sequoia-hope/studio-amp/design/decisions.md

# Decisions

Every non-obvious decision, logged as it is made. Newest at the bottom.

| Date | Decision | Why | Alternatives considered |
|---|---|---|---|
| 2026-11-07 | Variant A = integrated PoE PD chip + isolated active-clamp forward + 48 V amp rail + GW1N-9 + all GaN | User's choice; the variant to focus on. ACF is the spec's preferred topology for ~70 W efficiency; 48 V gives ≈144 W peak BTL into 8 Ω, over the >100 W target | Flyback; 36/42 V rails; iCE40 HX8K; discrete PD (later variant) |
| 2026-11-07 | One board, full satellite spec (not core-only, not split) | User: "one board for now, studio monitor version, not sub" | Core-first subset; separate power and compute boards |
| 2026-11-07 | Headphone/line DAC = FPGA 1-bit stream, reclocked on a quiet rail, discrete filter | User chose; matches the discrete-first rule and the UcD-variant signal chain | I2S DAC chip; both as variants |
| 2026-11-07 | Open source, public repo sequoia-hope/studio-amp, MIT | User chose "public repo now" | Local only |
| 2026-11-07 | JLCPCB, 5 prototypes, 2-sided assembly, ≥4 layers, cost secondary | User chose | 1-sided cost-aware build |
| 2026-11-07 | Project converted in place to a Boardroom board repo (template, vendored skill, pcbview 26ba32b and ultraroute b38a039 pinned as in boardroom 66be834) | new-board.sh refuses a non-empty dir, and the folder already held the proj registration (serve.sh, launch.sh, git history); did the same steps by hand. launch.sh stays tracked | Make a fresh repo and copy the spec over |
| 2026-11-07 | Gate driver LMG1210RVRR (C2677136) instead of uP1966 | uP1966E has 0 stock on every LCSC listing; LMG1210 is an in-stock half-bridge GaN driver; user chose it | LMG1205 (BGA, 485 stock); sourcing uP1966 elsewhere |
| 2026-11-07 | Variant A audio targets relaxed for open-loop PWM + feedforward (R-51), with an optional post-filter sense path | Phase 0 review M3: studio-monitor THD/noise not reachable open-loop; user accepted | Closed-loop feedback in variant A |
| 2026-11-07 | Full performance specified at Class 6; Class 8 used as headroom; LEDs 5 W, firmware-limited per class | Phase 0 review B1/M6: budget didn't close; Type 4 PSEs are rare | Class 8 baseline with 10 W LEDs |
| 2026-11-07 | Display header: 8-pin (ST7735S 0.96 in 80×160 IPS TFT), not the spec's 7-pin OLED | User named the module; these carry a BLK backlight pin. All signal pins on FPGA I/O and GND/VCC on solder jumpers, so a module with a different pin order still works | 7-pin SSD1331/SSD1351 OLED header |
| 2026-11-07 | Architecture: RP2350B; FPGA bitstreams held in the RP2350 flash and loaded over SSPI; PHY RMII to the FPGA MAC; one digital isolator for PD status; silicon MOSFETs in the converter, GaN only in the audio stage | See design/architecture.md, 'Architecture decisions' | RP2350A; separate FPGA config flash; RMII to the RP2350 |
| 2026-11-07 | FPGA: Lattice ECP5 LFE5U-25F-7BG256I (C1550762, 1125 stock) replaces GW1NR-LV9QN88 | Block E found the QN88P package doesn't bond out the SSPI/CPU config pins, so the Gowin could only be loaded over JTAG with a golden image in its internal flash and an extra 1V8 rail. User: wants everything flashed from the RP2350, FPGA choice otherwise open. ECP5 loads by slave SPI from the RP2350 (A/B bitstreams in its QSPI flash), has the most mature open toolchain (Trellis/nextpnr), 24k LUTs, and 9× the stock. Cost: CABGA-256 | GW1NR-9 loaded over JTAG by the RP2350 (also debugger-free); iCE40UP5K (too slow/small for fine PWM edges); GW5A (immature open support) |
| 2026-11-07 | 6.35 mm headphone jack rated only to +70 °C accepted (waiver of R-40's 85 °C) | No stocked 6.35 mm jack is rated higher; worst-case cabinet air is 55 °C. User accepted | 3.5 mm jack; out-of-LCSC part |
| 2026-11-07 | Headphone and line out share the two DAC streams (mono sum and volume apply to both) | User accepted for variant A | 2 more DAC channels |
| 2026-11-07 | Defaults taken where the user deferred ("I forget the rest"): magjack's internal Bob Smith cap accepted across the uncertified hipot; LPJK6078AHNL kept at 4 % current margin at the Class 8 corner (full performance is specified at Class 6); 4-tap FIR 1-bit DAC | Each was the auditing agent's recommendation; all are reversible before phase 2 | LP6090ANL discrete magnetics; single-flip-flop DAC |
| 2026-11-07 | Transformer: Würth 750343576 rewired 1:2 (N1‖N2 : N3+N4), 400 kHz, bought outside LCSC and hand-soldered; a custom Würth Midcom 8T:16T part on the same core to be quoted in parallel | Nothing on LCSC fits a ~70 W 48 V forward; this part is proven in TI PMP20878 with the same TPS2373-4 + UCC2897A pair. User chose option A + B (B-transformer.md) | Two transformers in parallel; hand-wound on an LCSC core; active-clamp flyback with 750321159 |
| 2026-11-07 | R-33's 92 % efficiency becomes "verify at bring-up"; 91 % accepted if measured | Würth publishes no core-loss data; the estimate is 90.5–93.3 %. User accepted | Treat 92 % as hard and go custom now |
| 2026-11-07 | GaN: Infineon IGC033S10S1 (985 stock), not Innoscience INN100 nor IGB070S10S1 | Block D: several Innoscience listings have no lifecycle or datasheet on LCSC; IGB070S10S1 has the lowest idle loss (~2 W) but only 80 in stock against 44 needed. User chose stock depth over ~3 W extra idle loss | IGB070S10S1 bought early; Innoscience |
| 2026-11-07 | 6-layer board | ECP5 CABGA-256 0.8 mm escapes without via-in-pad (no recurring via charge); solid planes by the GaN stage and the Ethernet/clocks. User approved | 4 layers + via-in-pad |
| 2026-11-07 | PWM edge grid 1.453 ns (ECP5 -7, ODDRX2) accepted; R-53 amended | The -8 grade (1.25 ns) has 5 in stock. The noise shaper makes up the difference, to be shown in the phase 8 simulation at 448 kHz (fall back to 512 kHz). User approved | LFE5U-25F-8 |
| 2026-11-07 | Tweeter protective HPF: polypropylene 2 × 22 µF (TDK B32774) | Low distortion in series with the tweeter; ~450 Hz corner into 8 Ω. User chose | Polyester 33 µF |
| 2026-11-07 | Defaults: post-filter sense populated on all 5 prototypes; output inductor (SER2915H vs XAL1510) decided at the phase 4 floorplan; audio clock = VCXO fitted, with a shared land for the 0.7 ps fixed XO (C5203547) as the fallback, chosen by measurement at bring-up | Agents' recommendations, agreed between blocks E and F | — |
| 2026-11-07 | Type 1 PSEs (down to 37 V at the PD) may not keep the converter running (UVLO off at 38.4 V) | R-30 requires Type 2 and up only | Lower LINEUV, at the cost of higher input current |
| 2026-11-07 | VBUS overvoltage: bulk absorbs regen, gateware stop at 55 V, converter OVP ≈ 53 V via aux winding into LINEOV, SMx51A TVS for spikes | Keeps every VBUS part in rating; agreed between blocks B and D. Residual double-fault risk (feedback failure at 38.4–41.9 V input, light load) accepted | 80/100 V bulk caps; SMBJ54A/58A clamps |
| 2026-11-07 | Gateware auto-idle of the bridges with no signal | IGC033S10S1 idles at ≈ 5.2 W of VBUS power at 448 kHz, heat in a sealed box and ~15 % of the Class 6 budget | Always switching |
| 2026-11-08 | Shield bleed: ≈ 10 MΩ string (built as 5 × 2.0 MΩ 1206, C2907380, after derating; the review proposed 4 × 2.49 MΩ) instead of 1 MΩ, so the magjack's internal 1000 pF / 2 kV Bob Smith cap shares the 1500 Vrms hipot with C_SH | Phase 1 review A-M3 found the earlier default put the full 2121 Vpk across the internal cap; this closes it at the cost of four resistors. Replaces the 2026-11-07 default of accepting the risk | Discrete LP6090ANL magnetics; accept the risk |
| 2026-11-08 | Amp fsw 576 kHz (12 × 48 kHz) on the ECP5 ×12 grid (1.695 ns) | Phase 1 review E MAJOR-1: ×14 ran at 98 % of a commercial-grade limit on an industrial part. 448 kHz doesn't fit the ×12 grid; 384/512 kHz beat with the 400 kHz converter at or near audio (block D comparison, D-interfaces.md) | ×14 grid at 448 kHz; 384, 512, 768 kHz |
| 2026-11-08 | GaN back to Infineon IGB070S10S1 (C44179579), with the IGC033S10S1 kept as a fallback footprint | At 576 kHz the IGC033 idles at ≈ 8.3 W from VBUS; the IGB070's lower Qoss roughly halves the FET loss. LCSC stock is thin (80 for 44), so buy or pre-order now. User chose (reverses the 2026-11-07 choice) | IGC033 + 6.8 µH XAL1510; IGC033 as is |
| 2026-11-08 | Qwiic power capped at 100 mA in firmware | Saves ≈ 0.9 W of worst-case budget; LED power comes from the separate LED output. User chose | 300 mA |
| 2026-11-08 | Converter crystal-locked at 737.28 kHz (7.3728 MHz ÷ 10 into UCC2897A SYNC); amp at 576 kHz; amp mutes on a converter clock fault (ACF_PULSE outside ±0.5 %) | UCC2897A's own oscillator drifts −10/+8 %, so no amp frequency cleared the beats; locking keeps every low-order product ≥ 161 kHz and lifts the transformer volt-second margin to ~60 % hot | Amp at 768 kHz (+1.7 W idle); ×14 grid; free-running converter |
| 2026-11-08 | Beat rule for the 5 V buck relaxed to ≥ 40 kHz for a, b ≤ 2 against 576 / 737.28 kHz only; no synchronised buck | Only products that reach the amp output through VBUS ripple matter; the fallback band is excluded because the amp is muted then, and the buck's ripple through 6 mF is tiny | Sync-capable LM5146 controller with external FETs |
| 2026-11-08 | R-54 reworded into two overcurrent cases (hard short ≤ 100 ns; gradual 15 A ± 1 A, ≤ 250 ns; ≤ 17 A peak) | Phase 1 review D-M2: the INA241 blanks for ~1 µs on fast common-mode steps, so a single 200 ns figure didn't hold; a differentiator short detector now covers hard shorts | One 200 ns figure |
| 2026-11-08 | PCM1808 input: ≤ 70 mV over abs max accepted when a line source is plugged into the mic jack (pin current ≪ 1 mA) | Block F disputed review F-m3: no Schottky clamp holds the pin within 0.3 V at mA currents; only a misuse case | Larger series R (worse noise), an active clamp |
| 2026-11-08 | LED output connector order 1 = +5V, 2 = GND, 3 = Data, 4 = Clock (JST PH 4-pin), as proposed | User: "I will just accept whatever you have"; no existing panel convention to match (dancing_forest used a 3-pin KK with no clock) | Match a specific LED panel; JST SM order of common APA102 pigtails |
| 2026-11-08 | PoE-loss detection: VBUS-droop comparator (VBUS < 40 V → POE_LOSS_N) plus a gateware rule on the VBUS ADC, ORed with PD_PG_N; the primary-pulse-height detector is retired | It failed review twice (DCM false trips, then a leading-edge race). Droop is enough for R-34: 6 mF at 60 W falls 48 → 40 V in ≈ 38 ms and the logic rails hold to ≈ 33 V; 40 V clears the ≤ 10 % burst sag (43.2 V) | Pulse-height detector gated on SR drive |
| 2026-11-08 | Schematic: 13 hierarchical sheets generated by per-block scripts (hw/satellite/a/gen/, on kicad_write via gen/hier.py); inter-sheet signals as global labels; per-block symbol/footprint libraries; require LCSC and MPN fields | kicad_write writes flat sheets only; hier.py adds instance paths and per-sheet PWR ranges (tested: ERC clean, cross-sheet nets join). Global labels avoid a root sheet wired with ~150 hierarchical pins; the root shows the blocks in block-diagram order | Hierarchical pins wired on the root; one flat sheet |
| 2026-11-08 | Gate-drive turn-off diode (D_off) dropped from the LMG1210 outputs | It adds area to the ≤ 1 nH gate loop; turn-off is tuned by changing R_G on the bench (block D, phase 2) | Unfitted D_off footprint across each R_G |
| 2026-11-08 | Gate 1 re-recorded after phase 2 audit corrections instead of a fresh phase 1 review | The corrections were made while drawing and were judged by the independent phase 2 parts cross-checks, which read the audits and the netlist together | Re-run the phase 1 datasheet review |
