sequoia-hope/studio-amp/design/pcbview-requests.md

# pcbview change requests

Things the viewer can't do yet. Fixes land in https://github.com/sequoia-hope/pcbview,
not in `vendor/pcbview`.

<!-- ## <short title>
What's needed, why, proposed interface. -->
