sequoia-hope/studio-amp/design/gates/phase2.md

# Gate 2 — schematic

Board: satellite, variant A (`hw/satellite/a/`). Status: **PASSED 2026-11-08** (independent reviews;
no user sign-off required for this gate).

The schematic is 13 hierarchical sheets plus a root page, generated by per-block scripts in
`hw/satellite/a/gen/` (on the skill's `kicad_write`, with `gen/hier.py` adding the hierarchy). The
conventions are in `design/schematic-conventions.md`. 1261 symbols (1181 parts to build), 857 nets.
PDF: `design/renders/schematic.pdf`; the viewer's SCH tab is rebuilt (`viewer/satellite-a/`).

| Sheet | Parts | Owner |
|---|---|---|
| poe_in | 44 | A |
| iso_dcdc / iso_aux | 120 / 52 | B |
| rails | 161 | C |
| amp_woofer / amp_tweeter / amp_sense | 148 / 150 / 58 | D |
| mcu / fpga / ethernet | 38 / 70 / 43 | E |
| audio_out / audio_in | 181 / 42 | F |
| io | 154 | G |

## Checklist

| Item | Evidence | Result |
|---|---|---|
| ERC: 0 errors, every warning explained | `kicad-cli sch erc --severity-all`: `** ERC messages: 0  Errors 0  Warnings 0` | ✓ |
| Style check passes (output pasted) | below | ✓ |
| Every part cross-checked against its audit | `review-phase2-parts-AD.md`, `review-phase2-parts-EFG.md` (netlist traced pin by pin), with "Fix verification": A–G PASS | ✓ |
| Every symbol has value, footprint, MPN, supplier PN | `sync_check.py`: 1181 parts to build, required fields LCSC and MPN, PASS; solder jumpers and test pads excluded from the BOM | ✓ |
| Visual review passed | `review-phase2-visual.md`: first pass 7/10 with 6 MAJOR; re-check 8.5/10, PASS | ✓ |
| PCB view regenerated with the schematic render | `scripts/view.sh build pcbview.toml --only sch`: 14 sheets and the PDF, embedded in `index.html` | ✓ |

```
$ python3 .claude/skills/pcb-design/scripts/schematic_style_check.py hw/satellite/a
  WARNINGS (1)
    [decoupler] C331 is drawn 41 mm from U307.1, a stacked pin: the drawing can't put it beside that pin, so placement relies on the Decouples field
  PASS: 0 errors, 1 warnings

$ python3 .claude/skills/pcb-design/scripts/sync_check.py hw/satellite/a
  schematic satellite.kicad_sch: 1261 symbols (0 excluded from board)
  board satellite.kicad_pcb: 1261 footprints (0 board-only)
  1181 parts to build; required fields: LCSC, MPN
  PASS: 0 errors, 0 warnings
```

Explained warning: C331 decouples a stacked power pin, so the schematic can't draw it beside one pin; its
`Decouples` field carries the intent to placement (phase 6 `placement_check.py`).

The board file `satellite.kicad_pcb` was created by `update_pcb` (all 1261 footprints resolve; they sit
stacked at the origin, unplaced, until phase 6).

## Reviews

Fresh-context reviewers on the stronger model:

| Review | First pass | Resolution |
|---|---|---|
| Visual (`review-phase2-visual.md`) | 0 BLOCKER, 6 MAJOR: root page was a table of contents; text collisions on rails, iso_dcdc and audio_out; DNP crosses hiding values; unnamed connector pins | all fixed by the owners and the lead (root redrawn as a block diagram with flow lines); re-check 8.5/10 PASS; 3 MINORs accepted (CC1/CC2 labels where a wire would cross D±; A2 head-room on mcu/fpga; rotated passive values) |
| Parts A–D (`review-phase2-parts-AD.md`) | 0 BLOCKER, 2 MAJOR: **T201 footprint mirrored** (would have bridged the isolation barrier in one orientation; the row spacing was also wrong); short-detector ladder gave ±0.81 V, not ±1.0 V | footprint rebuilt from the top view, checked pad by pad, pin-1 mark added, 18.1 mm barrier gap; ladder 4.99k/15k/4.99k (trip 14.8 A); minors fixed; verified CLOSED |
| Parts E–G (`review-phase2-parts-EFG.md`) | **1 BLOCKER: two BAV99s shorted −15 V to GND** (pin 3 tied to GND); 1 MAJOR: jack ferrites bypassed | BAV99 pin 3 no-connect, every dual diode's centre pin checked; beads in series; minors fixed; verified CLOSED |

Integration findings fixed before review: 28 decoupler style errors (amp sheets), 181 off-grid points
(FPGA sheet unit origin), a dangling label, the missing GND PWR_FLAG, two audited parts not drawn
(Fly-Buck snubber DNP, USB shell RC), and stale board-only fields (sync check).

**Lesson from this phase:** both the BAV99 short and the mirrored footprint passed ERC and the style
check. The BAV99 short came from a wire end landing on a pin by coordinate coincidence, which a
generated schematic is prone to. Netlist tracing against the datasheets is what caught both; keep it
as a standing part of every schematic review here.

## Decisions logged in this phase

`decisions.md`: hierarchical sheets with global labels and per-block generators; gate-drive turn-off
diode dropped (block D). Audit corrections made while drawing are recorded in each block's
`*-interfaces.md` "Phase 2" section.

## Carried forward

- Confirm against the physical samples before layout: the T201 footprint (pads 11/7 offset measured
  from the drawing, 6.36 mm) and the SM5845 inductor footprint; the magjack body outline.
- Display module pin order (user, when the module arrives): sets which solder jumpers are bridged.
- Phase 4/6 layout obligations (from gate 1) stand; add the IGC033 courtyard at each GaN site.
