sequoia-hope/studio-amp/design/gates/rereview-phase1-AB.md

# Phase 1 second-pass review — blocks A (PoE input) and B (isolated ACF converter)

Date: 2026-11-08. Reviewer: independent second pass (artifacts only; authors' conversation not seen).
Inputs: `review-phase1-A.md`, `review-phase1-B.md`, the "Review response" sections of `A-interfaces.md`
and `B-interfaces.md`, every `A-*.md` / `B-*.md`, `intent.md`, `architecture.md`, `decisions.md`,
`E-interfaces.md` / `E-pinmap.md` / `C-interfaces.md` / `F-interfaces.md` for the interface check.
Datasheets re-read (pdftotext, rendered where scanned): UCC2897A SLUS829E, TPS2373 SLUSCD1C, LT4321,
BSS123 (Nexperia), BZT52 (MDD), 74HC4017 (Nexperia rev 8), SN74LVC1GU04, YXC HC-49SMD, HT7550 (UMW),
NCP4306 rev 6, LM5019 SNVS788G, TLV3202, SN74LVC1G123, Würth 750343576, SMBJ130A (Vishay), US1G,
FOJAN FRC, FH 1206B102K202. Every number below was recomputed from the datasheet, not from the audit.

## 1. First-pass BLOCKER / MAJOR items

| Item | Status | Reason (re-derived) |
|---|---|---|
| A-M1 `PD_PG_N` polarity | **CLOSED** | `A-interfaces.md`, `E-pinmap.md` A2, `E-interfaces.md` (rule "PD_PG_N rising or POE_LOSS_N falling"), `C-interfaces.md:157/275`, `F-interfaces.md:245–250` all agree: active low, low = good, high when primary unpowered (ISO7740 default high). Residual: block B's own files still say `PD_PG`, `PD_TPL/TPH/BT` (m-AB1 below). |
| A-M2 LT4321 enabled without the 10 µF | **CLOSED** | BSS123 gate from RTN through 2.2 MΩ, BZT52C10 + 1 nF clamp, drain on EN. Hot-swap closed: RTN–VSS ≤ 1.9 A × 0.2 Ω (TPS2373-4 rDS(on) max, p.7) = 0.38 V, + IGSS 100 nA × 2.2 MΩ = 0.60 V < VGS(TO) min 1.0 V (BSS123 p.1, 25 °C) ⇒ off; open (RTN ≈ VDD): on, EN ≈ 0.31 mA × 6 Ω ≪ VIL 0.5 V (LT4321 p.3) ⇒ shutdown, body-diode bridges carry inrush as in ADI Figs 3–4. Detection: 24.9 kΩ ∥ 2.2 MΩ = 24.38–24.87 kΩ, inside 23.75–26.25 kΩ. Zener-network turn-on ≤ 32.8 V < hot-swap close 36.3 V. Enabled only with CBULK across OUTP–OUTN ✓ (p.7). Margin note n-AB2. |
| A-M3 hipot through the internal 1000 pF | **CLOSED** | Recomputed at 60 Hz, 1500 Vrms: Z_i = −j2.65 MΩ, Z_SH (10 MΩ ∥ 1 nF) = 0.66 − j2.48 MΩ ⇒ 1088 Vpk across the internal cap, 1051 Vpk across C_SH, 149 Vrms per 2.0 MΩ resistor; at C_SH −30 %: 923 / 1233 Vpk, 174 Vrms per resistor (< 200 V working, FRC table). ESD 8 kV/150 pF: 1.33 kV at 0.75 nF, 267 V per resistor (< 400 V overload). τ = 10 ms. Correct and complete. `decisions.md` 2026-11-08 still says "4 × 2.49 MΩ" — update to 5 × 2.0 MΩ (m-AB5). |
| B-M1 VB_PRI vs UVLO-on | **CLOSED** | 1.225 × (1 + 107/10) = 14.33 V; worst 1.200 × (1 + 107·0.995/10.05) = 13.91 V … 1.250 × (1 + 107·1.005/9.95) = 14.76 V. > UCC2897A UVLO-on max 13.2 V by 0.71 V; < TPS2373 VC_IN 15 V recommended max (p.6); < VDD 16 V. 78L05 at 14.8 V redone. `B-controller.md` still quotes "13.8–14.9 V (1 % resistors)" — stale text only. |
| B-M2 plant gain | **CLOSED** | 0.2/(0.068 × 2) = 1.47 A/V; Zout(1 kHz) 26.8 mΩ; loop 1.47 × 0.0268 × (1 × 4.99/0.499) × (115/47.5) × 1.04 = 0.99 ⇒ fc 1.0 kHz; phase −90 + 8.6 − 16.4 − 12 − 3.8 = −113.6° ⇒ PM 66°. Agrees. Note: UCC2897A FB range 2.5–4.5 V maps to 0–0.5 V on CS (p.7 VLVL 0.5 V, VCS 0.48 V), i.e. the divider is ≈ 0.25, not 0.2; fc then ≈ 1.25 kHz, PM ≈ 64°. Phase 8 confirms. |
| B-M3 volt-seconds hot | **CLOSED (conditional, as stated)** | Synced: 57 V × 0.696/737.28 kHz = 53.8 Vµs = 45 % of 120 Vµs (4 T, 20 °C). Clock-failed: 57 × 0.75/590 kHz = 72.5 Vµs = 60 %. Hot rating still an assumption (≈ 90 Vµs) until Würth answers; the audit says so plainly and lists the questions. With DMAX in sync = RON/ROFF ratio (datasheet §8.3.6, see n-AB1) the synced figure is 55 Vµs — immaterial. |
| B-M4 SR / CS-pin stress | **CLOSED** | Forward SR plateau 2 × 38.4 × 0.640/0.360 = 136.5 V; 2 × 37.6 × 0.655/0.345 = 142.8 V. RCD-Z clamp on both SRs: SMBJ130A VBR 144–159 V at 1 mA (Vishay p.1), dynamic ≈ 17 Ω, average clamp current ≤ 0.6 W/150 V = 4 mA ⇒ node K ≤ ≈ 160 V + US1G forward recovery ⇒ ≤ 165 V, 83 % of the NCP4306 CS 200 V abs max (p.5) and BSC500N20NS3 200 V, from first power-up. RC 22 pF × 143² × 737 kHz = 0.33 W, 0.17 W per 2010. Correct. |
| B-M5 start-up current | **CLOSED** | VSR LM5019 UVLO 1.225 × 61.1/10 = 7.48 V (LM5019 operating min 7.5 V, VCC UVLO 4.15–4.9 V p.6 ⇒ runs); TL431 + LED + 499 Ω fit in 7 V; INA281 swing ≥ 6.85 V > 2.64 V set-point. Below 7.5 V: ISS = 0.43 × 2.5/31.6 k = 34 µA, 1 µF, 2 V ⇒ 59 ms; Q to 7.5 V on 6 mF = 45 mC ⇒ t = 47 ms, Iout 1.9 A, 14 W, ≈ 0.45 A in at 42 V. Converter starts ≥ 81.5 ms after power-up, outside the 80 ms / 400 mA PD start-up window (TPS2373 §7.4.6) and the PSE 75 ms inrush window; a 10–15 ms excursion is shorter than any TCUT. Stacked corner not done by the author: ISS +28 % (tSS 46 ms) and CS max (3.0 A) together give 0.57 A at 42 V — still under 0.6 A, record it (m-AB6). |
| B-M6 B↔E nets | **CLOSED** | `ILIM_SEL0/1` GPIO34/35, `IBUS_SENSE` ADC4/GPIO44, `POE_LOSS_N` A6 (4.7 kΩ pull-up), `ACF_PULSE` B6 mapped in `E-pinmap.md`; encodings 00/01/10/11 = 0.44/0.94/0.80/1.30 A agree in B and E; set-points recomputed (2.638 / 5.648 / 4.791 / 7.80 V at the INA281 for 88.7 k ∥ {—, 4.22 k, 5.90 k, both}) ✓. Residual inconsistencies in m-AB2/m-AB3. |

## 2. New findings (parts and circuits added or changed since the first pass)

### BLOCKER

**AB-B1. `POE_LOSS_N` detector asserts continuously in DCM and in pulse-skip mode — i.e. at the amplifier's normal idle.**
- File: `B-poe-loss-detect.md` (circuit items 3–5, "Behaviour by case" rows 2 and 4). Datasheet: NCP4306 p.7–8 (turn-off at zero current; DRV low with no conduction), SN74LVC1G123 p.1/4 (B rising-edge trigger).
- Problem: "pulse present" P is defined as SW_SEC > 16 V. SW_SEC is the inductor input. Whenever both SRs are off and the inductor current is zero — every DCM dead time (Io < ΔIL/2 = 0.17–0.28 A, i.e. below 8–13 W, which is the amp-idle load with the gateware auto-idle of `decisions.md`), and the whole of every pulse-skip interval (ms after regen or a load dump, §8.3.5) — the node sits at VBUS ≈ 48 V through the inductor. SWDIV = 48/32.15 = 1.49 V: P = 1 (> 0.497 V) and L = 1 (< 2.495 V), so LA = 1 for hundreds of ns to milliseconds, far longer than the 165–307 ns qualifier. The monostable fires every cycle and `POE_LOSS_N` stays low; the FPGA latches it and mutes (R-34). The "no pulses ⇒ nothing to qualify" argument is wrong because P is a level, not a pulse. Same mechanism gives a false `ACF_PULSE` (AB-M3).
- Fix: gate "pulse present" on actual transformer conduction, not on SW_SEC level: P′ = forward-SR NCP4306 DRV high (10 V gate through 10 k/4.99 k into the AND, or a third comparator on the forward-SR drain < 5 V; TLV3204 instead of TLV3202). DRV_fwd is low in every dead time and in skip mode, so LA = P′·L is zero there and the plateau test is only made while the secondary is being driven. Redo the qualifier timing (DRV rises 30–60 ns after the pulse starts, so L is already settled) and the behaviour table; add "light-load DCM, 57 V in" and "skip after a regen step" to the bench cases. Also consider centring the threshold at 40.0 V (Rbot 6.49 k; band 39.4–40.6 V): the present worst unit trips at 41.0 V while a compliant Class 8 PI minimum of 41.1 V less bridge and jack drops is ≈ 41.0 V at VPRI (m-AB7).

### MAJOR

**AB-M1. SYNC pin driven above its absolute maximum, and driven while VREF is off.**
- File: `B-sync-clock.md` (chain item 1, 4), `B-controller.md` SYNC row. Datasheet: UCC2897A p.5 abs max "FB, CS, SYNC, LINEOV, LINEUV: −0.3 V to VREF + 0.3 V"; p.6 VREF 4.75–5.25 V over temperature; §8.3.1.4 "The 5-V bias is available only when the UVLO circuit enables the operation" and §8.3.1.16 "When VDD reaches 12.7 V … 5 V appears on the VREF terminal". HT7550-1 output 4.85–5.15 V (UMW table, ±3 %); 74HC4017 VOH ≈ VCC at light load.
- Problem: (a) steady state: a 5.15 V clock into a part whose VREF may be 4.75 V exceeds VREF + 0.3 V = 5.05 V. (b) start-up and every UVLO event: the clock chain runs from VB_PRI ≈ 2–3 V upward, but VREF is 0 V until VDD passes 12.2–13.2 V (and after it falls below 7.6–8.4 V). During the VB_PRI ramp (and the LINEUV/UVLO soft-stop cases) Q0 drives up to 5 V into a pin whose abs max is then 0.3 V, through only 100 Ω: ≈ 40 mA pulses into the input clamp on every power-up.
- Fix (preferred): power the LVC1GU04, crystal and 74HC4017 from the UCC2897A **VREF** (5 V, "approximately 5 mA", p.4/§8.3.1.4) and delete the HT7550. The logic high can then never exceed VREF, and the clock exists only when the controller is alive. Budget: 74HC4017 ≈ CPD·V·f ≈ 1.1 mA, LVC1GU04 Pierce at 5 V ≈ 1–2 mA, FB pull-up 0.5 mA ⇒ ≈ 3–3.5 mA of 5 mA; measure at bring-up (a 3.3 V-rail option does not exist on the primary). Fallback: keep the LDO, add a 1 kΩ series resistor and a BAT54 from SYNC to VREF, and accept the clamp at the abs-max line. Either way CVREF should move to 0.22 µF (recommended, §8.3.1.4) with the extra load.

**AB-M2. The "clock-failure fallback" is not guaranteed: a stopped clock can hold SYNC high and switch the converter off.**
- File: `B-sync-clock.md` ("Clock-failure fallback"), `B-interfaces.md` ("If the clock fails the controller free-runs"), `B-converter-design.md` item 1. Datasheet: UCC2897A §8.3.6 "both outputs of the UCC2897A controller are off if the synchronization signal stays continuously high"; 74HC4017 Table 3 (MR high ⇒ Q0 = HIGH; counter freezes with no clock).
- Problem: if the crystal or inverter stops, the 74HC4017 freezes in its last state. In one state of ten Q0 is HIGH, SYNC stays high, and the converter is dead (no free-running fallback); the unbuffered inverter's mid-rail output with a dead crystal can also leave CP0 at an undefined level. The audit's 72 Vµs fallback analysis is right for the other nine states; the claim "the converter keeps working" is not. Also: MR (pin 15) and CP1 (pin 13) are not assigned anywhere in the audit; both must be tied (CP1 low; MR low or as below).
- Fix: take the SYNC pulse from **Q1** (same 136 ns width, one count later) and drive **MR** from a clock-loss detector on the 7.3728 MHz node (BAT54S charge pump, 1 nF, 100 kΩ to GND: MR held low while the clock runs, rises within ≈ 0.1 ms when it stops). Reset forces Q1–Q9 LOW (Table 3), SYNC low, and the controller free-runs at 590–708 kHz as intended. Alternatively, state honestly that a stopped clock may stop the converter and drop the fallback claim from the three files.

**AB-M3. `ACF_PULSE` does not mean "one pulse per converter cycle", so block E's clock-fault rule (±0.5 % over a 10 ms count) mutes the amplifier in normal operation.**
- Files: `B-poe-loss-detect.md` item 3 (`ACF_PULSE` = P), `B-interfaces.md` (`ACF_PULSE` row and addendum), `E-interfaces.md:138`, `D-interfaces.md:171`.
- Problem: with P = SW_SEC > 16 V, DCM gives two rising edges per cycle (the forward pulse, and the node springing to VBUS after the freewheel SR opens) and skip mode gives none for milliseconds. A 10 ms count therefore reads up to 2× or several % low at idle or after a loud passage — outside ±0.5 % — and E's hard rule declares a converter clock fault and mutes.
- Fix: derive `ACF_PULSE` from the gated P′ of AB-B1 (exactly one edge per real pulse), and change the gateware test from a count to a **period test**: in synchronised operation every pulse-to-pulse interval is an integer multiple of 1.3563 µs (±0.5 %), including skipped cycles; a free-running controller (656 kHz ± 10 %) fails that test within a few pulses. Record the new rule in `B-interfaces.md`, `E-interfaces.md` and `D-interfaces.md`.

### MINOR

- **m-AB1.** Block B's files still use the pre-A-M1 names: `B-interfaces.md` rows "Type/class signals `PD_TPL`, `PD_TPH`, `PD_BT`", "OR it with `PD_PG`", proposed change 5 "ORs `POE_LOSS_N` with `PD_PG`"; `B-poe-loss-detect.md` lines 74, 102, 131 "`PD_PG`". Rename to `PD_PG_N` etc. and state the sense (rising = loss).
- **m-AB2.** `IBUS_SENSE` pin capacitor: B says 10 nF (`B-interfaces.md`, `B-feedback.md`), E says 100 nF (`E-pinmap.md:246`, `E-interfaces.md:44`). Either works (τ 0.67 / 6.7 ms with 67 kΩ); pick one.
- **m-AB3.** `ACF_PULSE` series resistor: B and `E-interfaces.md:189` say 1 kΩ; `E-interfaces.md:45` and `E-pinmap.md:29/309` say 4.7 kΩ and still label it "620 kHz ± 10 %". `E-pinmap.md:312` still says 10 kΩ pull-up on `POE_LOSS_N` against 4.7 kΩ at line 25. Update E's tables.
- **m-AB4.** `architecture.md` reconciliation (the section that "wins") still says block B is 400 kHz, `VB_PRI` 13.5 V and ILIM 0.47/0.94/1.34 A; the Mermaid block also says 400 kHz. Update to 737.28 kHz crystal-synced, 14.3 V, 0.44/0.94/1.30 A (and `POE_LOSS_N`, `ACF_PULSE`, `VSR` in the rails table).
- **m-AB5.** `decisions.md` 2026-11-08 shield entry says 4 × 2.49 MΩ; the audit built 5 × 2.0 MΩ (so each resistor stays ≤ 174 Vrms with C_SH derated). Correct the log.
- **m-AB6.** `B-converter-design.md` start-up item 6: add the stacked corner ISS +28 % with CS max ⇒ 0.57 A at 42 V (23 W in), and note that the PSE criterion is "above ICUT for TCUT (50–75 ms)", which a 10–15 ms excursion cannot meet — the bring-up pass line "≤ 0.6 A at every point" is stricter than the standard.
- **m-AB7.** `POE_LOSS_N` threshold band 39.7–41.0 V has ≈ 0 V margin to a compliant Type 4 PSE at the 41.1 V PI minimum once the bridge (25–57 mV per FET × 2) and CT drops are taken off. Intent R-30/B table says 42 V operating, so acceptable; recommend 40.0 V centre (see AB-B1) and quote the real VPRI, not the PI figure.
- **m-AB8.** `B-sync-clock.md`: confirm the crystal's CL code (the LCSC MPN `X49SM73728MSD2SC` was not decoded; YXC sheet offers 12 or 20 pF — the 2 × 33 pF + 5 pF stray = 21.5 pF design needs the 20 pF part) together with the already-open temperature suffix. Drive level at 5 V with Rs 1 kΩ ≈ 70–140 µW against 500 µW max (YXC p.1) ✓.
- **m-AB9.** CC-loop RC quoted two ways: `B-feedback.md` 100 Ω + 470 nF, `B-converter-design.md:206` 1 k / 47 nF (same 3.4 kHz). Make them agree (the 100 Ω version is the one in the set-point arithmetic).
- **m-AB10.** `B-interfaces.md` and `B-controller.md` still cite "block A margin 30 mA" for the idle draw during inrush; block A withdrew that figure (A-n2). Quote only the datasheet bound (< 0.65 × 275 mA).
- **m-AB11.** MLCC DC-bias figures (clamp 70 %, input 45 %, output 50 %, COUT 50 %) remain assumptions (first-pass n14); the gate checklist line "MLCC derating checked" is still open for block B.

### NOTE

- **n-AB1.** DMAX in sync: the datasheet (§8.3.1.5, §8.3.6) says the sync edge ends the charge and the discharge follows at the same slope to the same valley, so "DMAX is the same in free-running and synchronized modes" (the RON/ROFF ratio, 0.715 nominal), not 1 − tOFF/TSYNC = 0.68. The fixed 50 ns / 170 ns terms of eq. 11–12 do not scale, so the truth is between 0.68 and 0.715. Consequences are small (54 → 55 Vµs; SR off-time 0.387 µs vs MIN_TOFF 256 ns still fine; sync pulse 136 ns < 0.387 µs); keep the bench check and quote both figures.
- **n-AB2.** A-M2 margin: BSS123 gate 0.60 V (0.38 V + 0.22 V IGSS worst) against VGS(TO) ≈ 0.7–0.8 V at 65–85 °C junction (−3…−5 mV/K from 1.0 V min). The 100 nA IGSS is a 20 V spec; at 0.6 V it is far lower, so the real margin is ≈ 0.4 V. Fine; record the temperature dependence, since a partially-on BSS123 would drop the bridge to body diodes (+2 W) at full load.
- **n-AB3.** Free-running margin to the sync frequency is 4 % (708 kHz worst vs 737 kHz) using the ±10/+8 % spread specified at RON = ROFF = 75 kΩ; at 31.6 k / 14.3 k the fixed delay terms change the proportions. Bench-verify the free-running frequency on the first board before relying on sync.
- **n-AB4.** 74HC4017 at VCC 4.5–5.25 V: fmax ≥ 24 MHz at 85 °C (p.9) ✓ for 7.3728 MHz; Q0/Q1 decode is glitch-free (Johnson counter). Nexperia gives no HC4017 figure at 3.3 V, which is why AB-M1 recommends VREF rather than a 3.3 V LDO.
- **n-AB5.** TLV3202 inputs are diode-clamped to the rails; "signals that can swing more than 0.5 V beyond the rails must be current-limited to 10 mA" (p.4 note 2). SWDIV at the 190 V ring peak through 10 kΩ: ≤ 0.3 mA ✓; before +3V3 is up it injects ≤ 0.4 mA into the unpowered rail — harmless, but say so.
- **n-AB6.** LM5019 VSR in dropout between 7.5 and 10.6 V: TON = 1e-10 × 280 k/7.5 = 3.7 µs against the 144 ns minimum off-time ⇒ VSR ≈ 0.96 × VBUS; the BST cap is refreshed only in those 144 ns (gate-drive UVLO 2.4–3.6 V, p.6). Expected to work; add "VSR tracks VBUS from 7.5 V" to the bring-up scope list.
- **n-AB7.** Recomputed and agreed, no change: LINEUV VON 1.268 × 75.57/2.37 = 40.4 V, IHYST 0.125/4.53 k = 27.6 µA, VOFF 38.4 V (37.6–39.2 V); NCP4306 MIN_TON 55 + 0.75 × 94.5 = 126 ns, MIN_TOFF 70 + 2.0 × 93 = 256 ns, both inside the 0.387–0.41 µs windows; CC set-points; INA281 swing 7.8 V ≤ 9.55 V; divider 47.5 k / 2.61 k ⇒ 47.90 V; 78L05 / isolator budget; TVS SMCJ58A-13-F 93.6 V at 16 A, ≈ 80 V at 6.5 A; C_PD window; efficiency 92–93 % from the restated model (core loss still assumed); all MINOR items of both first-pass reviews (A-m1…m5, B-m1…m8) are fixed as described.

## 3. Verdicts

- **Block A: PASS.** All three MAJORs closed and re-derived; only text/log fixes remain (m-AB1 is block B's, m-AB5 is `decisions.md`).
- **Block B: NOT PASSED.** The six first-pass MAJORs are closed (M3 conditional on Würth, as recorded), but the two circuits added since — the sync clock and the PoE-loss detector — carry one BLOCKER (AB-B1) and three MAJORs (AB-M1, AB-M2, AB-M3) that must be fixed and re-reviewed before phase 2; the interface rule for `ACF_PULSE` has to be re-agreed with blocks D and E.
