sequoia-hope/studio-amp/design/gates/rereview3-phase1.md

# Phase 1 fourth-pass review — close-out of the third-pass items

Date: 2026-11-08. Independent fourth-pass reviewer (artifacts only; no author conversation seen).
Scope: `rereview2-phase1.md` BLOCKER-1 / MAJOR-1 (now `B-vbus-droop.md` and the shared B/D/E PoE-loss
rule), MAJOR-2 / m-4 / m-7 (`B-sync-clock.md`), AB-M3 + item 9 (clock-fault rule), and block C's 68 µH /
UVLO changes. Every number was recomputed from `design/datasheets/` (pdftotext): LM393 (onsemi), TL431
SLVS543N, AO3400A, LM5019, LM5013 SNVSCB3, LM5017 SNVS783H, HT7550 (UMW), SN74LVC1G08, SN74LVC1G123
SCES586D, 74HC4017 (Nexperia), 74LVC2G08 (Nexperia), UCC2897A, PSSCAQ7048M. The three interface files
were diffed mechanically.

## 1. Item status

| Item | Status | Reason |
|---|---|---|
| **1. `B-vbus-droop.md`** thresholds, hysteresis, filter, supply, start-up, burst sag | **CLOSED as a design**, with **MAJOR-1** on the output stage | Thresholds re-derive: Thevenin 9.38 kΩ, ratio 16.00; + input 2.470 V (output low) / 2.568 V (output high ≈ 9.9 V) → assert 39.5 V, release 41.1 V ✓. Tolerance is wider than the stated ±1.5 %: TL431**BI** in SOT-23-3 has VI(dev) **34 mV max** over −40…85 °C (SLVS543N, TL431BI EC table), i.e. up to 1.4 %, plus 0.5 % initial, 0.2 % divider, LM393 VIO 9 mV (0.36 %) and IIB 400 nA × 9.38 k = 4 mV (0.15 %) → **≈ ±2.6 %: assert 38.5–40.5 V, release 40.0–42.2 V**. Still ≥ 2.7 V under the 43.2 V sag and ≤ 44.0 V `VBUS_VALID` ✓; a Type 2 burst from 4.8 mF at the 0.44 A limit bottoms at ≈ 42.3 V ✓. Filter τ 0.31 ms ✓, LM393 1.3 µs ✓. VSR tracks VBUS below 10.6 V and the LM393 runs to VCC = 2 V (VICR 0…VCC − 2 V over temperature), so the output stays asserted all the way down ✓. Start-up: `POE_LOSS_N` is *high* until VSR exists (VBUS ≈ 7.5 V), then low until 41.1 V; harmless because the FPGA ignores it until `VBUS_VALID`, but the text "keeps the relays off until 41.1 V" holds only above ≈ 7.5 V. Hold-up from assertion at 38.5 V, 4.8 mF, to 29.6 V: 1.45 J → ≈ 160 ms at 8 W ✓. **But** the AO3400A gate-low level is not guaranteed below its threshold (MAJOR-1 below). |
| **2. PoE-loss coverage (R-32a, R-34)**, identical B/D/E rule, hold-up | **CLOSED** (MINORs on stale text) | Items 1–6 of the rule are **byte-identical** in `B-`, `D-` and `E-interfaces.md` (diff of the numbered items is empty). Cable pull / PSE off: PD bulk gone in ≈ 0.5 ms at 60 W, VBUS falls from 48 V to the ADC's 40.5 V in 4.8 mF × (48² − 40.5²)/120 W = 26 ms (−20 % C) or to the comparator's 38.5 V in 33 ms; mute ramp ≤ 5 ms at ≤ 60 W costs ≤ 0.15 J; then ½·4.8 mF·(38.5² − 29.6²) − 0.15 J = 1.3 J ≥ 8 W × 20 ms ✓ (≈ 160 ms). Loss during a 144 W burst at 43.2 V: 5.9 ms to 38.9 V, ramp 0.36 J, 20 ms at 8 W → VBUS ≈ 36 V ≫ 29.6 V ✓. Slow brown-out: at any VPRI above LINEUV-off the converter regulates 48 V (D = 48/(2 × 40.5) = 0.59 < 0.655), so either VBUS stays up or it falls through 40.5/39.5 V and is caught; the third-pass hole (soft-stop with the amp unmuted) is closed because the detector no longer depends on pulses ✓. Loss in skip/DCM: VBUS-only, covered ✓. Idle: ≈ 240 ms to assertion with the output already near zero, rails intact ✓. Rails: LM5013 off ≤ 1.47 × 20.12 = 29.6 V (SNVSCB3 VEN-FALLING 1.35–1.47 V, eq. 6), LM5017 Fly-Buck off ≤ 1.26 × 24.32 − 10 µA × 125 k = 29.4 V (SNVS783H UV 1.19–1.26 V, IHYS −10…−29 µA) — both before 1 % resistor tolerance (≈ +0.6 V, m-3 below), still ≪ 34.6 V ✓. VDRV runs to 7.5 V ✓. `PD_PG_N` 45–140 ms stated in B, D, E ✓ and ISO7740 default-high gives "loss" when the primary dies (A-interfaces) ✓. |
| **3. `B-sync-clock.md`** (MAJOR-2, m-4, m-7) | **CLOSED** (m-1 margin note) | Only the SN74LVC1G08 is on VREF ✓: ICC 10 µA + CPD ≈ 0.1 mA + 10 kΩ at 10 % duty 0.05 mA + FB ≤ 0.5 mA ≤ 0.7 mA of the 5 mA (UCC2897A p.6, 4.75–5.25 V at 0–5 mA) ✓. SYNC ≤ VREF + 0.3 V (abs max p.5) in every state: VREF on → VOH ≤ VCC ✓; VREF off with `V5_CLK` up → LVC1G08 Ioff ≤ ±10 µA (p.5) × 10 kΩ = 0.1 V ✓; VREF ramping → VOH tracks VCC ✓; `V5_CLK` absent → inputs low → SYNC low → free-run ✓. The LVC1G08 inputs at up to 5.15 V with VCC = 4.75 V are inside the 5.5 V ROC ✓. HT7550 (UMW): VIN max 30 V, IOUT ≥ 60 mA, dropout 0.1 V, load regulation ≤ 150 mV → `V5_CLK` ≈ 4.8–5.15 V; the 74HC4017 and LVC1GU04 share that rail so VIH = 0.7·VCC is met by construction ✓; 0.1 W in SOT-89 ✓. One-shot: B is a Schmitt input, A = L / CLR = H triggers on B↑ (SCES586D function table), retriggerable (trr 75 ns), Rext 10 kΩ ≥ 1 kΩ min at VCC ≥ 3 V (p.4) ✓; CO (Q5-9, low in states 5–9, Nexperia p.2) gives a 737 kHz edge every 1.356 µs. Fallback: CO freezes → `CLK_OK` falls after tw → SYNC low → free-run 590–708 kHz; the UCC's ±600 µA SYNC driver (p.7) is overridden by 60 mV ✓. Start-up: `V5_CLK` is up at VB_PRI ≈ 5.1 V, VREF at VDD ≥ 12.x V, so the clock is always running first; no state needs the converter to run before the clock, no deadlock ✓. m-7 (irregular counting during crystal start-up inside the 60 ms soft-start) recorded ✓. |
| **4. Clock-fault rule (AB-M3 + item 9)** | **CLOSED** | Items 1–9 are **identical** in `B-` and `E-interfaces.md`; E appends one consistent bullet (hard rule: no start / mute on fault). `E-pinmap.md` B6 says run-average ✓. Dead crystal: free-run 590–708 kHz → intervals 1.04–1.25 T, runs qualify, average off by ≥ 4.1 % → FAULT; a free-run outside 0.8–1.3 T is caught by item 9 (off-band, < 1.9 T) ✓. Normal operation: locked edges move tens of ns (≈ 2–3 %), run-average error ≤ 0.07 % ≪ 0.5 %; skips give intervals ≥ 1.9 T which end runs and never count; the NCP4306 LLD 1–2 missed edges give 2T/3T ✓. No false mute. |
| **5. Fly-Buck 68 µH, lowered UVLOs** | **CLOSED** (m-3, n-2) | PSSCAQ7048M-680M: 68 µH ±20 %, DCR 0.7 Ω, Irms 0.7 A, Isat 1.8 A, 600 V (table line) ✓. At −20 %, 347 kHz (TON max: 18.4/(1.61e-10 × 330 k)), 56 V: ΔIL = 37.6 × 18.4/(54.4 µ × 347 k × 56) = 0.65 A → isw(pk) 0.56 A at the design load, 0.72 A in the 200/190 mA fault (foldback, previously accepted) ✓. Winding loss 0.06 W ✓. UVLOs: LM5013 on 30.2 V (28.8–32.2), off 28.2 V (≤ 29.6 V); tON at 27.2 V = 64.9/(2.5 × 27.2) + 0.03 = 0.984 µs ≤ 1000 ns ROC ✓ (1.6 % margin, n-2). LM5017 on 29.8 V (28.9–30.6), off 27.3 V (≤ 29.4 V), D = 0.68 at 27 V with toff ≈ 0.7 µs ≥ 144 ns ✓. |

## 2. New findings

### MAJOR
- **MAJOR-1. `B-vbus-droop.md` Circuit 3–4 (output stage).** LM393 onsemi EC table: **VOL ≤ 400 mV at 25 °C, ≤ 700 mV over temperature** (ISink ≤ 4 mA; here 1 mA). AO3400A p.2: **VGS(th) 0.65–1.45 V at 250 µA, 25 °C**, falling ≈ 2–3 mV/°C, i.e. ≈ 0.45 V min near 100 °C junction. In the *released* state the gate sits at the LM393's VOL; at the datasheet corners (0.7 V gate, 0.45 V threshold) the FET conducts tens of mA and pulls `POE_LOSS_N` (4.7 kΩ to +3V3, 0.7 mA) low: a **false PoE-loss mute and relay drop in normal hot operation**, the failure class this redesign exists to remove. At 25 °C limits (0.4 V vs 0.65 V) the leakage is ≈ 1 µA, so it will not show on a bench at room temperature. **Fix:** replace the AO3400A by a **2N7002** (VGS(th) 1.0–2.5 V; RDS(on) ≤ 7.5 Ω at 4.5 V → 10 mV at 1.37 mA, inside block F's ≤ 0.1 V) **and** change the 1 MΩ gate pull-down to **10 kΩ**, so the gate sees ≤ VOL/2 ≤ 0.35 V low and ≈ 4.9 V high. The output-high level then becomes ≈ 5 V, which moves the release point: with the 1.00 MΩ feedback it is 2.495 + 2.5 × 10 k/1.01 M = 2.520 V → **40.3 V, hysteresis 0.8 V**; either accept that (still > assert, > ripple) or lower the feedback resistor to ≈ 499 kΩ to restore ≈ 1.6 V, and update rows 2 of the shared rule in B/D/E and the E-pinmap A6 row.

### MINOR
- **m-1. `B-sync-clock.md` item 3.** tw of the LVC1G123 with Rext 10 kΩ / Cext 220 pF is ≈ 2.0–2.5 µs from the SCES586D graphs (K ≈ 1 only above ≈ 1 nF), against the 1.356 µs CO period: ≈ 50 % margin before C0G ±5 %, Rext 1 % and the K spread. The "2–4 µs" claim is optimistic; use **470 pF** (tw ≈ 4.5 µs; fallback still ≤ 5 µs) or keep 220 pF with the bench item made mandatory.
- **m-2. `B-vbus-droop.md` Circuit 1.** TL431 cathode current (VSR − 2.495)/6.8 kΩ = 1.10 mA nominal, **1.05 mA** at VSR −3 % and 6.8 kΩ +1 %, less the 2.4 µA hysteresis path, against **Imin max 1.0 mA** (SLVS543N). 5 % margin. Fit **3.3–4.7 kΩ** (1.6–2.3 mA, ≤ 23 mW).
- **m-3. `C-5v-buck.md` Rev. 3, `C-pm15-flybuck.md` Rev. 4, `C-sequencing.md` table.** The "≤ 29.6 V / ≤ 29.4 V" UVLO-off figures use the IC limits only; 1 % dividers add ≈ 2 % → **≈ 30.2 V / 30.0 V**. Harmless (≪ 34.6 V, hold-up ≥ 150 ms) but quote it, and fix `C-sequencing.md`, which still carries **36.2 V / 35.9 V** in the start-up chain and **33.8 V / 33.4 V** in "Shutdown / hold-up", contradicting its own last section.
- **m-4. Tolerance text.** `B-vbus-droop.md` "±1.5 %" → ≈ ±2.6 % with the TL431BI SOT-23-3 34 mV deviation (SLVS543N) and LM393 IIB over temperature: assert 38.5–40.5 V, release 40.0–42.2 V. Propagate to the shared rule row 2 (B/D/E), `E-pinmap.md` A6 and the hold-up paragraph (1.45 J, ≈ 160 ms). All conclusions survive.
- **m-5. Stale wording.** `C-sequencing.md` step 2 and `F-mute-relay.md` R-34 bullet still say "pulse-loss comparator"; `D-interfaces.md` hardware paragraph says the rails "hold ≥ 46 ms" beside B's ≈ 170 ms (both > 20 ms, but one number); `intent.md` R-32a calls it a "fast comparator" — it is 18–41 ms at 60 W, ≈ 240 ms at idle, set by the 6 mF bulk, which R-34 tolerates. Lead to align the intent wording.
- **m-6. `B-vbus-droop.md` Circuit 2.** The 150 kΩ 0.1 % top resistor sees 57 V continuously and the 82.4 V TVS clamp: use an **0805** (150 V working), as block C does for its UVLO dividers, not a 0603.

### NOTE
- n-1. Do not add a capacitor on the TL431 reference/cathode node (the 10 kΩ → + input and 1 MΩ are its only loads): 1 nF–1 µF is the TL431's unstable region; it is stable bare.
- n-2. LM5013 tON 984 ns at the 27.2 V UVLO-off corner is 1.6 % under the 1000 ns ROC with an unspecified tON tolerance; it only occurs during the last ms of a shutdown ramp. Record it.
- n-3. `B-vbus-droop.md` "Block F's relay OR keeps its relays off until 41.1 V" is true for VBUS ≳ 7.5 V (VSR present); below that, and on USB-only power, `POE_LOSS_N` reads high and the relays rely on the HP_EN/LO_EN gateware default, which is already the design.
- n-4. The ADC detector (40.5 V calibrated) trips before the comparator (≤ 40.5 V) in the calibrated case; the comparator is the FPGA-independent hardware path for block F's D_PL and the ADC-failure case. Both intended; say so.

## 3. Verdict

**Phase 1 can pass once MAJOR-1 is applied** (a two-part change in `B-vbus-droop.md`, no architecture
impact; re-derive the release threshold and mirror it in the B/D/E rule and E-pinmap A6). Items 2–5
are closed: the PoE-loss rule is identical in the three files and covers cable pull, PSE power-off,
slow brown-out and loss in skip/DCM with ≥ 150 ms of rail hold-up after a ≤ 5 ms ramp; the sync chain
keeps SYNC ≤ VREF + 0.3 V in every state, falls back cleanly and cannot deadlock; the clock-fault rule
catches a dead crystal and never mutes in normal operation; block C's 68 µH and UVLO figures re-derive.
m-1…m-6 are text or value trims to make in the same edit.

## 4. Fix verification (same reviewer, 2026-11-08, after block B's MAJOR-1 edit)

Re-read `B-vbus-droop.md`, `B-/D-/E-interfaces.md`, `E-pinmap.md`, `B-sync-clock.md`, `C-sequencing.md`,
`C-5v-buck.md`, `C-pm15-flybuck.md`, `F-mute-relay.md`, `intent.md`; 2N7002 from
`datasheets/2n7002-jscj.pdf` (CJ sheet: VGS(th) 1.0/1.6/2.5 V at 250 µA, RDS(on) ≤ 7 Ω at VGS 5 V /
50 mA, VGS ±20 V).

| Check | Status | Reason |
|---|---|---|
| (1) Output stage | **CLOSED** | Pull-up 3.3 kΩ to VSR, 10 kΩ series, 15 kΩ gate–source. Released: LM393 sinks (VSR − VOL)/3.3 k ≈ 3.0 mA ≤ the 4 mA VOL test condition, gate = VOL × 15/25 ≤ 0.7 × 0.6 = **0.42 V** against VGS(th) ≥ 1.0 V (≈ 0.75 V at a hot junction): ≥ 0.33 V off-margin at the datasheet corners ✓. Asserted: node = VSR × 25/28.3 = 8.57–9.10 V (VSR 9.7–10.3 V), gate **5.14–5.46 V ≥ 5 V**, the VGS at which RDS(on) ≤ 7 Ω is specified → 1.37 mA × 7 Ω = **9.6 mV** ≤ block F's 0.1 V for D_PL ✓; VGS ≪ 20 V ✓. |
| (2) Bands | **CLOSED** | Re-derived with the 866 kΩ feedback: + input 2.4665–2.4745 V (VOL 0–0.7 V) → assert 39.46–39.59 V; node 8.57–9.10 V → 2.5644–2.5704 V → release 41.03–41.13 V; hysteresis ≈ 1.6 V ✓. With the ±2.6 % budget: **assert 38.5–40.5 V, release 40.0–42.2 V**; 2.7 V under the 43.2 V sag, 1.8 V under the Type 2 burst floor (42.3 V), 1.8 V under the 44.0 V `VBUS_VALID` (2.7 V under 44.9 V uncalibrated) ✓. Hold-up from 38.5 V to 30.2 V on 4.8 mF: 1.37 J − 0.15 J → ≈ 150 ms ✓. |
| (3) Minors | **CLOSED** (two residual words) | m-1 Cext 470 pF (tw ≈ 4.5 µs) ✓; m-2 TL431 3.9 kΩ, 1.85 mA ≥ 1.8× Imin ✓; m-3 `C-sequencing.md` chain now 30.2 V / 28.8–32.2 V, hold-up table ≈ 30.2 / 30.0 V incl. 1 % resistors, 34 ms ✓ (`C-pm15-flybuck.md` Rev. 4 itself still quotes only ≤ 29.4 V; `C-sequencing.md` carries the corrected figure, acceptable); m-4 ±2.6 % table in B ✓; m-5 `F-mute-relay.md` "VBUS-droop comparator" ✓, `D-interfaces.md` ≈ 150 ms ✓, `intent.md` R-32a "hardware VBUS-droop comparator" ✓; m-6 150 kΩ 0805 ✓; n-1, n-3, n-4 recorded ✓. **Residual stale text in `B-vbus-droop.md`:** "comparator's 41.7 V maximum release" (line ≈ 76) should read 42.2 V, and the behaviour table's "3.1 V margin" should read 2.7 V. Text only. |
| (4) Mirroring | **CLOSED** | Rule items 1–6 are byte-identical in B, D and E (re-diffed). Row 2 reads "39.5 V (38.5–40.5 V), releasing above 41.1 V (40.0–42.2 V)" in all three; `E-pinmap.md` A6 carries the same bands and "2N7002 open drain (VOL ≤ 10 mV at 1.37 mA)"; B's signal table and D's hardware paragraph name the 2N7002 and 150 ms; E's signal table and its MINOR-2 row name the 2N7002. D and E have mirrored. |

**Final verdict: phase 1 PASSES** on the items in this review's scope. MAJOR-1 is fixed and verified
against the 2N7002 sheet; the two stale numbers in `B-vbus-droop.md` (41.7 V → 42.2 V, 3.1 V → 2.7 V)
and the `C-pm15-flybuck.md` tolerance note are text edits that do not need another review pass.
