sequoia-hope/studio-amp/design/parts/D-lmg1210.md

# U (×4) — LMG1210 half-bridge GaN driver (one per half-bridge), driving IGC033S10S1

> **UPDATE 2026-11-08 — GaN back to IGB070S10S1 (user), fsw 576 kHz. This block supersedes the IGC033 figures below where they differ; part values are unchanged and remain valid for the IGC033 fallback.**
> - Effective dead time with IGB070 edges (turn-off ≈ 4.5 ns, turn-on to Vth ≈ 2.4 ns): ≈ td − 2 ns → **≈ 18 ns nominal, 14–24 ns** at the 20 ns setting (20.0 kΩ, unchanged). No shoot-through (≥ 14 ns).
> - Driver current at 576 kHz: 2 × 7.9 nC × 0.576 MHz + 1.95 mA/MHz × 0.576 + 1.4 + 0.08 + 0.3 = **12.0 mA per driver, 48 mA for four** (0.34 W at 7 V; ≈ 0.40 W from VBUS). 448 kHz: 39 mA; 768 kHz: 57 mA; 1 MHz: 78 mA. **VDRV spec ≤ 150 mA kept** (covers the IGC033 fallback: 76 mA at 576 kHz).
> - Dissipation ≤ 7.35 V × 12.0 mA = 88 mW → ΔTj ≤ 3.6 °C.
> - Uncompensated dead-time error per leg 48 V × 18 ns × 576 kHz = 0.50 V (≈ 1.5 % H3 at 50 W/8 Ω) → gateware compensation with per-board calibration (unchanged requirement).
> - Duty clamp 8–92 %: PWM low ≥ 139 ns, LO ≥ 113 ns (D-bootstrap.md).
> - HB−HS worst-case maximum 5.32 V exceeds the 5.25 V ROC by 0.07 V (D-bootstrap.md).

> **fsw update (block E review, ECP5 −7I grid now 1.695 ns, PLL ×12): baseline fsw = 576 kHz (12 × 48 kHz, 1024 steps); 768 kHz option; 448/512/672 kHz only with E's ×14 bring-up option.** Driver current at 576 kHz: 2 × 14 nC × 0.576 + 1.95 × 0.576 + 1.4 + 0.08 + 0.3 = **19.0 mA per driver, 76 mA for four** (0.53 W at 7 V); ≤ 150 mA spec unchanged. Duty clamp 8–92 % → PWM low ≥ 139 ns → LO ≥ 113 ns. Dead-time error per leg 48 × 15 ns × 576 kHz = 0.41 V (≈ 1.25 % H3 at 50 W/8 Ω uncompensated).

Datasheet: datasheets/lmg1210.pdf (TI SNOSD12D, rev D, Jan 2019, English; LCSC's copy was the Chinese translation ZHCSHO1D, so TI's was used). Read: all sections incl. Do's and Don'ts (§8.3), layout (§10), package addendum.
MPN: LMG1210RVRR (user's choice). Supplier: `C2677136 LMG1210RVRR (TI, WQFN-19-EP(3x4)): extended, JLC stock 2841, lifecycle normal, checked 2026-11-07`. TI orderable addendum: "Active". Build need 4 × 5 + 2 = 22 ✓.
Footprint: WQFN-19 RVR 3 × 4 mm with **two thermal pads**: pad 20 = VSS, pad 21 = HS (p.3). Keep them as separate nets; check the RVR drawing in phase 2.
Operating point (D-interfaces.md): GaN **IGC033S10S1** (Qg 11 typ / 14 nC max, Ciss 1.4 nF max, Qgd 2.6 nC, Vplateau 2.6 V), fsw **448 kHz** (512 / 672 kHz options), BD, **dead-time setting 20 ns**, **duty clamp 8–92 %**.
Revision note (phase 1 review, design/gates/review-phase1-D.md): this file was rewritten for IGC033; the IGB070S10S1 figures it used to carry are gone (that part is the rejected alternative in D-gan-fet.md).

## Mode decision: PWM mode (single input with programmable dead time)
- **Pins:** 1 PWM per half-bridge (4 in all) instead of HI + LI (8). EN is driven by the per-channel fault latch (D-ocp-logic.md).
- **Shoot-through is impossible by construction:** HO/LO are generated inside the chip with resistor-set dead times. In IIM "the controller is responsible for assuring that the LI and HI on-times do not overlap" (§8.2.2.4).
- **Edge fidelity:** HS/LS matching is internal; the FPGA's edge placement reaches the switch node with only the fixed propagation delay (11 typ / 21 ns max, p.7). IIM would add the 3.4 ns mismatch to every edge.
- **Cost:** the dead time is fixed per build (resistor). Gateware dead-time *compensation* is still possible and required (below).
- The mode is "sampled at power up and cannot be changed during operation" (§7.4). DLH must never be tied to VDD.

## Absolute max vs our worst case
| Parameter | Abs max (p.4) / ROC | Our worst case | Margin |
|---|---|---|---|
| VIN | 20 V; ROC 6–18 V | VDRV 7.0 V ± 5 % (block C, LM5017) | ✓ |
| VDD | 5.5 V | LDO 4.75–5.25 V | ✓ |
| VHS | ±300 V abs, ±200 V ROC | −3.3 V (dead-time VSD at 16 A) … 48 V + ring (≤ 21 V, D-gan-fet.md m3) ; TVS event 82.4 V + ring | ✓ |
| VHB−VHS | 5.5 V abs; ROC 3.80–5.25 V | 4.07 V min (sustained max duty) … 5.24 V max (D-bootstrap.md) | inside ROC; 0.01 V below the 5.25 V ROC max at the worst-case maximum (stated in D-bootstrap.md) |
| PWM/EN inputs | −0.5…10 V; VIR 1.70–2.45 V, VIF 0.70–1.30 V | 0–3.3 V LVCMOS | ✓ |
| CMTI | 300 V/ns | 48 V/6.4 ns = 7.5 V/ns | ✓ |
| Tj | 150 °C (ROC 125 °C) | ≈ 85–110 °C (board + 5 °C; dissipation below) | ✓ |
| Negative HS with the bootstrap diode (§7.3.6) | conduction at VHS = −(VF_bst + V_ESD + VHB−VHS) ≈ −(0.2 + 0.7 + 4.1) = −5.0 V worst | −VSD(16 A) = −(2.2 + 0.045 × 16) = −2.9 V typ; Table 8: 3.1 V max at 20 A → ≈ −3.3 V | 1.7 V ✓ |

## Required external parts
Values and calculations: D-driver-passives.md and D-bootstrap.md.
- VDD–VSS: ≥ 0.3 µF effective, ESR < 0.5 Ω (§7.3.2); TI recommends 100 nF + 220 nF…10 µF (§9); ≥ 5 × CBST (§8.2.2.1) → **100 nF + 2 × 2.2 µF**.
- VIN–VSS local bypass (§9) → 1 µF 25 V.
- HB–HS bootstrap cap (Eq. 7) → **470 nF**.
- Bootstrap diode BST→HB, rated ≥ the GaN VDS max, Schottky, low C (§8.2.2.2) → BAT46WJ (100 V).
- DHL and DLH to VSS, 20 kΩ–1.8 MΩ (p.4) → **20.0 kΩ each**.
- NC1 (pin 14): "For proper operation, this pin should be either unconnected or tied to HS" (SNOSD12D p.3, Pin Functions) → tied to HS on the schematic, which the datasheet permits. Pins 1, 11, 15 are true NC ("not internally connected") and are left open.
- 100 Ω series on the PWM and EN inputs (§8.2.2.3), optional 10 pF DNP.

## Calculations

### Dead time (Eq. 4, 5; p.7, p.13)
Setting **td = 20 ns → Rext = 900/20 − 25 = 20.0 kΩ** (the datasheet's characterised point: tDEAD_MAX 16 / 20 / 26 ns min/typ/max at Rext = 20 kΩ, p.7). Eq. 5: VDT = 1.8 × 20/45 = 0.80 V → td = (1.8 − 0.80) × 20 = 20 ns ✓. DT pin current 1.8 V/45 kΩ = 40 µA each.
**Effective dead time at the FETs** (review m1): tDEAD is specified with *unloaded* outputs. With IGC033 the outgoing FET turns off in ≈ 8 ns: VGS 5 V → 2.6 V plateau at ≈ 1.2 A through 1.6 Ω sink + 2.2 Ω Rg + 0.5 Ω Rg,int ≈ 3 ns, then Qgd 2.6 nC at 2.6 V/4.3 Ω = 0.6 A ≈ 4.3 ns. The incoming FET reaches Vth ≈ 3 ns after its edge. The window in which neither channel conducts is therefore ≈ td − 8 + 3 = **≈ 15 ns nominal, ≈ 11–21 ns over the 16–26 ns spread**. That is the window the loss model credits (D-gan-fet.md uses 15 ns). It is ≥ 11 ns > 0 at the fast extreme, so there is **no shoot-through**.
Why 20 ns rather than 16 ns: with the 16 ns setting the effective window would be ≈ 11 ns and idle loss +0.8 W (D-gan-fet.md). The larger dead-time error is compensated in gateware and calibrated per board with the post-filter sense, which is fitted on all prototypes (user decision E).
Uncompensated dead-time error per leg at the effective 15 ns: 48 V × 15 ns × 448 kHz = 0.32 V (0.65 V differential, ≈ 0.97 % H3 at 50 W into 8 Ω). Required: gateware compensation (gateware item 4).

### Driver supply current and VDRV load (Eq. 8–10; p.5–6)
Per driver: 2 × Qg(max) 14 nC × fsw + ILSDyn 1.25 mA/MHz × fsw + IHSDyn 0.7 mA/MHz × fsw + IDD 0.55 mA + IHB 0.85 mA + DT 2 × 0.04 mA + gate pull-downs (LS 10 kΩ: 0.5 mA × (1 − D); HS 100 kΩ: 0.05 mA × D) ≈ 0.3 mA:
| fsw | per driver | **4 drivers = VDRV load** | power at 7 V |
|---|---|---|---|
| **448 kHz** | 12.5 + 0.87 + 1.4 + 0.08 + 0.3 = **15.2 mA** | **61 mA** | 0.43 W |
| 512 kHz | 17.0 mA | 68 mA | 0.48 W |
| 672 kHz | 21.9 mA | 88 mA | 0.61 W |
| 1 MHz | 31.7 mA | **127 mA** | 0.89 W |
**VDRV spec: 7.0 V ± 5 %, ≤ 150 mA** (block C's LM5017 is designed for 200 mA). LDO headroom: VIN(min) 6.65 − 5.25 = 1.4 V ≥ 0.75 V max dropout at 100 mA ✓.

### Driver dissipation and Tj
Upper bound 7.35 V × 15.2 mA = 112 mW at 448 kHz (233 mW at 1 MHz), less the gate energy dissipated in Rg. RθJA 40.5 °C/W → ΔTj ≤ 4.5 °C (9.4 °C at 1 MHz). Low-side OTP 150 °C min (§7.3.4) is far away.

### Start-up timing (gateware, block E)
tSTLS 150 µs max after VDD UVLO (PWM mode); tSTHS 28 µs max after HB−HS UVLO (p.7). Bootstrap pre-charges through the internal 1 kΩ (§7.3.1). Sequence: VDRV good → wait ≥ 200 µs → AMP_ARM, latch EN = 1 → PWM low ≥ 50 µs (all LS on: BTL output 0 V, pop-free) → modulation at 50 % (BD idle).

### Minimum pulse and duty clamp (review M1)
In PWM mode the HO and LO pulses are the input pulses "decreased … by the chosen dead-times" (§7.3.3). The LS conducts, and the bootstrap switch is closed, only during LO. **Duty clamp 8–92 % at 448 kHz** → PWM low time ≥ 0.08/448 kHz = 179 ns → LO ≥ 179 − 26 (td max) = **153 ns**. That is the recharge window used in D-bootstrap.md (HB−HS ≥ 4.07 V). The previous 3 % clamp gave a 47 ns LO and HB−HS ≈ 3.6–4.0 V (review M1).
R-50 effect: BD modulation index M_max = 0.92 − 0.08 = **0.84** → 0.84 × 48 V = 40.3 V peak differential → **101 W into 8 Ω** (R-50 "≥ 100 W peak into 8 Ω" ✓), 203 W into 4 Ω (above the 144 W firmware limit, so that limit still binds), 12 A into 3.36 Ω. R-50/R-11's "12 A pk into 4 Ω" means 48 V pk, i.e. M = 1, which was never reachable. Into 4 Ω the current limit at M_max is 40.3/4 = 10.1 A peak at the terminals; the 12 A figure applies to lower impedances (impedance dips below about 3.4 Ω).
Minimum pulse: tPW ≤ 4 ns, pulse extender ≤ 10 ns (p.7) ≪ 153 ns ✓.

## Fine print / gotchas
- "No actual clamp on the high-side bootstrap supply" (§7.3.1): VBST = VDD − VF + IL·Rds(on). Worst case 5.24 V (D-bootstrap.md, review m7).
- DHL/DLH pass an internal 10 kHz RC (§7.3.3): no external capacitance, no switching noise on these pins.
- Two thermal pads on different dies with "very limited thermal coupling" (§8.2.2.5). VSS pad to the GND plane with vias; HS pad to switch-node copper only. "Make the low-side die hotter" (§7.3.4).
- §8.3 Don't: "drive the IC from a controller with a separate ground connection than the VSS pin … unless … CMC". VSS is the GND plane at the LS source (no LS shunt; sensing is in the output path), and the FPGA is on the same plane → 100 Ω series inputs suffice.
- The LMG1210 has no OCP/desat of its own: external (D-current-sense.md, D-short-detect.md, D-ocp-logic.md).
- Rev D raised IHSDyn to 0.7 mA/MHz; used above. MSL2 per the addendum.

## Layout guidance (§10)
Driver as close to the GaN as possible; bootstrap diode as close as possible (small BST–HB loop); VDD–VSS bypass at the pins first, then VIN–VSS and HB–HS; separate power and signal traces; minimise high-side-to-input capacitance; copy Fig. 21.

## Open questions
1. Gateware dead-time compensation with per-board calibration (post-filter sense) — block E.
2. Bench: measure the effective dead time (switch-node edges) and idle loss at the 20 ns setting; 16 ns (31.6 kΩ) remains a resistor-swap option.
