sequoia-hope/studio-amp/design/renders/schematic.pdf

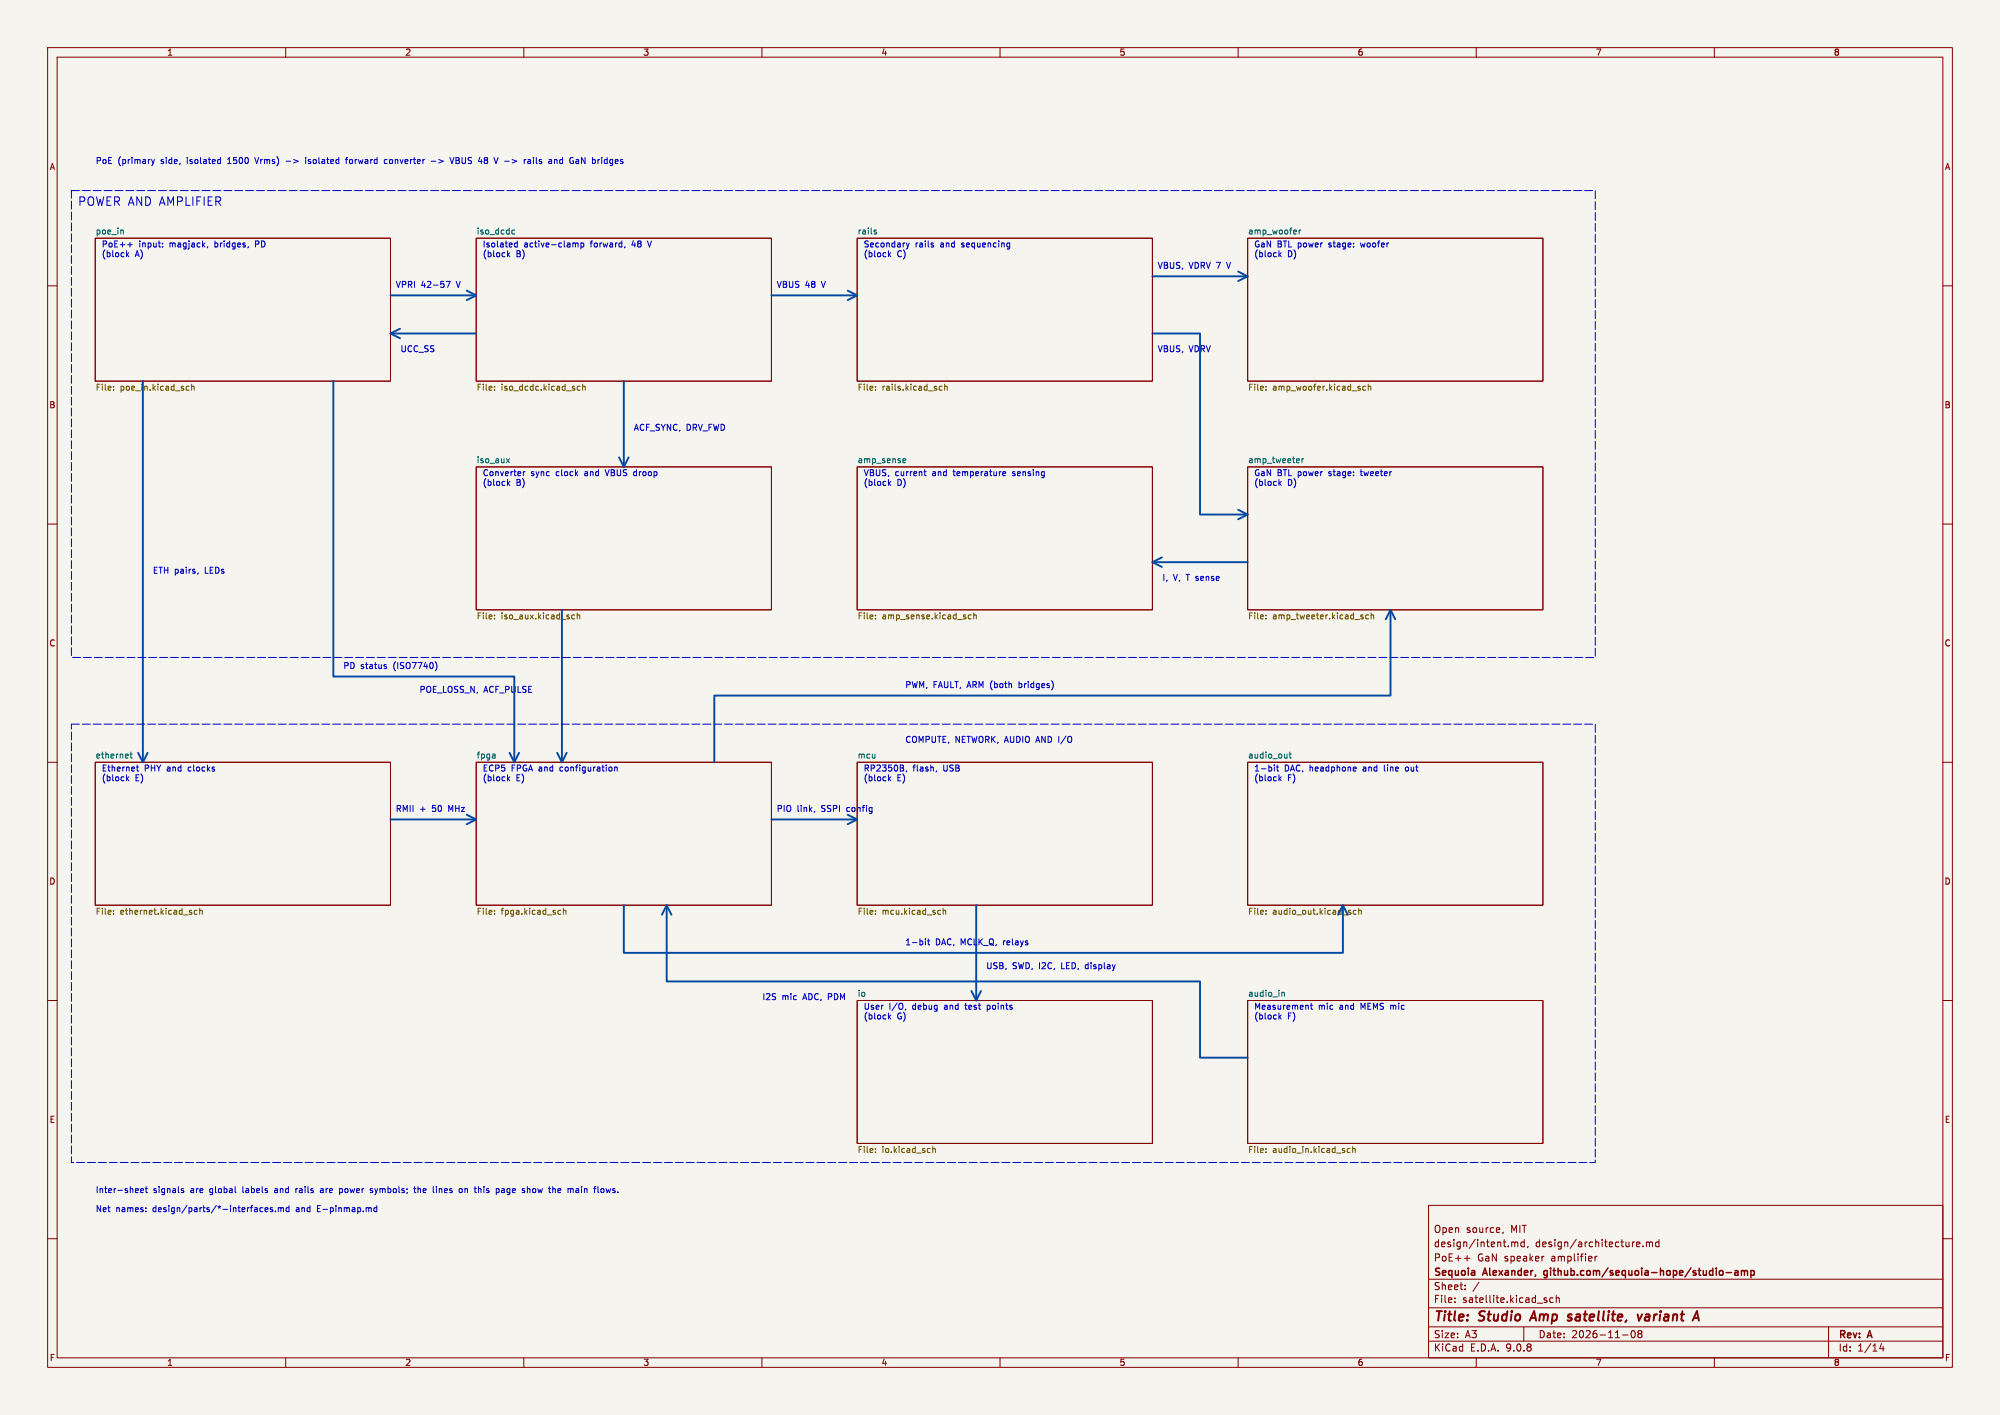
[picture p1: page 1]

rails File: rails.kicad_sch
Secondary rails and sequencing
(block C) RP2350B, flash, USB

amp_woofer File: amp_woofer.kicad_sch
(block D) GaN BTL power stage: woofer

amp_tweeter File: amp_tweeter.kicad_sch
GaN BTL power stage: tweeter

I, V, T sense PWM, FAULT, ARM (both bridges) USB, SWD, I2C, LED, display COMPUTE, NETWORK, AUDIO AND I/O

Ethernet PHY and clocks

ioFile: io.kicad_sch
User I/O, debug and test points
(block G)

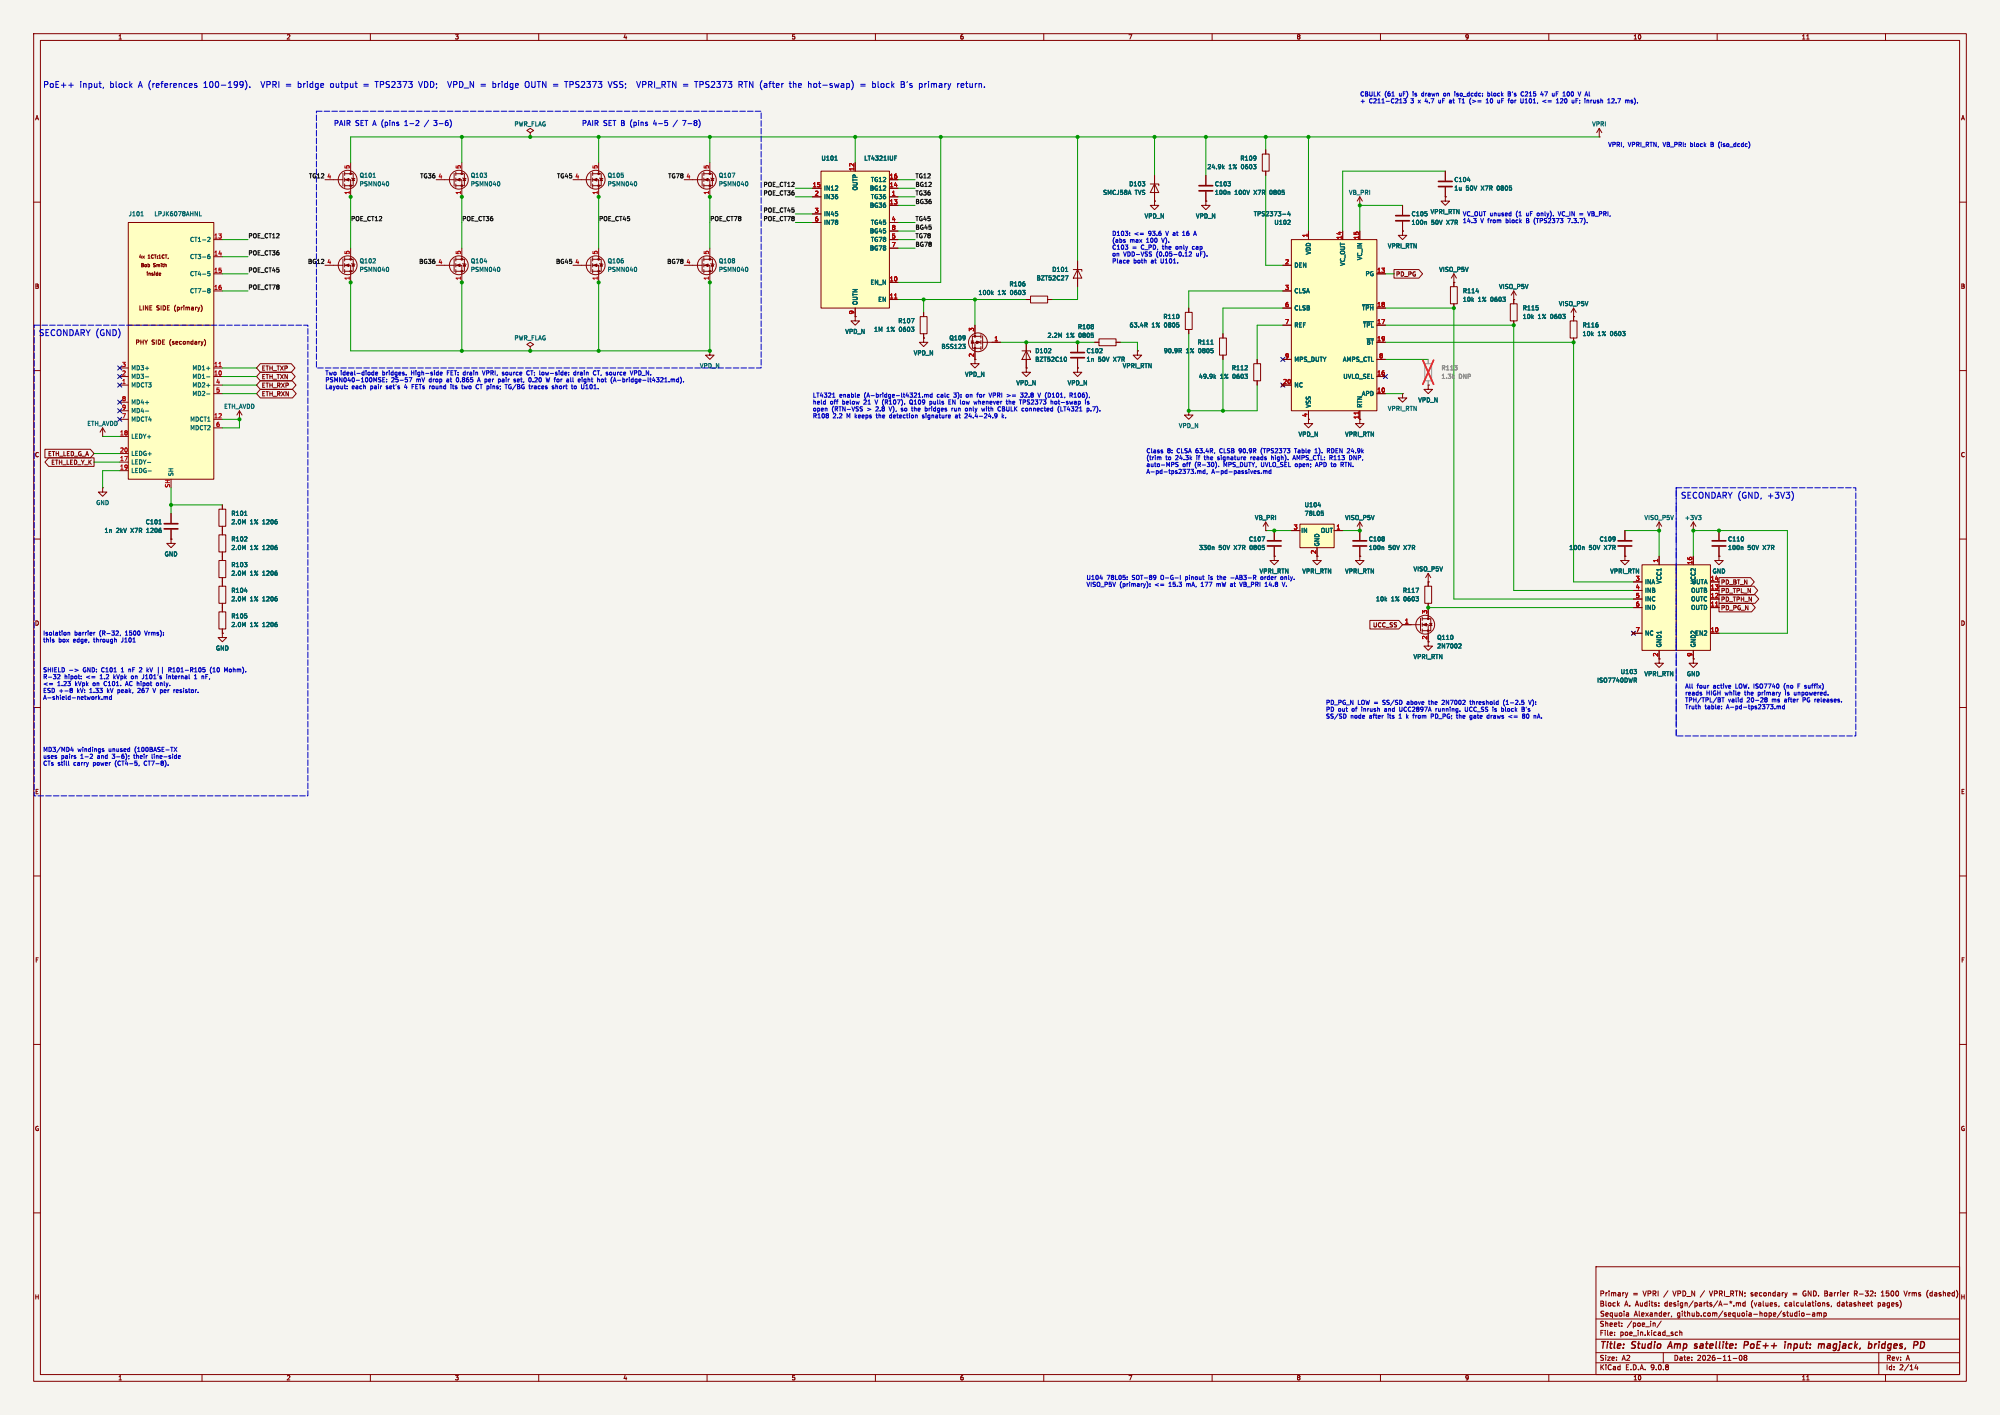
[picture p2: page 2]

VPRI, VPRI_RTN, VB_PRI: block B (iso_dcdc) VC_OUT unused (1 uF only). VC_IN = VB_PRI, 14.3 V from block B (TPS2373 7.3.7).

SECONDARY (GND, +3V3) D103: <= 93.6 V at 16 A
(abs max 100 V). C103 = C_PD, the only cap

inside LINE SIDE (primary) PHY SIDE (secondary) MD3+ 3 MD3- 2 MDCT3 1 MD4+ 8 MD4- 9 MDCT4 7

this box edge, through J101

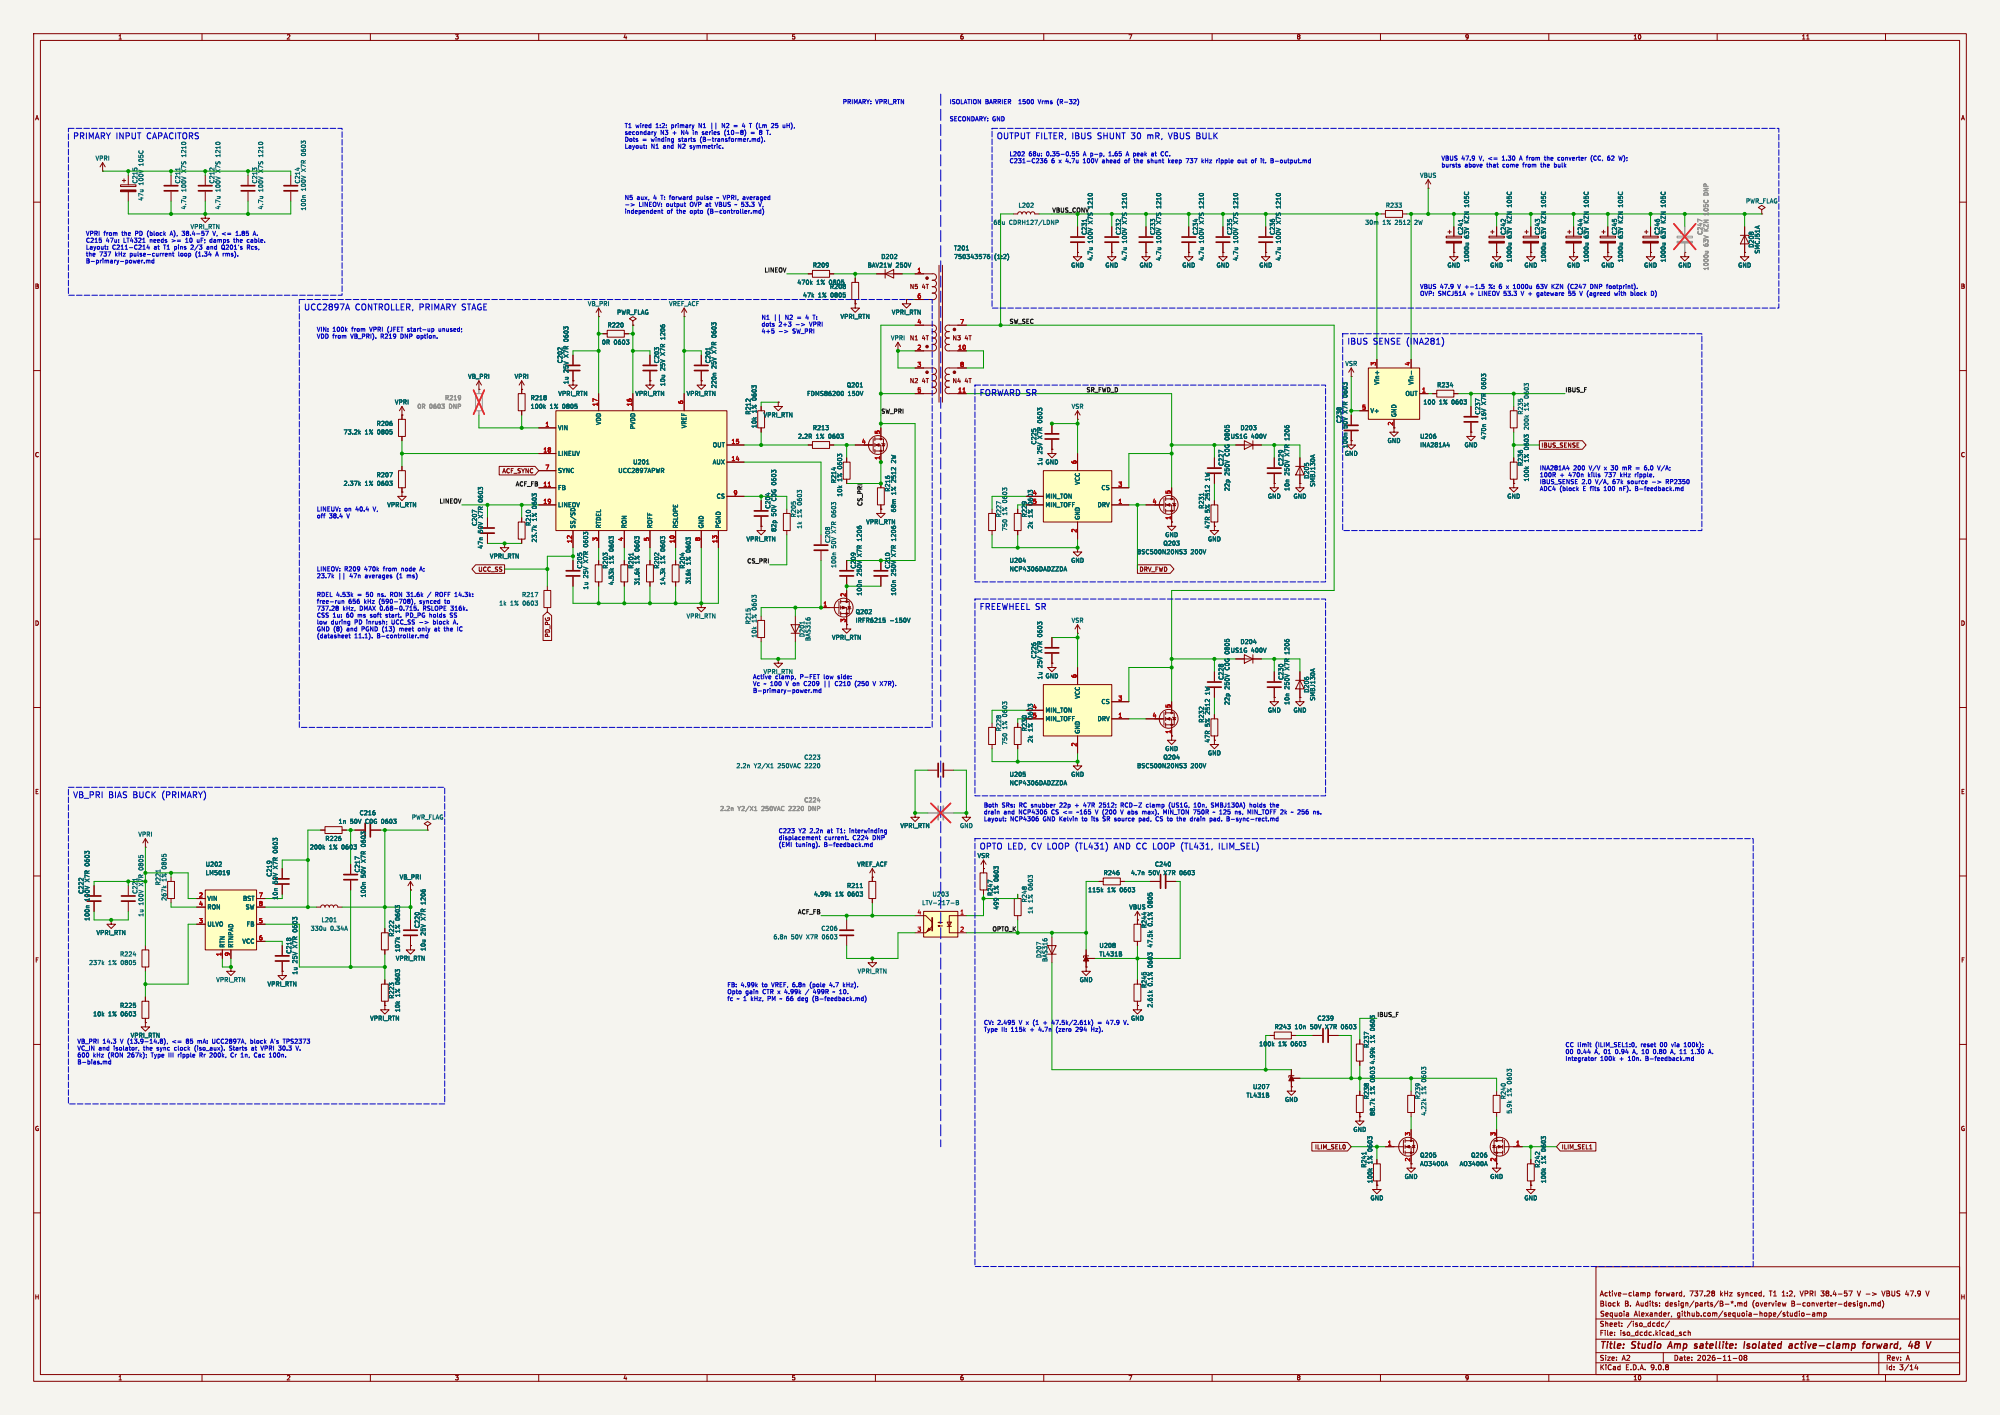
[picture p3: page 3]

OUTPUT FILTER, IBUS SHUNT 30 mR, VBUS BULK
47k 1% 0805 VPRI_RTN

N5 aux, 4 T: forward pulse ~ VPRI, averaged

8 PGND 13 OUT 15 AUX 14 CS 9 C205 1u 25V X7R 0603 R203 4.53k 1% 0603 R201 31.6k 1% 0603 R202 14.3k 1% 0603 R204 316k 1% 0603 C222 100n 100V X7R 0603 VPRI_RTN

8 PGND 13 OUT 15 AUX 14 CS 9 U201 UCC2897APWR

INA281A4 200 V/V x 30 mR = 6.0 V/A; 100R + 470n kills 737 kHz ripple.

5 1 GND GND R230 2k 1% 0603 GND C228 22p 250V C0G 0805D204 US1G 400V C230 10n 250V X7R 1206 D206 SMBJ130A GND GND

2 CS 3 DRV 1 U205 NCP4306DADZZDA GND GND

Both SRs: RC snubber 22p + 47R 2512; RCD-Z clamp (US1G, 10n, SMBJ130A) holds the

9 BST 7 SW 8 FB 5 VCC 6 C219 10n 50V X7R 0603 VPRI_RTN R223 10k 1% 0603 VPRI_RTN
10k 1% 0603 VPRI_RTN

OPTO LED, CV LOOP (TL431) AND CC LOOP (TL431, ILIM_SEL)

9 BST 7 SW 8 FB 5 VCC 6 U202

Opto gain CTR x 4.99k / 499R ~ 10.
fc ~ 1 kHz, PM ~ 66 deg (B-feedback.md)

CC limit (ILIM_SEL1:0, reset 00 via 100k): 00 0.44 A, 01 0.94 A, 10 0.80 A, 11 1.30 A.

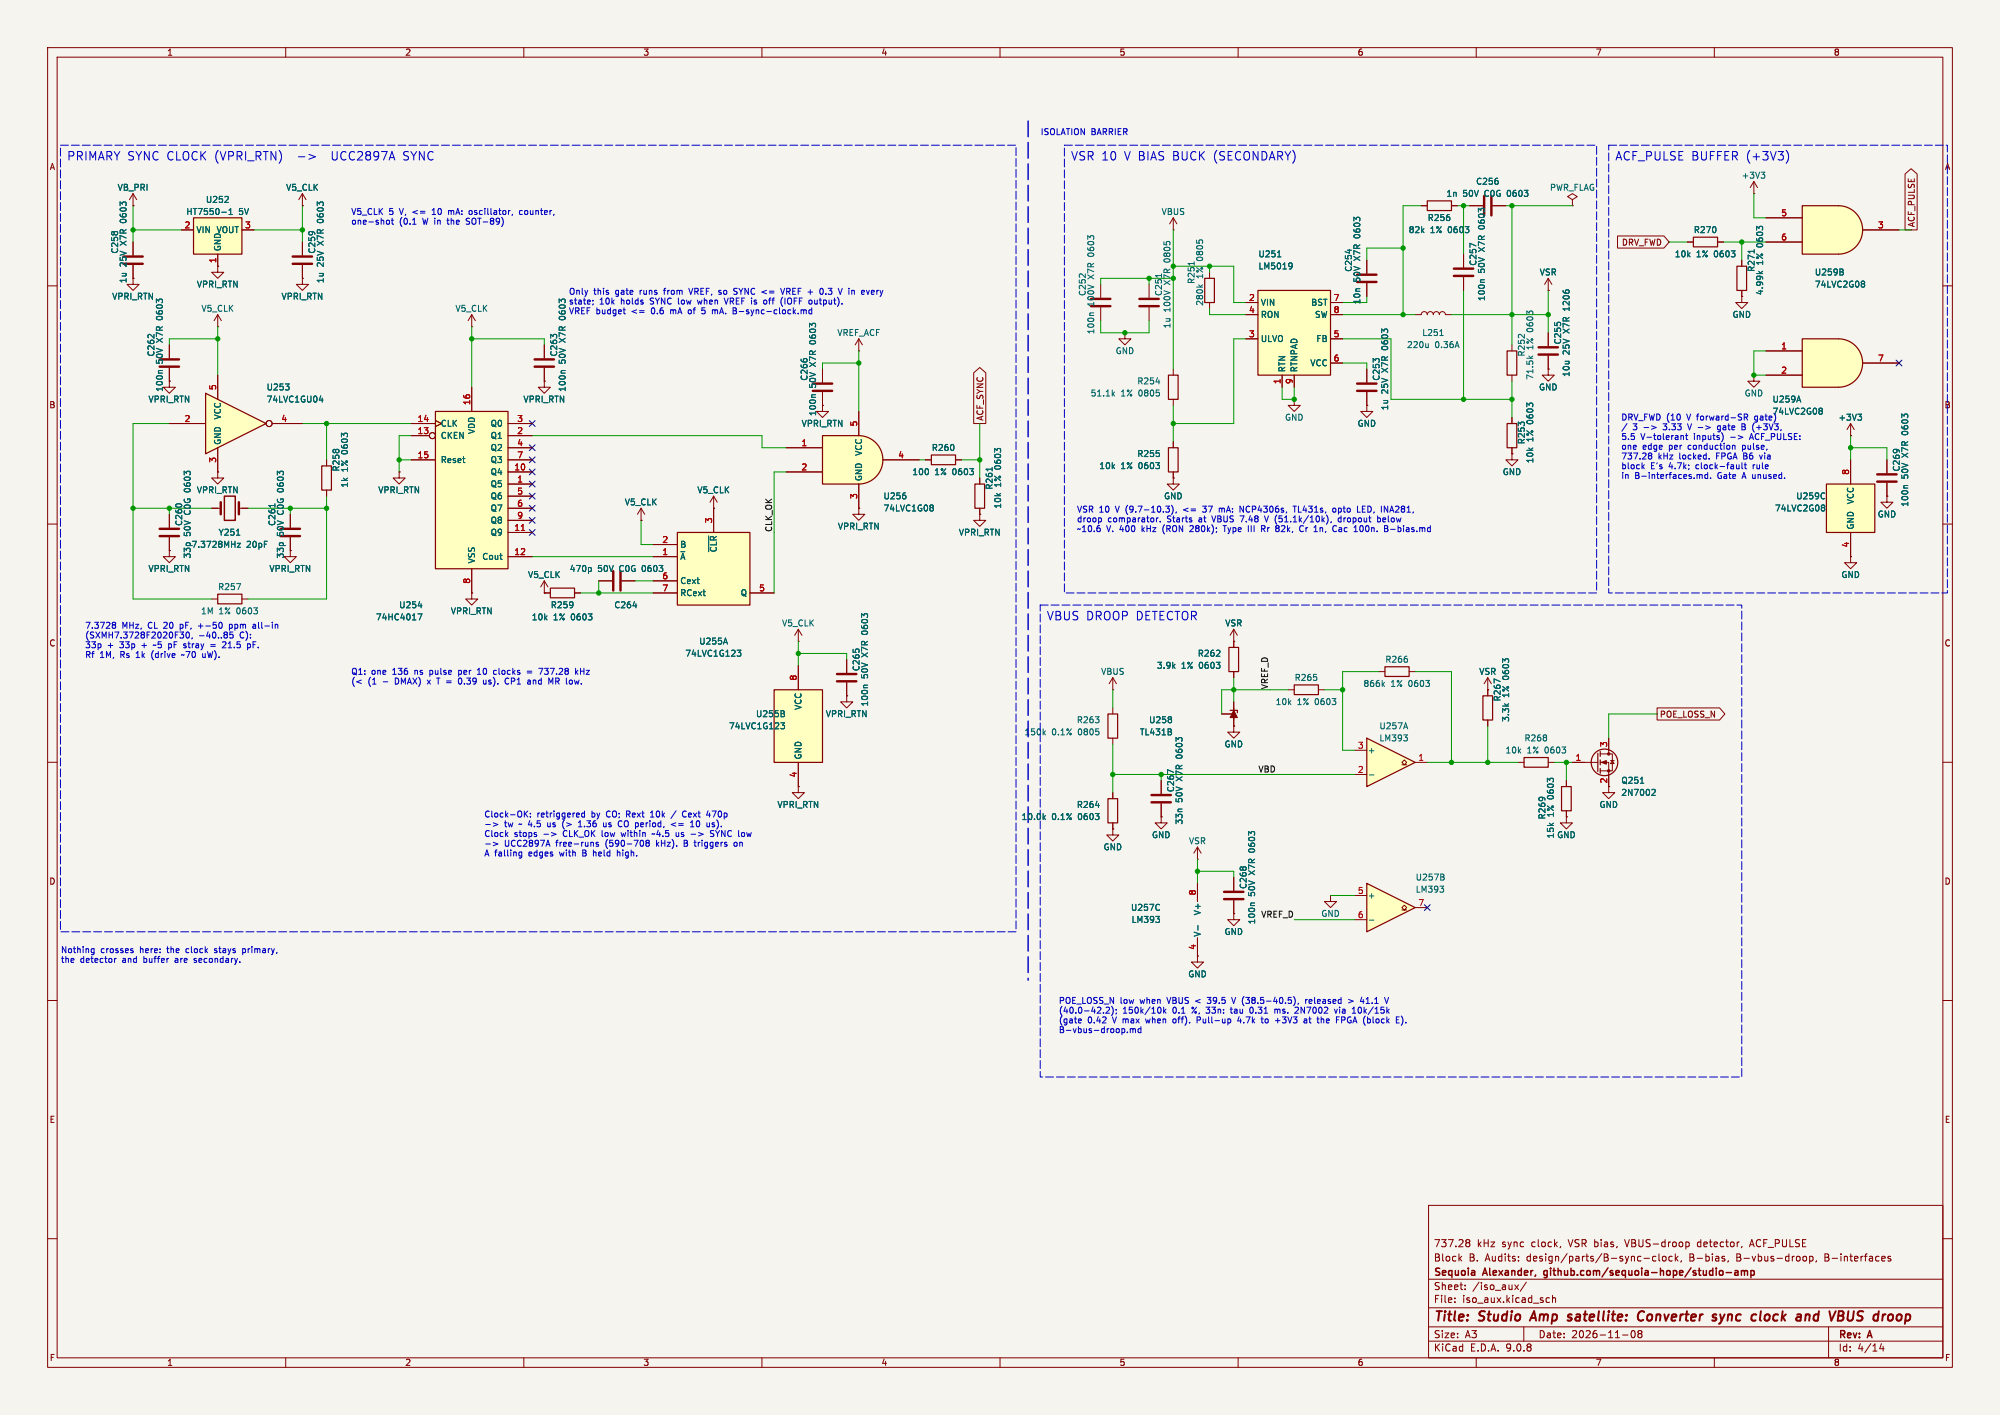
[picture p4: page 4]

9 BST 7 SW 8 FB 5 VCC 6 U251

3 2 GND GND R269 15k 1% 0603 VSR R267 3.3k 1% 0603 VSR GND

Only this gate runs from VREF, so SYNC <= VREF + 0.3 V in every

9 BST 7 SW 8 FB 5 VCC 6 GND

~10.6 V. 400 kHz (RON 280k); Type III Rr 82k, Cr 1n, Cac 100n. B-bias.md

33p + 33p + ~5 pF stray = 21.5 pF. Rf 1M, Rs 1k (drive ~70 uW).

B-vbus-droop.md Q1: one 136 ns pulse per 10 clocks = 737.28 kHz

8 V- 4 GND GND GND GND C267 33n 50V X7R 0603 C268 100n 50V X7R 0603 U258 TL431B GND

Nothing crosses here: the clock stays primary,

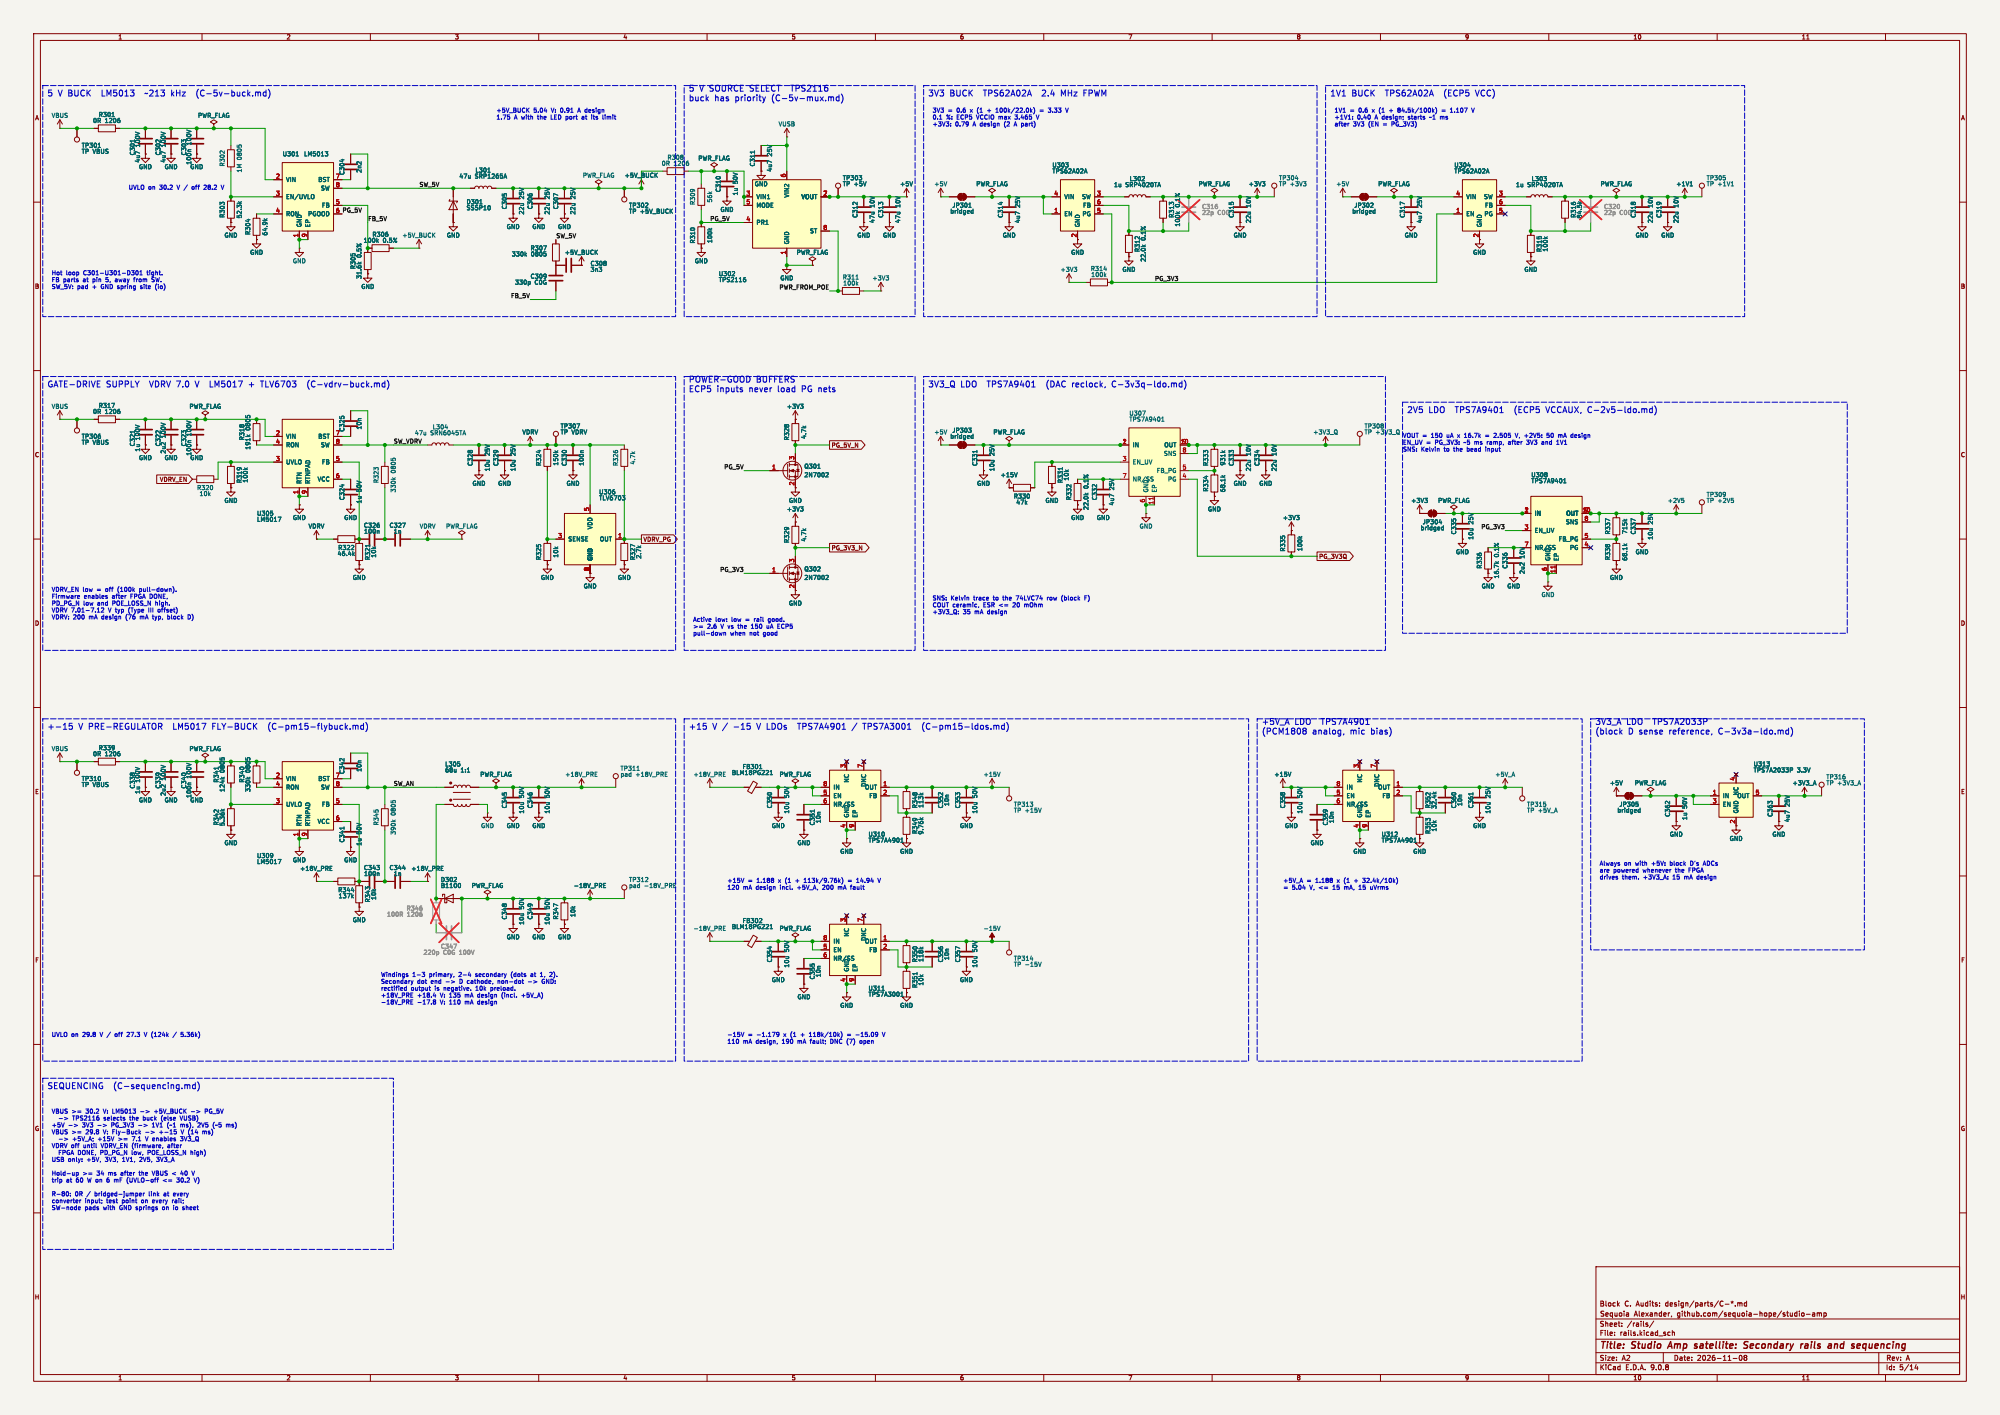
[picture p5: page 5]

2 SW 3 FB 6 PG 5 U303 TPS62A02A C301 4u7 100V C302 4u7 100V R303 52.3k GND

9 BST 7 SW 8 FB 5 PGOOD 6 U301 LM5013 R304 64.9k GND R309 56k

9 BST 7 SW 8 FB 5 PGOOD 6 C304 2n2

2 SW 3 FB 6 PG 5 C314 4u7 25V GND R312 22.0k 0.1%

POWER-GOOD BUFFERS
ECP5 inputs never load PG nets

6 EP 11 OUT 109 SNS 8 FB_PG 5 PG 4 U307 TPS7A9401 C362 1u 50V C359 10n +15VC358 10u 50V GND

9 BST 7 SW 8 FB 5 VCC 6 U305

9 BST 7 SW 8 FB 5 VCC 6 C327

VOUT = 150 uA x 16.7k = 2.505 V, +2V5: 50 mA design EN_UV = PG_3V3: ~5 ms ramp, after 3V3 and 1V1 SNS: Kelvin to the bead input

246 OUT 1 GND GND GND

+3V3_Q: 35 mA design UVLO on 29.8 V / off 27.3 V (124k / 5.36k)

Active low: low = rail good. >= 2.6 V vs the 150 uA ECP5

9 BST 7 SW 8 FB 5 VCC 6 U309

9 BST 7 SW 8 FB 5 VCC 6 C347

Always on with +5V: block D's ADCs are powered whenever the FPGA

drives them. +3V3_A: 15 mA design

7 OUT 1 FB 2 GND GND
PWR_FLAG

110 mA design, 190 mA fault; DNC (7) open

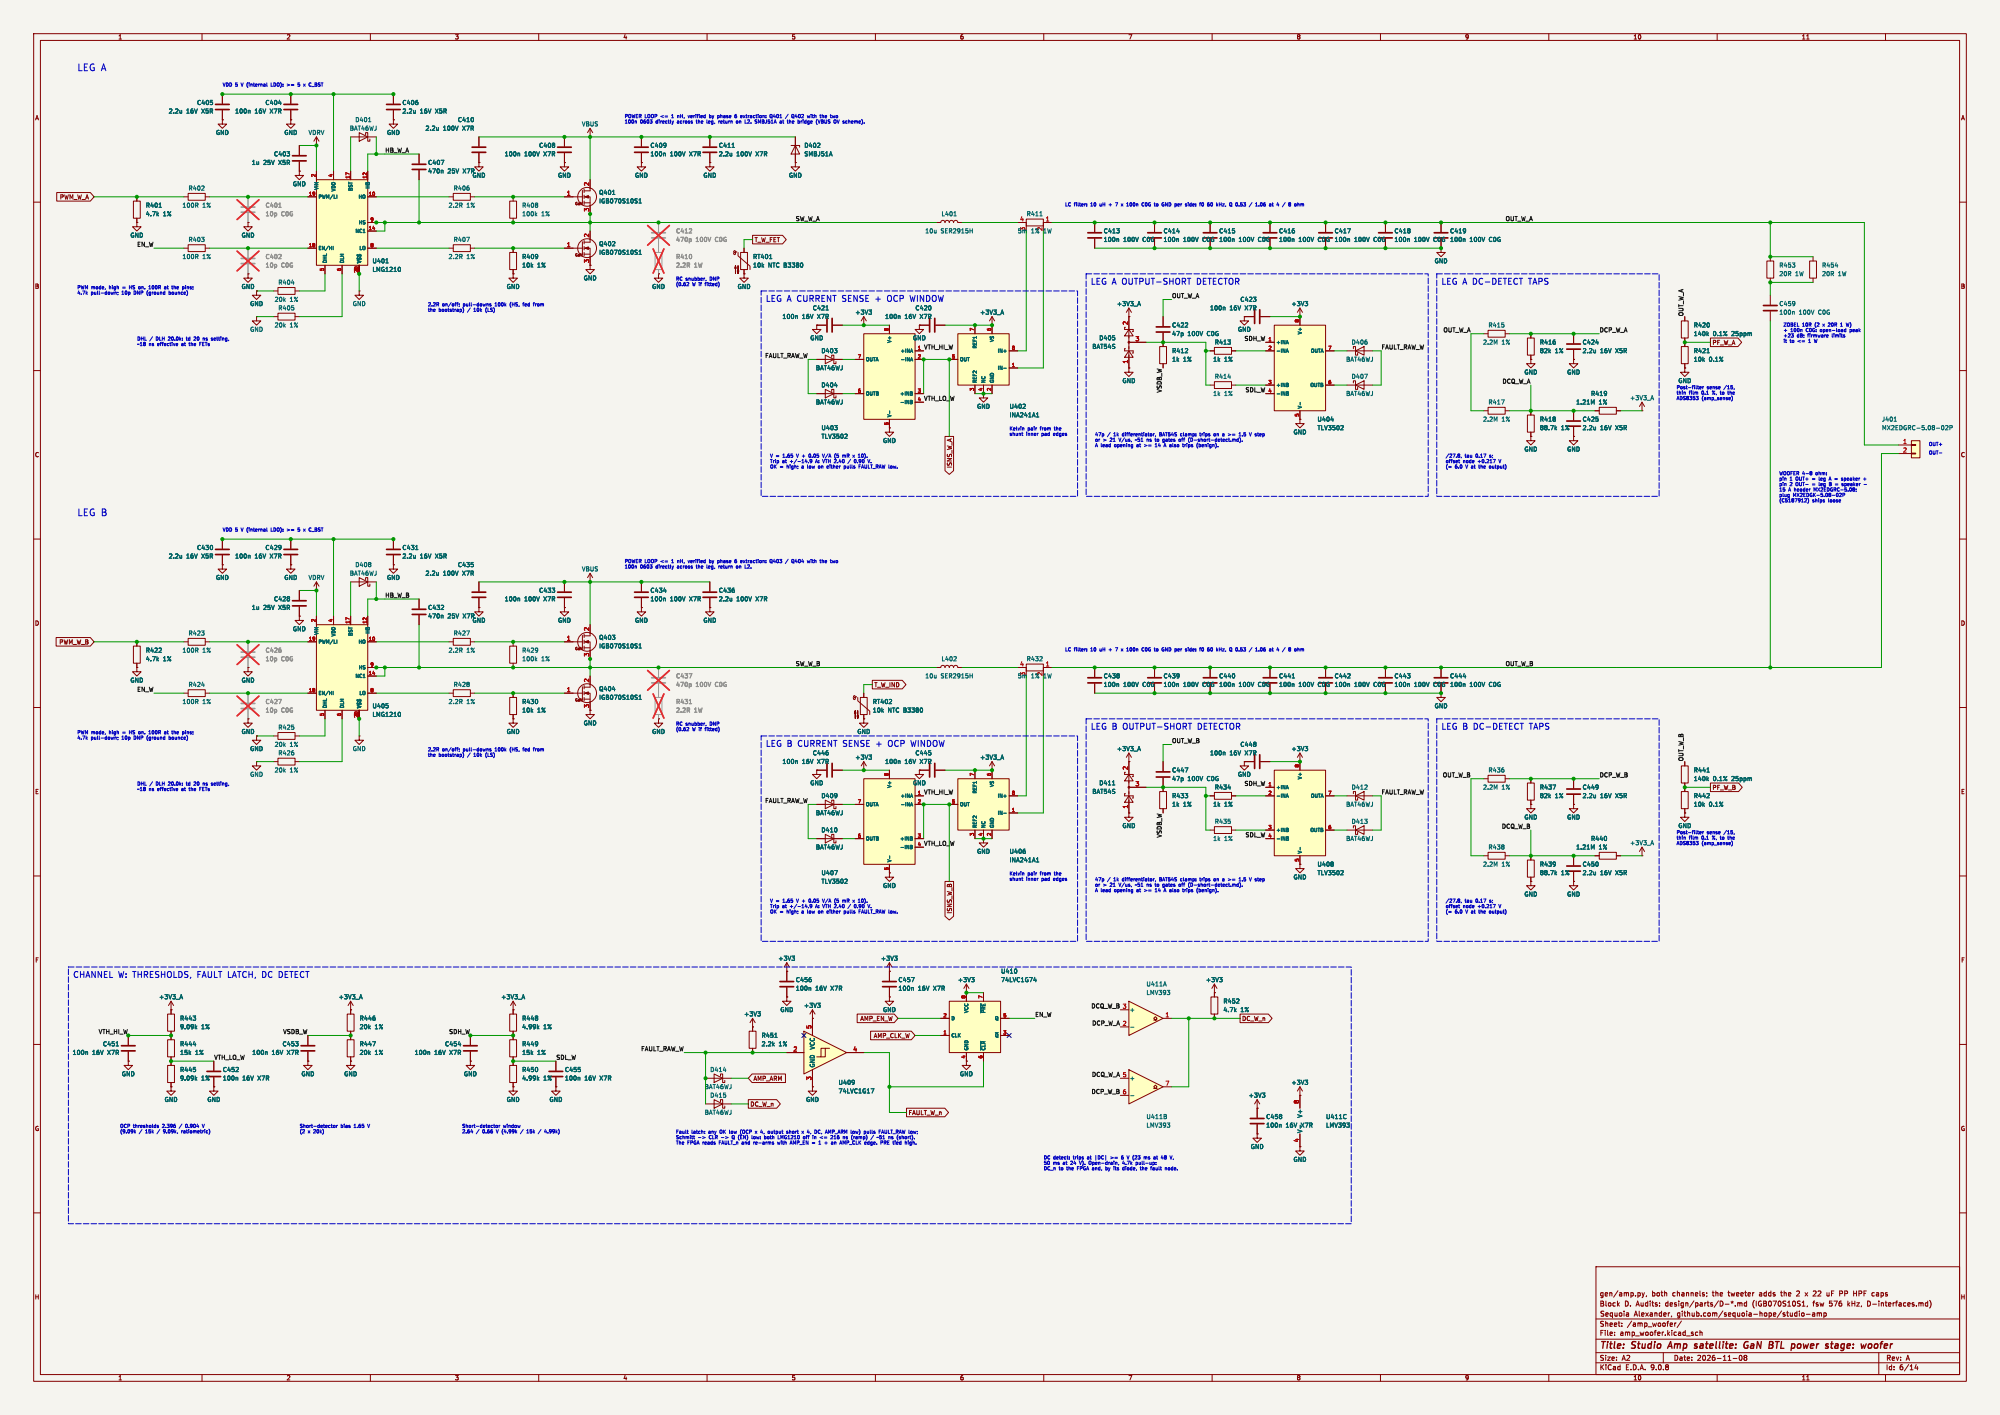
[picture p6: page 6]

OUT_W_A HB_W_A
PWM/LI 19 EN/HI 18 VIN

6 BST 17 VSS 2037 HB 12 HO 10 HS 9 NC1 14

LEG A OUTPUT-SHORT DETECTOR

LEG A DC-DETECT TAPS

LEG A CURRENT SENSE + OCP WINDOW

GND
thin film 0.1 %, to the ADS8353 (amp_sense)

Kelvin pair from the
shunt inner pad edges

or > 21 V/us, ~51 ns to gates off (D-short-detect.md). A lead opening at >= 14 A also trips (benign).

(= 6.0 V at the output) LEG B OUTPUT-SHORT DETECTOR

pin 2 OUT- = leg B = speaker - 15 A header MX2EDGRC-5.08; plug MX2EDGK-5.08-02P

LEG B DC-DETECT TAPS

LEG B CURRENT SENSE + OCP WINDOW

8 V- 5 OUTA 7 OUTB 6 U407 TLV3502 +3V3 D409 BAT46WJ GND GND
D409 BAT46WJ D410 BAT46WJ U407 TLV3502

CHANNEL W: THRESHOLDS, FAULT LATCH, DC DETECT

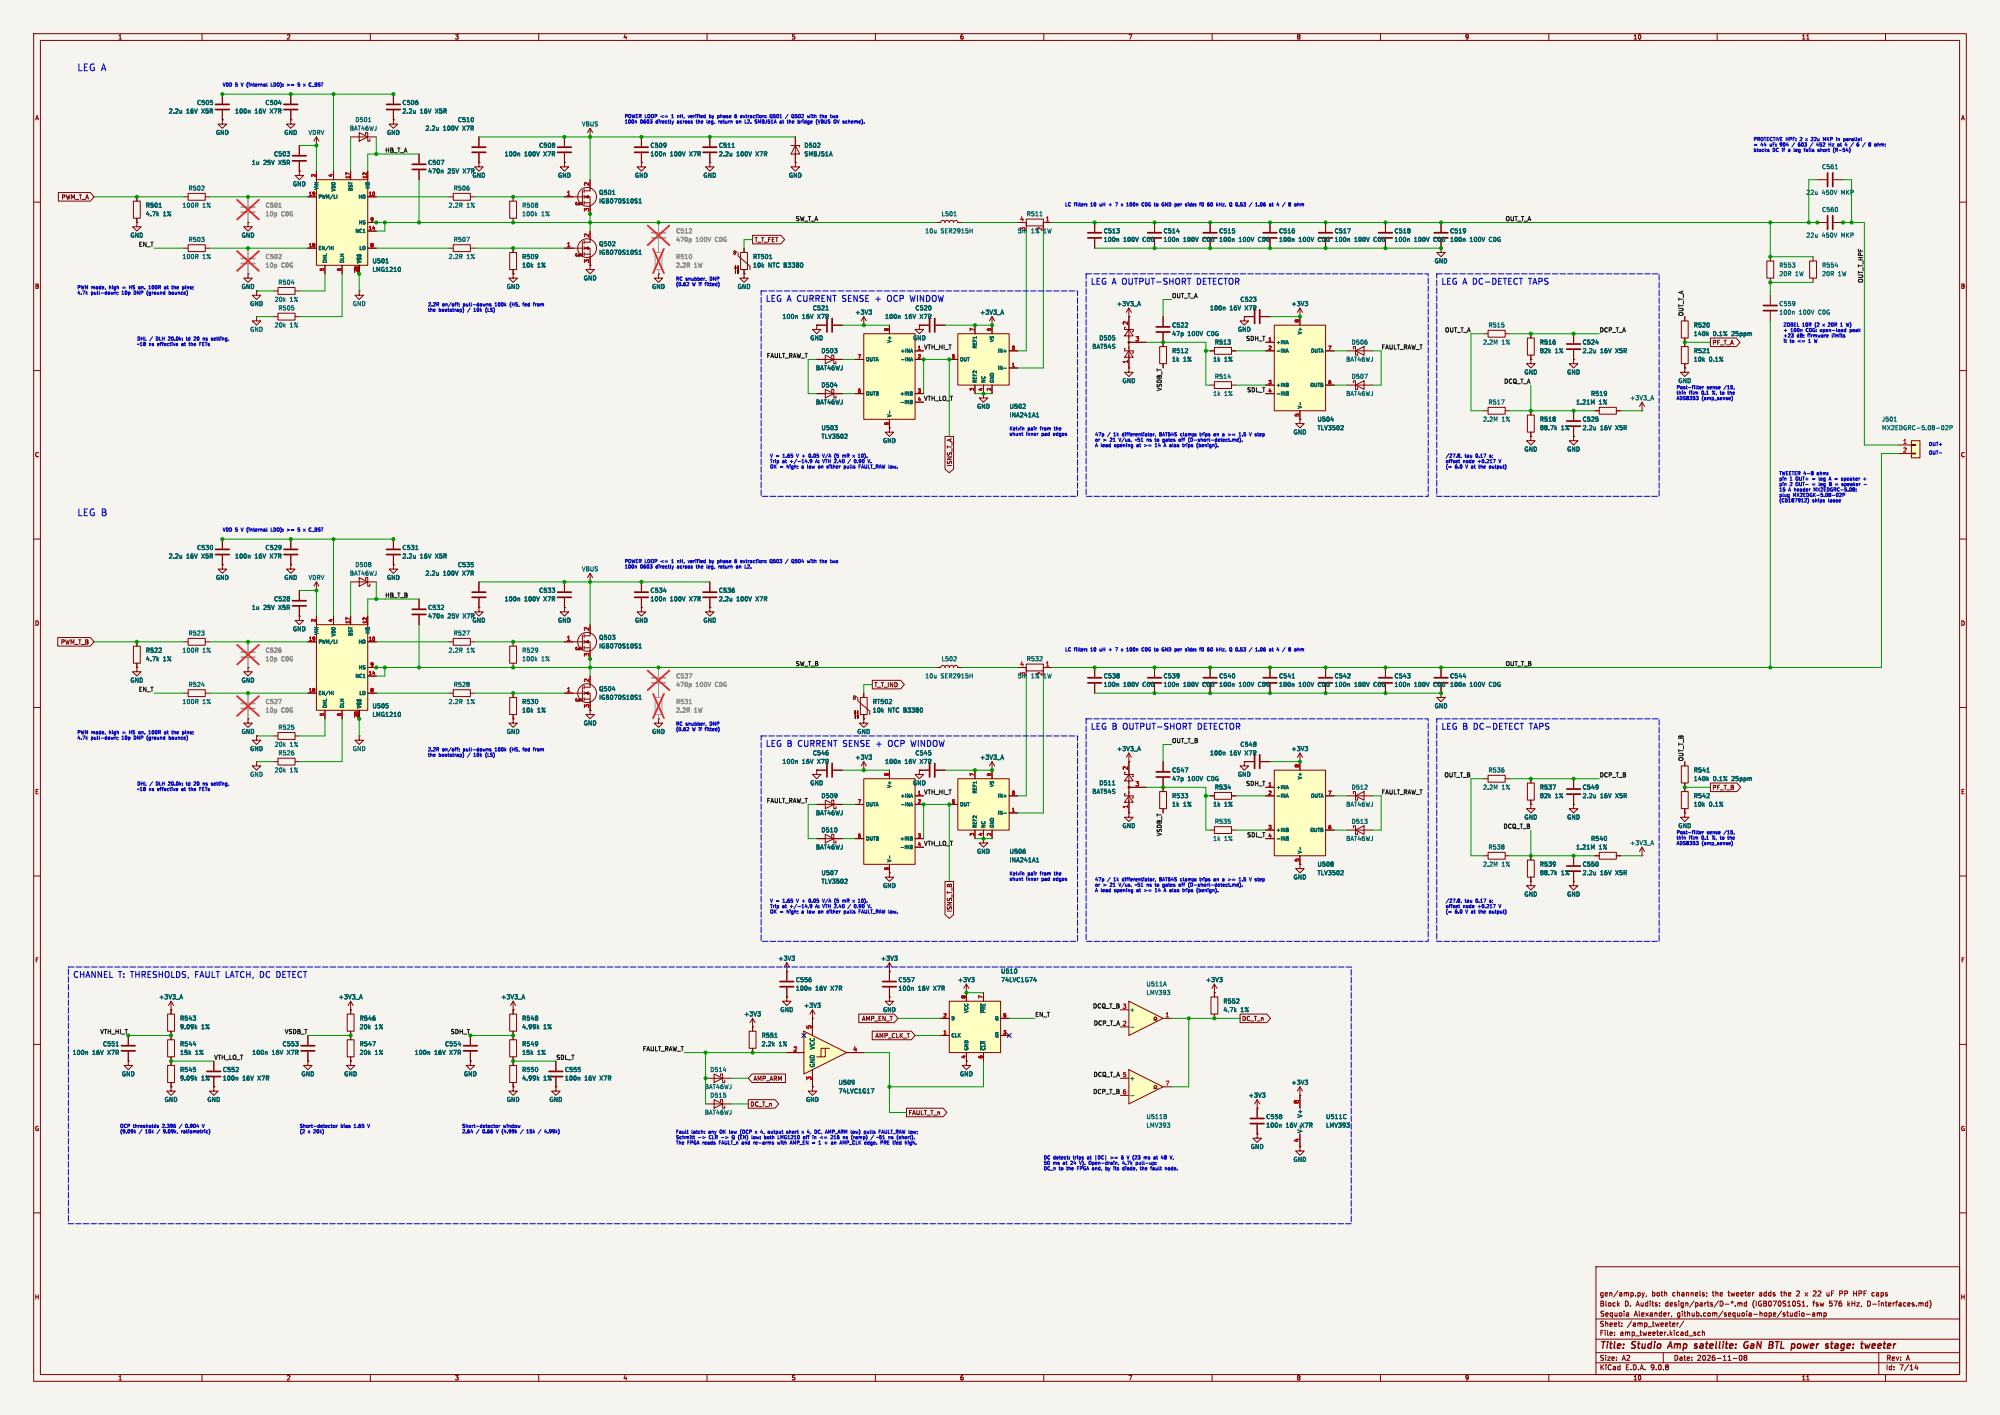
[picture p7: page 7]

PROTECTIVE HPF: 2 x 22u MKP in parallel = 44 uF: 904 / 603 / 452 Hz at 4 / 6 / 8 ohm; blocks DC if a leg fails short (R-54)

PWM/LI 19 EN/HI 18 VIN

6 BST 17 VSS 2037 HB 12 HO 10 HS 9 NC1 14

LEG A DC-DETECT TAPS

LEG A CURRENT SENSE + OCP WINDOW

thin film 0.1 %, to the ADS8353 (amp_sense) LEG B CURRENT SENSE + OCP WINDOW

Kelvin pair from the

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

LEG B DC-DETECT TAPS

thin film 0.1 %, to the ADS8353 (amp_sense)

shunt inner pad edges

CHANNEL T: THRESHOLDS, FAULT LATCH, DC DETECT

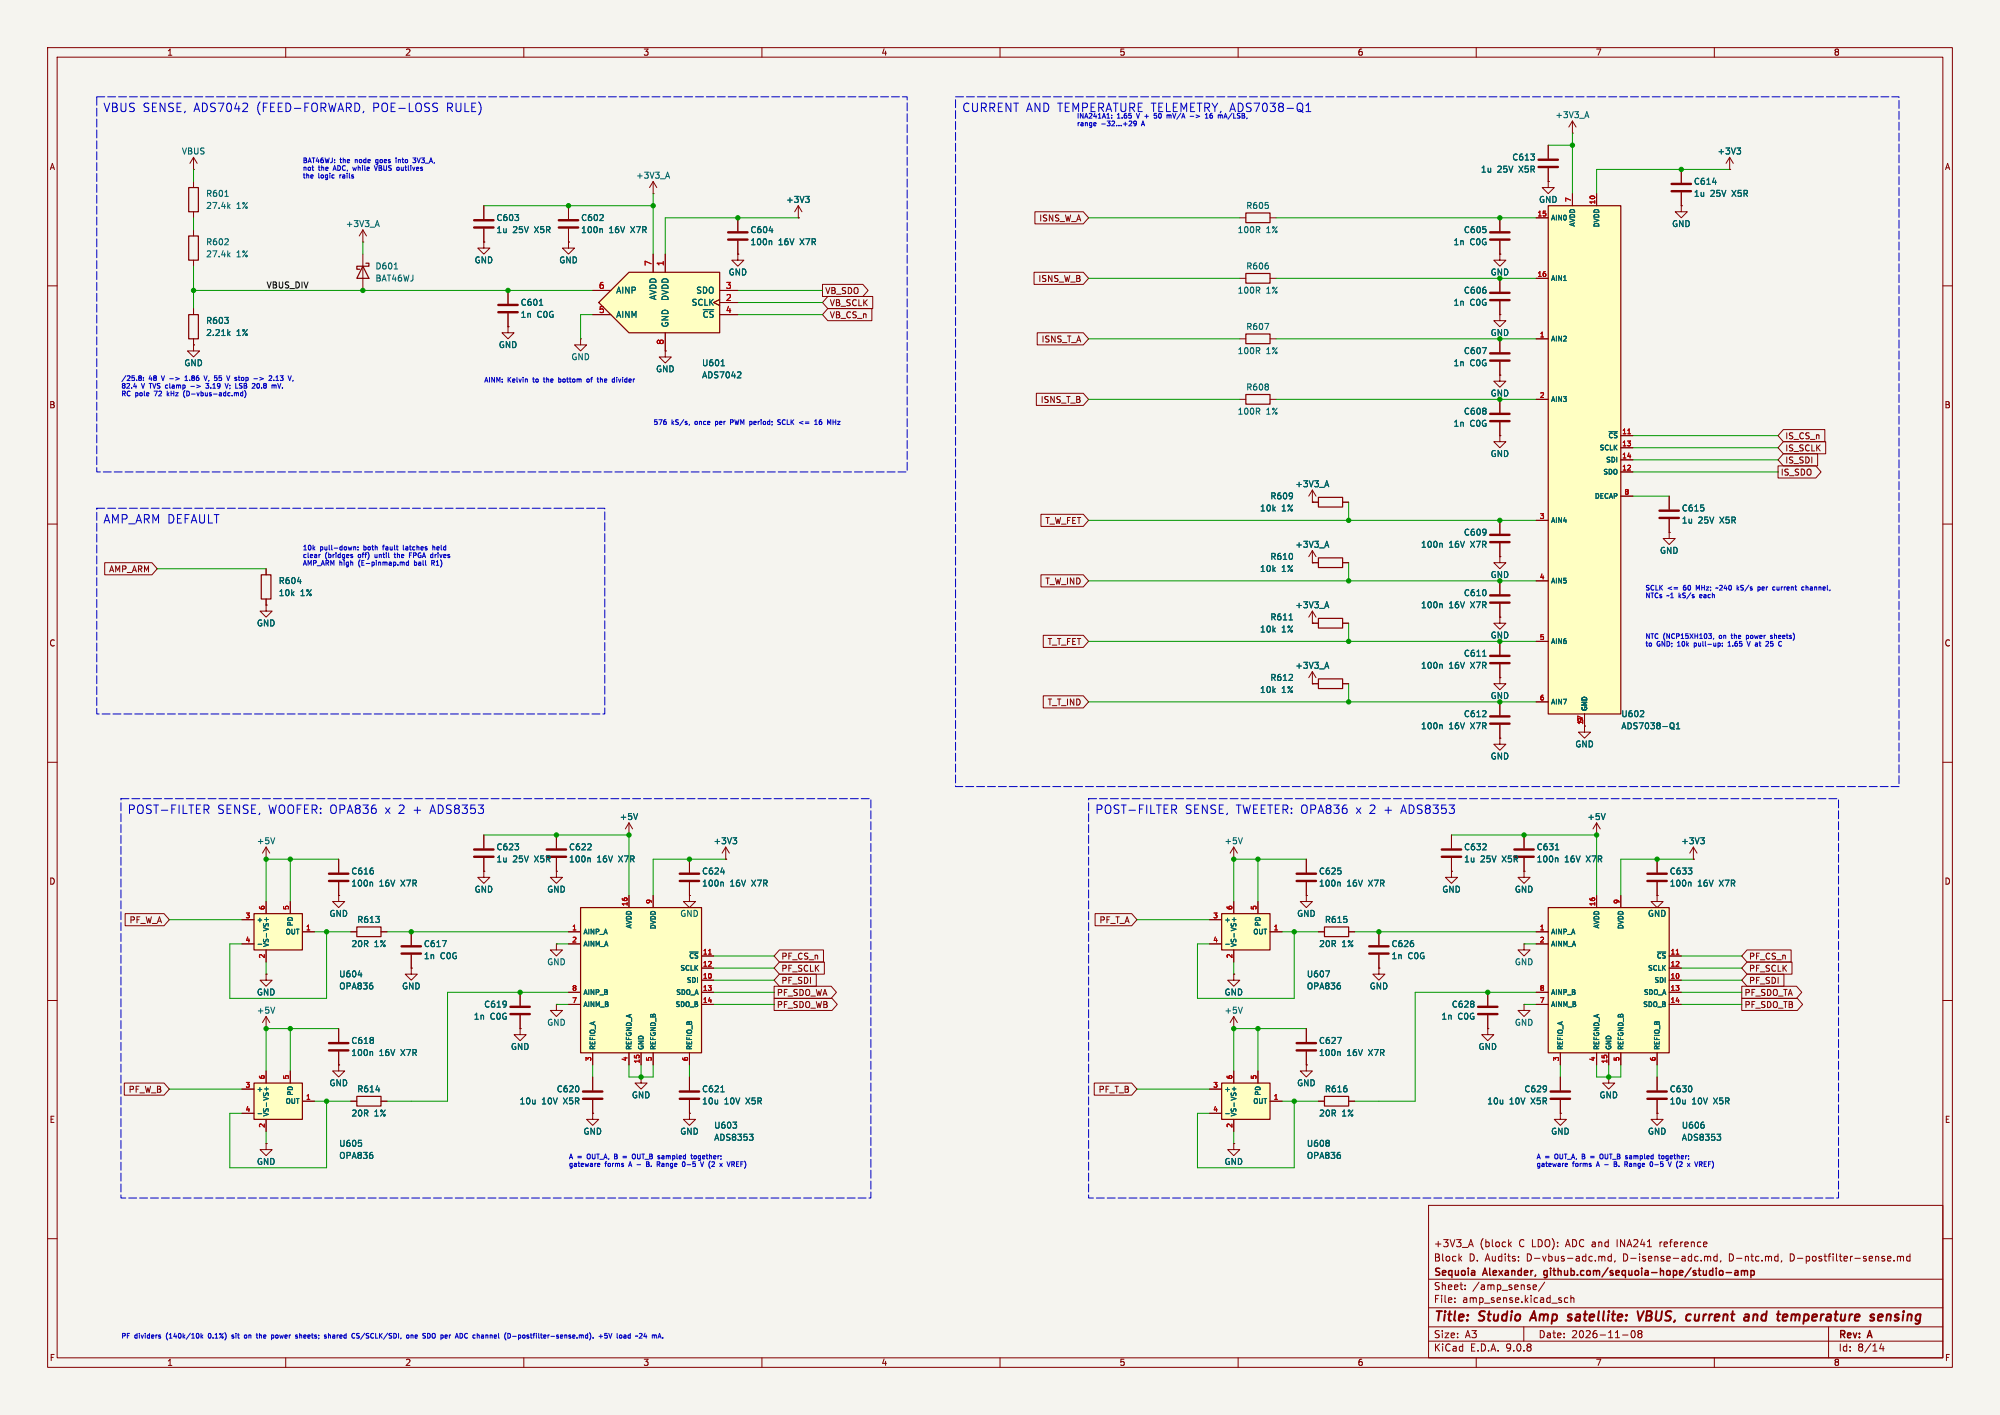
[picture p8: page 8]

7 GND 179 DVDD 10 ~{CS}11 SCLK 13 SDI 14 SDO 12 DECAP 8 C613

BAT46WJ: the node goes into 3V3_A, not the ADC, while VBUS outlives

7 GND 179 DVDD 10 ~{CS}11 SCLK 13 SDI 14 SDO 12 DECAP 8U602 ADS7038-Q1 GND

8 SDO 3 SCLK 2 ~{CS}4 U601 ADS7042 GND

8 SDO 3 SCLK 2 ~{CS}4 GND

AINM: Kelvin to the bottom of the divider

POST-FILTER SENSE, WOOFER: OPA836 x 2 + ADS8353

6 ~{CS}11 SCLK 12 SDI 10 SDO_A 13 SDO_B 14 U606 ADS8353 GND

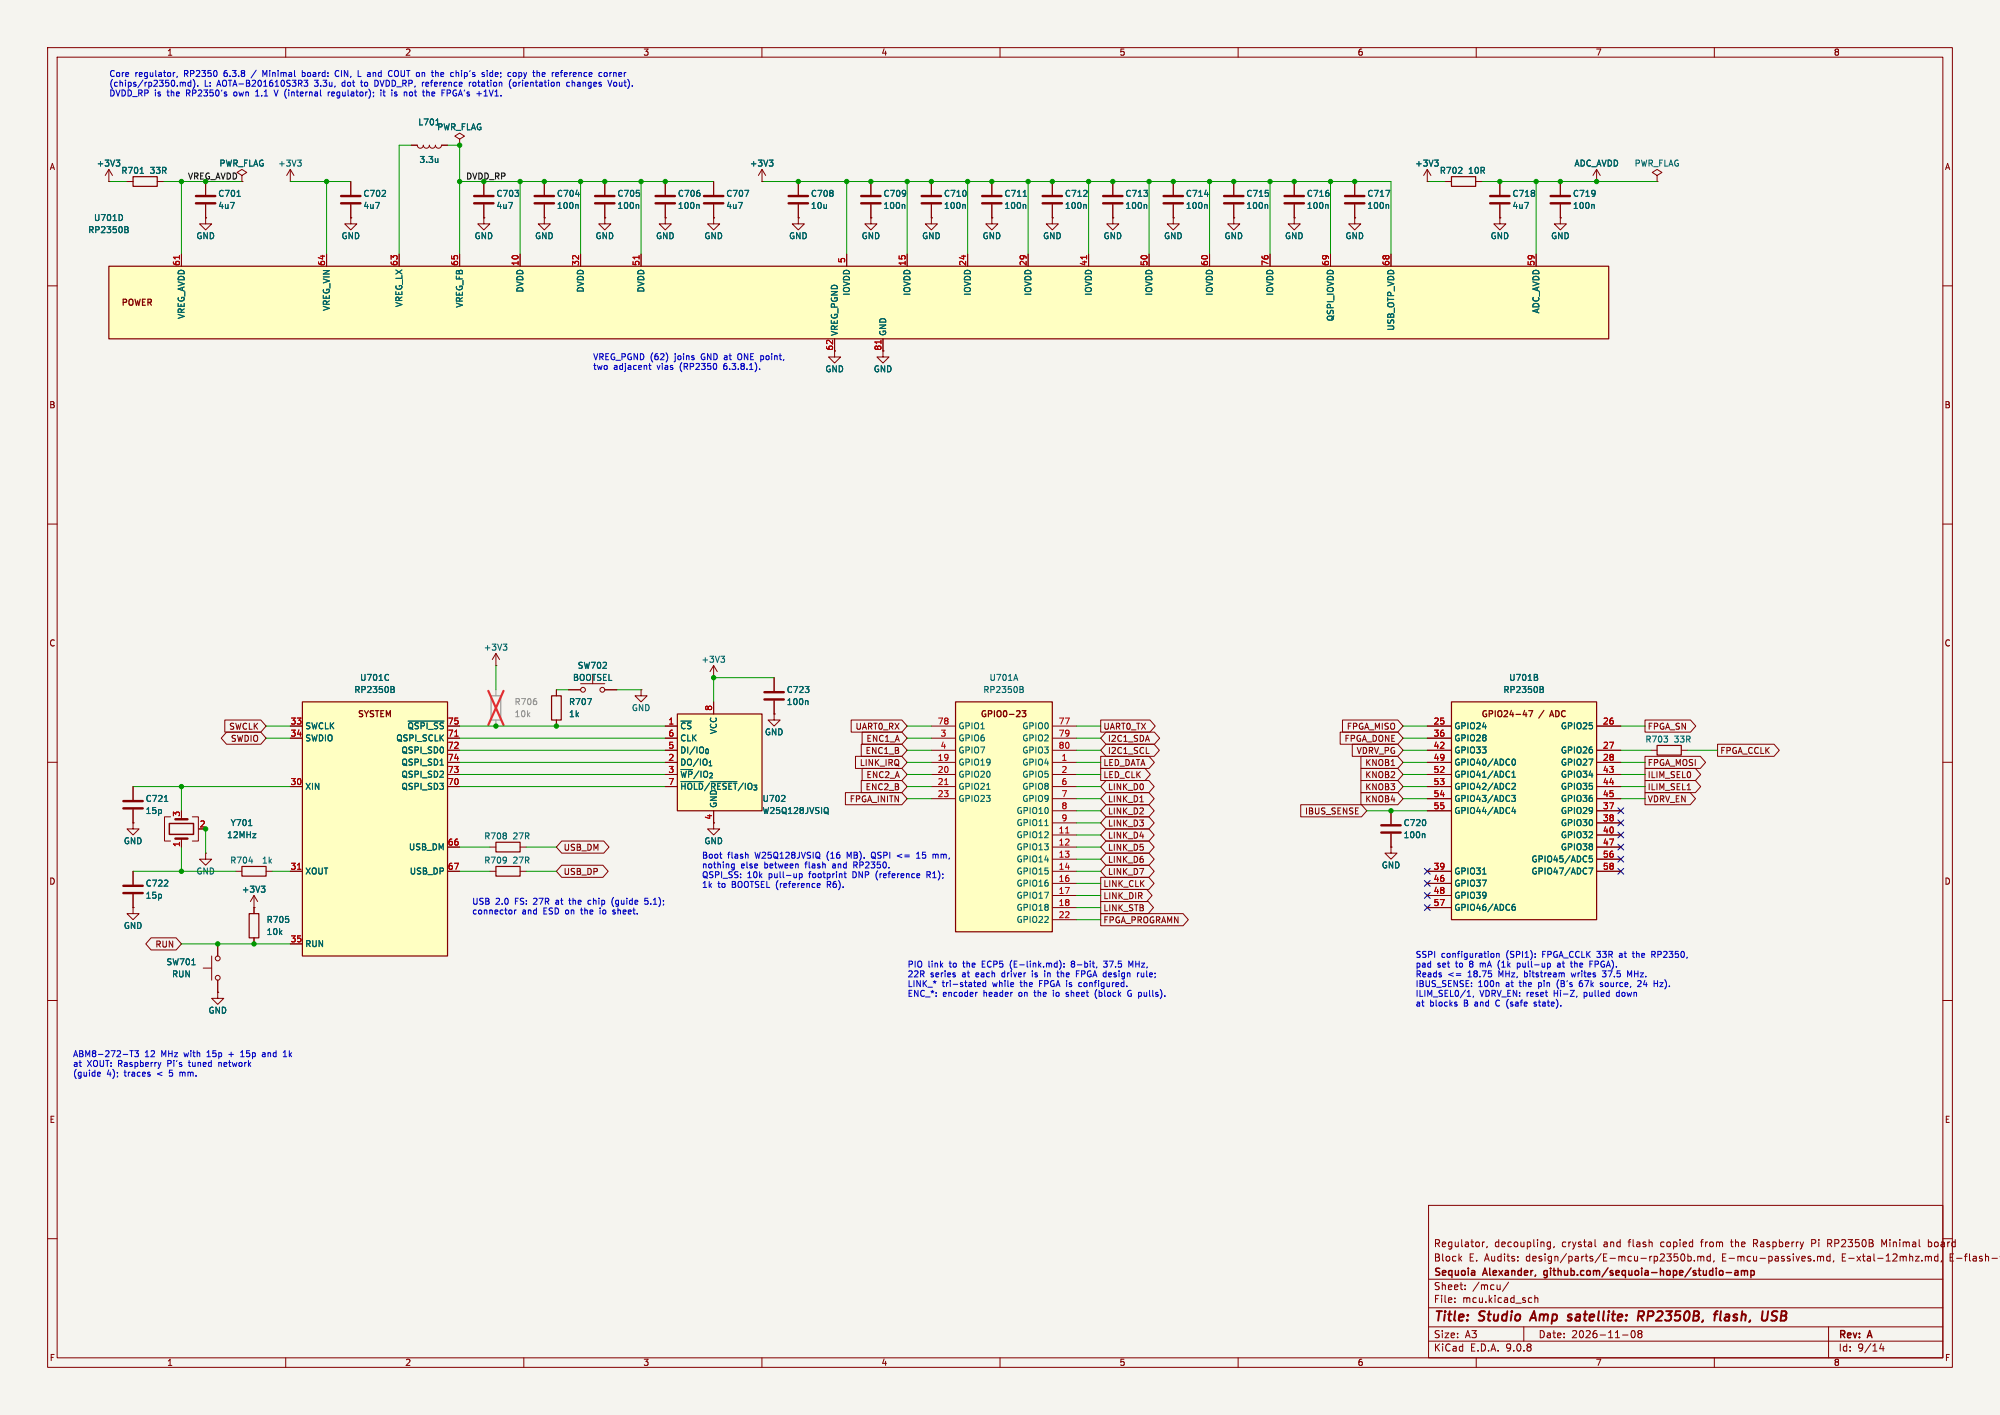
[picture p9: page 9]

5 GND 81 IOVDD 15 IOVDD 24 IOVDD 29 IOVDD 41 IOVDD 50 IOVDD 60 IOVDD 76 QSPI_IOVDD 69 USB_OTP_VDD 68 ADC_AVDD 59

IBUS_SENSE: 100n at the pin (B's 67k source, 24 Hz).

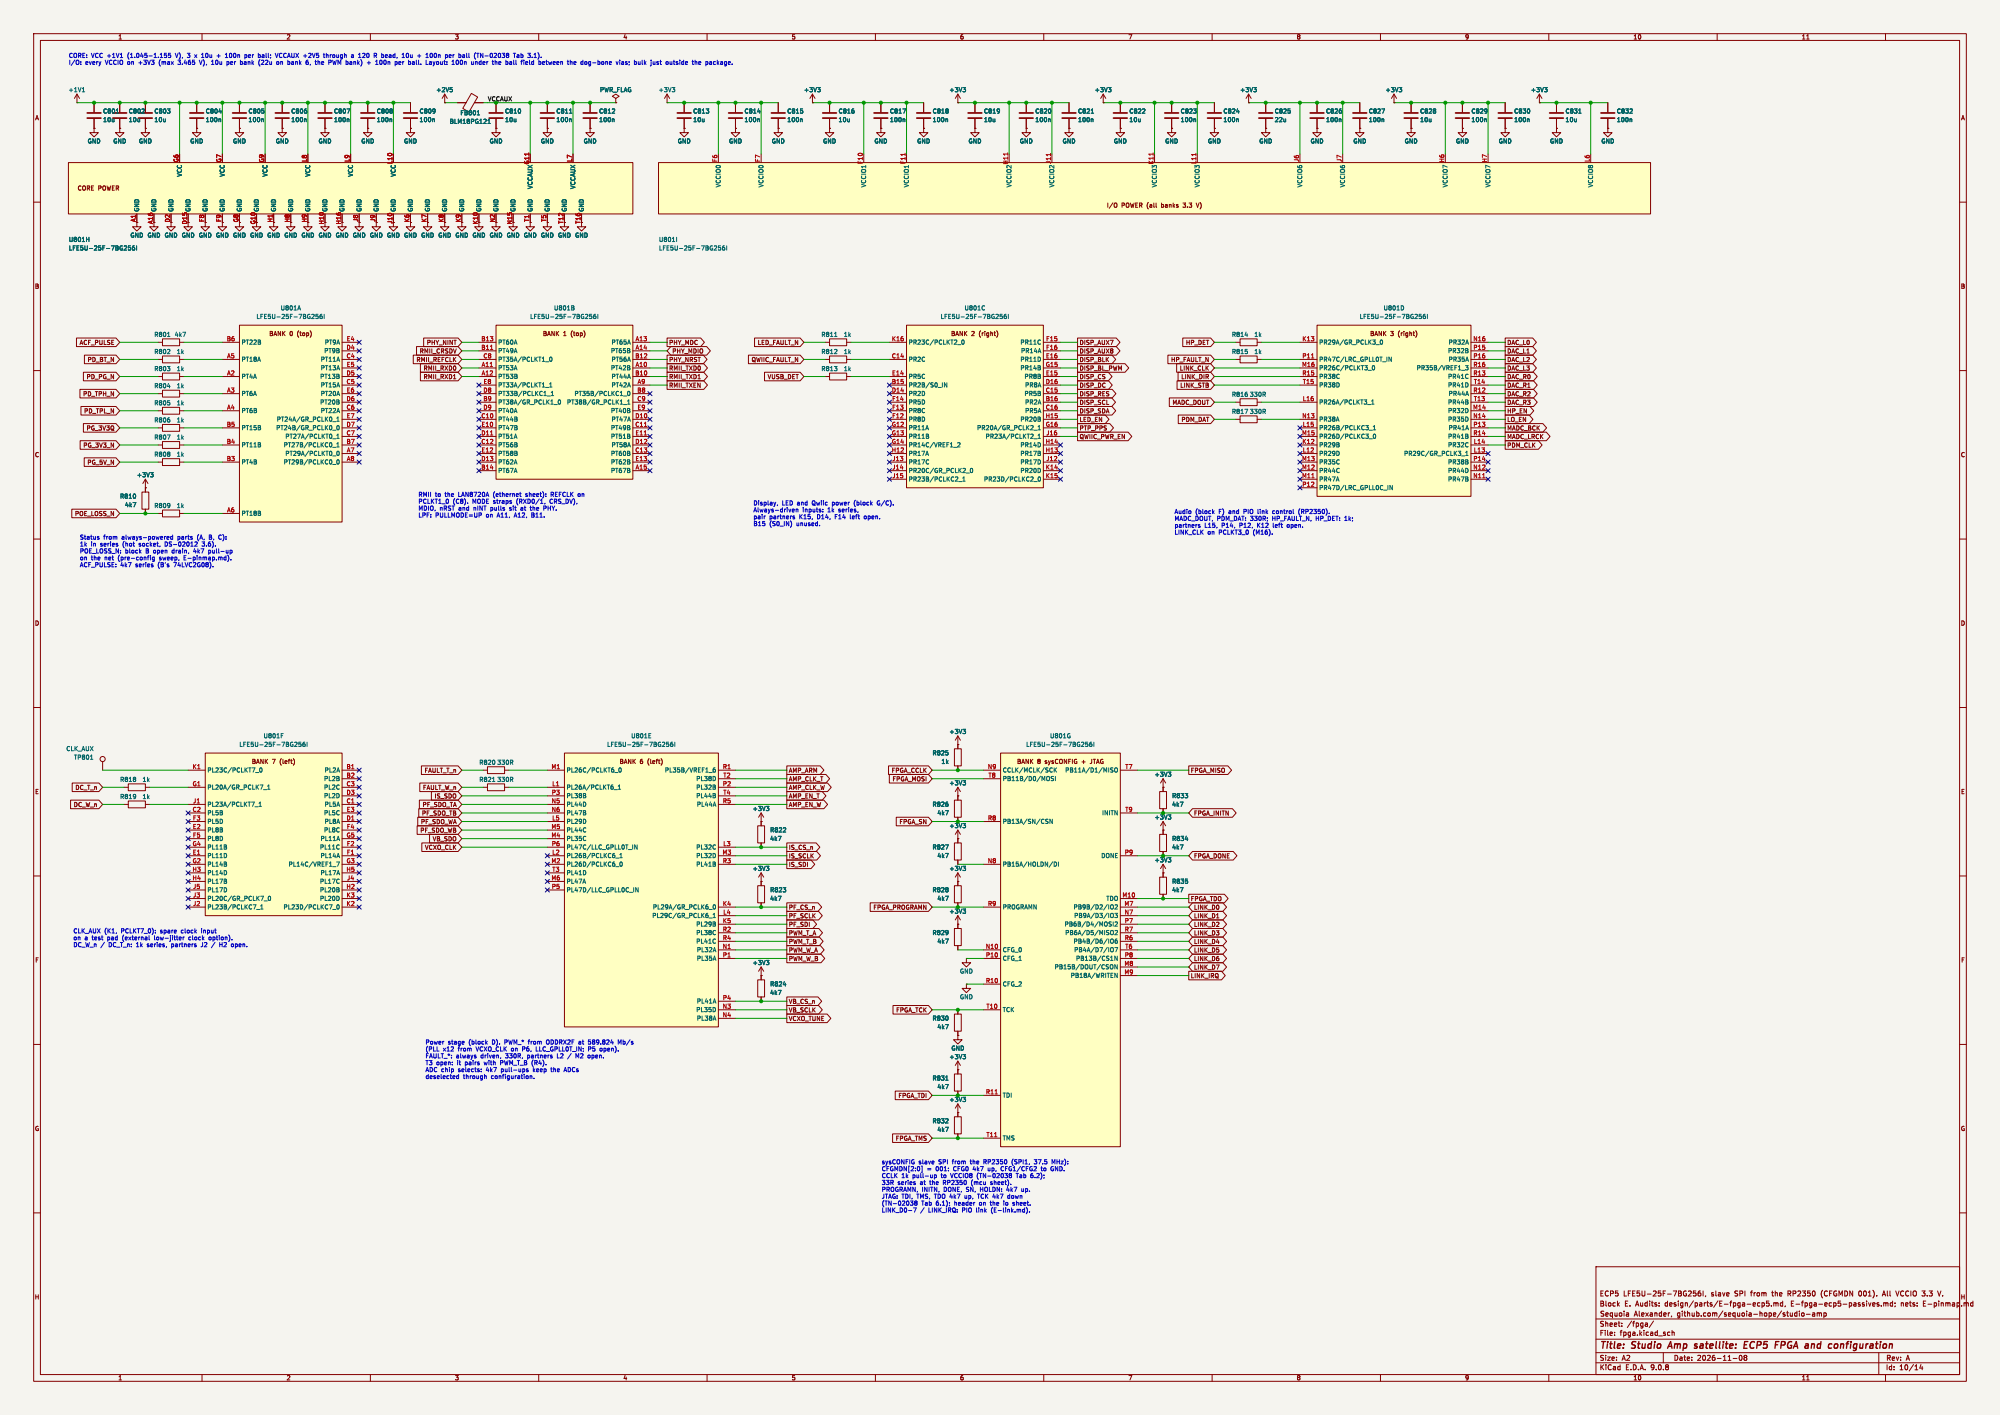
[picture p10: page 10]

100n GND GND GND GND GND GND GND

10u GND GND GND GND GND GND

4k7 +3V3 +3V3GND
CCLK/MCLK/SCK N9 PB11B/D0/MOSI T8 PB13A/SN/CSN R8 PB15A/HOLDN/DI N8 PROGRAMN R9 CFG_0 N10 CFG_1 P10 CFG_2 R10 TCK T10 TDI R11 TMS T11

File: fpga.kicad_sch Sheet: /fpga/

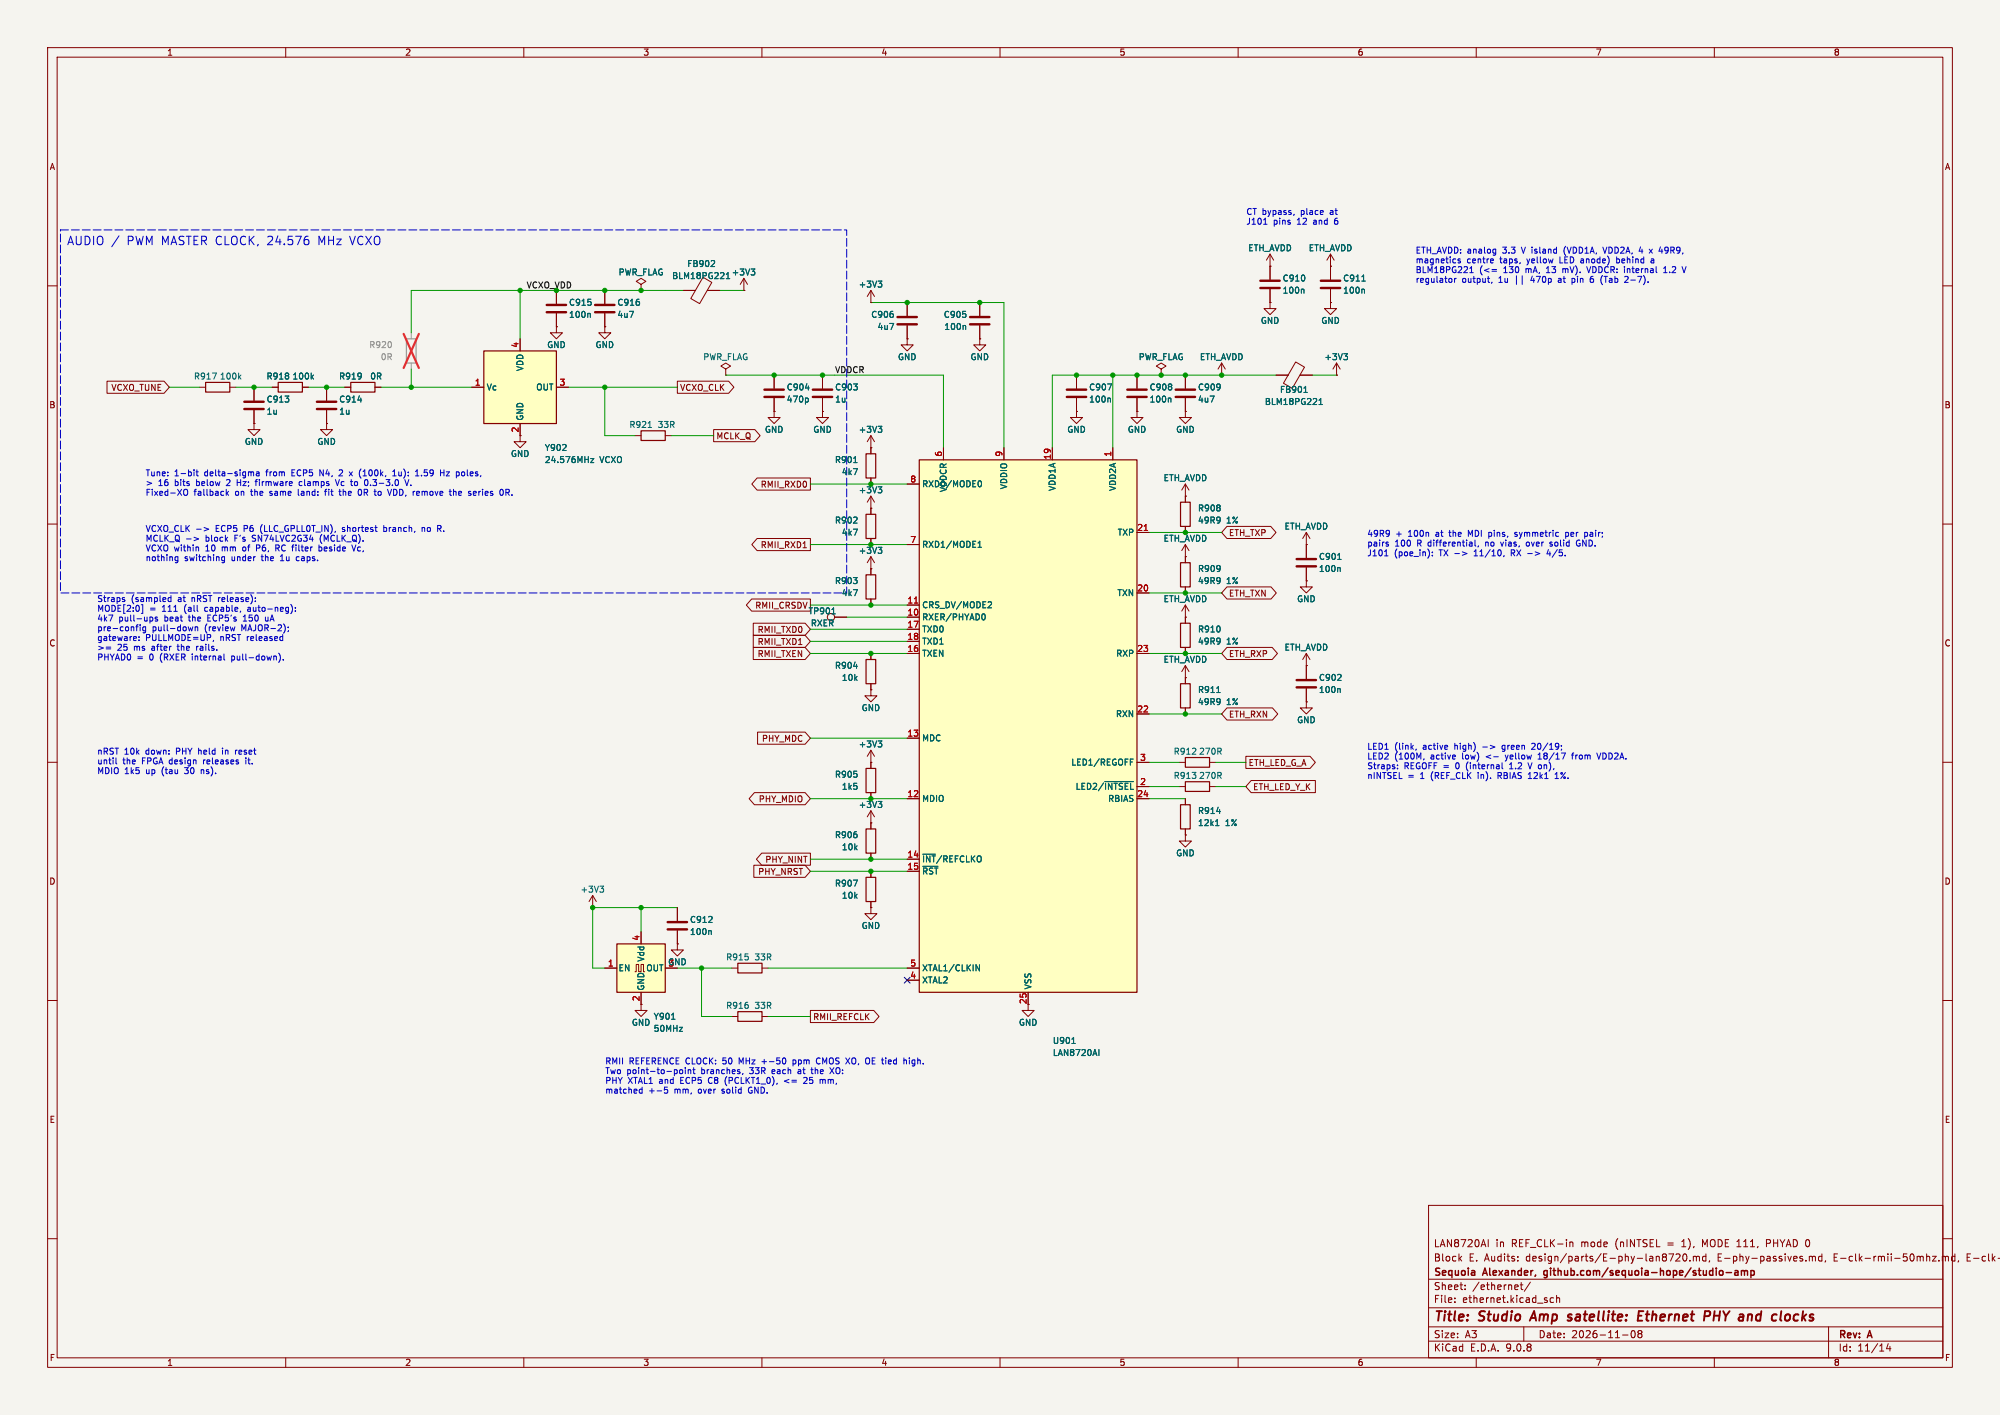
[picture p11: page 11]

1 TXP 21 TXN 20 RXP 23 RXN 22

nRST 10k down: PHY held in reset until the FPGA design releases it. MDIO 1k5 up (tau 30 ns).

2 OUT GND 3 GND GND

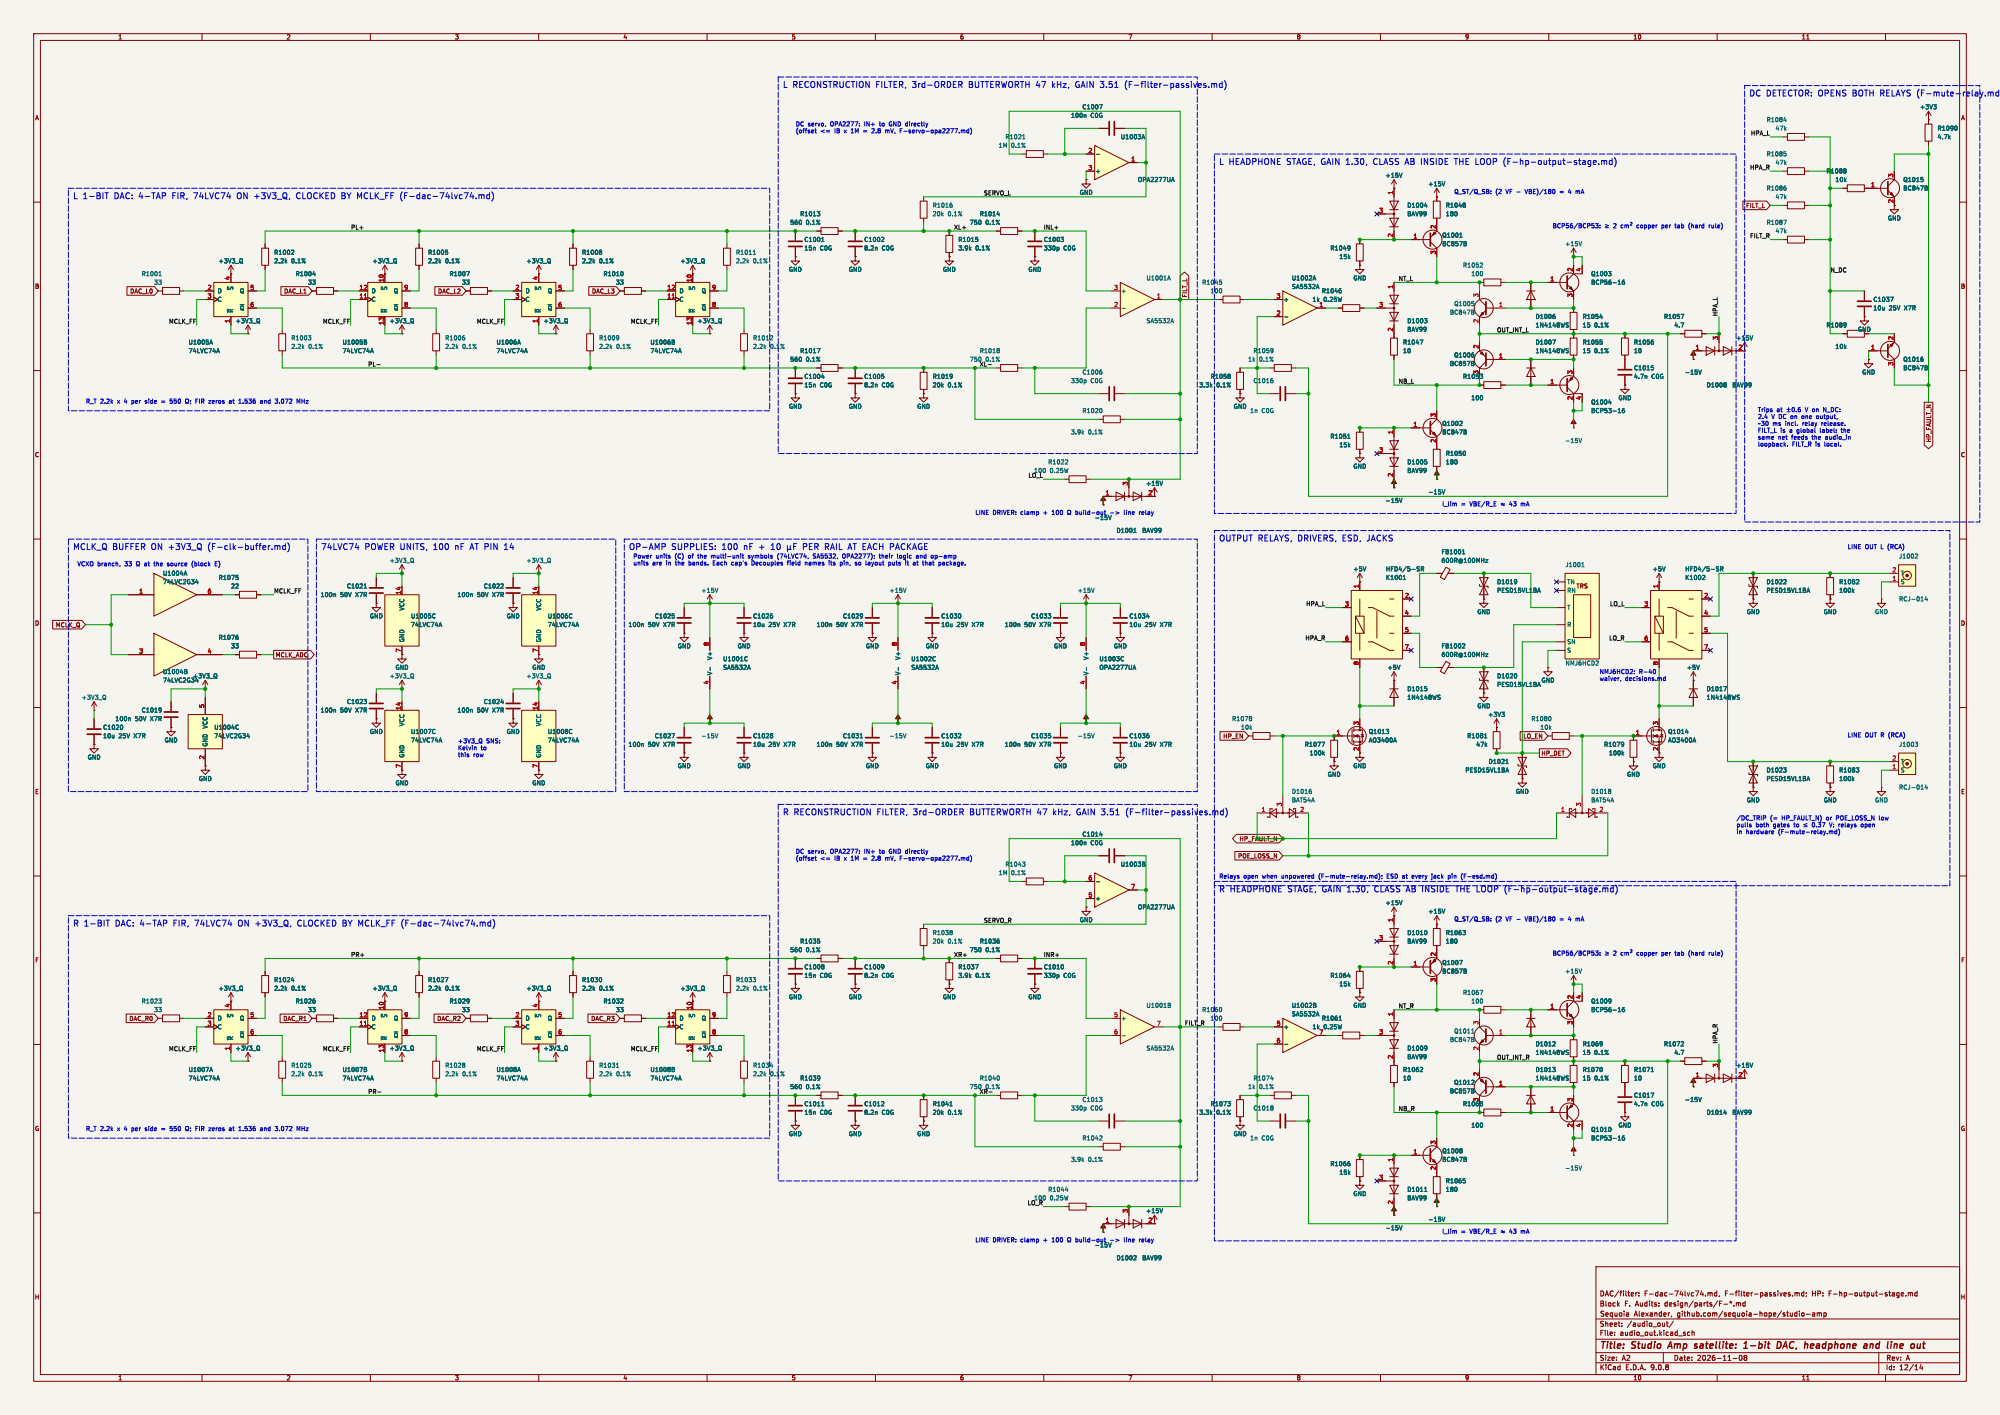
[picture p12: page 12]

DC servo, OPA2277: IN+ to GND directly

L 1-BIT DAC: 4-TAP FIR, 74LVC74 ON +3V3_Q, CLOCKED BY MCLK_FF (F-dac-74lvc74.md)

Trips at þÿ±0.6V on N_DC: 2.4 V DC on one output, ~30 ms incl. relay release. FILT_L is a global label: the

same net feeds the audio_in

OUTPUT RELAYS, DRIVERS, ESD, JACKS

MCLK_Q BUFFER ON +3V3_Q (F-clk-buffer.md)

74LVC74 POWER UNITS, 100 nF AT PIN 14

LINE OUT L (RCA) DC servo, OPA2277: IN+ to GND directly

8 V- 4 GND GND GND GND

/DC_TRIP (= HP_FAULT_N) or POE_LOSS_N low
pulls both gates to þÿ"d0.37 V: relays open
in hardware (F-mute-relay.md)

R HEADPHONE STAGE, GAIN 1.30, CLASS AB INSIDE THE LOOP (F-hp-output-stage.md)

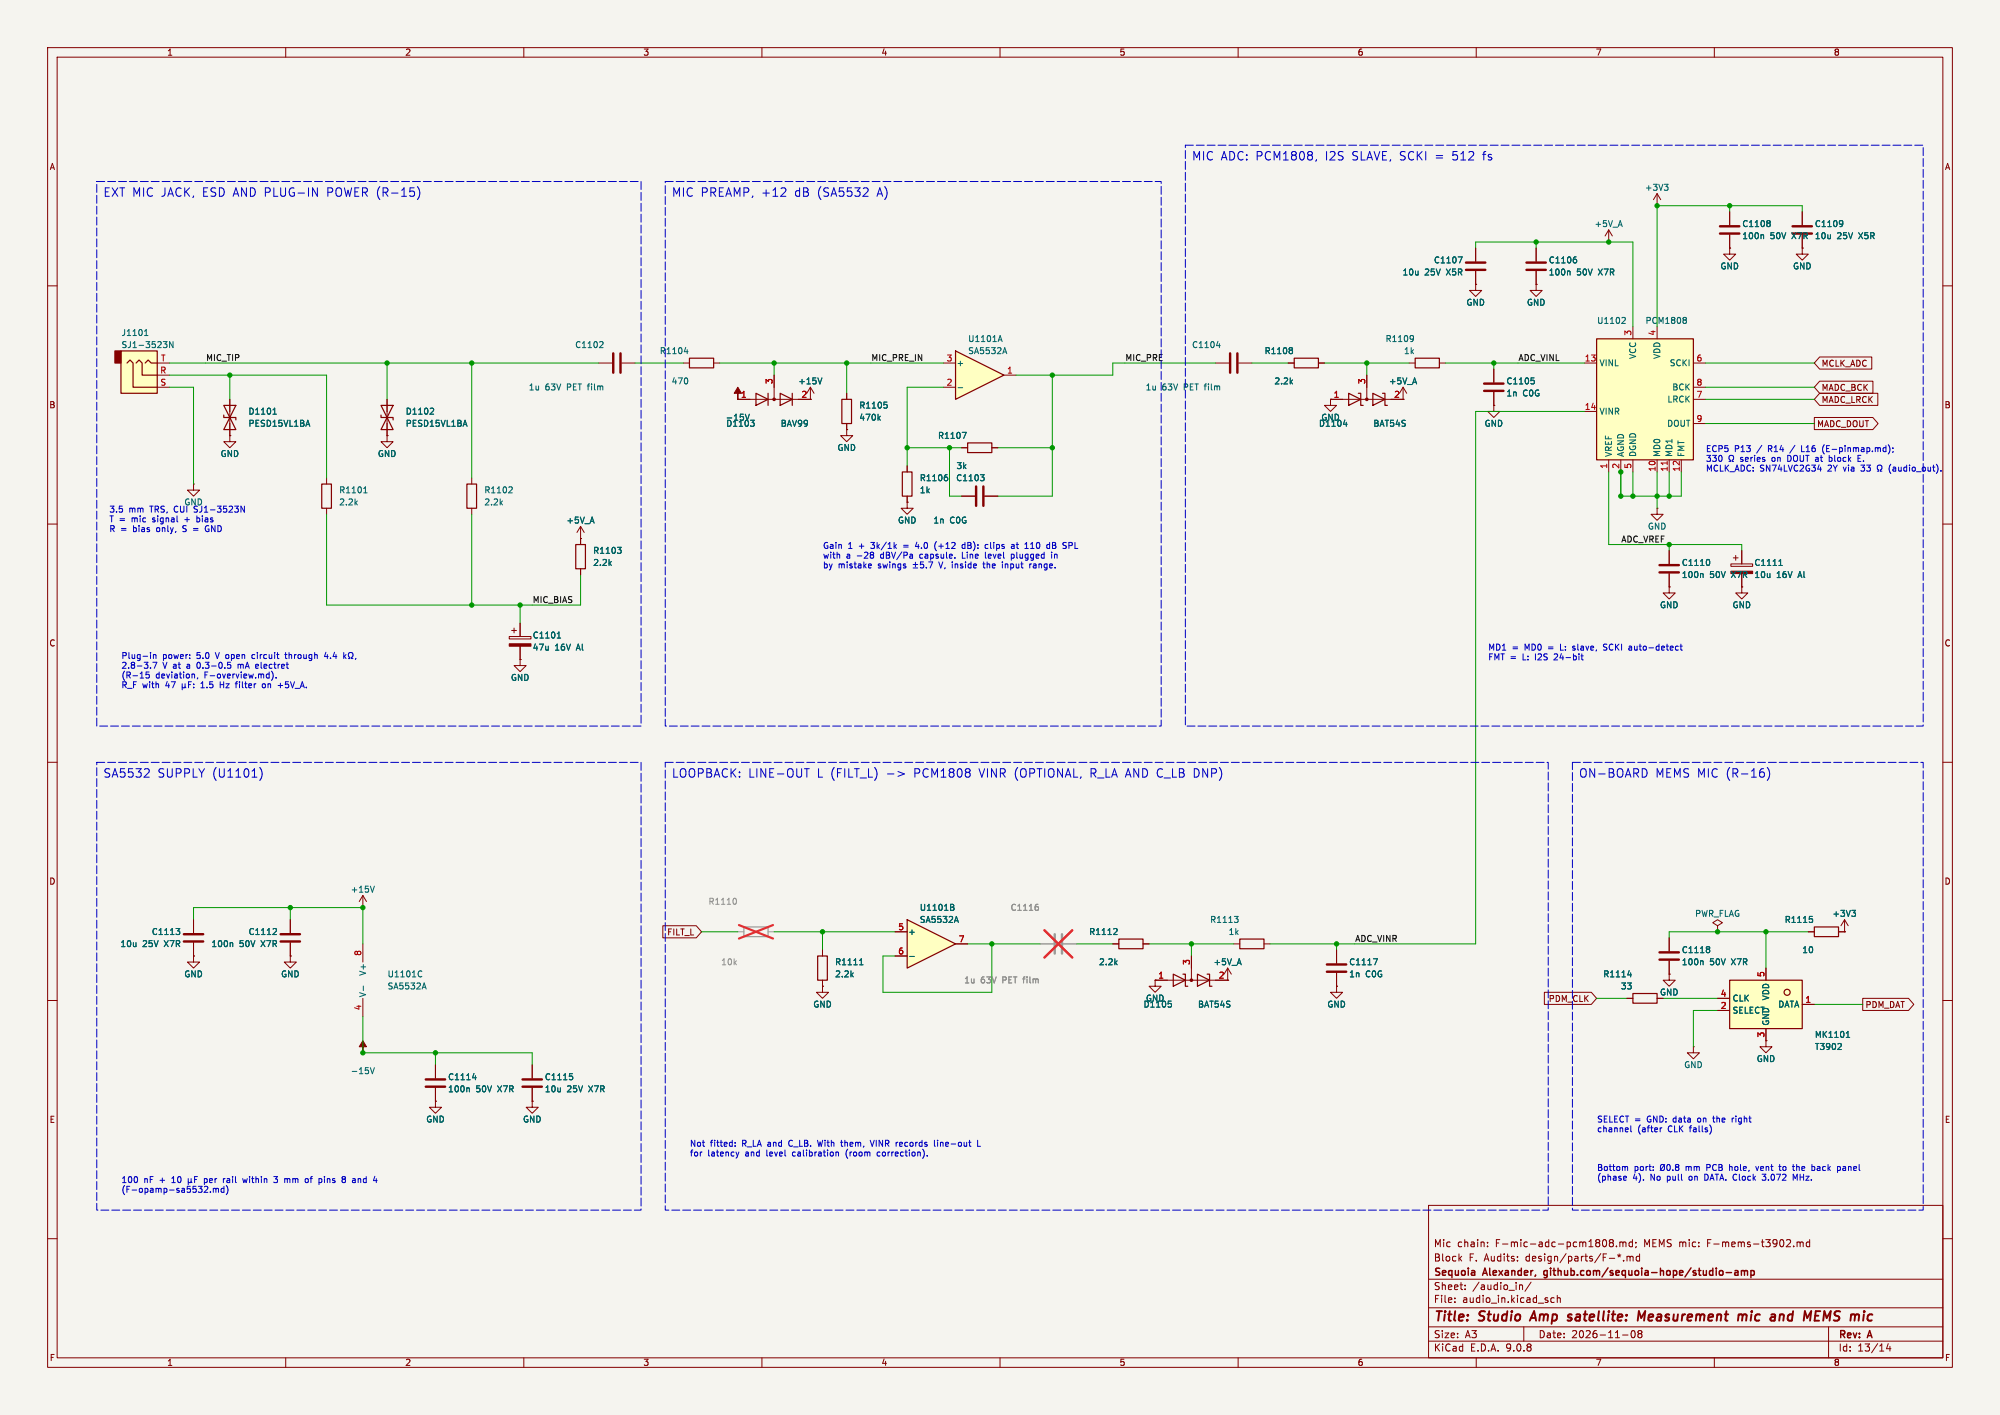
[picture p13: page 13]

MIC ADC: PCM1808, I2S SLAVE, SCKI = 512 fs
+3V3GND GND

ECP5 P13 / R14 / L16 (E-pinmap.md); 330 þÿ©series on DOUT at block E. MCLK_ADC: SN74LVC2G34 2Y via 33 þÿ©(audio_out).

SA5532 SUPPLY (U1101) 3.5 mm TRS, CUI SJ1-3523N

100 nF + 10 þÿµFper rail within 3 mm of pins 8 and 4
(F-opamp-sa5532.md)

Bottom port: þÿØ0.8mm PCB hole, vent to the back panel
(phase 4). No pull on DATA. Clock 3.072 MHz.

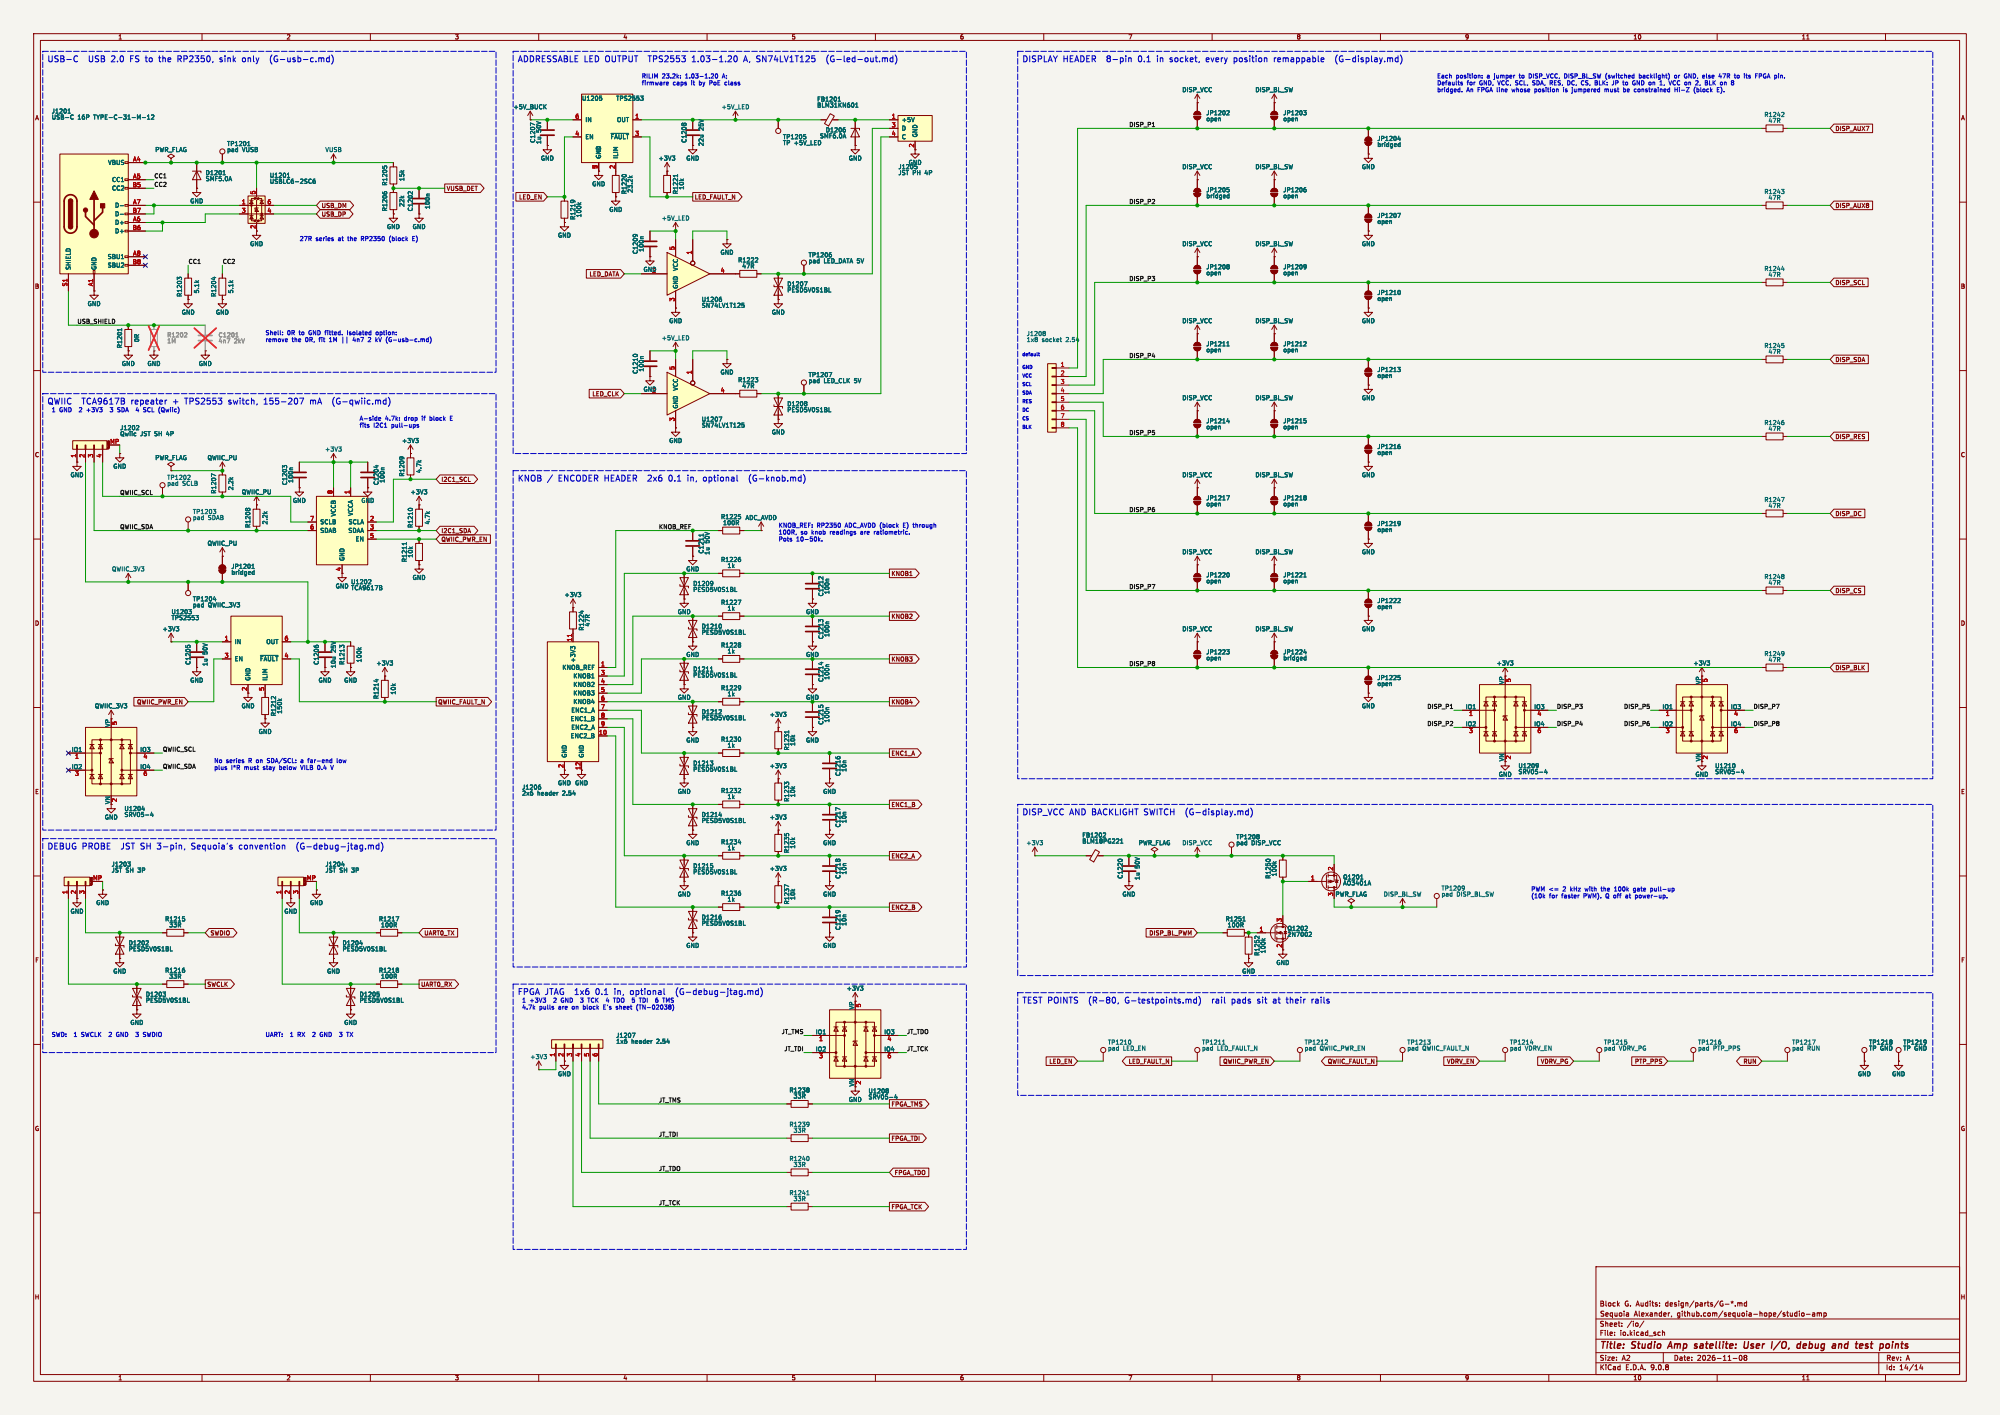
[picture p14: page 14]

2 OUT 1 ~{FAULT}3 U1205 TPS2553 C1219 10n GND C1216 10n GND

2 OUT 1 ~{FAULT}3 TP1205 TP +5V_LED C1211 1u 50V GND R1224 47R

27R series at the RP2350 (block E)

J1202 Qwiic JST SH 4P GND

SCLA 2 SDAA 3 EN 5 VCCA

8 SCLB 7 SDAB 6 GND R1214 10k R1213 100k GND

1 GND

DISP_VCC AND BACKLIGHT SWITCH (G-display.md)

PWM <= 2 kHz with the 100k gate pull-up
(10k for faster PWM). Q off at power-up.

4.7k pulls are on block E's sheet (TN-02038)
