sequoia-hope/studio-amp/hw/satellite/a/satellite.kicad_pcb

## KiCad design hw/satellite/a/satellite.kicad_pcb (2026-11-08)

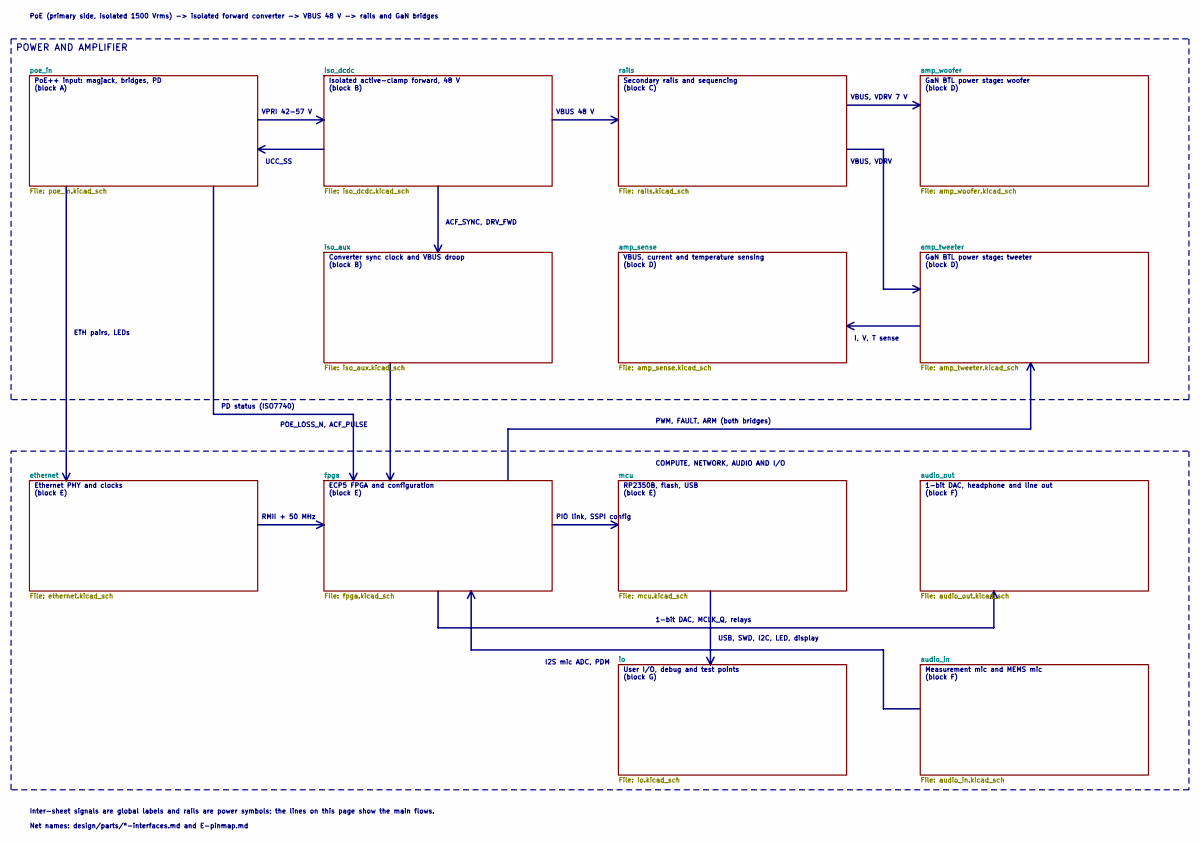
[picture p15: schematic satellite.kicad_sch, Studio Amp satellite, variant A]

Notes on the sheet:
PoE++ input: magjack, bridges, PD (block A)
Isolated active-clamp forward, 48 V (block B)
Converter sync clock and VBUS droop (block B)
Secondary rails and sequencing (block C)
GaN BTL power stage: woofer (block D)
GaN BTL power stage: tweeter (block D)
VBUS, current and temperature sensing (block D)
RP2350B, flash, USB (block E)
ECP5 FPGA and configuration (block E)
Ethernet PHY and clocks (block E)
1-bit DAC, headphone and line out (block F)
Measurement mic and MEMS mic (block F)
User I/O, debug and test points (block G)
VPRI 42-57 V
UCC_SS
VBUS 48 V
VBUS, VDRV 7 V
VBUS, VDRV
ACF_SYNC, DRV_FWD
I, V, T sense
ETH pairs, LEDs
RMII + 50 MHz
PIO link, SSPI config
PWM, FAULT, ARM (both bridges)
POE_LOSS_N, ACF_PULSE
1-bit DAC, MCLK_Q, relays
I2S mic ADC, PDM
USB, SWD, I2C, LED, display
PD status (ISO7740)
POWER AND AMPLIFIER
PoE (primary side, isolated 1500 Vrms) -> isolated forward converter -> VBUS 48 V -> rails and GaN bridges
Inter-sheet signals are global labels and rails are power symbols; the lines on this page show the main flows.
Net names: design/parts/*-interfaces.md and E-pinmap.md
COMPUTE, NETWORK, AUDIO AND I/O

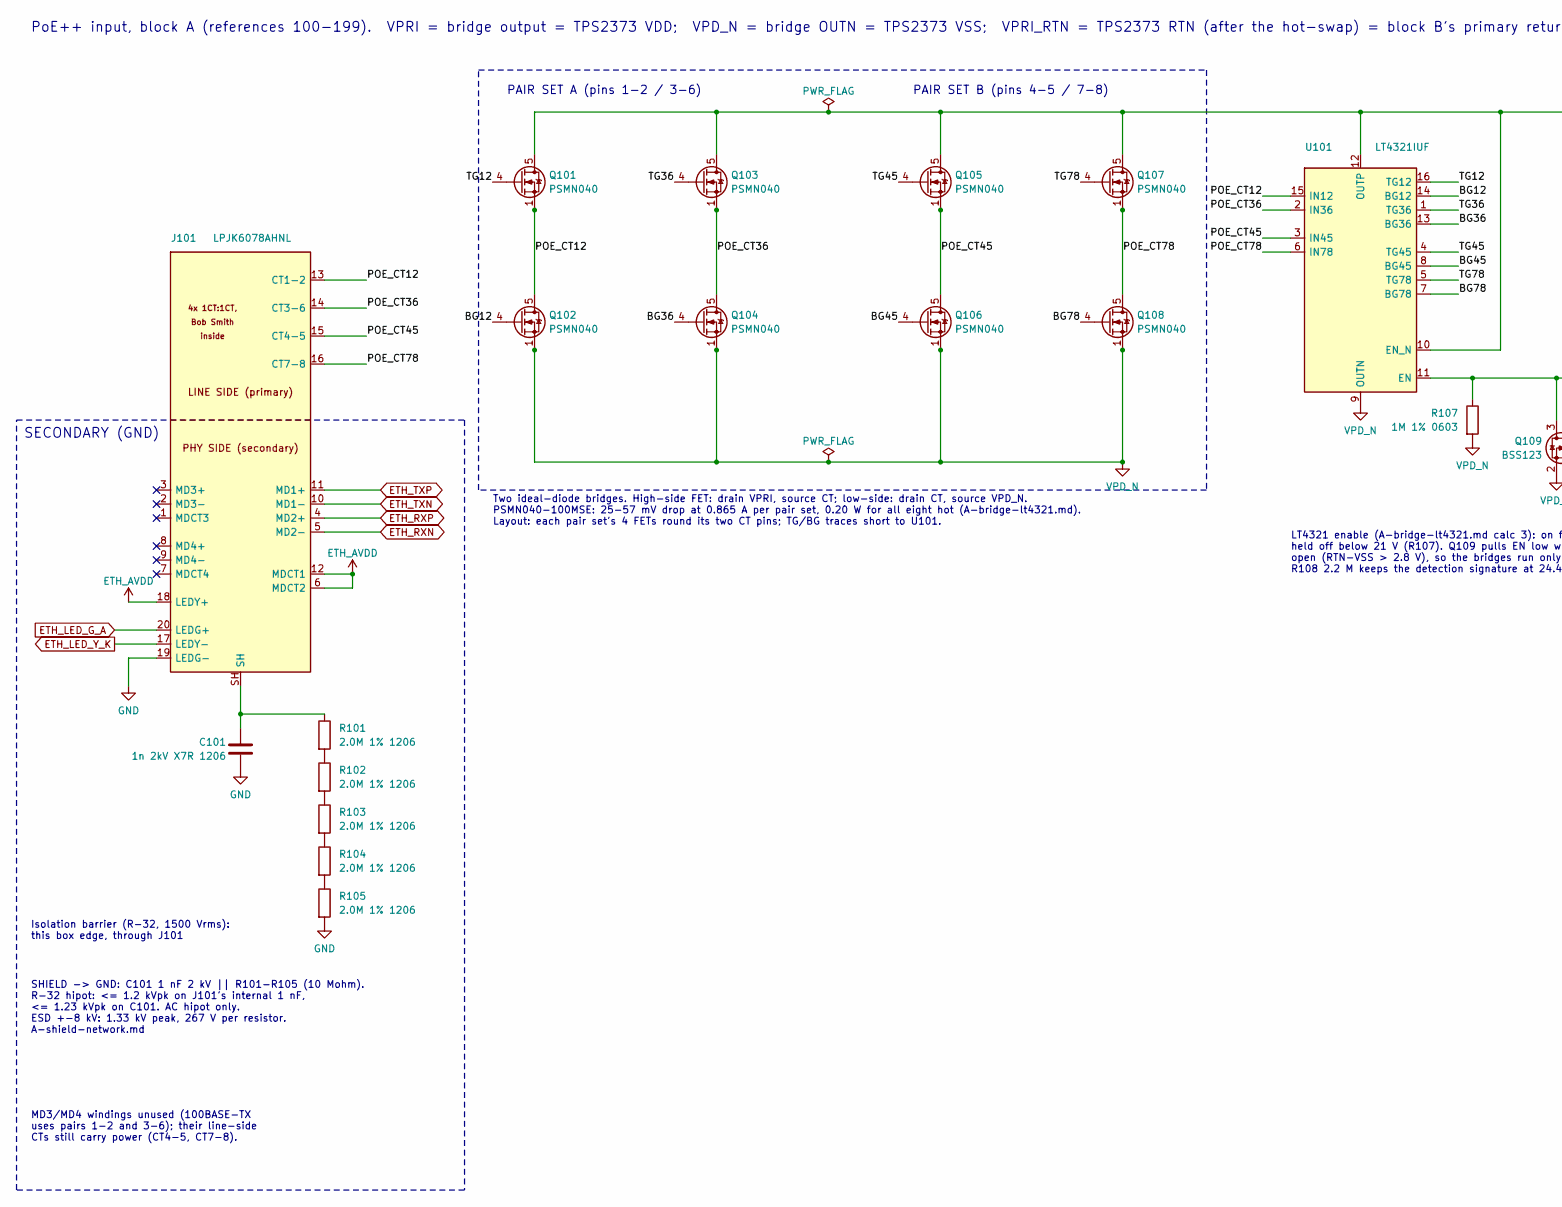
[picture p16: schematic poe_in.kicad_sch, Studio Amp satellite: PoE++ input: magjack, bridges, PD, part in row 1, column 1]

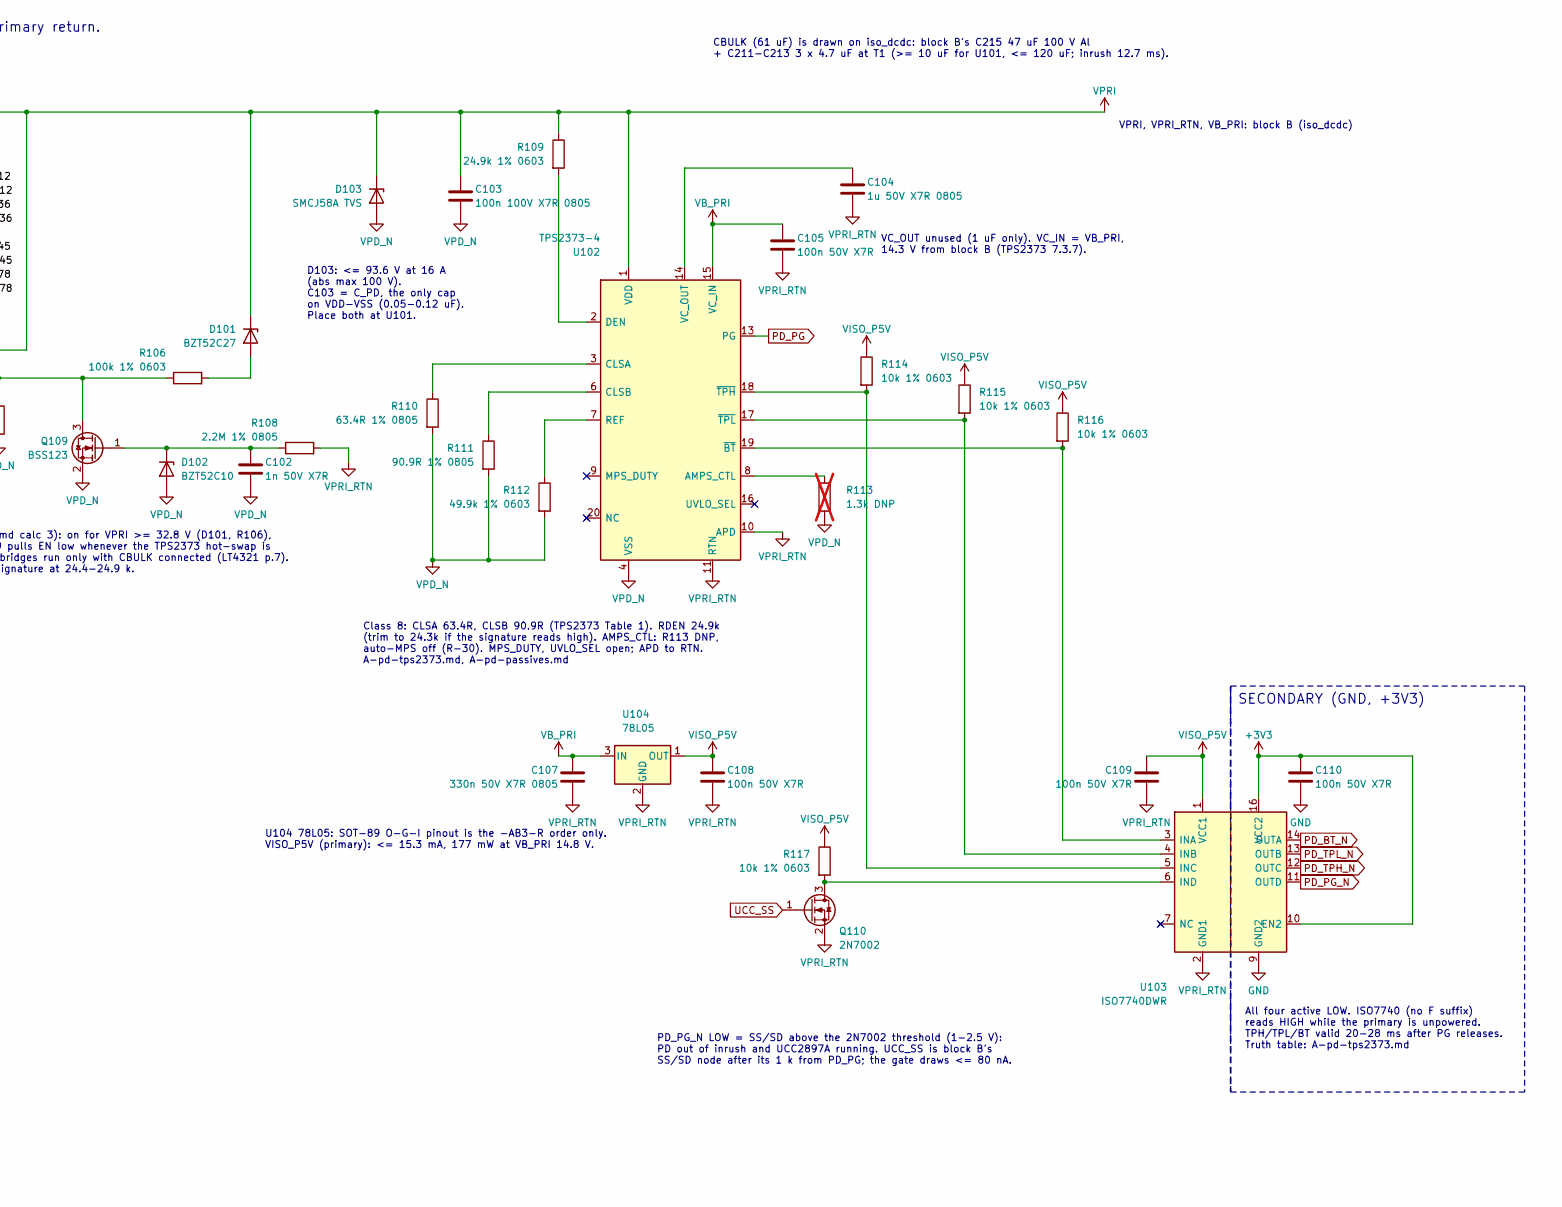
[picture p17: schematic poe_in.kicad_sch, Studio Amp satellite: PoE++ input: magjack, bridges, PD, part in row 1, column 2]

Parts:
C101: 1n 2kV X7R 1206; C_1206_3216Metric; MPN 1206B102K202NT; LCSC C9196
C102: 1n 50V X7R; C_0603_1608Metric; MPN CL10B102KB8NNNC; LCSC C1588
C103: 100n 100V X7R 0805; C_0805_2012Metric; MPN CL21B104KCFNNNE; LCSC C28233
C104: 1u 50V X7R 0805; C_0805_2012Metric; MPN CL21B105KBFNNNE; LCSC C28323
C105, C108, C109, C110: 100n 50V X7R; C_0603_1608Metric; MPN CC0603KRX7R9BB104; LCSC C14663
C107: 330n 50V X7R 0805; C_0805_2012Metric; MPN 0805B334K500NT; LCSC C1740
D101: BZT52C27; D_SOD-123; MPN BZT52C27; LCSC C173421
D102: BZT52C10; D_SOD-123; MPN BZT52C10; LCSC C173431
D103: SMCJ58A TVS; D_SMC; MPN SMCJ58A-13-F; LCSC C135180
J101: LPJK6078AHNL; LINKPP_LPJK6078AHNL_RJ45_PoE; MPN LPJK6078AHNL; LCSC C49274795
Q101, Q102, Q103, Q104, Q105, Q106, Q107, Q108: PSMN040; LFPAK33; MPN PSMN040-100MSEX; LCSC C458214
Q109: BSS123; SOT-23; MPN BSS123,215; LCSC C78962
Q110: 2N7002; SOT-23; MPN 2N7002; LCSC C8545
R101, R102, R103, R104, R105: 2.0M 1% 1206; R_1206_3216Metric; MPN FRC1206F2004TS; LCSC C2907380
R106: 100k 1% 0603; R_0603_1608Metric; MPN 0603WAF1003T5E; LCSC C25803
R107: 1M 1% 0603; R_0603_1608Metric; MPN 0603WAF1004T5E; LCSC C22935
R108: 2.2M 1% 0805; R_0805_2012Metric; MPN 0805W8F2204T5E; LCSC C26113
R109: 24.9k 1% 0603; R_0603_1608Metric; MPN 0603WAF2492T5E; LCSC C25962
R110: 63.4R 1% 0805; R_0805_2012Metric; MPN FRC0805F63R4TS; LCSC C5159721
R111: 90.9R 1% 0805; R_0805_2012Metric; MPN FRC0805F90R9TS; LCSC C3000584
R112: 49.9k 1% 0603; R_0603_1608Metric; MPN 0603WAF4992T5E; LCSC C23184
R113: 1.3k DNP; R_1206_3216Metric; MPN FRC1206F1301TS; LCSC C2933592; not fitted
R114, R115, R116, R117: 10k 1% 0603; R_0603_1608Metric; MPN 0603WAF1002T5E; LCSC C25804
U101: LT4321IUF; QFN-16-1EP_4x4mm_P0.65mm_EP2.15x2.15mm; MPN LT4321IUF#TRPBF; LCSC C580183
U102: TPS2373-4; TI_RGW0020B_VQFN-20-1EP_5x5mm_P0.65mm_EP2.2x2.2mm; MPN TPS2373-4RGWR; LCSC C470963
U103: ISO7740DWR; SOIC-16W_7.5x10.3mm_P1.27mm; MPN ISO7740DWR; LCSC C529547
U104: 78L05; SOT-89-3; MPN 78L05G-AB3-R; LCSC C71136

Connections:
/poe_in/BG12: Q102.4 (G), U101.14 (BG12)
/poe_in/BG36: Q104.4 (G), U101.13 (BG36)
/poe_in/BG45: Q106.4 (G), U101.8 (BG45)
/poe_in/BG78: Q108.4 (G), U101.7 (BG78)
/poe_in/POE_CT12: J101.13 (CT1-2), Q101.1 (S), Q101.2 (S), Q101.3 (S), Q102.5 (D), U101.15 (IN12)
/poe_in/POE_CT36: J101.14 (CT3-6), Q103.1 (S), Q103.2 (S), Q103.3 (S), Q104.5 (D), U101.2 (IN36)
/poe_in/POE_CT45: J101.15 (CT4-5), Q105.1 (S), Q105.2 (S), Q105.3 (S), Q106.5 (D), U101.3 (IN45)
/poe_in/POE_CT78: J101.16 (CT7-8), Q107.1 (S), Q107.2 (S), Q107.3 (S), Q108.5 (D), U101.6 (IN78)
/poe_in/TG12: Q101.4 (G), U101.16 (TG12)
/poe_in/TG36: Q103.4 (G), U101.1 (TG36)
/poe_in/TG45: Q105.4 (G), U101.4 (TG45)
/poe_in/TG78: Q107.4 (G), U101.5 (TG78)
ETH_LED_G_A: J101.20 (LEDG+); also elsewhere on the board
ETH_LED_Y_K: J101.17 (LEDY-); also elsewhere on the board
ETH_RXN: J101.5 (MD2-); also elsewhere on the board
ETH_RXP: J101.4 (MD2+); also elsewhere on the board
ETH_TXN: J101.10 (MD1-); also elsewhere on the board
ETH_TXP: J101.11 (MD1+); also elsewhere on the board
unnamed: C101.1, J101.SH, R101.1
unnamed: D101.2 (A), R106.2
unnamed: C102.1, D102.1 (K), Q109.1 (G), R108.1
unnamed: Q109.3 (D), R106.1, R107.1, U101.11 (EN)
unnamed: Q110.3 (D), R117.2, U103.6 (IND)
unnamed: R101.2, R102.1
unnamed: R102.2, R103.1
unnamed: R103.2, R104.1
unnamed: R104.2, R105.1
unnamed: R113.1, U102.8 (AMPS_CTL)
unnamed: R110.1, U102.3 (CLSA)
unnamed: R111.1, U102.6 (CLSB)
unnamed: R109.2, U102.2 (DEN)
unnamed: R112.1, U102.7 (REF)
unnamed: C104.1, U102.14 (VC_OUT)
unnamed: R116.2, U102.19 (~BT), U103.3 (INA)
unnamed: R114.2, U102.18 (~TPH), U103.5 (INC)
unnamed: R115.2, U102.17 (~TPL), U103.4 (INB)
PD_BT_N: U103.14 (OUTA); also elsewhere on the board
PD_PG: U102.13 (PG); also elsewhere on the board
PD_PG_N: U103.11 (OUTD); also elsewhere on the board
PD_TPH_N: U103.12 (OUTC); also elsewhere on the board
PD_TPL_N: U103.13 (OUTB); also elsewhere on the board
UCC_SS: Q110.1 (G); also elsewhere on the board
VISO_P5V: C108.1, C109.1, R114.1, R115.1, R116.1, R117.1, U103.1 (VCC1), U104.1 (OUT)
VPD_N: C102.2, C103.2, D102.2 (A), D103.2 (A), Q102.1 (S), Q102.2 (S), Q102.3 (S), Q104.1 (S), Q104.2 (S), Q104.3 (S), Q106.1 (S), Q106.2 (S), Q106.3 (S), Q108.1 (S), Q108.2 (S), Q108.3 (S), Q109.2 (S), R107.2, R110.2, R111.2, R112.2, R113.2, U101.9 (OUTN), U101.17 (OUTN), U102.4 (VSS), U102.5 (VSS), U102.21 (VSS)
VPRI: C103.1, D101.1 (K), D103.1 (K), Q101.5 (D), Q103.5 (D), Q105.5 (D), Q107.5 (D), R109.1, U101.10 (EN_N), U101.12 (OUTP), U102.1 (VDD); also elsewhere on the board
VPRI_RTN: C104.2, C105.2, C107.2, C108.2, C109.2, Q110.2 (S), R108.2, U102.10 (APD), U102.11 (RTN), U102.12 (RTN), U103.2 (GND1), U103.8 (GND1), U104.2 (GND); also elsewhere on the board

Notes on the sheet:
PoE++ input, block A (references 100-199). VPRI = bridge output = TPS2373 VDD; VPD_N = bridge OUTN = TPS2373 VSS; VPRI_RTN = TPS2373 RTN (after the hot-swap) = block B's primary return.
SHIELD -> GND: C101 1 nF 2 kV || R101-R105 (10 Mohm). R-32 hipot: <= 1.2 kVpk on J101's internal 1 nF, <= 1.23 kVpk on C101. AC hipot only. ESD +-8 kV: 1.33 kV peak, 267 V per resistor. A-shield-network.md
MD3/MD4 windings unused (100BASE-TX uses pairs 1-2 and 3-6); their line-side CTs still carry power (CT4-5, CT7-8).
SECONDARY (GND)
Isolation barrier (R-32, 1500 Vrms): this box edge, through J101
PAIR SET A (pins 1-2 / 3-6)
PAIR SET B (pins 4-5 / 7-8)
Two ideal-diode bridges. High-side FET: drain VPRI, source CT; low-side: drain CT, source VPD_N. PSMN040-100MSE: 25-57 mV drop at 0.865 A per pair set, 0.20 W for all eight hot (A-bridge-lt4321.md). Layout: each pair set's 4 FETs round its two CT pins; TG/BG traces short to U101.
LT4321 enable (A-bridge-lt4321.md calc 3): on for VPRI >= 32.8 V (D101, R106), held off below 21 V (R107). Q109 pulls EN low whenever the TPS2373 hot-swap is open (RTN-VSS > 2.8 V), so the bridges run only with CBULK connected (LT4321 p.7). R108 2.2 M keeps the detection signature at 24.4-24.9 k.
D103: <= 93.6 V at 16 A (abs max 100 V). C103 = C_PD, the only cap on VDD-VSS (0.05-0.12 uF). Place both at U101.
Class 8: CLSA 63.4R, CLSB 90.9R (TPS2373 Table 1). RDEN 24.9k (trim to 24.3k if the signature reads high). AMPS_CTL: R113 DNP, auto-MPS off (R-30). MPS_DUTY, UVLO_SEL open; APD to RTN. A-pd-tps2373.md, A-pd-passives.md
VC_OUT unused (1 uF only). VC_IN = VB_PRI, 14.3 V from block B (TPS2373 7.3.7).
CBULK (61 uF) is drawn on iso_dcdc: block B's C215 47 uF 100 V Al + C211-C213 3 x 4.7 uF at T1 (>= 10 uF for U101, <= 120 uF; inrush 12.7 ms).
VPRI, VPRI_RTN, VB_PRI: block B (iso_dcdc)
PD_PG_N LOW = SS/SD above the 2N7002 threshold (1-2.5 V): PD out of inrush and UCC2897A running. UCC_SS is block B's SS/SD node after its 1 k from PD_PG; the gate draws <= 80 nA.
U104 78L05: SOT-89 O-G-I pinout is the -AB3-R order only. VISO_P5V (primary): <= 15.3 mA, 177 mW at VB_PRI 14.8 V.
SECONDARY (GND, +3V3)
All four active LOW. ISO7740 (no F suffix) reads HIGH while the primary is unpowered. TPH/TPL/BT valid 20-28 ms after PG releases. Truth table: A-pd-tps2373.md

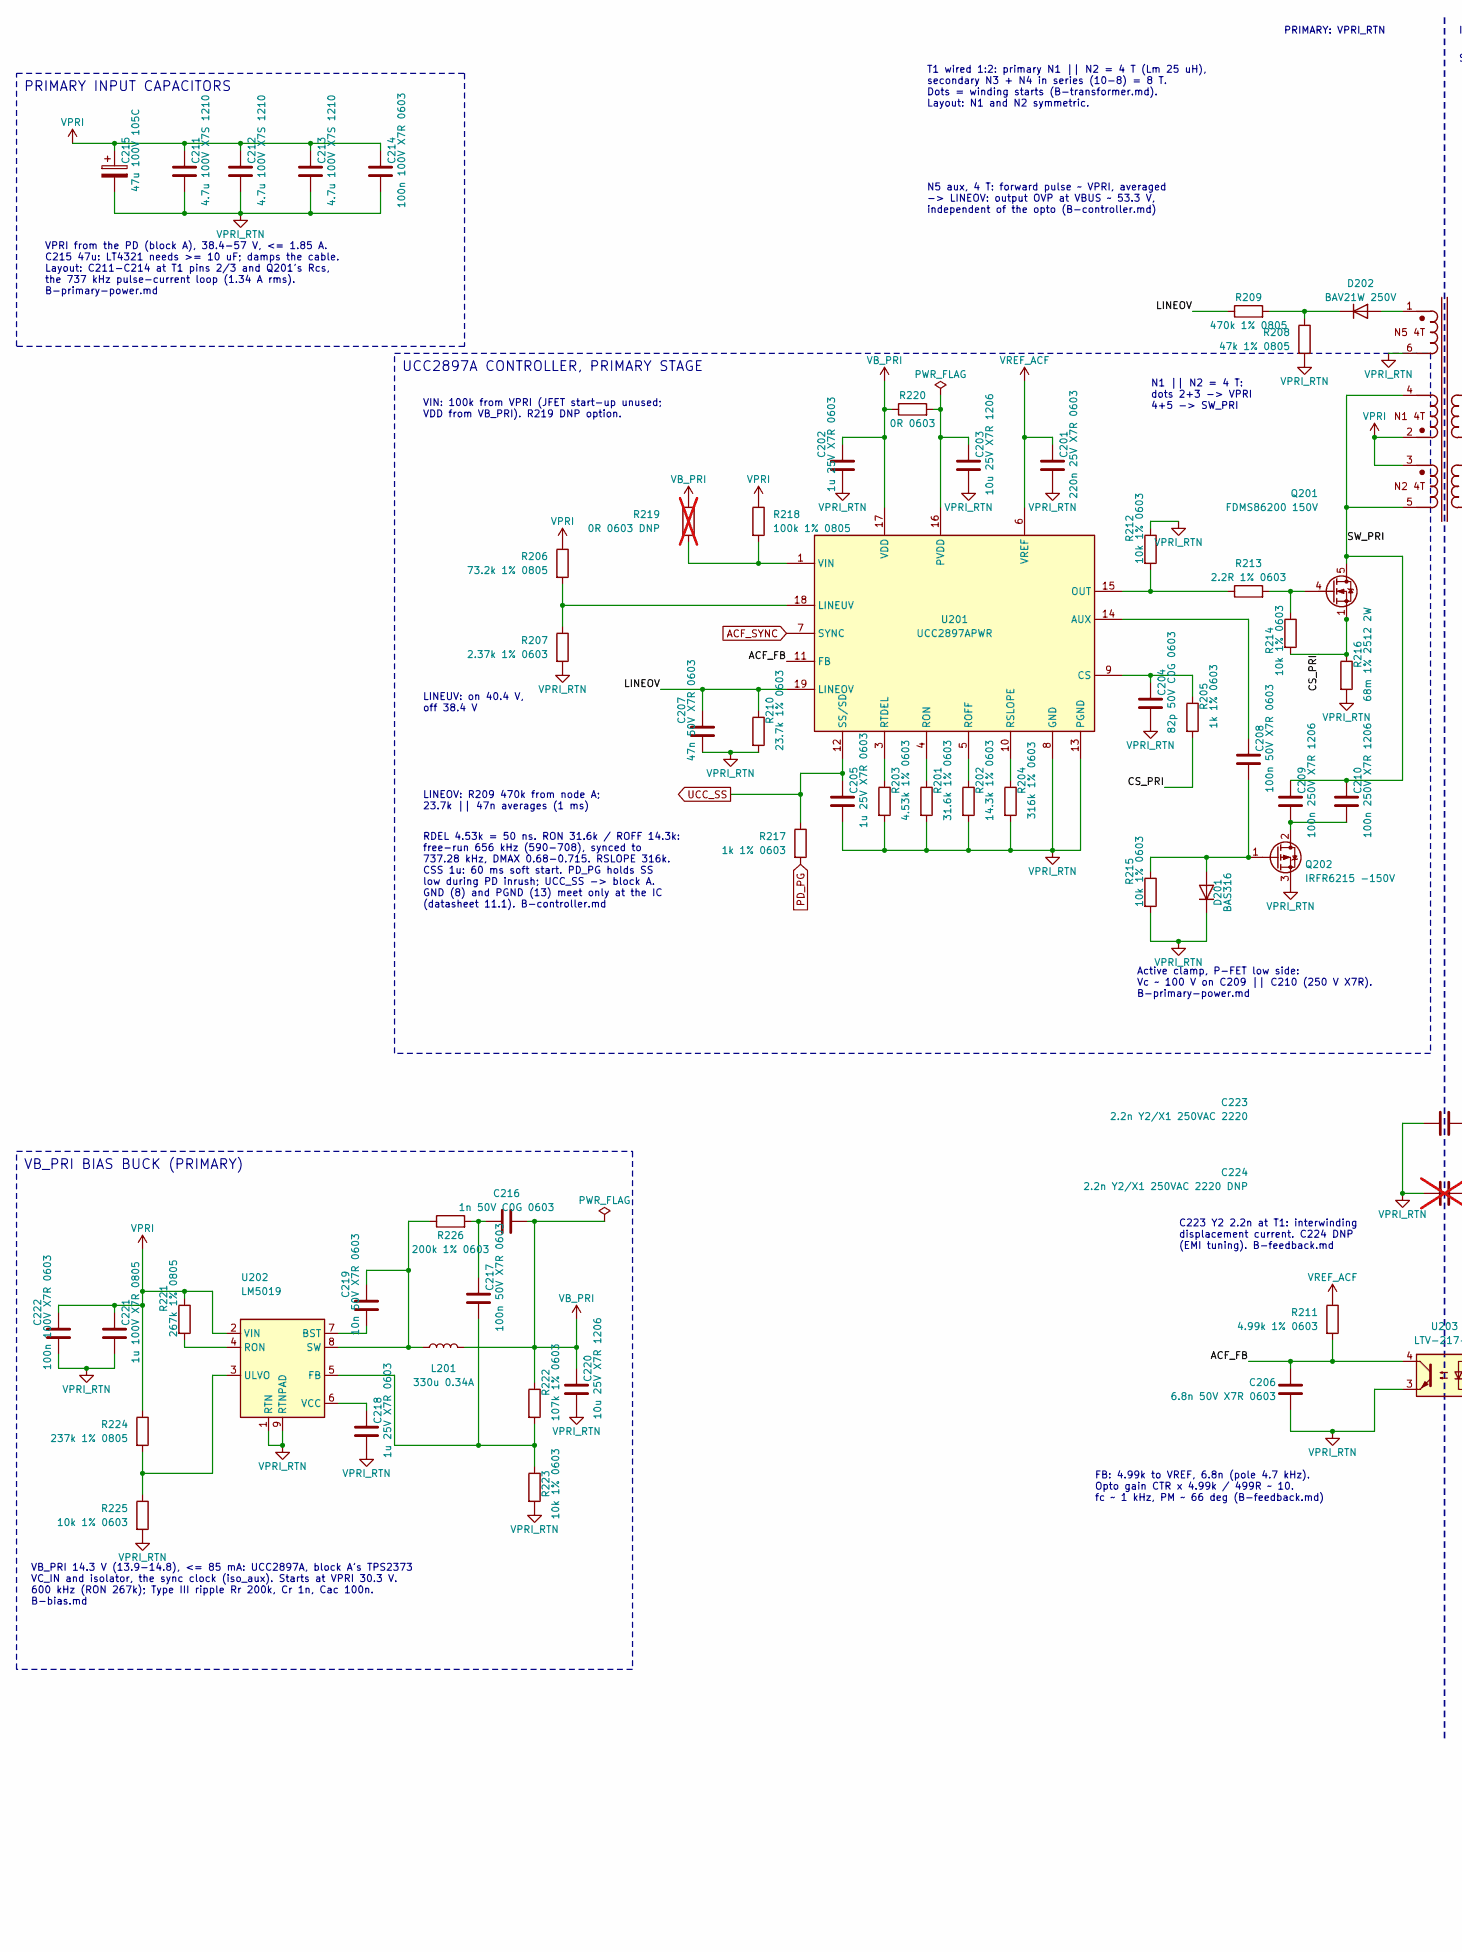
[picture p18: schematic iso_dcdc.kicad_sch, Studio Amp satellite: Isolated active-clamp forward, 48 V, part in row 1, column 1]

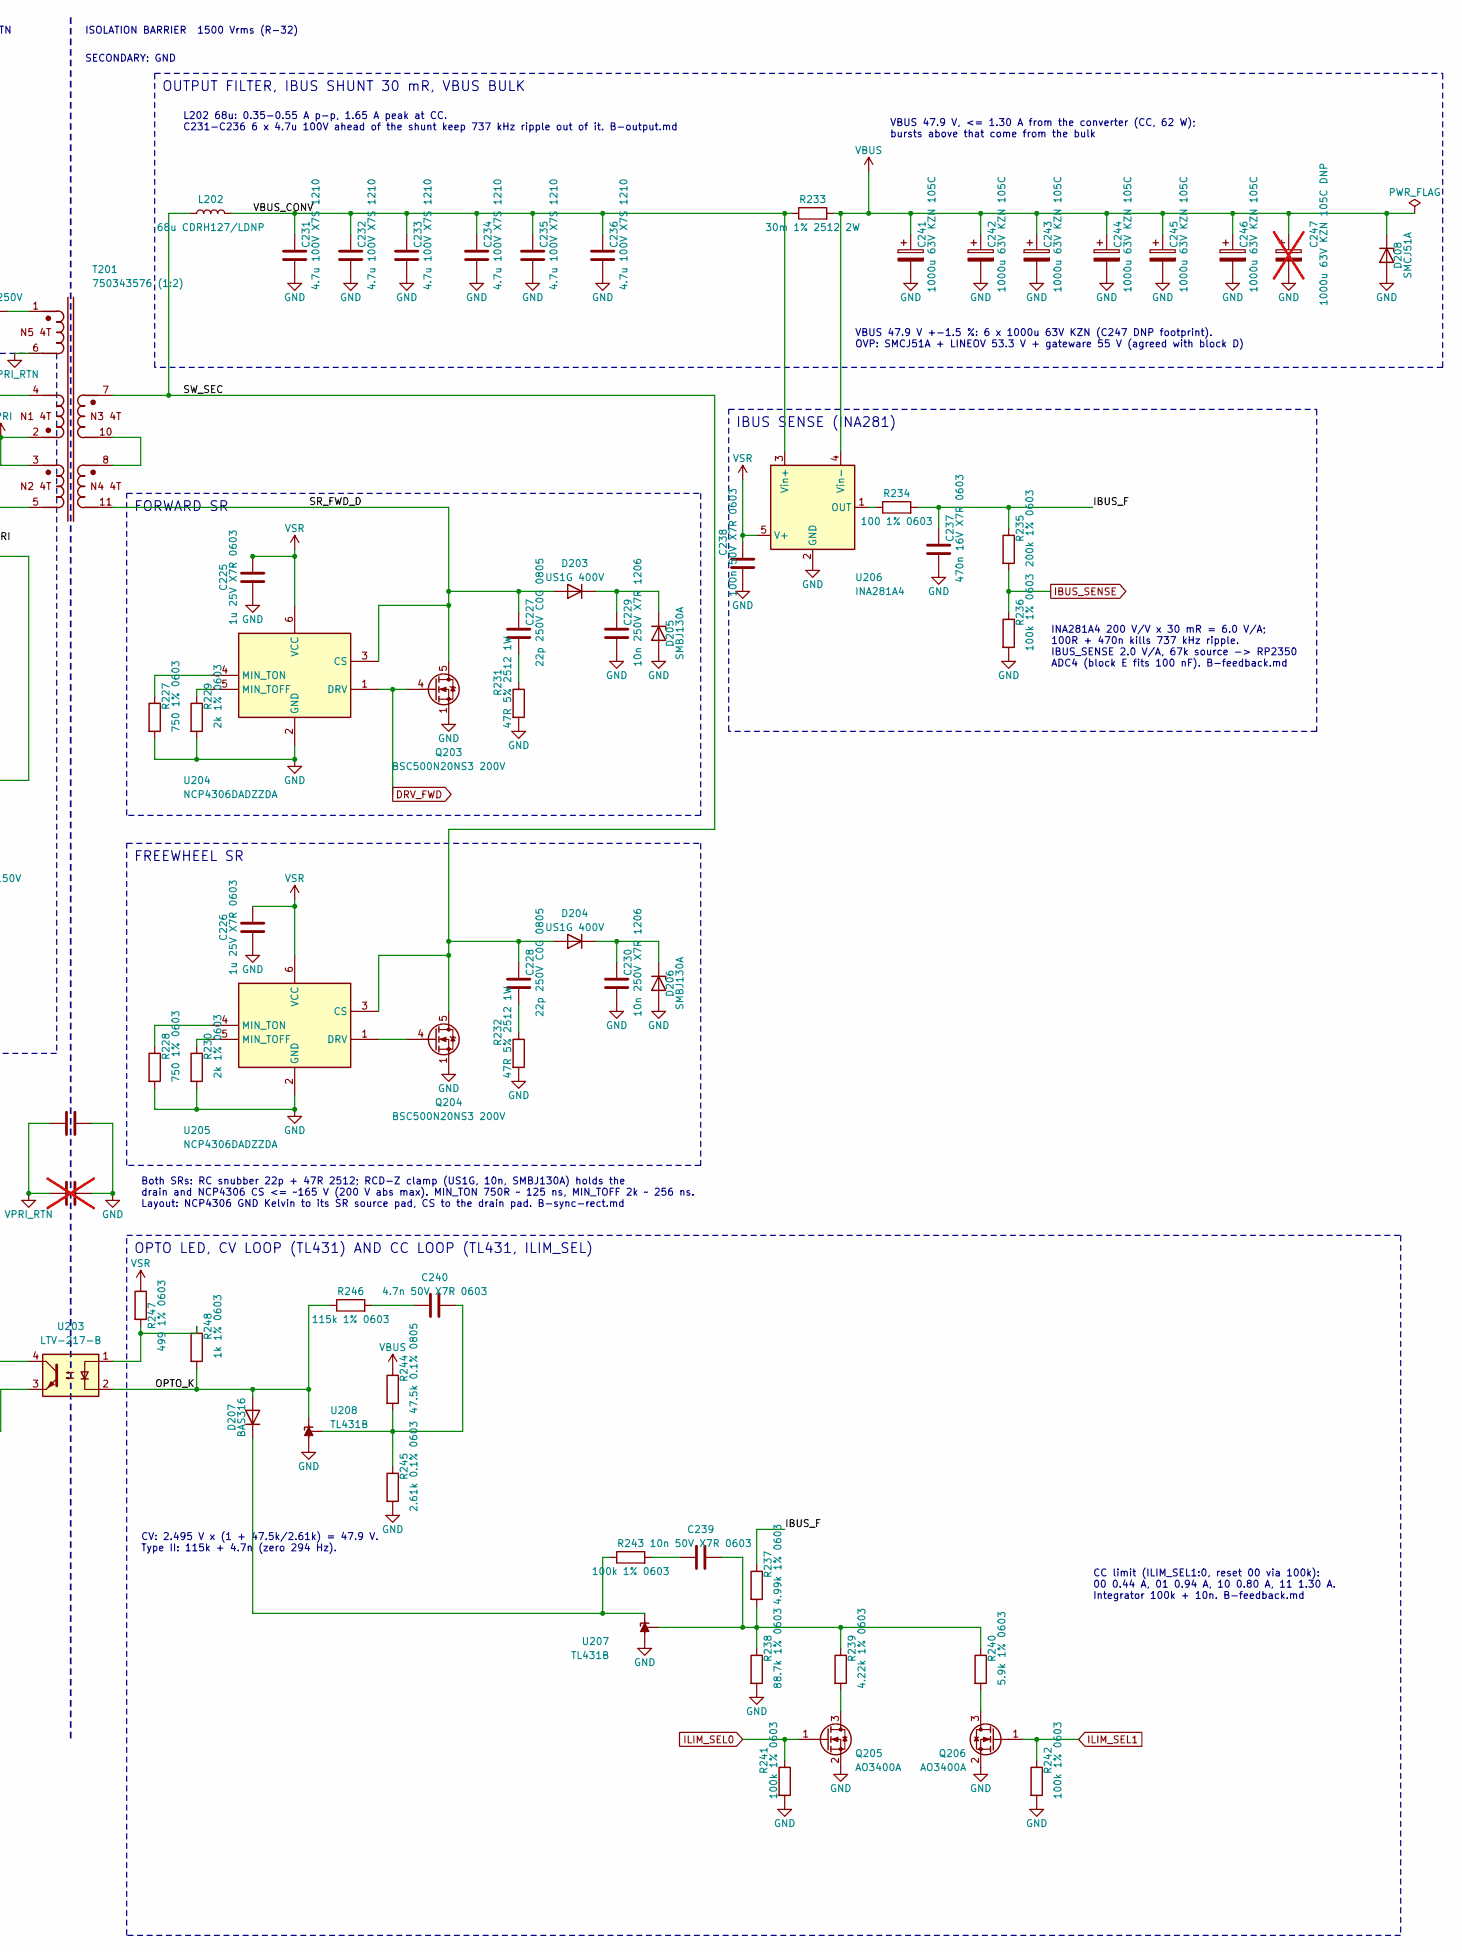
[picture p19: schematic iso_dcdc.kicad_sch, Studio Amp satellite: Isolated active-clamp forward, 48 V, part in row 1, column 2]

Parts:
C201: 220n 25V X7R 0603; C_0603_1608Metric; MPN CL10B224KA8NNNC; LCSC C21120
C202, C205, C218, C225, C226: 1u 25V X7R 0603; C_0603_1608Metric; MPN CL10B105KA8NNNC; LCSC C29936
C203, C220: 10u 25V X7R 1206; C_1206_3216Metric; MPN CL31B106KAHNNNE; LCSC C14860
C204: 82p 50V C0G 0603; C_0603_1608Metric; MPN 0603CG820J500NT; LCSC C1683
C206: 6.8n 50V X7R 0603; C_0603_1608Metric; MPN 0603B682K500NT; LCSC C1631
C207: 47n 50V X7R 0603; C_0603_1608Metric; MPN CL10B473KB8NNNC; LCSC C1622
C208, C217, C238: 100n 50V X7R 0603; C_0603_1608Metric; MPN CL10B104KB8NNNC; LCSC C1591
C209, C210: 100n 250V X7R 1206; C_1206_3216Metric; MPN GRM31CR72E104KW03L; LCSC C97956
C211, C212, C213, C231, C232, C233, C234, C235, C236: 4.7u 100V X7S 1210; C_1210_3225Metric; MPN GCM32DC72A475KE02L; LCSC C913445
C214, C222: 100n 100V X7R 0603; C_0603_1608Metric; MPN CL10B104KC8NNNC; LCSC C15725
C215: 47u 100V 105C; CP_Elec_10x10.5; MPN RVT2A470M1010; LCSC C87862
C216: 1n 50V C0G 0603; C_0603_1608Metric; MPN CL10C102JB8NNNC; LCSC C163508
C219, C239: 10n 50V X7R 0603; C_0603_1608Metric; MPN CL10B103KB8NNNC; LCSC C1589
C221: 1u 100V X7R 0805; C_0805_2012Metric; MPN HMK212BC7105KGHTE; LCSC C385977
C223: 2.2n Y2/X1 250VAC 2220; C_2220_5750Metric; MPN GA355QR7GF222KW01L; LCSC C91600
C224: 2.2n Y2/X1 250VAC 2220 DNP; C_2220_5750Metric; MPN GA355QR7GF222KW01L; LCSC C91600; not fitted
C227, C228: 22p 250V C0G 0805; C_0805_2012Metric; MPN CC0805JRNPOYBN220; LCSC C90626
C229, C230: 10n 250V X7R 1206; C_1206_3216Metric; MPN 1206B103K251NT; LCSC C913956
C237: 470n 16V X7R 0603; C_0603_1608Metric; MPN CL10B474KO8NNNC; LCSC C105526
C240: 4.7n 50V X7R 0603; C_0603_1608Metric; MPN CL10B472KB8NNNC; LCSC C1621
C241, C242, C243, C244, C245, C246: 1000u 63V KZN 105C; CP_Radial_D16.0mm_P7.50mm; MPN EKZN630ELL102ML25S; LCSC C337254
C247: 1000u 63V KZN 105C DNP; CP_Radial_D16.0mm_P7.50mm; MPN EKZN630ELL102ML25S; LCSC C337254; not fitted
D201, D207: BAS316; D_SOD-323; MPN BAS316,115; LCSC C109218
D202: BAV21W 250V; D_SOD-123; MPN BAV21W; LCSC C113947
D203, D204: US1G 400V; D_SMA; MPN US1G; LCSC C383015
D205, D206: SMBJ130A; D_SMB; MPN SMBJ130A-E3/52; LCSC C553984
D208: SMCJ51A; D_SMC; MPN SMCJ51A; LCSC C408371
L201: 330u 0.34A; L_SXN_SM5845; MPN SM5845-331MT; LCSC C10124
L202: 68u CDRH127/LDNP; L_Sumida_CDRH127; MPN CDRH127/LDNP-680MC; LCSC C2452974
Q201: FDMS86200 150V; Infineon_PG-TDSON-8_6.15x5.15mm; MPN FDMS86200; LCSC C128799
Q202: IRFR6215 -150V; TO-252-2; MPN IRFR6215TRLPBF; LCSC C537989
Q203, Q204: BSC500N20NS3 200V; Infineon_PG-TDSON-8_6.15x5.15mm; MPN BSC500N20NS3GATMA1; LCSC C5381902
Q205, Q206: AO3400A; SOT-23; MPN AO3400A; LCSC C20917
R201: 31.6k 1% 0603; R_0603_1608Metric; MPN 0603WAF3162T5E; LCSC C25967
R202: 14.3k 1% 0603; R_0603_1608Metric; MPN 0603WAF1432T5E; LCSC C22799
R203: 4.53k 1% 0603; R_0603_1608Metric; MPN 0603WAF4531T5E; LCSC C25971
R204: 316k 1% 0603; R_0603_1608Metric; MPN 0603WAF3163T5E; LCSC C25814
R205, R217, R248: 1k 1% 0603; R_0603_1608Metric; MPN 0603WAF1001T5E; LCSC C21190
R206: 73.2k 1% 0805; R_0805_2012Metric; MPN 0805W8F7322T5E; LCSC C17814
R207: 2.37k 1% 0603; R_0603_1608Metric; MPN 0603WAF2371T5E; LCSC C25964
R208: 47k 1% 0805; R_0805_2012Metric; MPN 0805W8F4702T5E; LCSC C17713
R209: 470k 1% 0805; R_0805_2012Metric; MPN 0805W8F4703T5E; LCSC C17709
R210: 23.7k 1% 0603; R_0603_1608Metric; MPN 0603WAF2372T5E; LCSC C22912
R211, R237: 4.99k 1% 0603; R_0603_1608Metric; MPN 0603WAF4991T5E; LCSC C23046
R212, R214, R215, R223, R225: 10k 1% 0603; R_0603_1608Metric; MPN 0603WAF1002T5E; LCSC C25804
R213: 2.2R 1% 0603; R_0603_1608Metric; MPN RC0603FR-072R2L; LCSC C112307
R216: 68m 1% 2512 2W; R_2512_6332Metric; MPN RLP25FEER068; LCSC C2683389
R218: 100k 1% 0805; R_0805_2012Metric; MPN 0805W8F1003T5E; LCSC C149504
R219: 0R 0603 DNP; R_0603_1608Metric; MPN 0603WAF0000T5E; LCSC C21189; not fitted
R220: 0R 0603; R_0603_1608Metric; MPN 0603WAF0000T5E; LCSC C21189
R221: 267k 1% 0805; R_0805_2012Metric; MPN 0805W8F2673T5E; LCSC C17585
R222: 107k 1% 0603; R_0603_1608Metric; MPN 0603WAF1073T5E; LCSC C14889
R224: 237k 1% 0805; R_0805_2012Metric; MPN 0805W8F2373T5E; LCSC C17568
R226, R235: 200k 1% 0603; R_0603_1608Metric; MPN 0603WAF2003T5E; LCSC C25811
R227, R228: 750 1% 0603; R_0603_1608Metric; MPN 0603WAF7500T5E; LCSC C23241
R229, R230: 2k 1% 0603; R_0603_1608Metric; MPN 0603WAF2001T5E; LCSC C22975
R231, R232: 47R 5% 2512 1W; R_2512_6332Metric; MPN 25121WJ0470T4E; LCSC C15261
R233: 30m 1% 2512 2W; R_2512_6332Metric; MPN LR122WF300MT4E; LCSC C2941066
R234: 100 1% 0603; R_0603_1608Metric; MPN 0603WAF1000T5E; LCSC C22775
R236, R241, R242, R243: 100k 1% 0603; R_0603_1608Metric; MPN 0603WAF1003T5E; LCSC C25803
R238: 88.7k 1% 0603; R_0603_1608Metric; MPN 0603WAF8872T5E; LCSC C23258
R239: 4.22k 1% 0603; R_0603_1608Metric; MPN 0603WAF4221T5E; LCSC C23042
R240: 5.9k 1% 0603; R_0603_1608Metric; MPN 0603WAF5901T5E; LCSC C23071
R244: 47.5k 0.1% 0805; R_0805_2012Metric; MPN RT0805BRD0747K5L; LCSC C865514
R245: 2.61k 0.1% 0603; R_0603_1608Metric; MPN RT0603BRD072K61L; LCSC C861301
R246: 115k 1% 0603; R_0603_1608Metric; MPN 0603WAF1153T5E; LCSC C22783
R247: 499 1% 0603; R_0603_1608Metric; MPN 0603WAF4990T5E; LCSC C23065
T201: 750343576 (1:2); Wurth_750343576_ER19; MPN 750343576; LCSC HAND
U201: UCC2897APWR; TSSOP-20_4.4x6.5mm_P0.65mm; MPN UCC2897APWR; LCSC C54444
U202: LM5019; SOIC-8-1EP_3.9x4.9mm_P1.27mm_EP2.95x4.9mm_Mask2.71x3.4mm; MPN LM5019MRX/NOPB; LCSC C471034
U203: LTV-217-B; SOP-4_4.4x2.6mm_P1.27mm; MPN LTV-217-B-G; LCSC C115450
U204, U205: NCP4306DADZZDA; SOT-23-6; MPN NCP4306DADZZDASNT1G; LCSC C504885
U206: INA281A4; SOT-23-5; MPN INA281A4IDBVR; LCSC C2864421
U207, U208: TL431B; SOT-23; MPN TL431BIDBZR; LCSC C41283

Connections:
/iso_dcdc/ACF_FB: C206.1, R211.2, U201.11 (FB), U203.4
/iso_dcdc/CS_PRI: Q201.1 (S), Q201.2 (S), Q201.3 (S), R205.2, R214.2, R216.1
/iso_dcdc/IBUS_F: C237.1, R234.2, R235.1, R237.1
/iso_dcdc/LINEOV: C207.1, R209.1, R210.1, U201.19 (LINEOV)
/iso_dcdc/OPTO_K: D207.2 (A), R246.1, R248.2, U203.2, U208.1 (K)
/iso_dcdc/SR_FWD_D: C227.1, D203.2 (A), Q203.5 (D), T201.11 (N4_F), U204.3 (CS)
/iso_dcdc/SW_PRI: C209.1, C210.1, Q201.5 (D), T201.4 (N1_F), T201.5 (N2_F)
/iso_dcdc/SW_SEC: C228.1, D204.2 (A), L202.1, Q204.5 (D), T201.7 (N3_S), U205.3 (CS)
/iso_dcdc/VBUS_CONV: C231.1, C232.1, C233.1, C234.1, C235.1, C236.1, L202.2, R233.1, U206.3 (Vin+)
ACF_SYNC: U201.7 (SYNC); also elsewhere on the board
DRV_FWD: Q203.4 (G), U204.1 (DRV); also elsewhere on the board
IBUS_SENSE: R235.2, R236.1; also elsewhere on the board
ILIM_SEL0: Q205.1 (G), R241.1; also elsewhere on the board
ILIM_SEL1: Q206.1 (G), R242.1; also elsewhere on the board
unnamed: C216.1, C217.1, R226.2
unnamed: C227.2, R231.1
unnamed: C228.2, R232.1
unnamed: C239.1, R243.2
unnamed: C240.1, R246.2
unnamed: C208.2, D201.2 (A), Q202.1 (G), R215.1
unnamed: D202.2 (A), T201.1 (N5_S)
unnamed: D202.1 (K), R208.1, R209.2
unnamed: C229.1, D203.1 (K), D205.1 (K)
unnamed: C230.1, D204.1 (K), D206.1 (K)
unnamed: D207.1 (K), R243.1, U207.1 (K)
unnamed: Q201.4 (G), R213.2, R214.1
unnamed: C209.2, C210.2, Q202.2 (D)
unnamed: Q204.4 (G), U205.1 (DRV)
unnamed: Q205.3 (D), R239.2
unnamed: Q206.3 (D), R240.2
unnamed: R247.2, R248.1, U203.1
unnamed: T201.8 (N4_S), T201.10 (N3_F)
unnamed: C208.1, U201.14 (AUX)
unnamed: C204.1, R205.1, U201.9 (CS)
unnamed: R206.2, R207.1, U201.18 (LINEUV)
unnamed: R212.2, R213.1, U201.15 (OUT)
unnamed: R202.1, U201.5 (ROFF)
unnamed: R201.1, U201.4 (RON)
unnamed: R204.1, U201.10 (RSLOPE)
unnamed: R203.1, U201.3 (RTDEL)
unnamed: R218.2, R219.2, U201.1 (VIN)
unnamed: C219.2, U202.7 (BST)
unnamed: C217.2, R222.2, R223.1, U202.5 (FB)
unnamed: R221.2, U202.4 (RON)
unnamed: C219.1, L201.1, R226.1, U202.8 (SW)
unnamed: R224.2, R225.1, U202.3 (ULVO)
unnamed: C218.1, U202.6 (VCC)
unnamed: R229.1, U204.5 (MIN_TOFF)
unnamed: R227.1, U204.4 (MIN_TON)
unnamed: R230.1, U205.5 (MIN_TOFF)
unnamed: R228.1, U205.4 (MIN_TON)
unnamed: R234.1, U206.1 (OUT)
unnamed: C239.2, R237.2, R238.1, R239.1, R240.1, U207.2 (REF)
unnamed: C240.2, R244.2, R245.1, U208.2 (REF)
PD_PG: R217.2; also elsewhere on the board
UCC_SS: C205.1, R217.1, U201.12 (SS/SD); also elsewhere on the board
VPRI: C211.1, C212.1, C213.1, C214.1, C215.1, C221.1, C222.1, R206.1, R218.1, R221.1, R224.1, T201.2 (N1_S), T201.3 (N2_S), U202.2 (VIN); also elsewhere on the board
VPRI_RTN: C201.2, C202.2, C203.2, C204.2, C205.2, C206.2, C207.2, C211.2, C212.2, C213.2, C214.2, C215.2, C218.2, C220.2, C221.2, C222.2, C223.1, C224.1, D201.1 (K), Q202.3 (S), R201.2, R202.2, R203.2, R204.2, R207.2, R208.2, R210.2, R212.1, R215.2, R216.2, R223.2, R225.2, T201.6 (N5_F), U201.8 (GND), U201.13 (PGND), U202.1 (RTN), U202.9 (RTNPAD), U203.3; also elsewhere on the board
VREF_ACF: C201.1, R211.1, U201.6 (VREF); also elsewhere on the board
VSR: C225.1, C226.1, C238.1, R247.1, U204.6 (VCC), U205.6 (VCC), U206.5 (V+); also elsewhere on the board

Notes on the sheet:
VPRI from the PD (block A), 38.4-57 V, <= 1.85 A. C215 47u: LT4321 needs >= 10 uF; damps the cable. Layout: C211-C214 at T1 pins 2/3 and Q201's Rcs, the 737 kHz pulse-current loop (1.34 A rms). B-primary-power.md
PRIMARY INPUT CAPACITORS
N1 || N2 = 4 T: dots 2+3 -> VPRI 4+5 -> SW_PRI
T1 wired 1:2: primary N1 || N2 = 4 T (Lm 25 uH), secondary N3 + N4 in series (10-8) = 8 T. Dots = winding starts (B-transformer.md). Layout: N1 and N2 symmetric.
N5 aux, 4 T: forward pulse ~ VPRI, averaged -> LINEOV: output OVP at VBUS ~ 53.3 V, independent of the opto (B-controller.md)
Active clamp, P-FET low side: Vc ~ 100 V on C209 || C210 (250 V X7R). B-primary-power.md
VIN: 100k from VPRI (JFET start-up unused; VDD from VB_PRI). R219 DNP option.
LINEUV: on 40.4 V, off 38.4 V
LINEOV: R209 470k from node A; 23.7k || 47n averages (1 ms)
RDEL 4.53k = 50 ns. RON 31.6k / ROFF 14.3k: free-run 656 kHz (590-708), synced to 737.28 kHz, DMAX 0.68-0.715. RSLOPE 316k. CSS 1u: 60 ms soft start. PD_PG holds SS low during PD inrush; UCC_SS -> block A. GND (8) and PGND (13) meet only at the IC (datasheet 11.1). B-controller.md
UCC2897A CONTROLLER, PRIMARY STAGE
VB_PRI 14.3 V (13.9-14.8), <= 85 mA: UCC2897A, block A's TPS2373 VC_IN and isolator, the sync clock (iso_aux). Starts at VPRI 30.3 V. 600 kHz (RON 267k); Type III ripple Rr 200k, Cr 1n, Cac 100n. B-bias.md
VB_PRI BIAS BUCK (PRIMARY)
ISOLATION BARRIER 1500 Vrms (R-32)
PRIMARY: VPRI_RTN
SECONDARY: GND
C223 Y2 2.2n at T1: interwinding displacement current. C224 DNP (EMI tuning). B-feedback.md
FB: 4.99k to VREF, 6.8n (pole 4.7 kHz). Opto gain CTR x 4.99k / 499R ~ 10. fc ~ 1 kHz, PM ~ 66 deg (B-feedback.md)
FORWARD SR
FREEWHEEL SR
Both SRs: RC snubber 22p + 47R 2512; RCD-Z clamp (US1G, 10n, SMBJ130A) holds the drain and NCP4306 CS <= ~165 V (200 V abs max). MIN_TON 750R ~ 125 ns, MIN_TOFF 2k ~ 256 ns. Layout: NCP4306 GND Kelvin to its SR source pad, CS to the drain pad. B-sync-rect.md
VBUS 47.9 V, <= 1.30 A from the converter (CC, 62 W); bursts above that come from the bulk
L202 68u: 0.35-0.55 A p-p, 1.65 A peak at CC. C231-C236 6 x 4.7u 100V ahead of the shunt keep 737 kHz ripple out of it. B-output.md
VBUS 47.9 V +-1.5 %: 6 x 1000u 63V KZN (C247 DNP footprint). OVP: SMCJ51A + LINEOV 53.3 V + gateware 55 V (agreed with block D)
OUTPUT FILTER, IBUS SHUNT 30 mR, VBUS BULK
INA281A4 200 V/V x 30 mR = 6.0 V/A; 100R + 470n kills 737 kHz ripple. IBUS_SENSE 2.0 V/A, 67k source -> RP2350 ADC4 (block E fits 100 nF). B-feedback.md
IBUS SENSE (INA281)
CV: 2.495 V x (1 + 47.5k/2.61k) = 47.9 V. Type II: 115k + 4.7n (zero 294 Hz).
CC limit (ILIM_SEL1:0, reset 00 via 100k): 00 0.44 A, 01 0.94 A, 10 0.80 A, 11 1.30 A. Integrator 100k + 10n. B-feedback.md
OPTO LED, CV LOOP (TL431) AND CC LOOP (TL431, ILIM_SEL)
