sequoia-hope/studio-amp/hw/satellite/a/satellite.kicad_pcb

## KiCad design hw/satellite/a/satellite.kicad_pcb (continued)

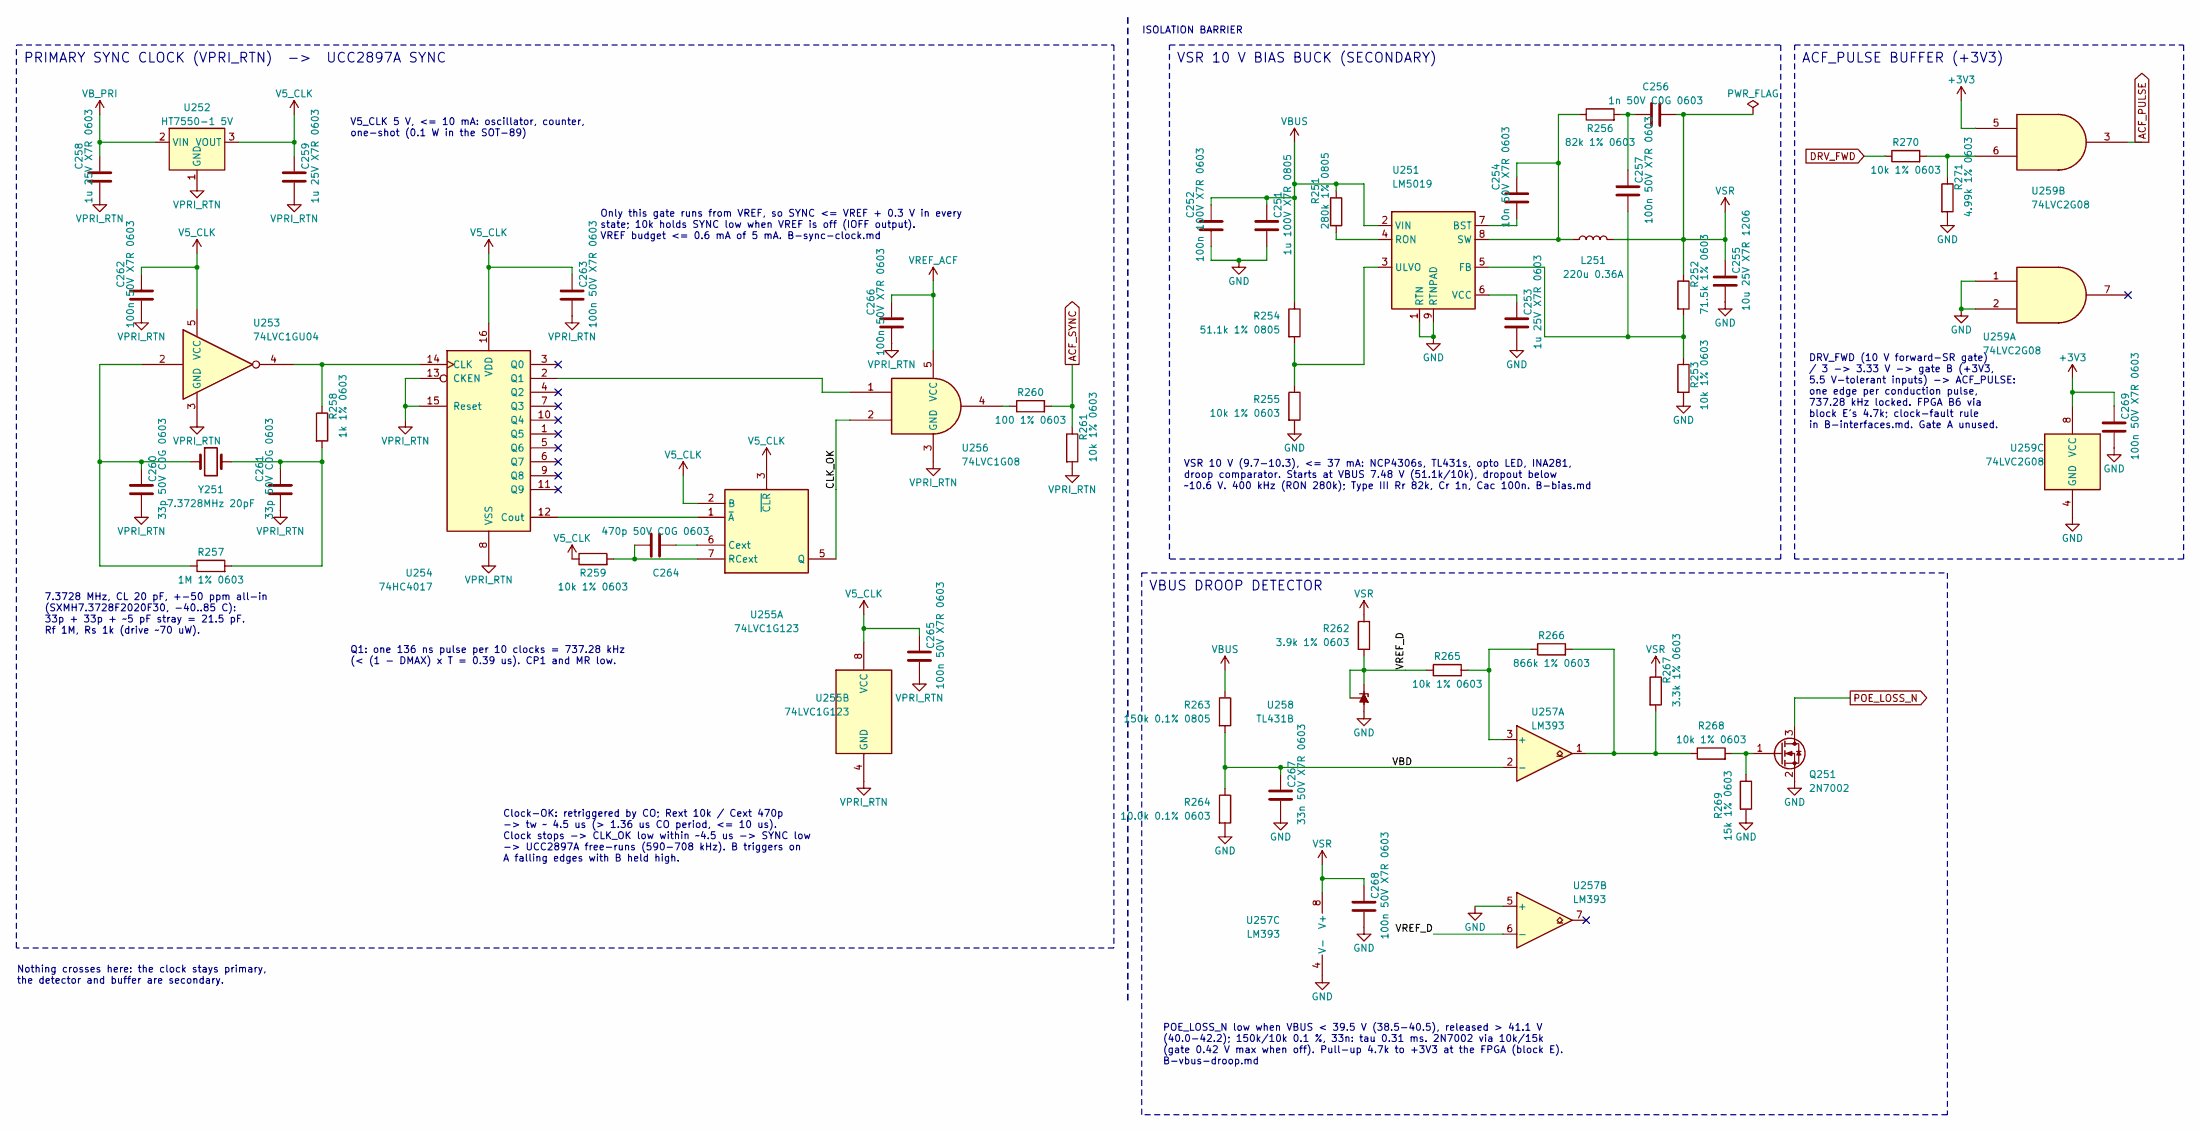
[picture p20: schematic iso_aux.kicad_sch, Studio Amp satellite: Converter sync clock and VBUS droop]

Parts:
C251: 1u 100V X7R 0805; C_0805_2012Metric; MPN HMK212BC7105KGHTE; LCSC C385977
C252: 100n 100V X7R 0603; C_0603_1608Metric; MPN CL10B104KC8NNNC; LCSC C15725
C253, C258, C259: 1u 25V X7R 0603; C_0603_1608Metric; MPN CL10B105KA8NNNC; LCSC C29936
C254: 10n 50V X7R 0603; C_0603_1608Metric; MPN CL10B103KB8NNNC; LCSC C1589
C255: 10u 25V X7R 1206; C_1206_3216Metric; MPN CL31B106KAHNNNE; LCSC C14860
C256: 1n 50V C0G 0603; C_0603_1608Metric; MPN CL10C102JB8NNNC; LCSC C163508
C257, C262, C263, C265, C266, C268, C269: 100n 50V X7R 0603; C_0603_1608Metric; MPN CL10B104KB8NNNC; LCSC C1591
C260, C261: 33p 50V C0G 0603; C_0603_1608Metric; MPN CL10C330JB8NNNC; LCSC C1663
C264: 470p 50V C0G 0603; C_0603_1608Metric; MPN CL10C471JB8NNNC; LCSC C27694
C267: 33n 50V X7R 0603; C_0603_1608Metric; MPN CL10B333KB8NNNC; LCSC C21117
L251: 220u 0.36A; L_SXN_SM5845; MPN SM5845-221MT; LCSC C10123
Q251: 2N7002; SOT-23; MPN 2N7002; LCSC C8545
R251: 280k 1% 0805; R_0805_2012Metric; MPN 0805W8F2803T5E; LCSC C17597
R252: 71.5k 1% 0603; R_0603_1608Metric; MPN 0603WAF7152T5E; LCSC C23103
R253, R255, R259, R261, R265, R268, R270: 10k 1% 0603; R_0603_1608Metric; MPN 0603WAF1002T5E; LCSC C25804
R254: 51.1k 1% 0805; R_0805_2012Metric; MPN 0805W8F5112T5E; LCSC C17731
R256: 82k 1% 0603; R_0603_1608Metric; MPN 0603WAF8202T5E; LCSC C23254
R257: 1M 1% 0603; R_0603_1608Metric; MPN 0603WAF1004T5E; LCSC C22935
R258: 1k 1% 0603; R_0603_1608Metric; MPN 0603WAF1001T5E; LCSC C21190
R260: 100 1% 0603; R_0603_1608Metric; MPN 0603WAF1000T5E; LCSC C22775
R262: 3.9k 1% 0603; R_0603_1608Metric; MPN 0603WAF3901T5E; LCSC C23018
R263: 150k 0.1% 0805; R_0805_2012Metric; MPN RT0805BRD07150KL; LCSC C136927
R264: 10.0k 0.1% 0603; R_0603_1608Metric; MPN RT0603BRD0710KL; LCSC C95204
R266: 866k 1% 0603; R_0603_1608Metric; MPN 0603WAF8663T5E; LCSC C23257
R267: 3.3k 1% 0603; R_0603_1608Metric; MPN 0603WAF3301T5E; LCSC C22978
R269: 15k 1% 0603; R_0603_1608Metric; MPN 0603WAF1502T5E; LCSC C22809
R271: 4.99k 1% 0603; R_0603_1608Metric; MPN 0603WAF4991T5E; LCSC C23046
U251: LM5019; SOIC-8-1EP_3.9x4.9mm_P1.27mm_EP2.95x4.9mm_Mask2.71x3.4mm; MPN LM5019MRX/NOPB; LCSC C471034
U252: HT7550-1 5V; SOT-89-3; MPN HT7550-1; LCSC C16106
U253: 74LVC1GU04; SOT-23-5; MPN SN74LVC1GU04DBVR; LCSC C81934
U254: 74HC4017; SOIC-16_3.9x9.9mm_P1.27mm; MPN 74HC4017D,653; LCSC C148206
U255: 74LVC1G123; SSOP-8_2.95x2.8mm_P0.65mm; MPN SN74LVC1G123DCTR; LCSC C123302
U256: 74LVC1G08; SOT-23-5; MPN SN74LVC1G08DBVR; LCSC C7666
U257: LM393; SOIC-8_3.9x4.9mm_P1.27mm; MPN LM393DR2G; LCSC C7955
U258: TL431B; SOT-23; MPN TL431BIDBZR; LCSC C41283
U259: 74LVC2G08; TSSOP-8_3x3mm_P0.65mm; MPN 74LVC2G08DP,125; LCSC C406037
Y251: 7.3728MHz 20pF; Crystal_SMD_HC49-SD; MPN SXMH7.3728F2020F30; LCSC C2901749

Connections:
/iso_aux/CLK_OK: U255.5 (Q), U256.2
/iso_aux/VBD: C267.1, R263.2, R264.1, U257.2 (-)
/iso_aux/VREF_D: R262.2, R265.1, U257.6 (-), U258.1 (K), U258.2 (REF)
ACF_PULSE: U259.3; also elsewhere on the board
ACF_SYNC: R260.2, R261.1; also elsewhere on the board
DRV_FWD: R270.1; also elsewhere on the board
unnamed: C256.1, C257.1, R256.2
unnamed: C260.1, R257.1, U253.2, Y251.1
unnamed: C261.1, R257.2, R258.2, Y251.2
unnamed: Q251.1 (G), R268.2, R269.1
unnamed: R260.1, U256.4
unnamed: R266.2, R267.2, R268.1, U257.1
unnamed: R270.2, R271.1, U259.6
unnamed: C254.2, U251.7 (BST)
unnamed: C257.2, R252.2, R253.1, U251.5 (FB)
unnamed: R251.2, U251.4 (RON)
unnamed: C254.1, L251.1, R256.1, U251.8 (SW)
unnamed: R254.2, R255.1, U251.3 (ULVO)
unnamed: C253.1, U251.6 (VCC)
unnamed: R258.1, U253.4, U254.14 (CLK)
unnamed: U254.12 (Cout), U255.1 (~A)
unnamed: U254.2 (Q1), U256.1
unnamed: C264.2, U255.6 (Cext)
unnamed: C264.1, R259.2, U255.7 (RCext)
unnamed: R265.2, R266.1, U257.3 (+)
POE_LOSS_N: Q251.3 (D); also elsewhere on the board
V5_CLK: C259.1, C262.1, C263.1, C265.1, R259.1, U252.3 (VOUT), U253.5 (VCC), U254.16 (VDD), U255.2 (B), U255.3 (~CLR), U255.8 (VCC)
VPRI_RTN: C258.2, C259.2, C260.2, C261.2, C262.2, C263.2, C265.2, C266.2, R261.2, U252.1 (GND), U253.3 (GND), U254.8 (VSS), U254.13 (CKEN), U254.15 (Reset), U255.4 (GND), U256.3 (GND); also elsewhere on the board
VREF_ACF: C266.1, U256.5 (VCC); also elsewhere on the board
VSR: C255.1, C256.2, C268.1, L251.2, R252.1, R262.1, R267.1, U257.8 (V+); also elsewhere on the board

Notes on the sheet:
V5_CLK 5 V, <= 10 mA: oscillator, counter, one-shot (0.1 W in the SOT-89)
7.3728 MHz, CL 20 pF, +-50 ppm all-in (SXMH7.3728F2020F30, -40..85 C): 33p + 33p + ~5 pF stray = 21.5 pF. Rf 1M, Rs 1k (drive ~70 uW).
Q1: one 136 ns pulse per 10 clocks = 737.28 kHz (< (1 - DMAX) x T = 0.39 us). CP1 and MR low.
Clock-OK: retriggered by CO; Rext 10k / Cext 470p -> tw ~ 4.5 us (> 1.36 us CO period, <= 10 us). Clock stops -> CLK_OK low within ~4.5 us -> SYNC low -> UCC2897A free-runs (590-708 kHz). B triggers on A falling edges with B held high.
Only this gate runs from VREF, so SYNC <= VREF + 0.3 V in every state; 10k holds SYNC low when VREF is off (IOFF output). VREF budget <= 0.6 mA of 5 mA. B-sync-clock.md
PRIMARY SYNC CLOCK (VPRI_RTN) -> UCC2897A SYNC
ISOLATION BARRIER
Nothing crosses here: the clock stays primary, the detector and buffer are secondary.
VSR 10 V (9.7-10.3), <= 37 mA: NCP4306s, TL431s, opto LED, INA281, droop comparator. Starts at VBUS 7.48 V (51.1k/10k), dropout below ~10.6 V. 400 kHz (RON 280k); Type III Rr 82k, Cr 1n, Cac 100n. B-bias.md
VSR 10 V BIAS BUCK (SECONDARY)
POE_LOSS_N low when VBUS < 39.5 V (38.5-40.5), released > 41.1 V (40.0-42.2); 150k/10k 0.1 %, 33n: tau 0.31 ms. 2N7002 via 10k/15k (gate 0.42 V max when off). Pull-up 4.7k to +3V3 at the FPGA (block E). B-vbus-droop.md
VBUS DROOP DETECTOR
DRV_FWD (10 V forward-SR gate) / 3 -> 3.33 V -> gate B (+3V3, 5.5 V-tolerant inputs) -> ACF_PULSE: one edge per conduction pulse, 737.28 kHz locked. FPGA B6 via block E's 4.7k; clock-fault rule in B-interfaces.md. Gate A unused.
ACF_PULSE BUFFER (+3V3)

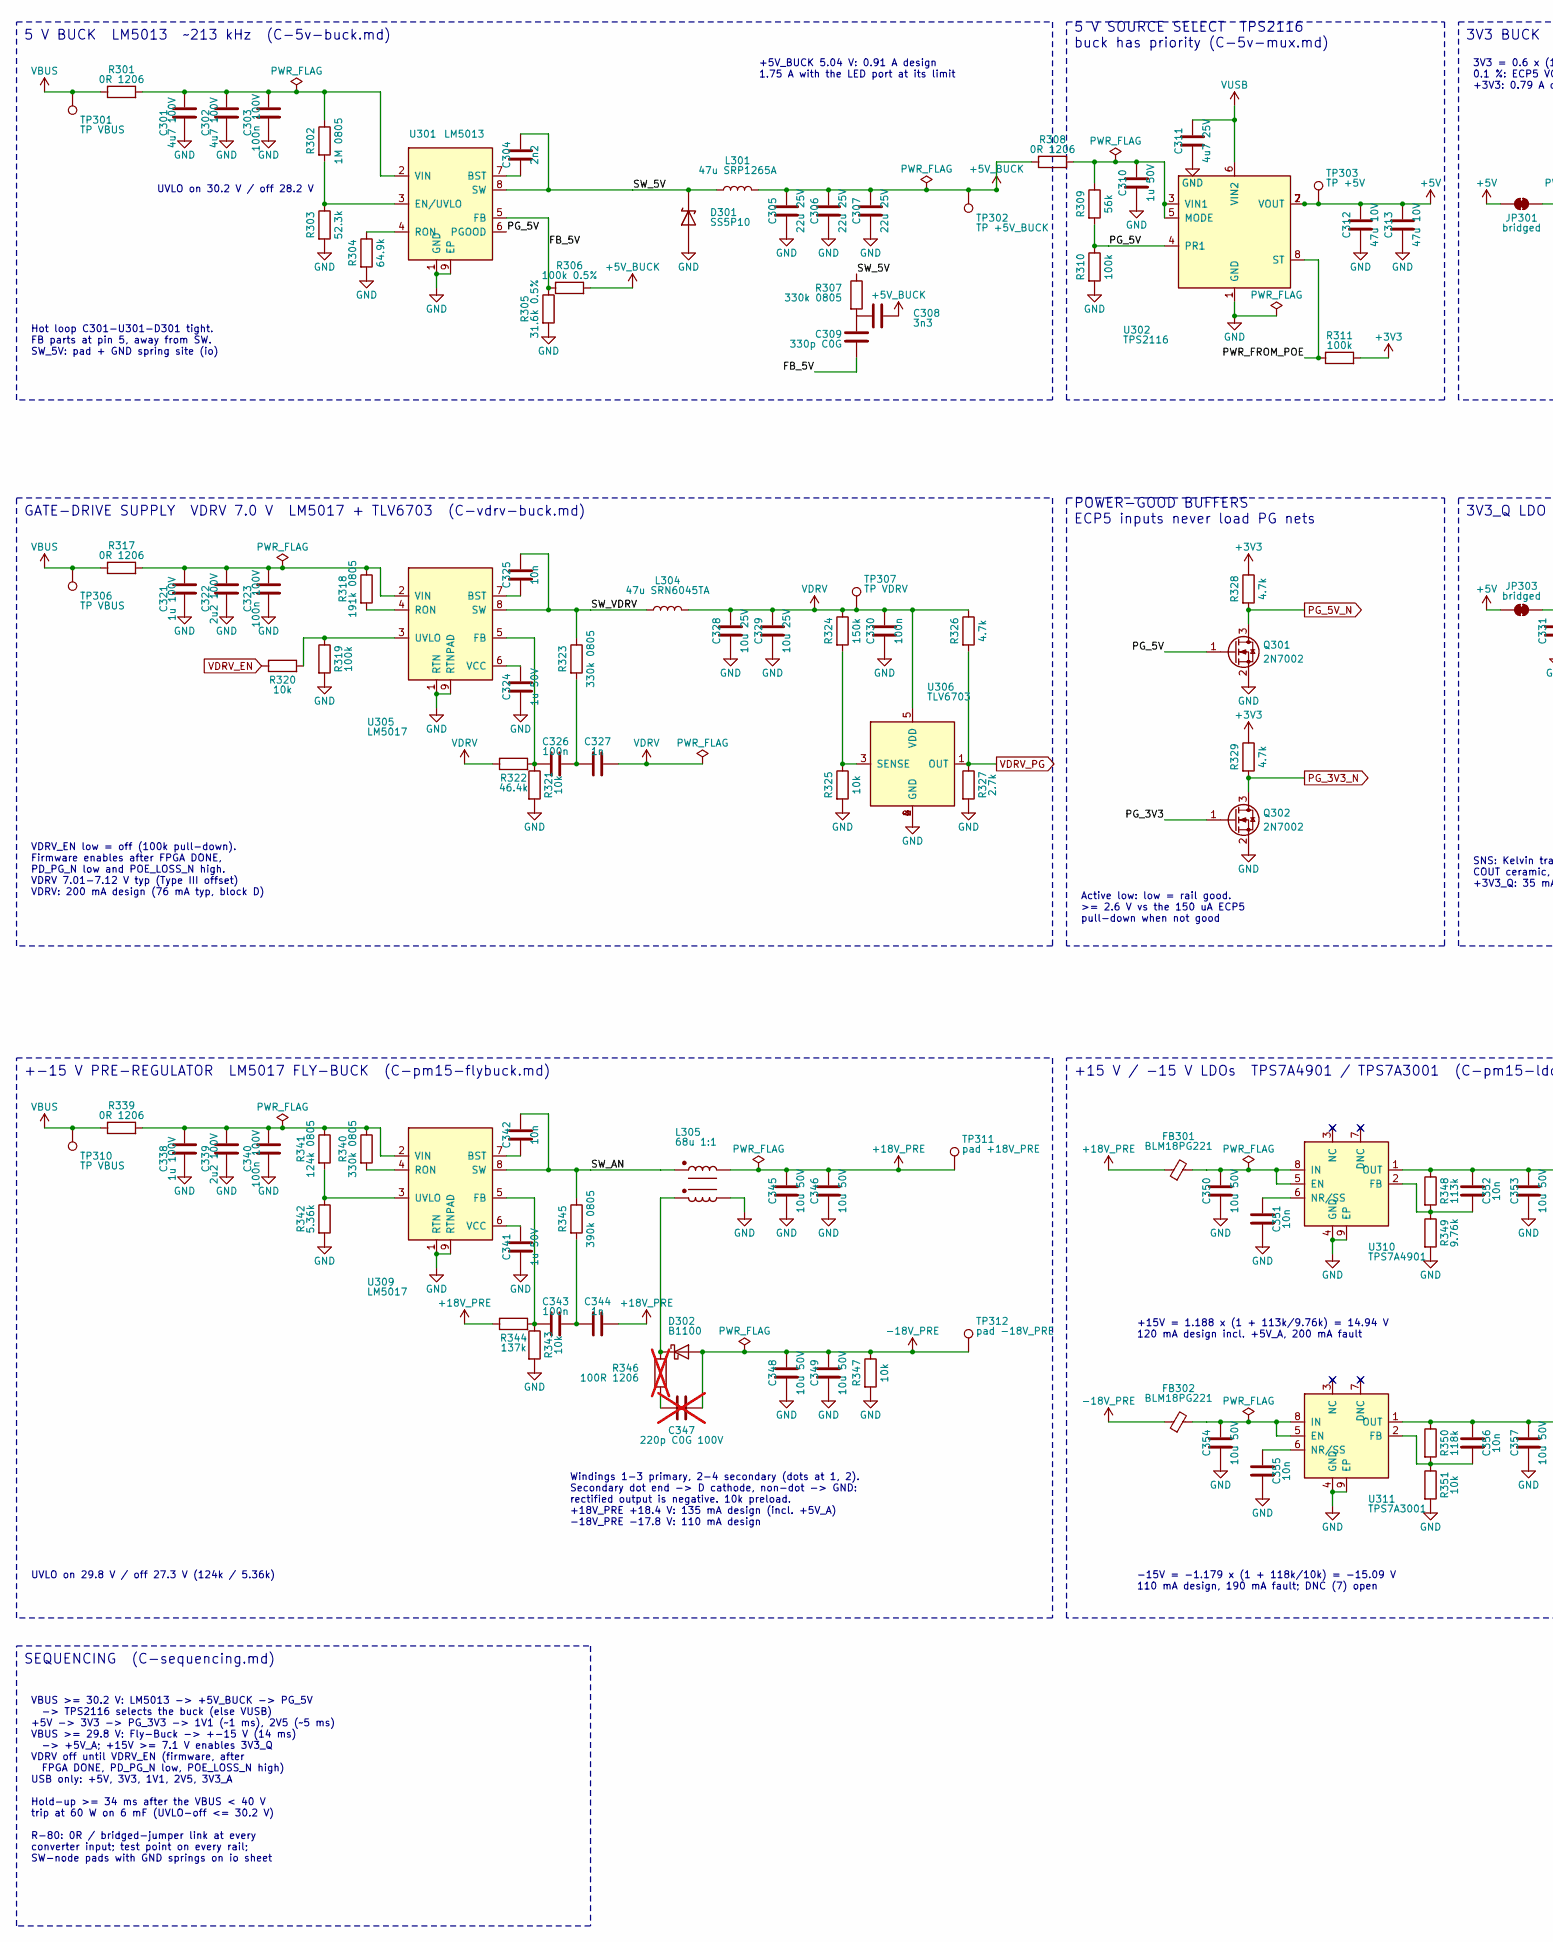
[picture p21: schematic rails.kicad_sch, Studio Amp satellite: Secondary rails and sequencing, part in row 1, column 1]

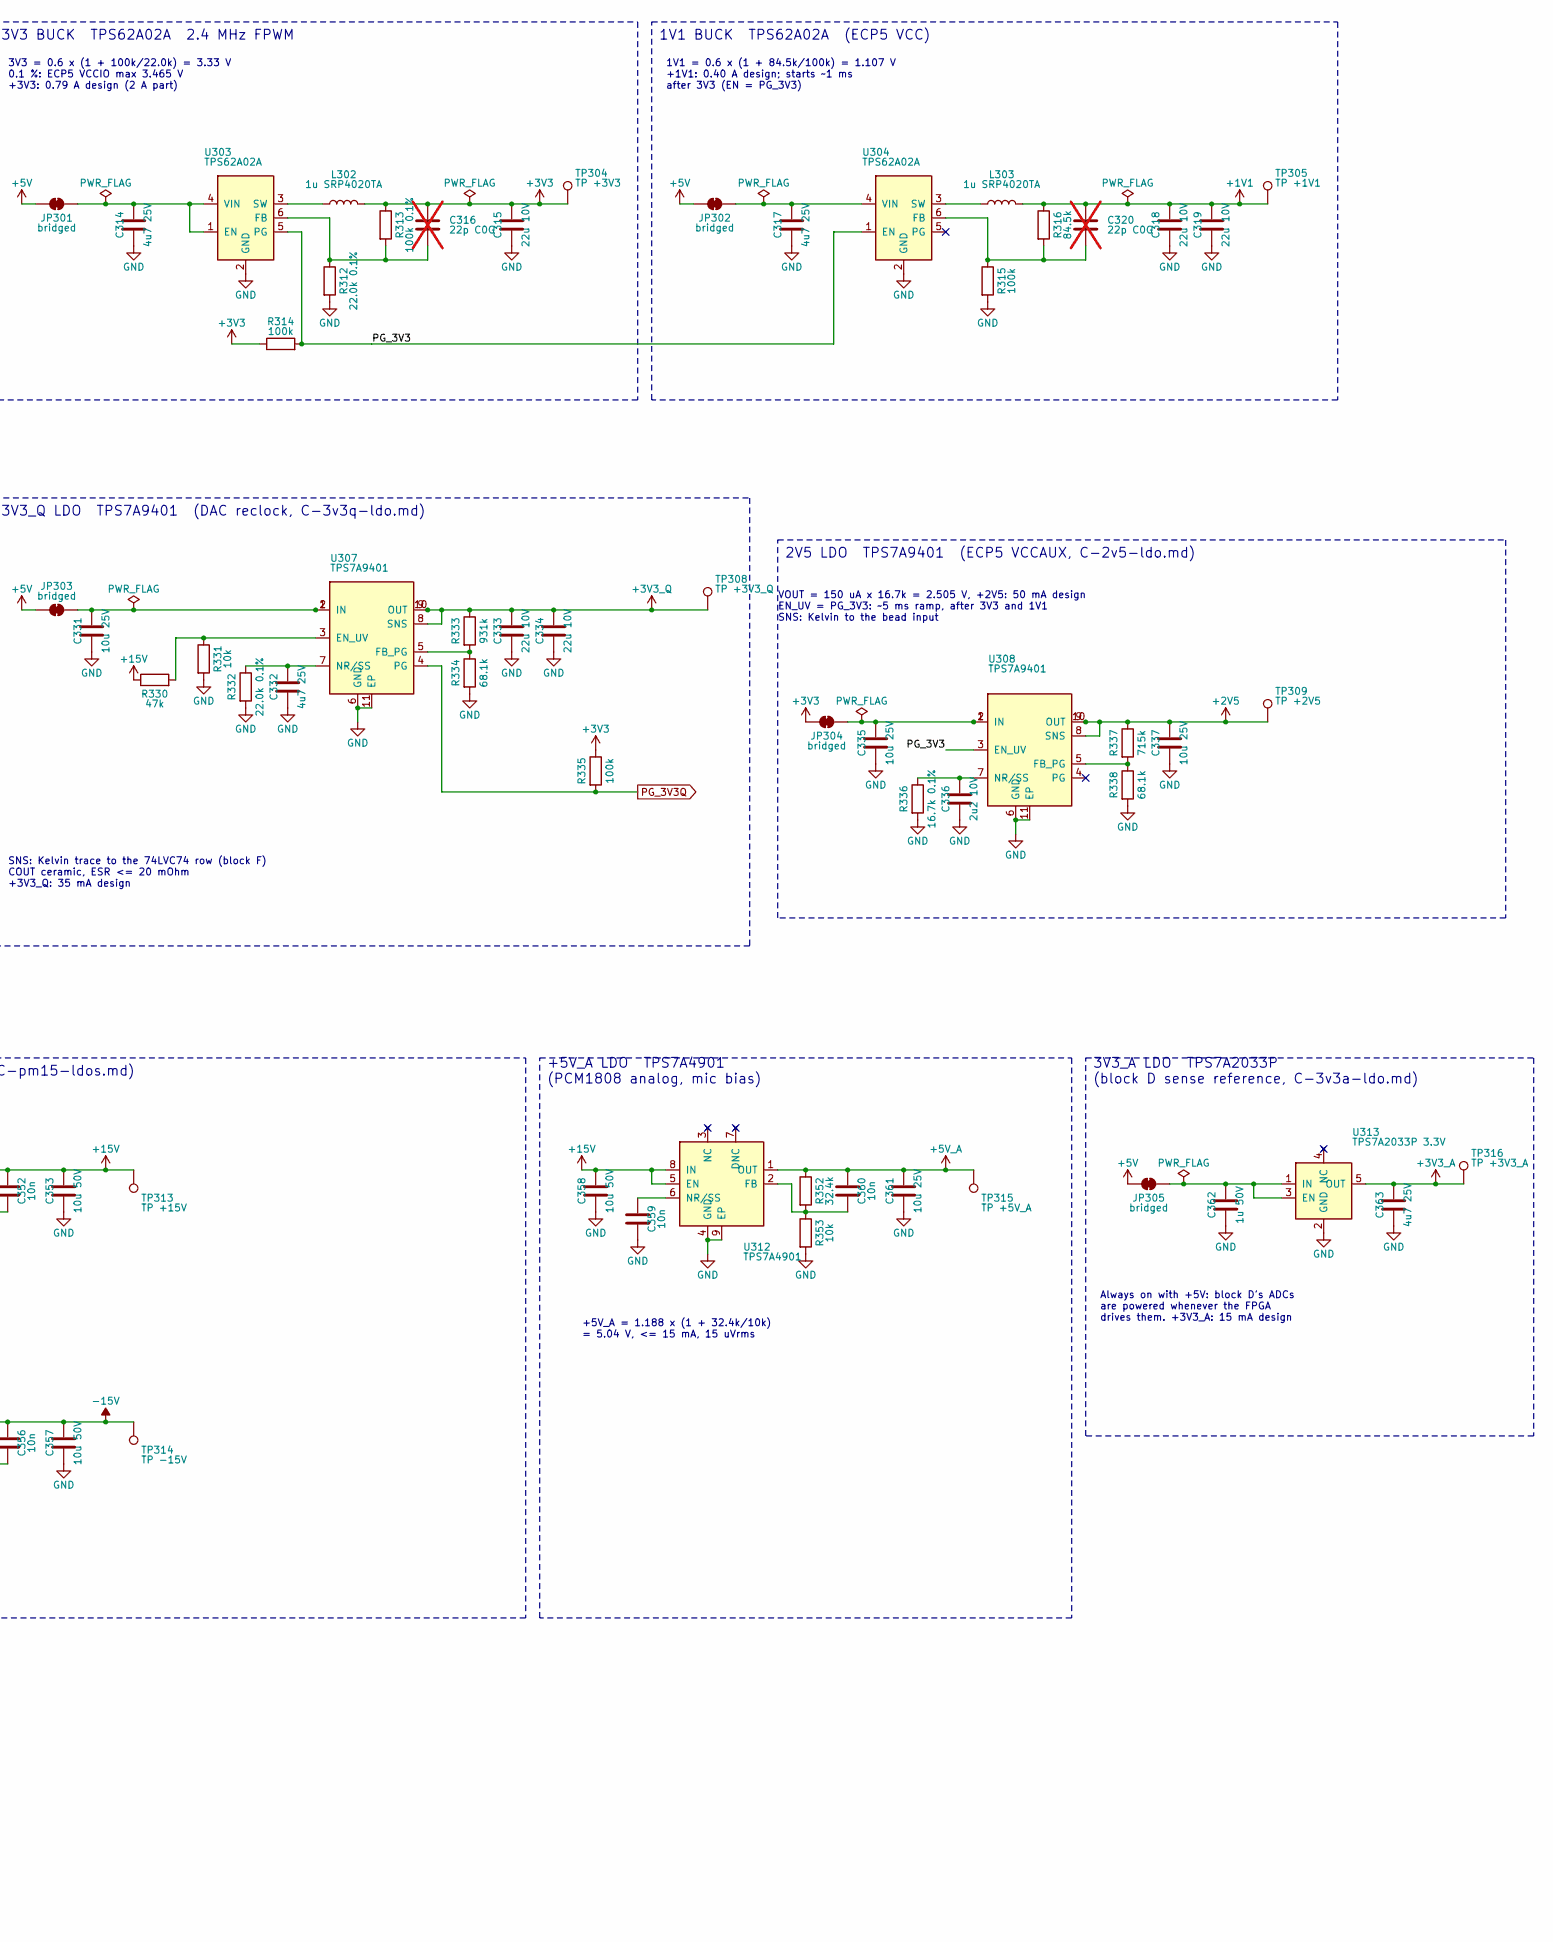
[picture p22: schematic rails.kicad_sch, Studio Amp satellite: Secondary rails and sequencing, part in row 1, column 2]

Parts:
C301, C302: 4u7 100V; C_1210_3225Metric; MPN FS32X475K101EGG; LCSC C381466
C303, C323, C340: 100n 100V; C_0603_1608Metric; MPN 0603B104K101NT; LCSC C88219
C304: 2n2; C_0603_1608Metric; MPN 0603B222K500NT; LCSC C1604
C305, C306, C307: 22u 25V; C_1206_3216Metric; MPN CL31A226KAHNNNE; LCSC C12891
C308: 3n3; C_0603_1608Metric; MPN CL10B332KB8NNNC; LCSC C1613
C309: 330p C0G; C_0603_1608Metric; MPN CL10C331JB8NNNC; LCSC C1664
C310, C324, C341, C362: 1u 50V; C_0603_1608Metric; MPN CL10A105KB8NNNC; LCSC C15849
C311, C314, C317, C332, C363: 4u7 25V; C_0805_2012Metric; MPN CL21A475KAQNNNE; LCSC C1779
C312, C313: 47u 10V; C_1206_3216Metric; MPN CL31A476MPHNNNE; LCSC C96123
C315, C318, C319, C333, C334: 22u 10V; C_0805_2012Metric; MPN CL21A226MPQNNNE; LCSC C29277
C316, C320: 22p C0G; C_0603_1608Metric; MPN CL10C220JB8NNNC; LCSC C1653; not fitted
C321, C338: 1u 100V; C_1206_3216Metric; MPN CL31B105KCHNNNE; LCSC C13832
C322, C339: 2u2 100V; C_1210_3225Metric; MPN CL32B225KCJSNNE; LCSC C55151
C325, C342, C351, C352, C355, C356, C359, C360: 10n; C_0603_1608Metric; MPN 0603B103K500NT; LCSC C57112
C326, C330, C343: 100n; C_0603_1608Metric; MPN CC0603KRX7R9BB104; LCSC C14663
C327, C344: 1n; C_0603_1608Metric; MPN CL10B102KB8NNNC; LCSC C1588
C328, C329, C361: 10u 25V; C_1206_3216Metric; MPN CL31B106KAHNNNE; LCSC C14860
C331, C335, C337: 10u 25V; C_0805_2012Metric; MPN CL21A106KAYNNNE; LCSC C15850
C336: 2u2 10V; C_0603_1608Metric; MPN CC0603KRX7R6BB225; LCSC C513691
C345, C346, C348, C349, C350, C353, C354, C357: 10u 50V; C_1210_3225Metric; MPN UMK325AB7106KM-P; LCSC C337485
C347: 220p C0G 100V; C_0603_1608Metric; MPN AC0603JRNPO0BN221; LCSC C2982813; not fitted
C358: 10u 50V; C_1206_3216Metric; MPN CL31B106KBHNNNE; LCSC C89632
D301: SS5P10; TO-277A; MPN SS5P10-M3/86A; LCSC C46986
D302: B1100; D_SMA; MPN B1100-13-F; LCSC C110106
FB301, FB302: BLM18PG221; L_0603_1608Metric; MPN BLM18PG221SN1D; LCSC C80165
JP301, JP302, JP303, JP304, JP305: bridged; SolderJumper-2_P1.3mm_Bridged_RoundedPad1.0x1.5mm
L301: 47u SRP1265A; L_Bourns_SRP1265A; MPN SRP1265A-470M; LCSC C840530
L302, L303: 1u SRP4020TA; L_Bourns_SRP4020TA; MPN SRP4020TA-1R0M; LCSC C913245
L304: 47u SRN6045TA; L_Bourns_SRN6045TA; MPN SRN6045TA-470M; LCSC C5151734
L305: 68u 1:1; L_PROD_PSSCAQ7048; MPN PSSCAQ7048M-680M; LCSC C56266204
Q301, Q302: 2N7002; SOT-23; MPN 2N7002; LCSC C8545
R301, R308, R317, R339: 0R 1206; R_1206_3216Metric; MPN 1206W4F0000T5E; LCSC C17888
R302: 1M 0805; R_0805_2012Metric; MPN 0805W8F1004T5E; LCSC C17514
R303: 52.3k; R_0603_1608Metric; MPN 0603WAF5232T5E; LCSC C23198
R304: 64.9k; R_0603_1608Metric; MPN 0603WAF6492T5E; LCSC C14891
R305: 31.6k 0.5%; R_0603_1608Metric; MPN 0603WAD3162T5E; LCSC C423046
R306: 100k 0.5%; R_0603_1608Metric; MPN 0603WAD1003T5E; LCSC C423093
R307, R323, R340: 330k 0805; R_0805_2012Metric; MPN 0805W8F3303T5E; LCSC C17629
R309: 56k; R_0603_1608Metric; MPN 0603WAF5602T5E; LCSC C23206
R310, R311, R314, R315, R319, R335: 100k; R_0603_1608Metric; MPN 0603WAF1003T5E; LCSC C25803
R312, R332: 22.0k 0.1%; R_0603_1608Metric; MPN RT0603BRD0722KL; LCSC C469656
R313: 100k 0.1%; R_0603_1608Metric; MPN RT0603BRD07100KL; LCSC C122538
R316: 84.5k; R_0603_1608Metric; MPN 0603WAF8452T5E; LCSC C23118
R318: 191k 0805; R_0805_2012Metric; MPN 0805W8F1913T5E; LCSC C17511
R320, R321, R325, R331, R343, R347, R351, R353: 10k; R_0603_1608Metric; MPN 0603WAF1002T5E; LCSC C25804
R322: 46.4k; R_0603_1608Metric; MPN 0603WAF4642T5E; LCSC C23059
R324: 150k; R_0603_1608Metric; MPN 0603WAF1503T5E; LCSC C22807
R326, R328, R329: 4.7k; R_0603_1608Metric; MPN 0603WAF4701T5E; LCSC C23162
R327: 2.7k; R_0603_1608Metric; MPN 0603WAF2701T5E; LCSC C13167
R330: 47k; R_0603_1608Metric; MPN 0603WAF4702T5E; LCSC C25819
R333: 931k; R_0603_1608Metric; MPN 0603WAF9313T5E; LCSC C246847
R334, R338: 68.1k; R_0603_1608Metric; MPN 0603WAF6812T5E; LCSC C25976
R336: 16.7k 0.1%; R_0603_1608Metric; MPN RT0603BRD0716K7L; LCSC C861155
R337: 715k; R_0603_1608Metric; MPN 0603WAF7153T5E; LCSC C23237
R341: 124k 0805; R_0805_2012Metric; MPN 0805W8F1243T5E; LCSC C17440
R342: 5.36k; R_0603_1608Metric; MPN 0603WAF5361T5E; LCSC C25973
R344: 137k; R_0603_1608Metric; MPN 0603WAF1373T5E; LCSC C22872
R345: 390k 0805; R_0805_2012Metric; MPN 0805W8F3903T5E; LCSC C17656
R346: 100R 1206; R_1206_3216Metric; MPN 1206W4F1000T5E; LCSC C17901; not fitted
R348: 113k; R_0603_1608Metric; MPN 0603WAF1133T5E; LCSC C22862
R349: 9.76k; R_0603_1608Metric; MPN 0603WAF9761T5E; LCSC C23128
R350: 118k; R_0603_1608Metric; MPN 0603WAF1183T5E; LCSC C25806
R352: 32.4k; R_0603_1608Metric; MPN 0603WAF3242T5E; LCSC C13187
TP301, TP306, TP310: TP VBUS; TestPoint_Keystone_5015_Micro_Mini; MPN 5015; LCSC C2906768
TP302: TP +5V_BUCK; TestPoint_Keystone_5015_Micro_Mini; MPN 5015; LCSC C2906768
TP303: TP +5V; TestPoint_Keystone_5015_Micro_Mini; MPN 5015; LCSC C2906768
TP304: TP +3V3; TestPoint_Keystone_5015_Micro_Mini; MPN 5015; LCSC C2906768
TP305: TP +1V1; TestPoint_Keystone_5015_Micro_Mini; MPN 5015; LCSC C2906768
TP307: TP VDRV; TestPoint_Keystone_5015_Micro_Mini; MPN 5015; LCSC C2906768
TP308: TP +3V3_Q; TestPoint_Keystone_5015_Micro_Mini; MPN 5015; LCSC C2906768
TP309: TP +2V5; TestPoint_Keystone_5015_Micro_Mini; MPN 5015; LCSC C2906768
TP311: pad +18V_PRE; TestPoint_Pad_D1.0mm
TP312: pad -18V_PRE; TestPoint_Pad_D1.0mm
TP313: TP +15V; TestPoint_Keystone_5015_Micro_Mini; MPN 5015; LCSC C2906768
TP314: TP -15V; TestPoint_Keystone_5015_Micro_Mini; MPN 5015; LCSC C2906768
TP315: TP +5V_A; TestPoint_Keystone_5015_Micro_Mini; MPN 5015; LCSC C2906768
TP316: TP +3V3_A; TestPoint_Keystone_5015_Micro_Mini; MPN 5015; LCSC C2906768
U301: LM5013; TI_SO-PowerPAD-8; MPN LM5013DDAR; LCSC C5383001
U302: TPS2116; SOT-583-8; MPN TPS2116DRLR; LCSC C3235557
U303, U304: TPS62A02A; TSOT-23-6; MPN TPS62A02APDDCR; LCSC C25687169
U305, U309: LM5017; TI_SO-PowerPAD-8; MPN LM5017MRX/NOPB; LCSC C34355
U306: TLV6703; TSOT-23-6; MPN TLV6703DDCT; LCSC C2877614
U307, U308: TPS7A9401; Texas_DSC0010J; MPN TPS7A9401DSCR; LCSC C5220127
U310, U312: TPS7A4901; HVSSOP-8-1EP_3x3mm_P0.65mm_EP1.57x1.89mm; MPN TPS7A4901DGNR; LCSC C16430
U311: TPS7A3001; HVSSOP-8-1EP_3x3mm_P0.65mm_EP1.57x1.89mm; MPN TPS7A3001DGNR; LCSC C33835
U313: TPS7A2033P 3.3V; SOT-23-5; MPN TPS7A2033PDBVR; LCSC C2862740

Connections:
+2V5: C337.1, R337.1, TP309.1, U308.8 (SNS), U308.9 (OUT), U308.10 (OUT); also elsewhere on the board
+3V3_A: C363.1, TP316.1, U313.5 (OUT); also elsewhere on the board
+3V3_Q: C333.1, C334.1, R333.1, TP308.1, U307.8 (SNS), U307.9 (OUT), U307.10 (OUT); also elsewhere on the board
+5V: C312.1, C313.1, JP301.1 (A), JP302.1 (A), JP303.1 (A), JP305.1 (A), TP303.1, U302.2 (VOUT), U302.7 (VOUT); also elsewhere on the board
+5V_A: C360.1, C361.1, R352.1, TP315.1, U312.1 (OUT); also elsewhere on the board
+15V: C352.1, C353.1, C358.1, R330.1, R348.1, TP313.1, U310.1 (OUT), U312.5 (EN), U312.8 (IN); also elsewhere on the board
-15V: C356.1, C357.1, R350.1, TP314.1, U311.1 (OUT); also elsewhere on the board
/rails/FB_5V: C309.2, R305.1, R306.1, U301.5 (FB)
/rails/PG_3V3: Q302.1 (G), R314.2, U303.5 (PG), U304.1 (EN), U308.3 (EN_UV)
/rails/PG_5V: Q301.1 (G), R309.2, R310.1, U301.6 (PGOOD), U302.4 (PR1)
/rails/PWR_FROM_POE: R311.1, U302.8 (ST)
/rails/SW_5V: C304.1, D301.3 (K), L301.1, R307.1, U301.8 (SW)
/rails/SW_AN: C342.1, L305.1, R345.1, U309.8 (SW)
/rails/SW_VDRV: C325.1, L304.1, R323.1, U305.8 (SW)
unnamed: C308.1, C309.1, R307.2
unnamed: C326.2, C327.1, R323.2
unnamed: C343.2, C344.1, R345.2
unnamed: C347.1, R346.2
unnamed: D302.1 (K), L305.2, R346.1
unnamed: C304.2, U301.7 (BST)
unnamed: R302.2, R303.1, U301.3 (EN/UVLO)
unnamed: R304.1, U301.4 (RON)
unnamed: C316.2, R312.1, R313.2, U303.6 (FB)
unnamed: L302.1, U303.3 (SW)
unnamed: C320.2, R315.1, R316.2, U304.6 (FB)
unnamed: L303.1, U304.3 (SW)
unnamed: C325.2, U305.7 (BST)
unnamed: C326.1, R321.1, R322.2, U305.5 (FB)
unnamed: R318.2, U305.4 (RON)
unnamed: R319.1, R320.2, U305.3 (UVLO)
unnamed: C324.1, U305.6 (VCC)
unnamed: R324.2, R325.1, U306.3 (SENSE)
unnamed: R330.2, R331.1, U307.3 (EN_UV)
unnamed: R333.2, R334.1, U307.5 (FB_PG)
unnamed: C332.1, R332.1, U307.7 (NR/SS)
unnamed: R337.2, R338.1, U308.5 (FB_PG)
unnamed: C336.1, R336.1, U308.7 (NR/SS)
unnamed: C342.2, U309.7 (BST)
unnamed: C343.1, R343.1, R344.2, U309.5 (FB)
unnamed: R340.2, U309.4 (RON)
unnamed: R341.2, R342.1, U309.3 (UVLO)
unnamed: C341.1, U309.6 (VCC)
unnamed: C352.2, R348.2, R349.1, U310.2 (FB)
unnamed: C351.1, U310.6 (NR/SS)
unnamed: C356.2, R350.2, R351.1, U311.2 (FB)
unnamed: C355.1, U311.6 (NR/SS)
unnamed: C360.2, R352.2, R353.1, U312.2 (FB)
unnamed: C359.1, U312.6 (NR/SS)
PG_3V3Q: R335.2, U307.4 (PG); also elsewhere on the board
PG_3V3_N: Q302.3 (D), R329.2; also elsewhere on the board
PG_5V_N: Q301.3 (D), R328.2; also elsewhere on the board
VDRV_EN: R320.1; also elsewhere on the board
VDRV_PG: R326.2, R327.1, U306.1 (OUT); also elsewhere on the board

Notes on the sheet:
5 V BUCK LM5013 ~213 kHz (C-5v-buck.md)
+5V_BUCK 5.04 V: 0.91 A design 1.75 A with the LED port at its limit
Hot loop C301-U301-D301 tight. FB parts at pin 5, away from SW. SW_5V: pad + GND spring site (io)
UVLO on 30.2 V / off 28.2 V
5 V SOURCE SELECT TPS2116 buck has priority (C-5v-mux.md)
3V3 BUCK TPS62A02A 2.4 MHz FPWM
3V3 = 0.6 x (1 + 100k/22.0k) = 3.33 V 0.1 %: ECP5 VCCIO max 3.465 V +3V3: 0.79 A design (2 A part)
1V1 BUCK TPS62A02A (ECP5 VCC)
1V1 = 0.6 x (1 + 84.5k/100k) = 1.107 V +1V1: 0.40 A design; starts ~1 ms after 3V3 (EN = PG_3V3)
GATE-DRIVE SUPPLY VDRV 7.0 V LM5017 + TLV6703 (C-vdrv-buck.md)
VDRV_EN low = off (100k pull-down). Firmware enables after FPGA DONE, PD_PG_N low and POE_LOSS_N high. VDRV 7.01-7.12 V typ (Type III offset) VDRV: 200 mA design (76 mA typ, block D)
POWER-GOOD BUFFERS ECP5 inputs never load PG nets
Active low: low = rail good. >= 2.6 V vs the 150 uA ECP5 pull-down when not good
3V3_Q LDO TPS7A9401 (DAC reclock, C-3v3q-ldo.md)
SNS: Kelvin trace to the 74LVC74 row (block F) COUT ceramic, ESR <= 20 mOhm +3V3_Q: 35 mA design
2V5 LDO TPS7A9401 (ECP5 VCCAUX, C-2v5-ldo.md)
VOUT = 150 uA x 16.7k = 2.505 V, +2V5: 50 mA design EN_UV = PG_3V3: ~5 ms ramp, after 3V3 and 1V1 SNS: Kelvin to the bead input
+-15 V PRE-REGULATOR LM5017 FLY-BUCK (C-pm15-flybuck.md)
Windings 1-3 primary, 2-4 secondary (dots at 1, 2). Secondary dot end -> D cathode, non-dot -> GND: rectified output is negative. 10k preload. +18V_PRE +18.4 V: 135 mA design (incl. +5V_A) -18V_PRE -17.8 V: 110 mA design
UVLO on 29.8 V / off 27.3 V (124k / 5.36k)
+15 V / -15 V LDOs TPS7A4901 / TPS7A3001 (C-pm15-ldos.md)
+15V = 1.188 x (1 + 113k/9.76k) = 14.94 V 120 mA design incl. +5V_A, 200 mA fault
-15V = -1.179 x (1 + 118k/10k) = -15.09 V 110 mA design, 190 mA fault; DNC (7) open
+5V_A LDO TPS7A4901 (PCM1808 analog, mic bias)
+5V_A = 1.188 x (1 + 32.4k/10k) = 5.04 V, <= 15 mA, 15 uVrms
3V3_A LDO TPS7A2033P (block D sense reference, C-3v3a-ldo.md)
Always on with +5V: block D's ADCs are powered whenever the FPGA drives them. +3V3_A: 15 mA design
SEQUENCING (C-sequencing.md)
VBUS >= 30.2 V: LM5013 -> +5V_BUCK -> PG_5V -> TPS2116 selects the buck (else VUSB) +5V -> 3V3 -> PG_3V3 -> 1V1 (~1 ms), 2V5 (~5 ms) VBUS >= 29.8 V: Fly-Buck -> +-15 V (14 ms) -> +5V_A; +15V >= 7.1 V enables 3V3_Q VDRV off until VDRV_EN (firmware, after FPGA DONE, PD_PG_N low, POE_LOSS_N high) USB 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
