sequoia-hope/studio-amp/hw/satellite/a/satellite.kicad_pcb

## KiCad design hw/satellite/a/satellite.kicad_pcb (continued)

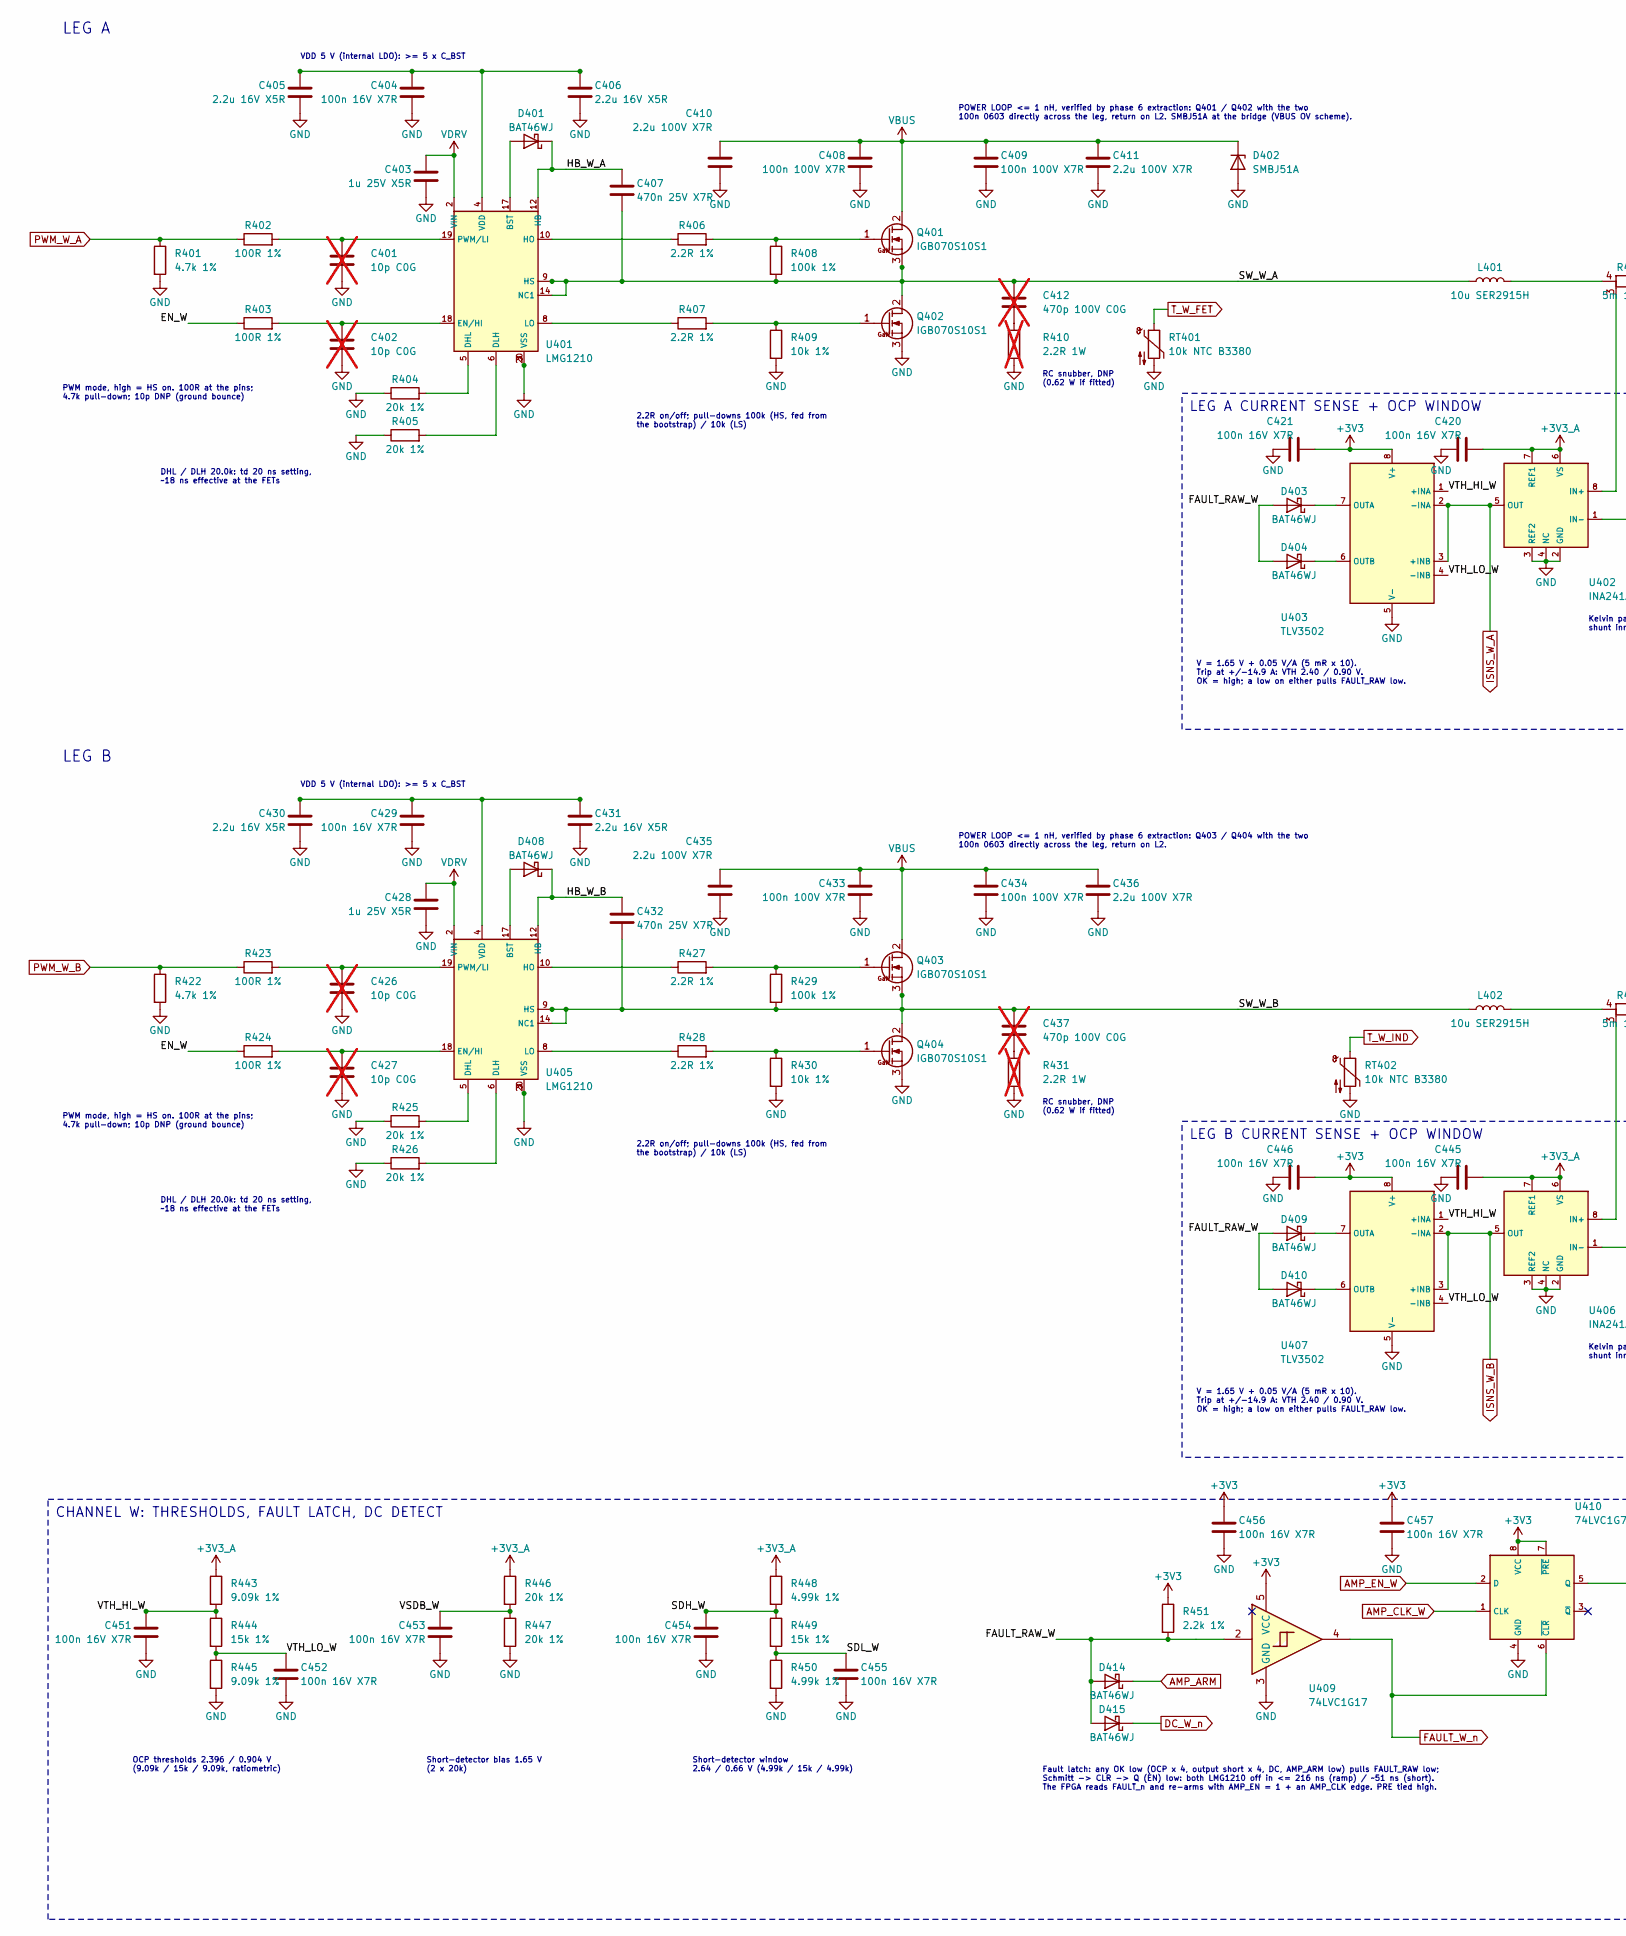
[picture p23: schematic amp_woofer.kicad_sch, Studio Amp satellite: GaN BTL power stage: woofer, part in row 1, column 1]

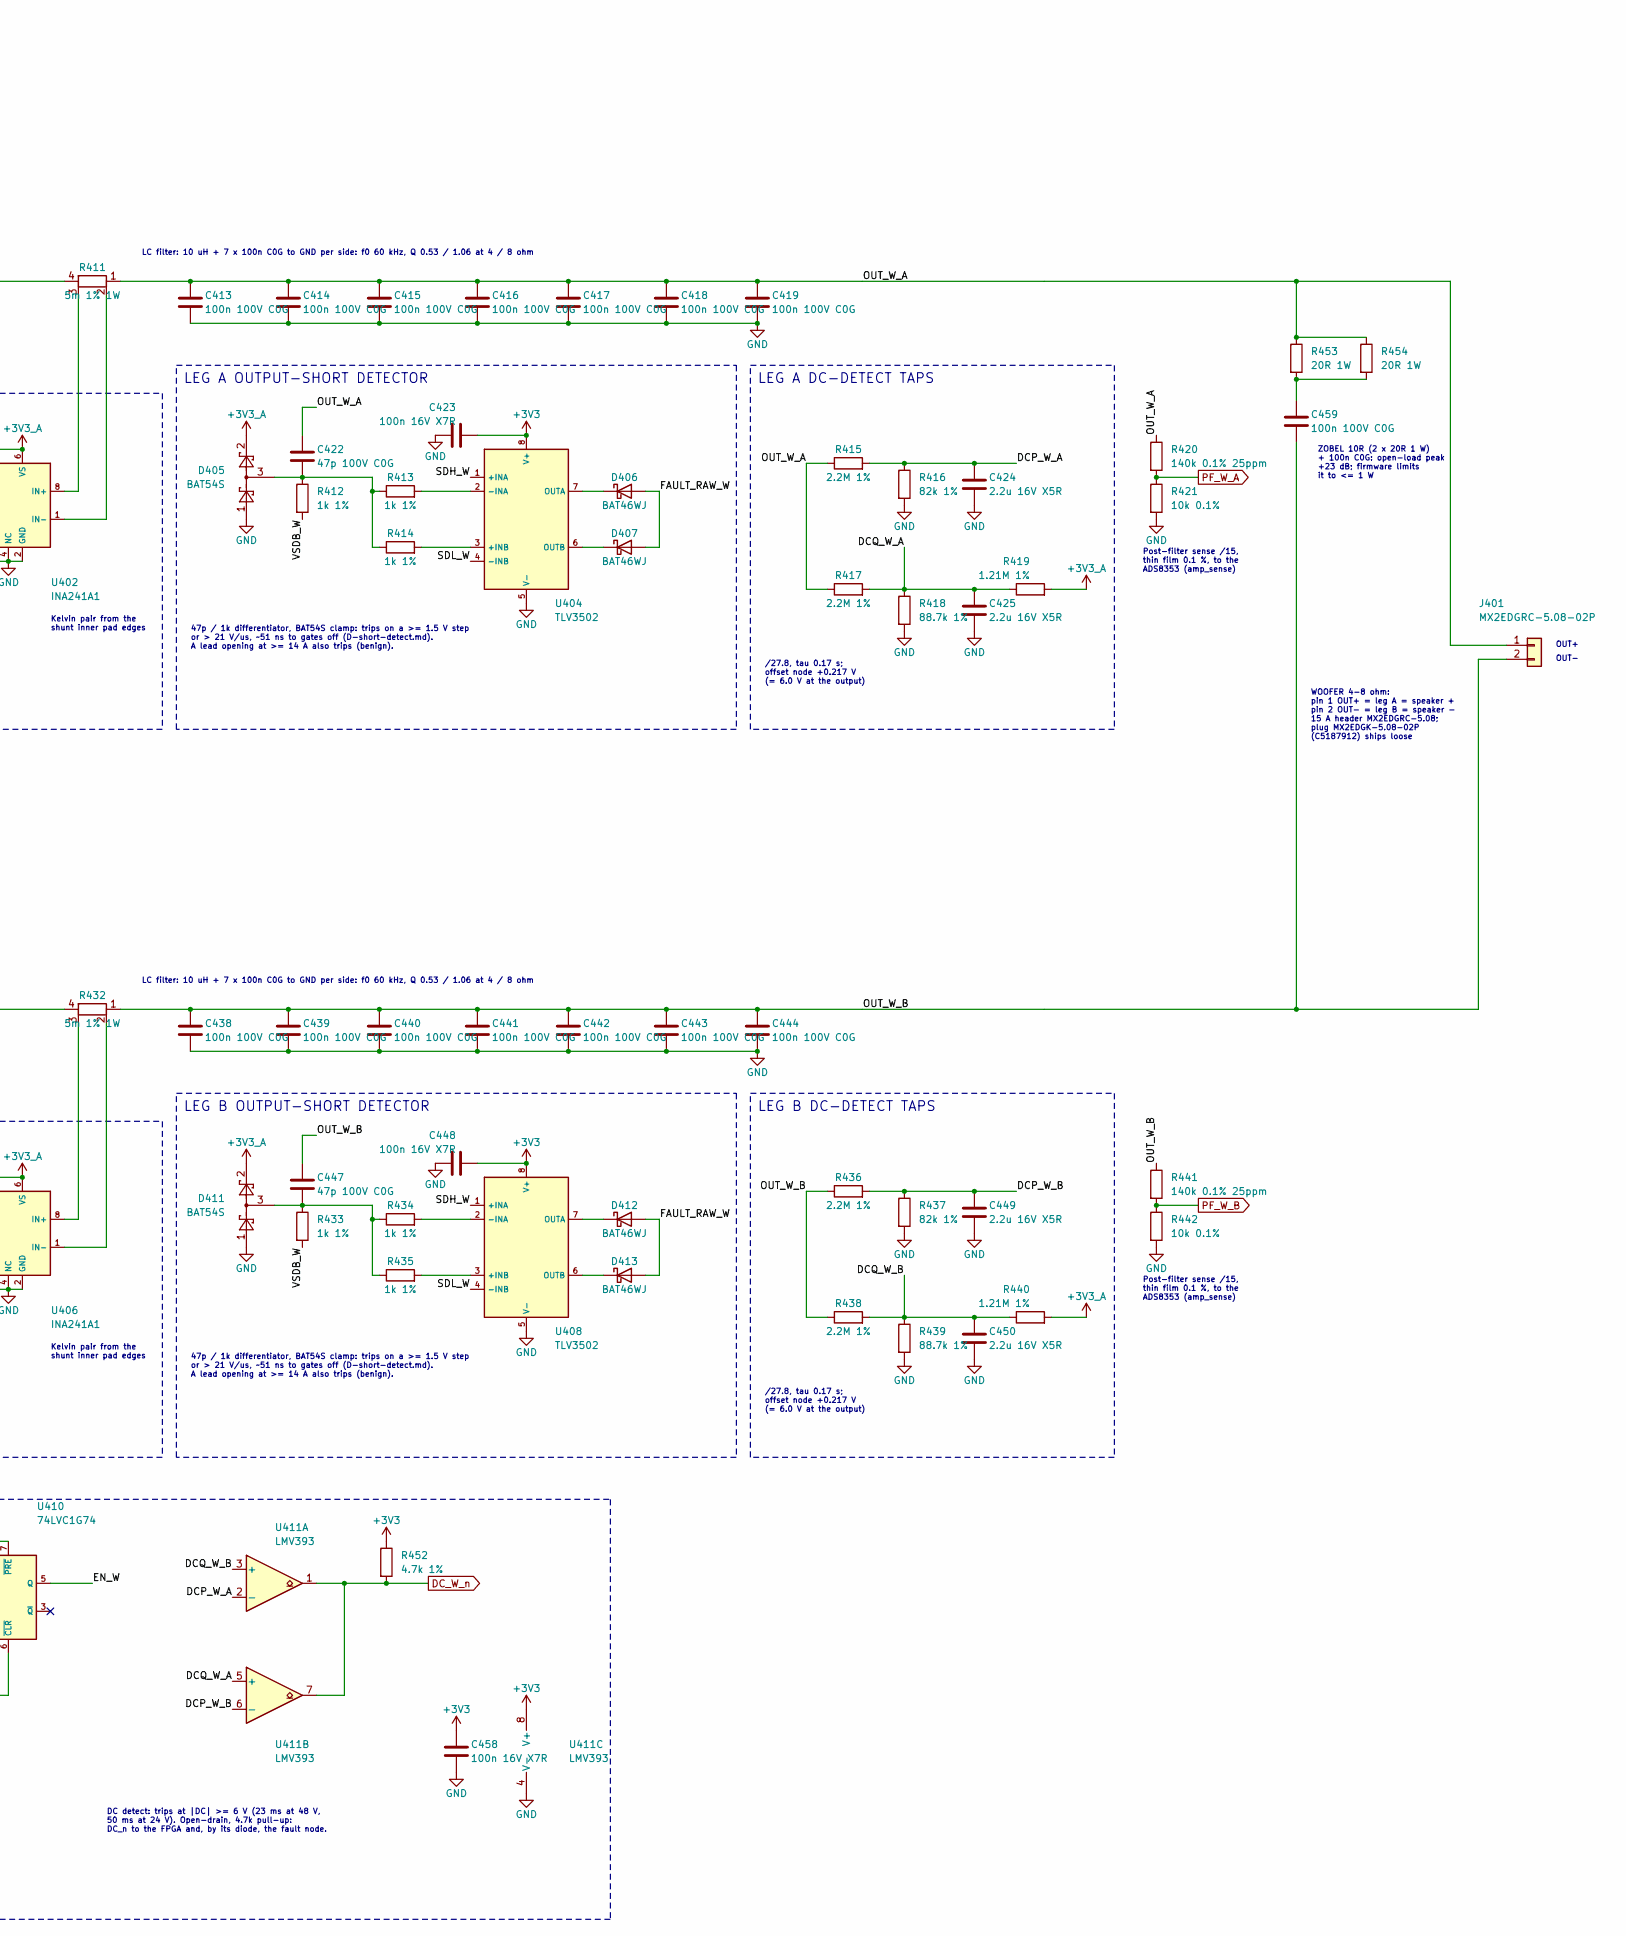
[picture p24: schematic amp_woofer.kicad_sch, Studio Amp satellite: GaN BTL power stage: woofer, part in row 1, column 2]

Parts:
C401, C402, C426, C427: 10p C0G; C_0402_1005Metric; MPN 0402N100J500CT; LCSC C301961; not fitted
C403, C428: 1u 25V X5R; C_0603_1608Metric; MPN CL10A105KA8NNNC; LCSC C5673
C404, C420, C421, C423, C429, C445, C446, C448, C451, C452, C453, C454, C455, C456, C457, C458: 100n 16V X7R; C_0402_1005Metric; MPN CC0402KRX7R7BB104; LCSC C60474
C405, C406, C424, C425, C430, C431, C449, C450: 2.2u 16V X5R; C_0603_1608Metric; MPN CL10A225KO8NNNC; LCSC C23630
C407, C432: 470n 25V X7R; C_0603_1608Metric; MPN CL10B474KA8NNNC; LCSC C1623
C408, C409, C433, C434: 100n 100V X7R; C_0603_1608Metric; MPN HMK107B7104KAHT; LCSC C268011
C410, C411, C435, C436: 2.2u 100V X7R; C_1210_3225Metric; MPN HMK325B7225KN-T; LCSC C92775
C412, C437: 470p 100V C0G; C_0603_1608Metric; MPN CC0603JRNPO0BN471; LCSC C326973; not fitted
C413, C414, C415, C416, C417, C418, C419, C438, C439, C440, C441, C442, C443, C444, C459: 100n 100V C0G; C_1206_3216Metric; MPN GRM31C5C2A104JA01L; LCSC C405303
C422, C447: 47p 100V C0G; C_0603_1608Metric; MPN CC0603JRNPO0BN470; LCSC C327115
D401, D403, D404, D406, D407, D408, D409, D410, D412, D413, D414, D415: BAT46WJ; D_SOD-323F; MPN BAT46WJ,115; LCSC C114696
D402: SMBJ51A; D_SMB; MPN SMBJ51A; LCSC C1973217
D405, D411: BAT54S; SOT-23; MPN BAT54S,215; LCSC C47546
J401: MX2EDGRC-5.08-02P; MAX_MX2EDGRC-5.08-02P_1x02_P5.08mm_Horizontal; MPN MX2EDGRC-5.08-02P-GN01-Cu-A; LCSC C5188019
L401, L402: 10u SER2915H; Coilcraft_SER2915H; MPN SER2915H-103KL; LCSC C19276042
Q401, Q402, Q403, Q404: IGB070S10S1; IGB070S10S1_PG-TSON-4; MPN IGB070S10S1XTMA1; LCSC C44179579
R401, R422, R452: 4.7k 1%; R_0402_1005Metric; MPN 0402WGF4701TCE; LCSC C25900
R402, R403, R423, R424: 100R 1%; R_0402_1005Metric; MPN RC0402FR-07100RL; LCSC C106232
R404, R405, R425, R426, R446, R447: 20k 1%; R_0402_1005Metric; MPN 0402WGF2002TCE; LCSC C25765
R406, R407, R427, R428: 2.2R 1%; R_0402_1005Metric; MPN FRC0402F2R20TS; LCSC C2909330
R408, R429: 100k 1%; R_0402_1005Metric; MPN 0402WGF1003TCE; LCSC C25741
R409, R430: 10k 1%; R_0402_1005Metric; MPN 0402WGF1002TCE; LCSC C25744
R410, R431: 2.2R 1W; R_2512_6332Metric; MPN 25121WJ022JT4E; LCSC C25480; not fitted
R411, R432: 5m 1% 1W; R_2512_6332Metric_Kelvin_NetTie; MPN PA2512FKF070R005E; LCSC C723365
R412, R413, R414, R433, R434, R435: 1k 1%; R_0402_1005Metric; MPN 0402WGF1001TCE; LCSC C11702
R415, R417, R436, R438: 2.2M 1%; R_0603_1608Metric; MPN 0603WAF2204T5E; LCSC C22938
R416, R437: 82k 1%; R_0603_1608Metric; MPN 0603WAF8202T5E; LCSC C23254
R418, R439: 88.7k 1%; R_0603_1608Metric; MPN 0603WAF8872T5E; LCSC C23258
R419, R440: 1.21M 1%; R_0603_1608Metric; MPN 0603WAF1214T5E; LCSC C422998
R420, R441: 140k 0.1% 25ppm; R_0603_1608Metric; MPN RT0603BRD07140KL; LCSC C861125
R421, R442: 10k 0.1%; R_0603_1608Metric; MPN RT0603BRD0710KL; LCSC C95204
R443, R445: 9.09k 1%; R_0402_1005Metric; MPN 0402WGF9091TCE; LCSC C11549
R444, R449: 15k 1%; R_0402_1005Metric; MPN 0402WGF1502TCE; LCSC C25756
R448, R450: 4.99k 1%; R_0402_1005Metric; MPN 0402WGF4991TCE; LCSC C25903
R451: 2.2k 1%; R_0402_1005Metric; MPN 0402WGF2201TCE; LCSC C25879
R453, R454: 20R 1W; R_2512_6332Metric; MPN 25121WF200JT4E; LCSC C41950
RT401, RT402: 10k NTC B3380; R_0402_1005Metric; MPN NCP15XH103F03RC; LCSC C77131
U401, U405: LMG1210; Texas_RVR0019A_WQFN-19-2EP_4x3mm_P0.5mm; MPN LMG1210RVRR; LCSC C2677136
U402, U406: INA241A1; SOT-23-8; MPN INA241A1IDDFR; LCSC C19712054
U403, U404, U407, U408: TLV3502; SOT-23-8; MPN TLV3502AIDCNR; LCSC C48618
U409: 74LVC1G17; SOT-23-5; MPN SN74LVC1G17DBVR; LCSC C7836
U410: 74LVC1G74; VSSOP-8_2.3x2mm_P0.5mm; MPN SN74LVC1G74DCUR; LCSC C70285
U411: LMV393; SOIC-8_3.9x4.9mm_P1.27mm; MPN LMV393IDR; LCSC C7984

Connections:
+3V3_A: C420.2, C445.2, D405.2 (K), D411.2 (K), R419.2, R440.2, R443.1, R446.1, R448.1, U402.6 (VS), U402.7 (REF1), U406.6 (VS), U406.7 (REF1); also elsewhere on the board
/amp_woofer/DCP_W_A: C424.1, R415.2, R416.1, U411.2 (-)
/amp_woofer/DCP_W_B: C449.1, R436.2, R437.1, U411.6 (-)
/amp_woofer/DCQ_W_A: C425.1, R417.2, R418.1, R419.1, U411.5 (+)
/amp_woofer/DCQ_W_B: C450.1, R438.2, R439.1, R440.1, U411.3 (+)
/amp_woofer/EN_W: R403.1, R424.1, U410.5 (Q)
/amp_woofer/FAULT_RAW_W: D403.2 (A), D404.2 (A), D406.2 (A), D407.2 (A), D409.2 (A), D410.2 (A), D412.2 (A), D413.2 (A), D414.2 (A), D415.2 (A), R451.2, U409.2
/amp_woofer/HB_W_A: C407.1, D401.1 (K), U401.12 (HB)
/amp_woofer/HB_W_B: C432.1, D408.1 (K), U405.12 (HB)
/amp_woofer/OUT_W_A: C413.1, C414.1, C415.1, C416.1, C417.1, C418.1, C419.1, C422.1, J401.1, R411.1, R415.1, R417.1, R420.1, R453.1, R454.1
/amp_woofer/OUT_W_B: C438.1, C439.1, C440.1, C441.1, C442.1, C443.1, C444.1, C447.1, C459.2, J401.2, R432.1, R436.1, R438.1, R441.1
/amp_woofer/SDH_W: C454.1, R448.2, R449.1, U404.1 (+INA), U408.1 (+INA)
/amp_woofer/SDL_W: C455.1, R449.2, R450.1, U404.4 (-INB), U408.4 (-INB)
/amp_woofer/SW_W_A: C407.2, C412.1, L401.1, Q401.3 (S), Q401.4 (S), Q402.2 (D), R408.2, U401.9 (HS), U401.13 (HS), U401.14 (NC1), U401.16 (HS), U401.21 (HS)
/amp_woofer/SW_W_B: C432.2, C437.1, L402.1, Q403.3 (S), Q403.4 (S), Q404.2 (D), R429.2, U405.9 (HS), U405.13 (HS), U405.14 (NC1), U405.16 (HS), U405.21 (HS)
/amp_woofer/VSDB_W: C453.1, R412.2, R433.2, R446.2, R447.1
/amp_woofer/VTH_HI_W: C451.1, R443.2, R444.1, U403.1 (+INA), U407.1 (+INA)
/amp_woofer/VTH_LO_W: C452.1, R444.2, R445.1, U403.4 (-INB), U407.4 (-INB)
AMP_ARM: D414.1 (K); also elsewhere on the board
AMP_CLK_W: U410.1 (CLK); also elsewhere on the board
AMP_EN_W: U410.2 (D); also elsewhere on the board
DC_W_n: D415.1 (K), R452.2, U411.1, U411.7; also elsewhere on the board
FAULT_W_n: U409.4, U410.6 (~CLR); also elsewhere on the board
ISNS_W_A: U402.5 (OUT), U403.2 (-INA), U403.3 (+INB); also elsewhere on the board
ISNS_W_B: U406.5 (OUT), U407.2 (-INA), U407.3 (+INB); also elsewhere on the board
unnamed: C412.2, R410.1
unnamed: C437.2, R431.1
unnamed: C459.1, R453.2, R454.2
unnamed: D401.2 (A), U401.17 (BST)
unnamed: D403.1 (K), U403.7 (OUTA)
unnamed: D404.1 (K), U403.6 (OUTB)
unnamed: C422.2, D405.3 (COM), R412.1, R413.1, R414.1
unnamed: D406.1 (K), U404.7 (OUTA)
unnamed: D407.1 (K), U404.6 (OUTB)
unnamed: D408.2 (A), U405.17 (BST)
unnamed: D409.1 (K), U407.7 (OUTA)
unnamed: D410.1 (K), U407.6 (OUTB)
unnamed: C447.2, D411.3 (COM), R433.1, R434.1, R435.1
unnamed: D412.1 (K), U408.7 (OUTA)
unnamed: D413.1 (K), U408.6 (OUTB)
unnamed: L401.2, R411.4
unnamed: L402.2, R432.4
unnamed: Q401.1 (G), R406.2, R408.1
unnamed: Q402.1 (G), R407.2, R409.1
unnamed: Q403.1 (G), R427.2, R429.1
unnamed: Q404.1 (G), R428.2, R430.1
unnamed: R404.2, U401.5 (DHL)
unnamed: R405.2, U401.6 (DLH)
unnamed: C402.1, R403.2, U401.18 (EN/HI)
unnamed: R406.1, U401.10 (HO)
unnamed: R407.1, U401.8 (LO)
unnamed: C401.1, R402.2, U401.19 (PWM/LI)
unnamed: C404.1, C405.1, C406.1, U401.4 (VDD)
unnamed: R411.3, U402.8 (IN+)
unnamed: R411.2, U402.1 (IN-)
unnamed: R414.2, U404.3 (+INB)
unnamed: R413.2, U404.2 (-INA)
unnamed: R425.2, U405.5 (DHL)
unnamed: R426.2, U405.6 (DLH)
unnamed: C427.1, R424.2, U405.18 (EN/HI)
unnamed: R427.1, U405.10 (HO)
unnamed: R428.1, U405.8 (LO)
unnamed: C426.1, R423.2, U405.19 (PWM/LI)
unnamed: C429.1, C430.1, C431.1, U405.4 (VDD)
unnamed: R432.3, U406.8 (IN+)
unnamed: R432.2, U406.1 (IN-)
unnamed: R435.2, U408.3 (+INB)
unnamed: R434.2, U408.2 (-INA)
PF_W_A: R420.2, R421.1; also elsewhere on the board
PF_W_B: R441.2, R442.1; also elsewhere on the board
PWM_W_A: R401.1, R402.1; also elsewhere on the board
PWM_W_B: R422.1, R423.1; also elsewhere on the board
T_W_FET: RT401.1; also elsewhere on the board
T_W_IND: RT402.1; also elsewhere on the board

Notes on the sheet:
LEG A
PWM mode, high = HS on. 100R at the pins; 4.7k pull-down; 10p DNP (ground bounce)
DHL / DLH 20.0k: td 20 ns setting, ~18 ns effective at the FETs
VDD 5 V (internal LDO): >= 5 x C_BST
2.2R on/off; pull-downs 100k (HS, fed from the bootstrap) / 10k (LS)
POWER LOOP <= 1 nH, verified by phase 6 extraction: Q401 / Q402 with the two 100n 0603 directly across the leg, return on L2. SMBJ51A at the bridge (VBUS OV scheme).
RC snubber, DNP (0.62 W if fitted)
LC filter: 10 uH + 7 x 100n C0G to GND per side: f0 60 kHz, Q 0.53 / 1.06 at 4 / 8 ohm
Kelvin pair from the shunt inner pad edges
LEG A CURRENT SENSE + OCP WINDOW
V = 1.65 V + 0.05 V/A (5 mR x 10). Trip at +/-14.9 A: VTH 2.40 / 0.90 V. OK = high; a low on either pulls FAULT_RAW low.
LEG A OUTPUT-SHORT DETECTOR
47p / 1k differentiator, BAT54S clamp: trips on a >= 1.5 V step or > 21 V/us, ~51 ns to gates off (D-short-detect.md). A lead opening at >= 14 A also trips (benign).
LEG A DC-DETECT TAPS
/27.8, tau 0.17 s; offset node +0.217 V (= 6.0 V at the output)
Post-filter sense /15, thin film 0.1 %, to the ADS8353 (amp_sense)
LEG B
POWER LOOP <= 1 nH, verified by phase 6 extraction: Q403 / Q404 with the two 100n 0603 directly across the leg, return on L2.
LEG B CURRENT SENSE + OCP WINDOW
LEG B OUTPUT-SHORT DETECTOR
LEG B DC-DETECT TAPS
CHANNEL W: THRESHOLDS, FAULT LATCH, DC DETECT
OCP thresholds 2.396 / 0.904 V (9.09k / 15k / 9.09k, ratiometric)
Short-detector bias 1.65 V (2 x 20k)
Short-detector window 2.64 / 0.66 V (4.99k / 15k / 4.99k)
Fault latch: any OK low (OCP x 4, output short x 4, DC, AMP_ARM low) pulls FAULT_RAW low; Schmitt -> CLR -> Q (EN) low: both LMG1210 off in <= 216 ns (ramp) / ~51 ns (short). The FPGA reads FAULT_n and re-arms with AMP_EN = 1 + an AMP_CLK edge. PRE tied high.
DC detect: trips at |DC| >= 6 V (23 ms at 48 V, 50 ms at 24 V). Open-drain, 4.7k pull-up: DC_n to the FPGA and, by its diode, the fault node.
ZOBEL 10R (2 x 20R 1 W) + 100n C0G: open-load peak +23 dB; firmware limits it to <= 1 W
OUT+
OUT-
WOOFER 4-8 ohm: pin 1 OUT+ = leg A = speaker + pin 2 OUT- = leg B = speaker - 15 A header MX2EDGRC-5.08; plug MX2EDGK-5.08-02P (C5187912) ships loose
