sequoia-hope/studio-amp/hw/satellite/a/satellite.kicad_pcb

## KiCad design hw/satellite/a/satellite.kicad_pcb (continued)

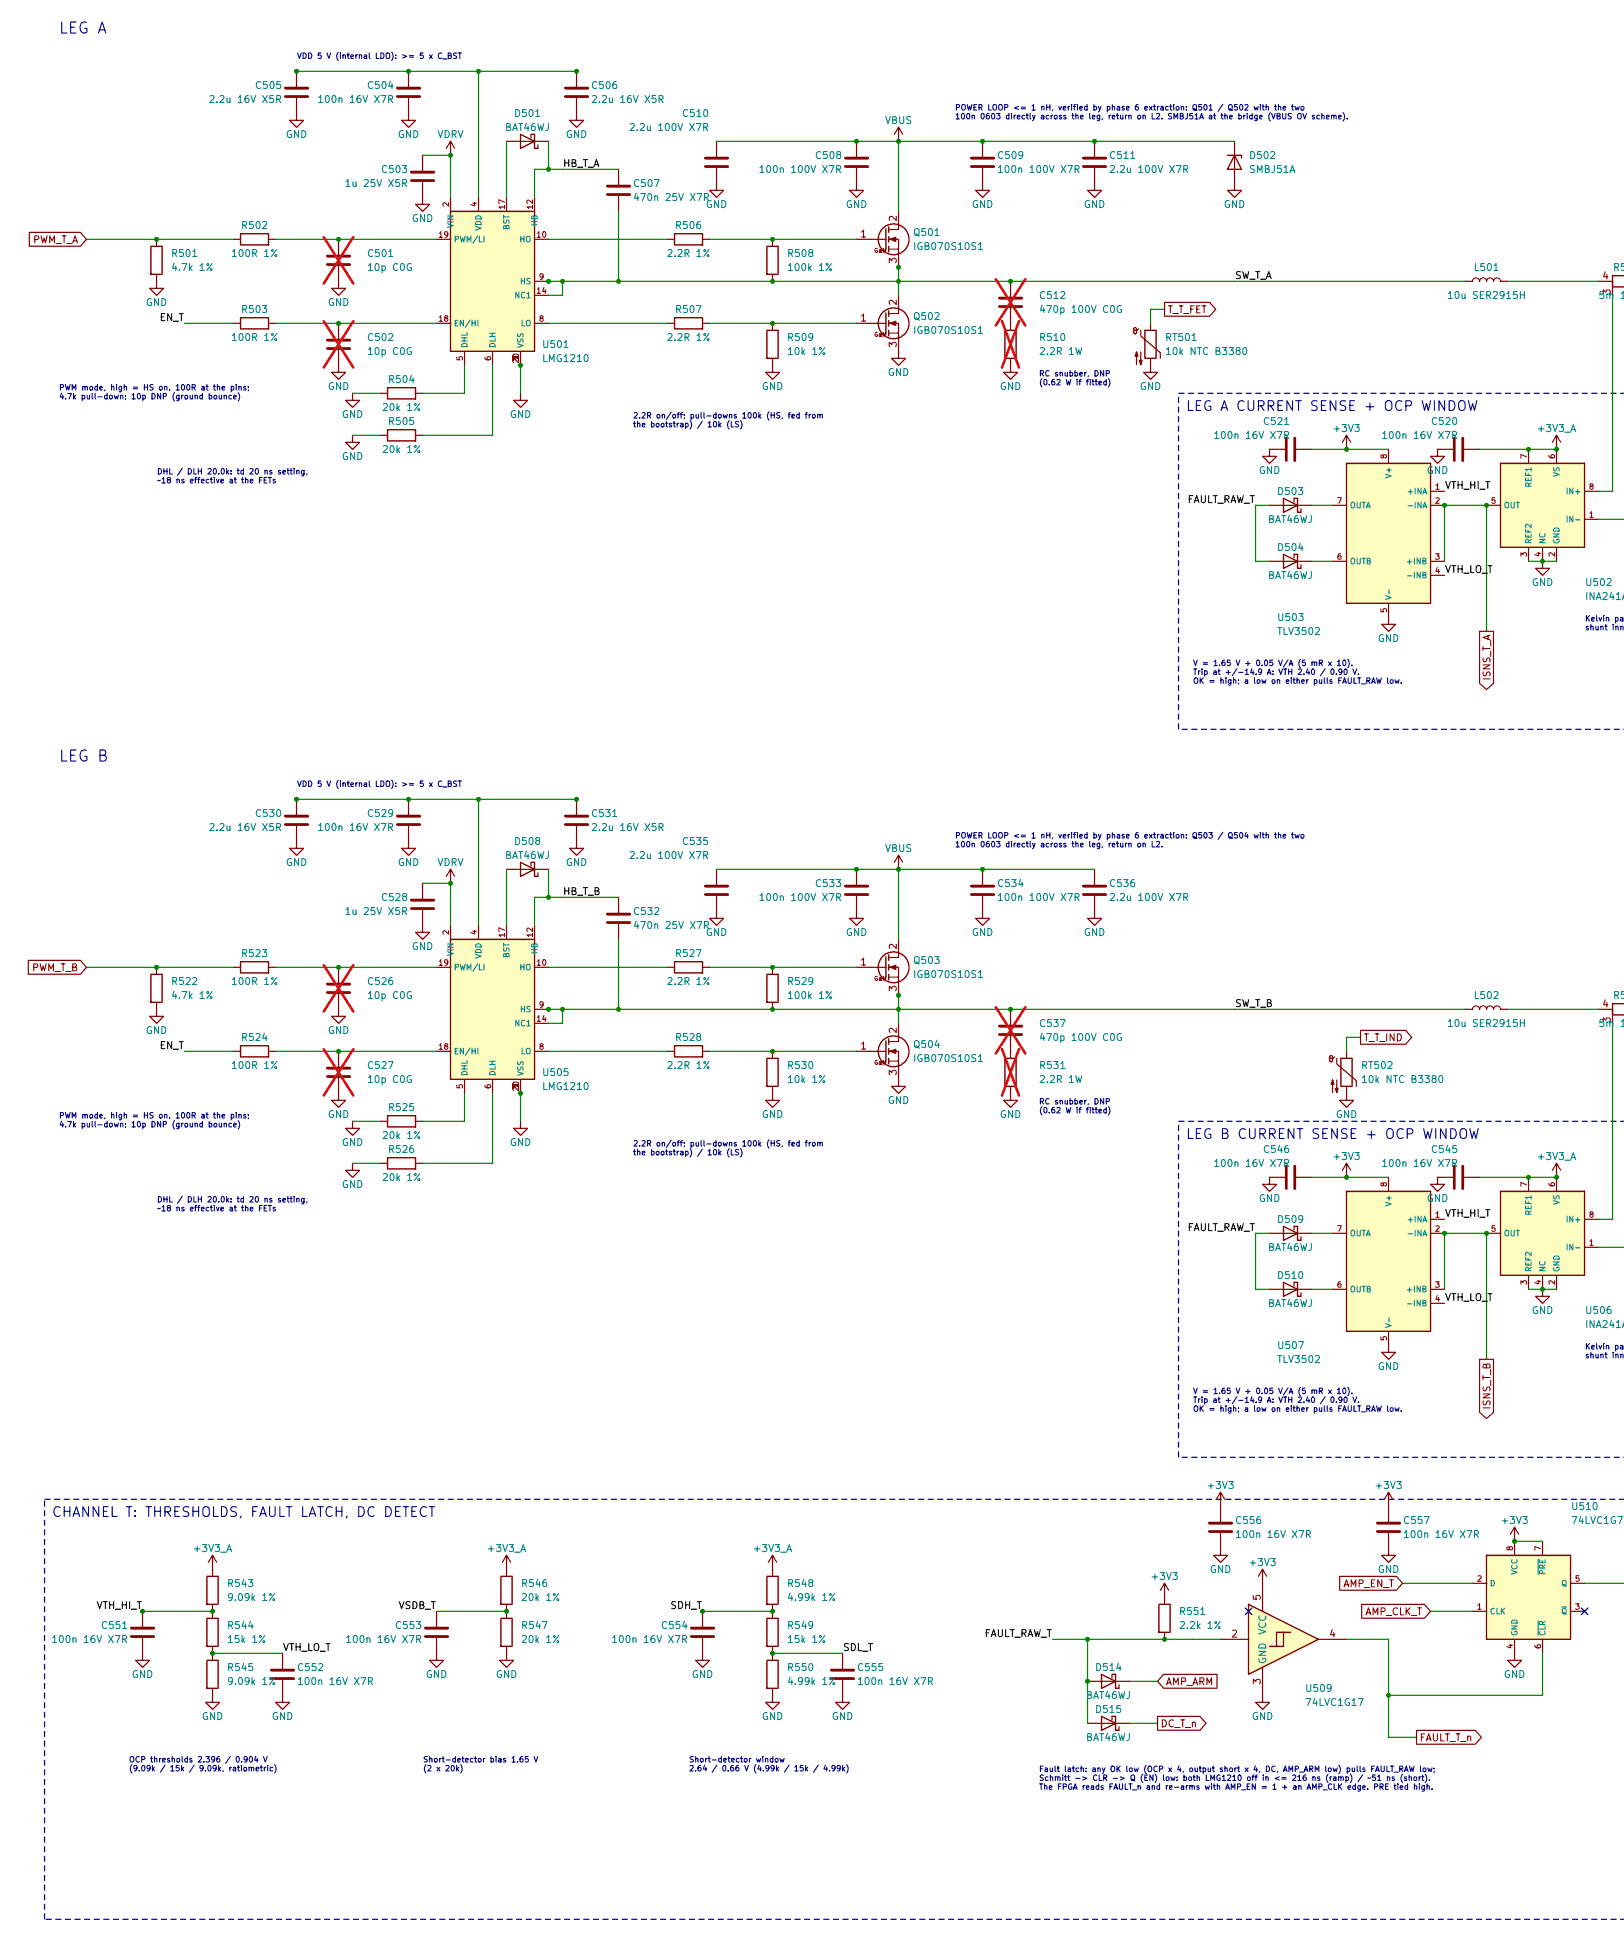
[picture p25: schematic amp_tweeter.kicad_sch, Studio Amp satellite: GaN BTL power stage: tweeter, part in row 1, column 1]

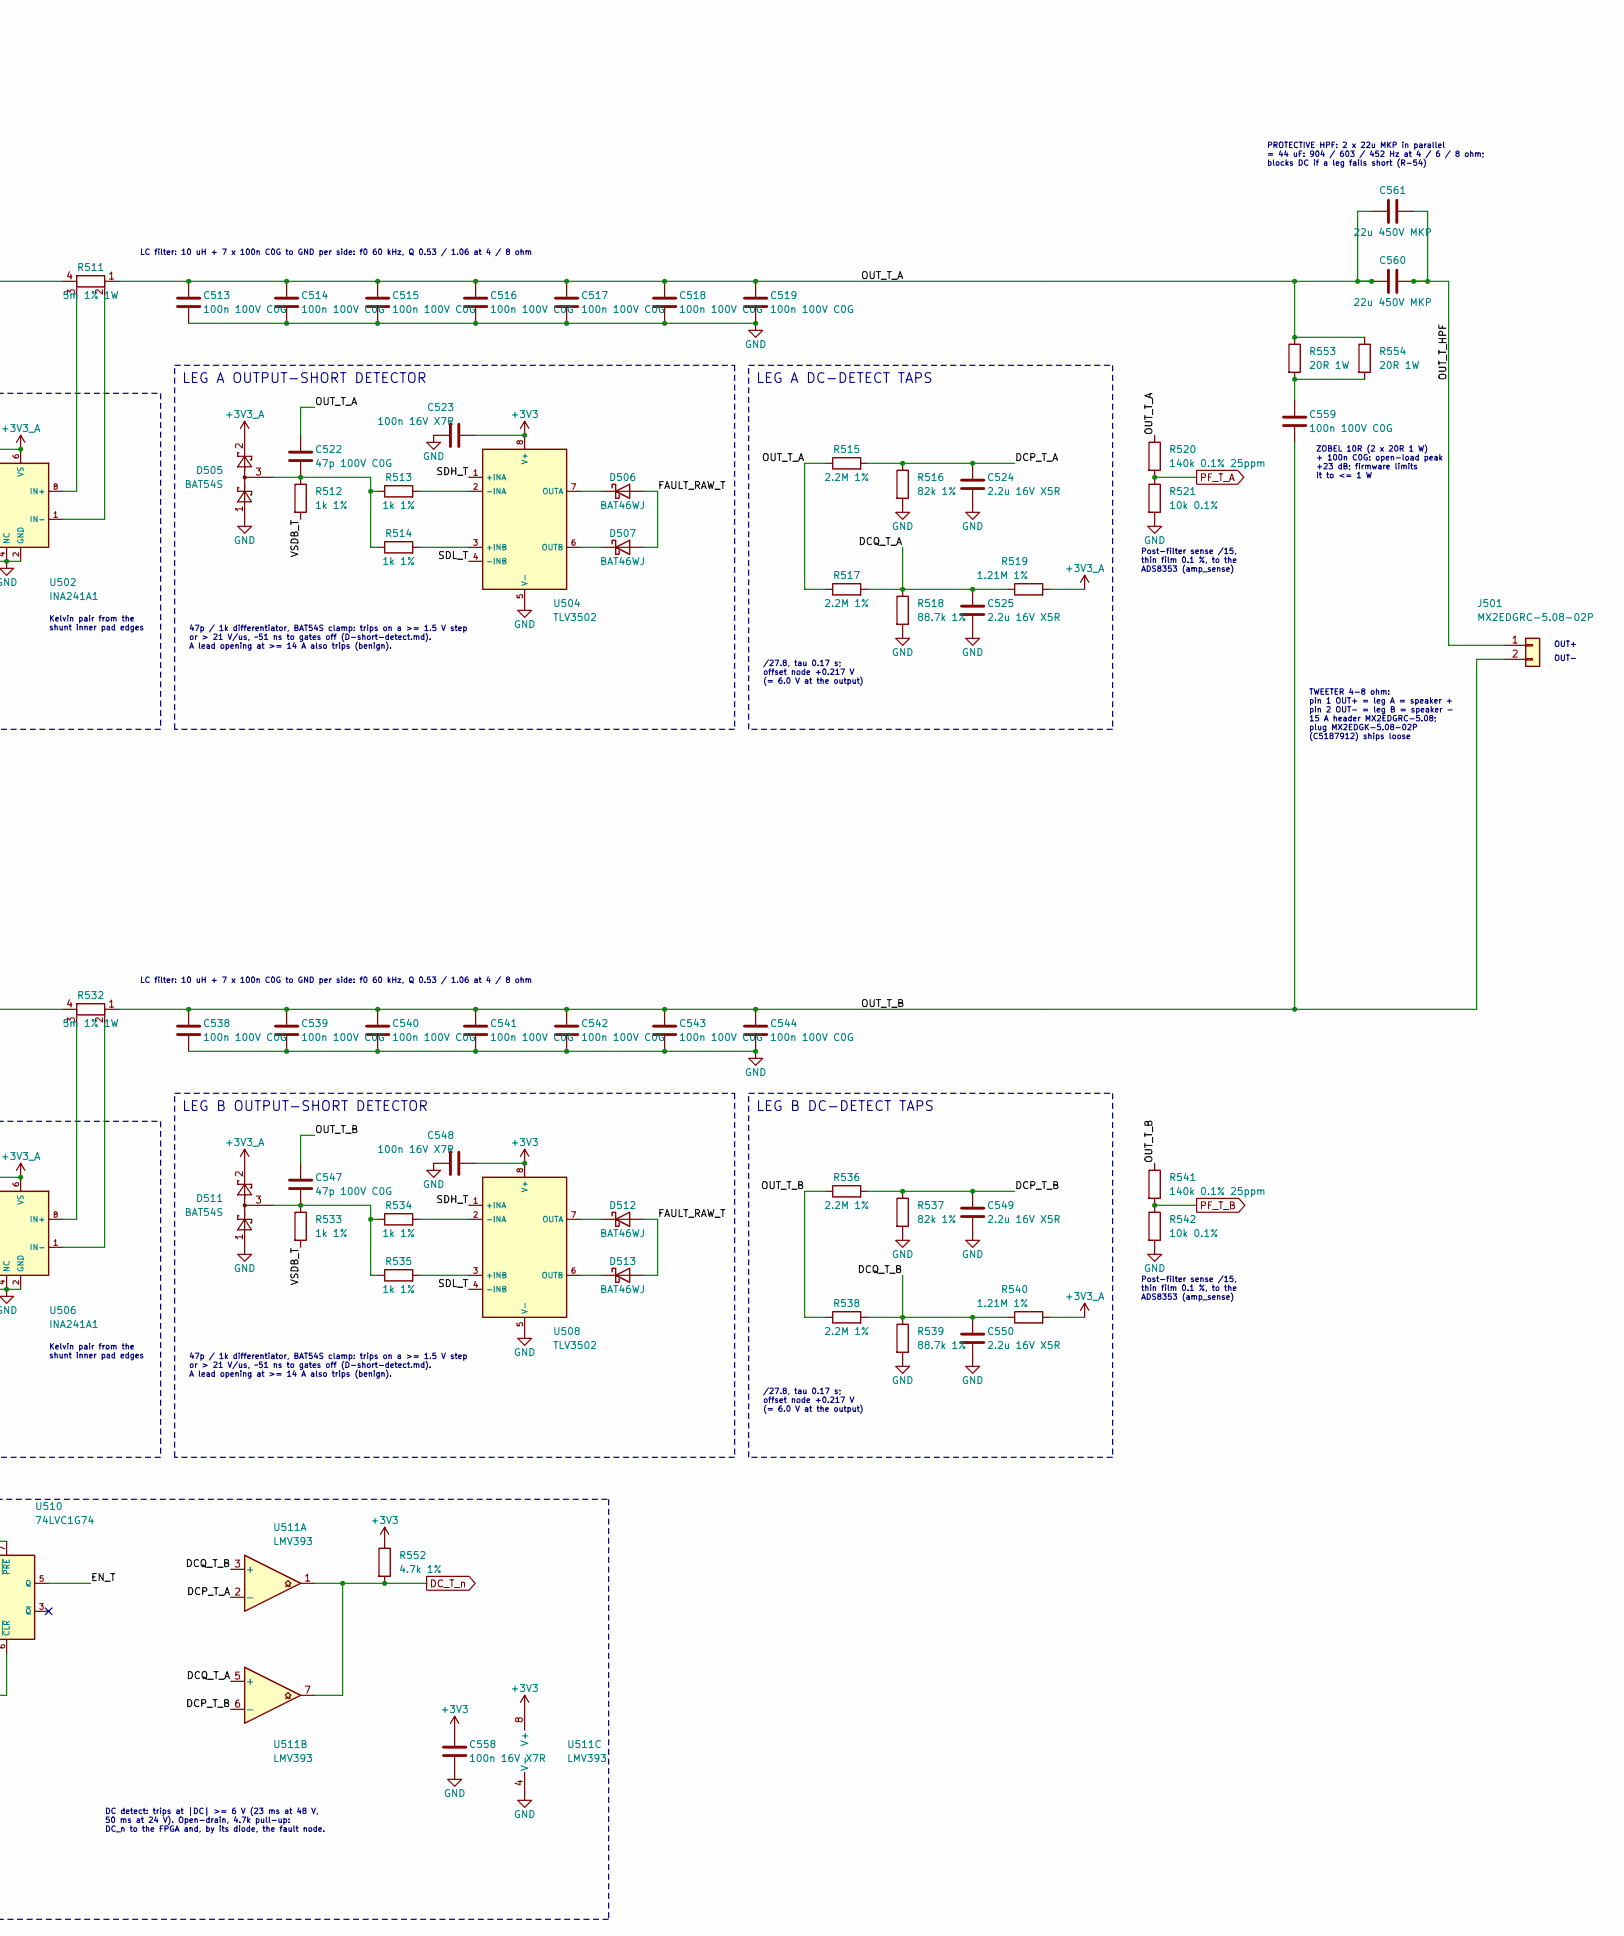
[picture p26: schematic amp_tweeter.kicad_sch, Studio Amp satellite: GaN BTL power stage: tweeter, part in row 1, column 2]

Parts:
C501, C502, C526, C527: 10p C0G; C_0402_1005Metric; MPN 0402N100J500CT; LCSC C301961; not fitted
C503, C528: 1u 25V X5R; C_0603_1608Metric; MPN CL10A105KA8NNNC; LCSC C5673
C504, C520, C521, C523, C529, C545, C546, C548, C551, C552, C553, C554, C555, C556, C557, C558: 100n 16V X7R; C_0402_1005Metric; MPN CC0402KRX7R7BB104; LCSC C60474
C505, C506, C524, C525, C530, C531, C549, C550: 2.2u 16V X5R; C_0603_1608Metric; MPN CL10A225KO8NNNC; LCSC C23630
C507, C532: 470n 25V X7R; C_0603_1608Metric; MPN CL10B474KA8NNNC; LCSC C1623
C508, C509, C533, C534: 100n 100V X7R; C_0603_1608Metric; MPN HMK107B7104KAHT; LCSC C268011
C510, C511, C535, C536: 2.2u 100V X7R; C_1210_3225Metric; MPN HMK325B7225KN-T; LCSC C92775
C512, C537: 470p 100V C0G; C_0603_1608Metric; MPN CC0603JRNPO0BN471; LCSC C326973; not fitted
C513, C514, C515, C516, C517, C518, C519, C538, C539, C540, C541, C542, C543, C544, C559: 100n 100V C0G; C_1206_3216Metric; MPN GRM31C5C2A104JA01L; LCSC C405303
C522, C547: 47p 100V C0G; C_0603_1608Metric; MPN CC0603JRNPO0BN470; LCSC C327115
C560, C561: 22u 450V MKP; C_Rect_L31.5mm_W22.0mm_P27.50mm_B32774; MPN B32774D4226K; LCSC C531089
D501, D503, D504, D506, D507, D508, D509, D510, D512, D513, D514, D515: BAT46WJ; D_SOD-323F; MPN BAT46WJ,115; LCSC C114696
D502: SMBJ51A; D_SMB; MPN SMBJ51A; LCSC C1973217
D505, D511: BAT54S; SOT-23; MPN BAT54S,215; LCSC C47546
J501: MX2EDGRC-5.08-02P; MAX_MX2EDGRC-5.08-02P_1x02_P5.08mm_Horizontal; MPN MX2EDGRC-5.08-02P-GN01-Cu-A; LCSC C5188019
L501, L502: 10u SER2915H; Coilcraft_SER2915H; MPN SER2915H-103KL; LCSC C19276042
Q501, Q502, Q503, Q504: IGB070S10S1; IGB070S10S1_PG-TSON-4; MPN IGB070S10S1XTMA1; LCSC C44179579
R501, R522, R552: 4.7k 1%; R_0402_1005Metric; MPN 0402WGF4701TCE; LCSC C25900
R502, R503, R523, R524: 100R 1%; R_0402_1005Metric; MPN RC0402FR-07100RL; LCSC C106232
R504, R505, R525, R526, R546, R547: 20k 1%; R_0402_1005Metric; MPN 0402WGF2002TCE; LCSC C25765
R506, R507, R527, R528: 2.2R 1%; R_0402_1005Metric; MPN FRC0402F2R20TS; LCSC C2909330
R508, R529: 100k 1%; R_0402_1005Metric; MPN 0402WGF1003TCE; LCSC C25741
R509, R530: 10k 1%; R_0402_1005Metric; MPN 0402WGF1002TCE; LCSC C25744
R510, R531: 2.2R 1W; R_2512_6332Metric; MPN 25121WJ022JT4E; LCSC C25480; not fitted
R511, R532: 5m 1% 1W; R_2512_6332Metric_Kelvin_NetTie; MPN PA2512FKF070R005E; LCSC C723365
R512, R513, R514, R533, R534, R535: 1k 1%; R_0402_1005Metric; MPN 0402WGF1001TCE; LCSC C11702
R515, R517, R536, R538: 2.2M 1%; R_0603_1608Metric; MPN 0603WAF2204T5E; LCSC C22938
R516, R537: 82k 1%; R_0603_1608Metric; MPN 0603WAF8202T5E; LCSC C23254
R518, R539: 88.7k 1%; R_0603_1608Metric; MPN 0603WAF8872T5E; LCSC C23258
R519, R540: 1.21M 1%; R_0603_1608Metric; MPN 0603WAF1214T5E; LCSC C422998
R520, R541: 140k 0.1% 25ppm; R_0603_1608Metric; MPN RT0603BRD07140KL; LCSC C861125
R521, R542: 10k 0.1%; R_0603_1608Metric; MPN RT0603BRD0710KL; LCSC C95204
R543, R545: 9.09k 1%; R_0402_1005Metric; MPN 0402WGF9091TCE; LCSC C11549
R544, R549: 15k 1%; R_0402_1005Metric; MPN 0402WGF1502TCE; LCSC C25756
R548, R550: 4.99k 1%; R_0402_1005Metric; MPN 0402WGF4991TCE; LCSC C25903
R551: 2.2k 1%; R_0402_1005Metric; MPN 0402WGF2201TCE; LCSC C25879
R553, R554: 20R 1W; R_2512_6332Metric; MPN 25121WF200JT4E; LCSC C41950
RT501, RT502: 10k NTC B3380; R_0402_1005Metric; MPN NCP15XH103F03RC; LCSC C77131
U501, U505: LMG1210; Texas_RVR0019A_WQFN-19-2EP_4x3mm_P0.5mm; MPN LMG1210RVRR; LCSC C2677136
U502, U506: INA241A1; SOT-23-8; MPN INA241A1IDDFR; LCSC C19712054
U503, U504, U507, U508: TLV3502; SOT-23-8; MPN TLV3502AIDCNR; LCSC C48618
U509: 74LVC1G17; SOT-23-5; MPN SN74LVC1G17DBVR; LCSC C7836
U510: 74LVC1G74; VSSOP-8_2.3x2mm_P0.5mm; MPN SN74LVC1G74DCUR; LCSC C70285
U511: LMV393; SOIC-8_3.9x4.9mm_P1.27mm; MPN LMV393IDR; LCSC C7984

Connections:
+3V3_A: C520.2, C545.2, D505.2 (K), D511.2 (K), R519.2, R540.2, R543.1, R546.1, R548.1, U502.6 (VS), U502.7 (REF1), U506.6 (VS), U506.7 (REF1); also elsewhere on the board
/amp_tweeter/DCP_T_A: C524.1, R515.2, R516.1, U511.2 (-)
/amp_tweeter/DCP_T_B: C549.1, R536.2, R537.1, U511.6 (-)
/amp_tweeter/DCQ_T_A: C525.1, R517.2, R518.1, R519.1, U511.5 (+)
/amp_tweeter/DCQ_T_B: C550.1, R538.2, R539.1, R540.1, U511.3 (+)
/amp_tweeter/EN_T: R503.1, R524.1, U510.5 (Q)
/amp_tweeter/FAULT_RAW_T: D503.2 (A), D504.2 (A), D506.2 (A), D507.2 (A), D509.2 (A), D510.2 (A), D512.2 (A), D513.2 (A), D514.2 (A), D515.2 (A), R551.2, U509.2
/amp_tweeter/HB_T_A: C507.1, D501.1 (K), U501.12 (HB)
/amp_tweeter/HB_T_B: C532.1, D508.1 (K), U505.12 (HB)
/amp_tweeter/OUT_T_A: C513.1, C514.1, C515.1, C516.1, C517.1, C518.1, C519.1, C522.1, C560.1, C561.1, R511.1, R515.1, R517.1, R520.1, R553.1, R554.1
/amp_tweeter/OUT_T_B: C538.1, C539.1, C540.1, C541.1, C542.1, C543.1, C544.1, C547.1, C559.2, J501.2, R532.1, R536.1, R538.1, R541.1
/amp_tweeter/OUT_T_HPF: C560.2, C561.2, J501.1
/amp_tweeter/SDH_T: C554.1, R548.2, R549.1, U504.1 (+INA), U508.1 (+INA)
/amp_tweeter/SDL_T: C555.1, R549.2, R550.1, U504.4 (-INB), U508.4 (-INB)
/amp_tweeter/SW_T_A: C507.2, C512.1, L501.1, Q501.3 (S), Q501.4 (S), Q502.2 (D), R508.2, U501.9 (HS), U501.13 (HS), U501.14 (NC1), U501.16 (HS), U501.21 (HS)
/amp_tweeter/SW_T_B: C532.2, C537.1, L502.1, Q503.3 (S), Q503.4 (S), Q504.2 (D), R529.2, U505.9 (HS), U505.13 (HS), U505.14 (NC1), U505.16 (HS), U505.21 (HS)
/amp_tweeter/VSDB_T: C553.1, R512.2, R533.2, R546.2, R547.1
/amp_tweeter/VTH_HI_T: C551.1, R543.2, R544.1, U503.1 (+INA), U507.1 (+INA)
/amp_tweeter/VTH_LO_T: C552.1, R544.2, R545.1, U503.4 (-INB), U507.4 (-INB)
AMP_ARM: D514.1 (K); also elsewhere on the board
AMP_CLK_T: U510.1 (CLK); also elsewhere on the board
AMP_EN_T: U510.2 (D); also elsewhere on the board
DC_T_n: D515.1 (K), R552.2, U511.1, U511.7; also elsewhere on the board
FAULT_T_n: U509.4, U510.6 (~CLR); also elsewhere on the board
ISNS_T_A: U502.5 (OUT), U503.2 (-INA), U503.3 (+INB); also elsewhere on the board
ISNS_T_B: U506.5 (OUT), U507.2 (-INA), U507.3 (+INB); also elsewhere on the board
unnamed: C512.2, R510.1
unnamed: C537.2, R531.1
unnamed: C559.1, R553.2, R554.2
unnamed: D501.2 (A), U501.17 (BST)
unnamed: D503.1 (K), U503.7 (OUTA)
unnamed: D504.1 (K), U503.6 (OUTB)
unnamed: C522.2, D505.3 (COM), R512.1, R513.1, R514.1
unnamed: D506.1 (K), U504.7 (OUTA)
unnamed: D507.1 (K), U504.6 (OUTB)
unnamed: D508.2 (A), U505.17 (BST)
unnamed: D509.1 (K), U507.7 (OUTA)
unnamed: D510.1 (K), U507.6 (OUTB)
unnamed: C547.2, D511.3 (COM), R533.1, R534.1, R535.1
unnamed: D512.1 (K), U508.7 (OUTA)
unnamed: D513.1 (K), U508.6 (OUTB)
unnamed: L501.2, R511.4
unnamed: L502.2, R532.4
unnamed: Q501.1 (G), R506.2, R508.1
unnamed: Q502.1 (G), R507.2, R509.1
unnamed: Q503.1 (G), R527.2, R529.1
unnamed: Q504.1 (G), R528.2, R530.1
unnamed: R504.2, U501.5 (DHL)
unnamed: R505.2, U501.6 (DLH)
unnamed: C502.1, R503.2, U501.18 (EN/HI)
unnamed: R506.1, U501.10 (HO)
unnamed: R507.1, U501.8 (LO)
unnamed: C501.1, R502.2, U501.19 (PWM/LI)
unnamed: C504.1, C505.1, C506.1, U501.4 (VDD)
unnamed: R511.3, U502.8 (IN+)
unnamed: R511.2, U502.1 (IN-)
unnamed: R514.2, U504.3 (+INB)
unnamed: R513.2, U504.2 (-INA)
unnamed: R525.2, U505.5 (DHL)
unnamed: R526.2, U505.6 (DLH)
unnamed: C527.1, R524.2, U505.18 (EN/HI)
unnamed: R527.1, U505.10 (HO)
unnamed: R528.1, U505.8 (LO)
unnamed: C526.1, R523.2, U505.19 (PWM/LI)
unnamed: C529.1, C530.1, C531.1, U505.4 (VDD)
unnamed: R532.3, U506.8 (IN+)
unnamed: R532.2, U506.1 (IN-)
unnamed: R535.2, U508.3 (+INB)
unnamed: R534.2, U508.2 (-INA)
PF_T_A: R520.2, R521.1; also elsewhere on the board
PF_T_B: R541.2, R542.1; also elsewhere on the board
PWM_T_A: R501.1, R502.1; also elsewhere on the board
PWM_T_B: R522.1, R523.1; also elsewhere on the board
T_T_FET: RT501.1; also elsewhere on the board
T_T_IND: RT502.1; also elsewhere on the board

Notes on the sheet:
LEG A
PWM mode, high = HS on. 100R at the pins; 4.7k pull-down; 10p DNP (ground bounce)
DHL / DLH 20.0k: td 20 ns setting, ~18 ns effective at the FETs
VDD 5 V (internal LDO): >= 5 x C_BST
2.2R on/off; pull-downs 100k (HS, fed from the bootstrap) / 10k (LS)
POWER LOOP <= 1 nH, verified by phase 6 extraction: Q501 / Q502 with the two 100n 0603 directly across the leg, return on L2. SMBJ51A at the bridge (VBUS OV scheme).
RC snubber, DNP (0.62 W if fitted)
LC filter: 10 uH + 7 x 100n C0G to GND per side: f0 60 kHz, Q 0.53 / 1.06 at 4 / 8 ohm
Kelvin pair from the shunt inner pad edges
LEG A CURRENT SENSE + OCP WINDOW
V = 1.65 V + 0.05 V/A (5 mR x 10). Trip at +/-14.9 A: VTH 2.40 / 0.90 V. OK = high; a low on either pulls FAULT_RAW low.
LEG A OUTPUT-SHORT DETECTOR
47p / 1k differentiator, BAT54S clamp: trips on a >= 1.5 V step or > 21 V/us, ~51 ns to gates off (D-short-detect.md). A lead opening at >= 14 A also trips (benign).
LEG A DC-DETECT TAPS
/27.8, tau 0.17 s; offset node +0.217 V (= 6.0 V at the output)
Post-filter sense /15, thin film 0.1 %, to the ADS8353 (amp_sense)
LEG B
POWER LOOP <= 1 nH, verified by phase 6 extraction: Q503 / Q504 with the two 100n 0603 directly across the leg, return on L2.
LEG B CURRENT SENSE + OCP WINDOW
LEG B OUTPUT-SHORT DETECTOR
LEG B DC-DETECT TAPS
CHANNEL T: THRESHOLDS, FAULT LATCH, DC DETECT
OCP thresholds 2.396 / 0.904 V (9.09k / 15k / 9.09k, ratiometric)
Short-detector bias 1.65 V (2 x 20k)
Short-detector window 2.64 / 0.66 V (4.99k / 15k / 4.99k)
Fault latch: any OK low (OCP x 4, output short x 4, DC, AMP_ARM low) pulls FAULT_RAW low; Schmitt -> CLR -> Q (EN) low: both LMG1210 off in <= 216 ns (ramp) / ~51 ns (short). The FPGA reads FAULT_n and re-arms with AMP_EN = 1 + an AMP_CLK edge. PRE tied high.
DC detect: trips at |DC| >= 6 V (23 ms at 48 V, 50 ms at 24 V). Open-drain, 4.7k pull-up: DC_n to the FPGA and, by its diode, the fault node.
ZOBEL 10R (2 x 20R 1 W) + 100n C0G: open-load peak +23 dB; firmware limits it to <= 1 W
PROTECTIVE HPF: 2 x 22u MKP in parallel = 44 uF: 904 / 603 / 452 Hz at 4 / 6 / 8 ohm; blocks DC if a leg fails short (R-54)
OUT+
OUT-
TWEETER 4-8 ohm: pin 1 OUT+ = leg A = speaker + pin 2 OUT- = leg B = speaker - 15 A header MX2EDGRC-5.08; plug MX2EDGK-5.08-02P (C5187912) ships loose

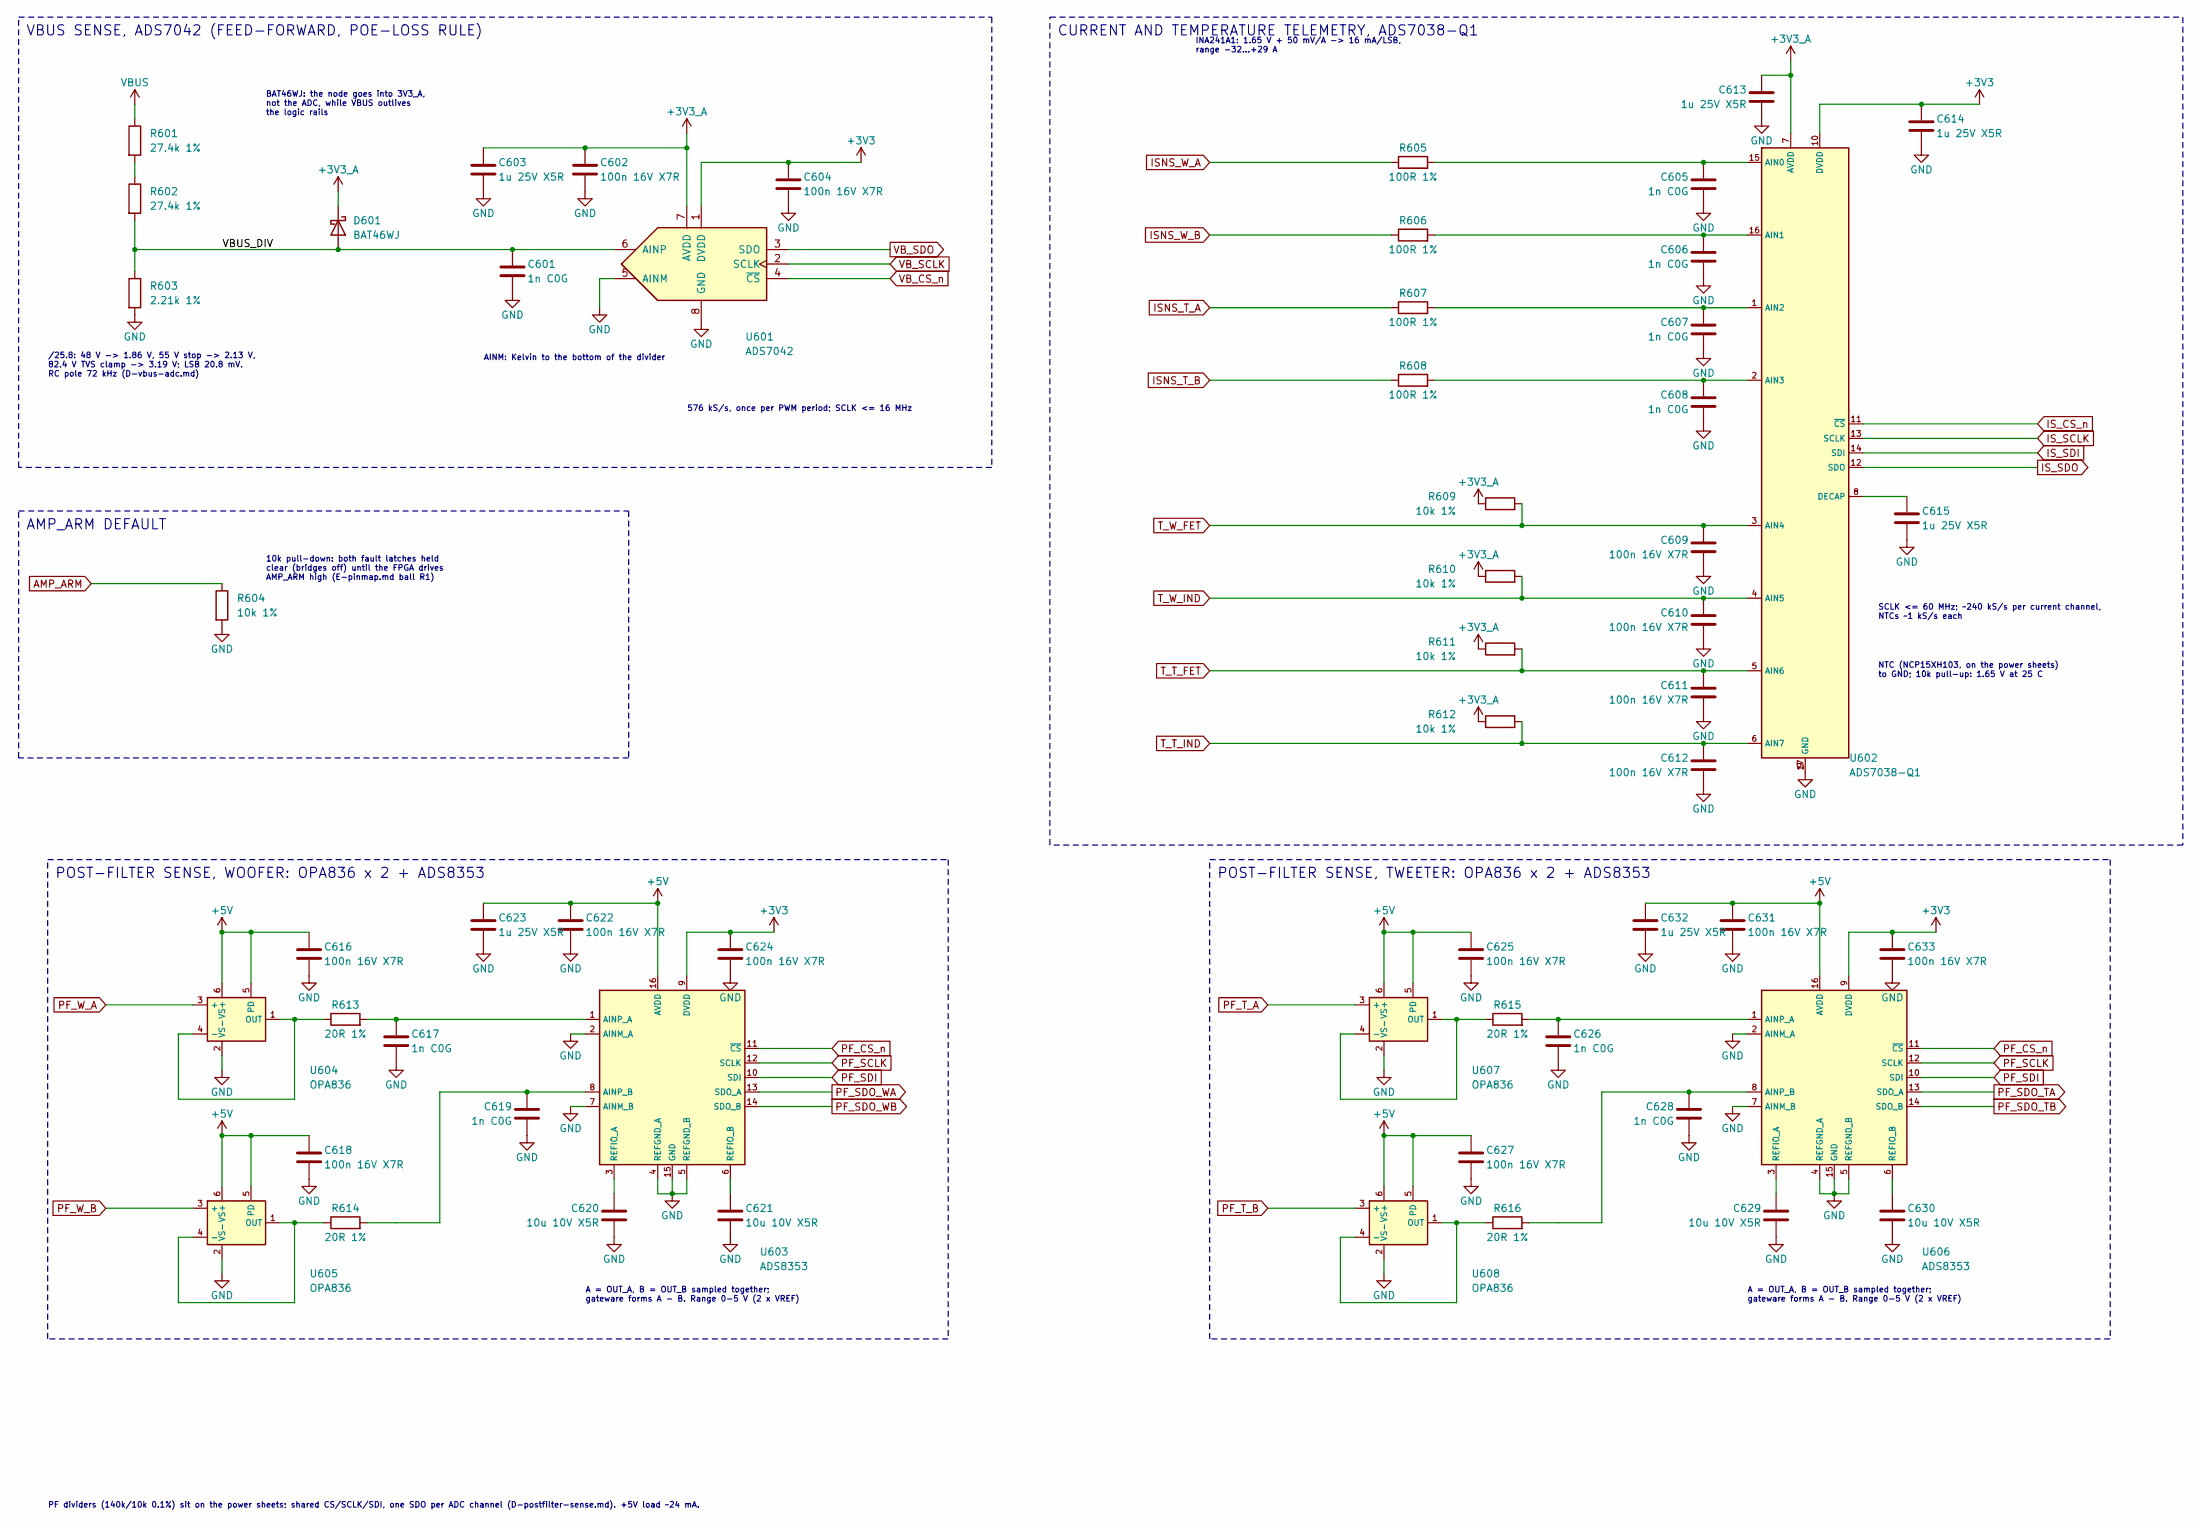
[picture p27: schematic amp_sense.kicad_sch, Studio Amp satellite: VBUS, current and temperature sensing]

Parts:
C601, C605, C606, C607, C608, C617, C619, C626, C628: 1n C0G; C_0402_1005Metric; MPN 0402N102J500CT; LCSC C237166
C602, C604, C609, C610, C611, C612, C616, C618, C622, C624, C625, C627, C631, C633: 100n 16V X7R; C_0402_1005Metric; MPN CC0402KRX7R7BB104; LCSC C60474
C603, C613, C614, C615, C623, C632: 1u 25V X5R; C_0603_1608Metric; MPN CL10A105KA8NNNC; LCSC C5673
C620, C621, C629, C630: 10u 10V X5R; C_0603_1608Metric; MPN CL10A106KP8NNNC; LCSC C19702
D601: BAT46WJ; D_SOD-323F; MPN BAT46WJ,115; LCSC C114696
R601, R602: 27.4k 1%; R_0805_2012Metric; MPN FRC0805F2742TS; LCSC C2930188
R603: 2.21k 1%; R_0603_1608Metric; MPN FRC0603F2211TS; LCSC C2933171
R604, R609, R610, R611, R612: 10k 1%; R_0402_1005Metric; MPN 0402WGF1002TCE; LCSC C25744
R605, R606, R607, R608: 100R 1%; R_0402_1005Metric; MPN RC0402FR-07100RL; LCSC C106232
R613, R614, R615, R616: 20R 1%; R_0402_1005Metric; MPN RC0402FR-0720RL; LCSC C138031
U601: ADS7042; VSSOP-8_2.3x2mm_P0.5mm; MPN ADS7042IDCUR; LCSC C701641
U602: ADS7038-Q1; WQFN-16-1EP_3x3mm_P0.5mm_EP1.68x1.68mm; MPN ADS7038QRTERQ1; LCSC C2876384
U603, U606: ADS8353; TSSOP-16_4.4x5mm_P0.65mm; MPN ADS8353IPWR; LCSC C701691
U604, U605, U607, U608: OPA836; SOT-23-6; MPN OPA836IDBVR; LCSC C111589

Connections:
+3V3_A: C602.1, C603.1, C613.1, D601.1 (K), R609.1, R610.1, R611.1, R612.1, U601.7 (AVDD), U602.7 (AVDD); also elsewhere on the board
+5V: C616.1, C618.1, C622.1, C623.1, C625.1, C627.1, C631.1, C632.1, U603.16 (AVDD), U604.5 (PD), U604.6 (VS+), U605.5 (PD), U605.6 (VS+), U606.16 (AVDD), U607.5 (PD), U607.6 (VS+), U608.5 (PD), U608.6 (VS+); also elsewhere on the board
/amp_sense/VBUS_DIV: C601.1, D601.2 (A), R602.2, R603.1, U601.6 (AINP)
AMP_ARM: R604.1; also elsewhere on the board
ISNS_T_A: R607.1; also elsewhere on the board
ISNS_T_B: R608.1; also elsewhere on the board
ISNS_W_A: R605.1; also elsewhere on the board
ISNS_W_B: R606.1; also elsewhere on the board
IS_CS_n: U602.11 (~CS); also elsewhere on the board
IS_SCLK: U602.13 (SCLK); also elsewhere on the board
IS_SDI: U602.14 (SDI); also elsewhere on the board
IS_SDO: U602.12 (SDO); also elsewhere on the board
unnamed: R601.2, R602.1
unnamed: C605.1, R605.2, U602.15 (AIN0)
unnamed: C606.1, R606.2, U602.16 (AIN1)
unnamed: C607.1, R607.2, U602.1 (AIN2)
unnamed: C608.1, R608.2, U602.2 (AIN3)
unnamed: C615.1, U602.8 (DECAP)
unnamed: C617.1, R613.2, U603.1 (AINP_A)
unnamed: C619.1, R614.2, U603.8 (AINP_B)
unnamed: C620.1, U603.3 (REFIO_A)
unnamed: C621.1, U603.6 (REFIO_B)
unnamed: R613.1, U604.1 (OUT), U604.4 (-)
unnamed: R614.1, U605.1 (OUT), U605.4 (-)
unnamed: C626.1, R615.2, U606.1 (AINP_A)
unnamed: C628.1, R616.2, U606.8 (AINP_B)
unnamed: C629.1, U606.3 (REFIO_A)
unnamed: C630.1, U606.6 (REFIO_B)
unnamed: R615.1, U607.1 (OUT), U607.4 (-)
unnamed: R616.1, U608.1 (OUT), U608.4 (-)
PF_CS_n: U603.11 (~CS), U606.11 (~CS); also elsewhere on the board
PF_SCLK: U603.12 (SCLK), U606.12 (SCLK); also elsewhere on the board
PF_SDI: U603.10 (SDI), U606.10 (SDI); also elsewhere on the board
PF_SDO_TA: U606.13 (SDO_A); also elsewhere on the board
PF_SDO_TB: U606.14 (SDO_B); also elsewhere on the board
PF_SDO_WA: U603.13 (SDO_A); also elsewhere on the board
PF_SDO_WB: U603.14 (SDO_B); also elsewhere on the board
PF_T_A: U607.3 (+); also elsewhere on the board
PF_T_B: U608.3 (+); also elsewhere on the board
PF_W_A: U604.3 (+); also elsewhere on the board
PF_W_B: U605.3 (+); also elsewhere on the board
T_T_FET: C611.1, R611.2, U602.5 (AIN6); also elsewhere on the board
T_T_IND: C612.1, R612.2, U602.6 (AIN7); also elsewhere on the board
T_W_FET: C609.1, R609.2, U602.3 (AIN4); also elsewhere on the board
T_W_IND: C610.1, R610.2, U602.4 (AIN5); also elsewhere on the board
VB_CS_n: U601.4 (~CS); also elsewhere on the board
VB_SCLK: U601.2 (SCLK); also elsewhere on the board
VB_SDO: U601.3 (SDO); also elsewhere on the board

Notes on the sheet:
VBUS SENSE, ADS7042 (FEED-FORWARD, POE-LOSS RULE)
/25.8: 48 V -> 1.86 V, 55 V stop -> 2.13 V, 82.4 V TVS clamp -> 3.19 V; LSB 20.8 mV. RC pole 72 kHz (D-vbus-adc.md)
BAT46WJ: the node goes into 3V3_A, not the ADC, while VBUS outlives the logic rails
AINM: Kelvin to the bottom of the divider
576 kS/s, once per PWM period; SCLK <= 16 MHz
AMP_ARM DEFAULT
10k pull-down: both fault latches held clear (bridges off) until the FPGA drives AMP_ARM high (E-pinmap.md ball R1)
CURRENT AND TEMPERATURE TELEMETRY, ADS7038-Q1
INA241A1: 1.65 V + 50 mV/A -> 16 mA/LSB, range -32...+29 A
NTC (NCP15XH103, on the power sheets) to GND; 10k pull-up: 1.65 V at 25 C
SCLK <= 60 MHz; ~240 kS/s per current channel, NTCs ~1 kS/s each
POST-FILTER SENSE, WOOFER: OPA836 x 2 + ADS8353
A = OUT_A, B = OUT_B sampled together; gateware forms A - B. Range 0-5 V (2 x VREF)
POST-FILTER SENSE, TWEETER: OPA836 x 2 + ADS8353
PF dividers (140k/10k 0.1%) sit on the power sheets; shared CS/SCLK/SDI, one SDO per ADC channel (D-postfilter-sense.md). +5V load ~24 mA.
