sequoia-hope/studio-amp/hw/satellite/a/satellite.kicad_pcb

## KiCad design hw/satellite/a/satellite.kicad_pcb (continued)

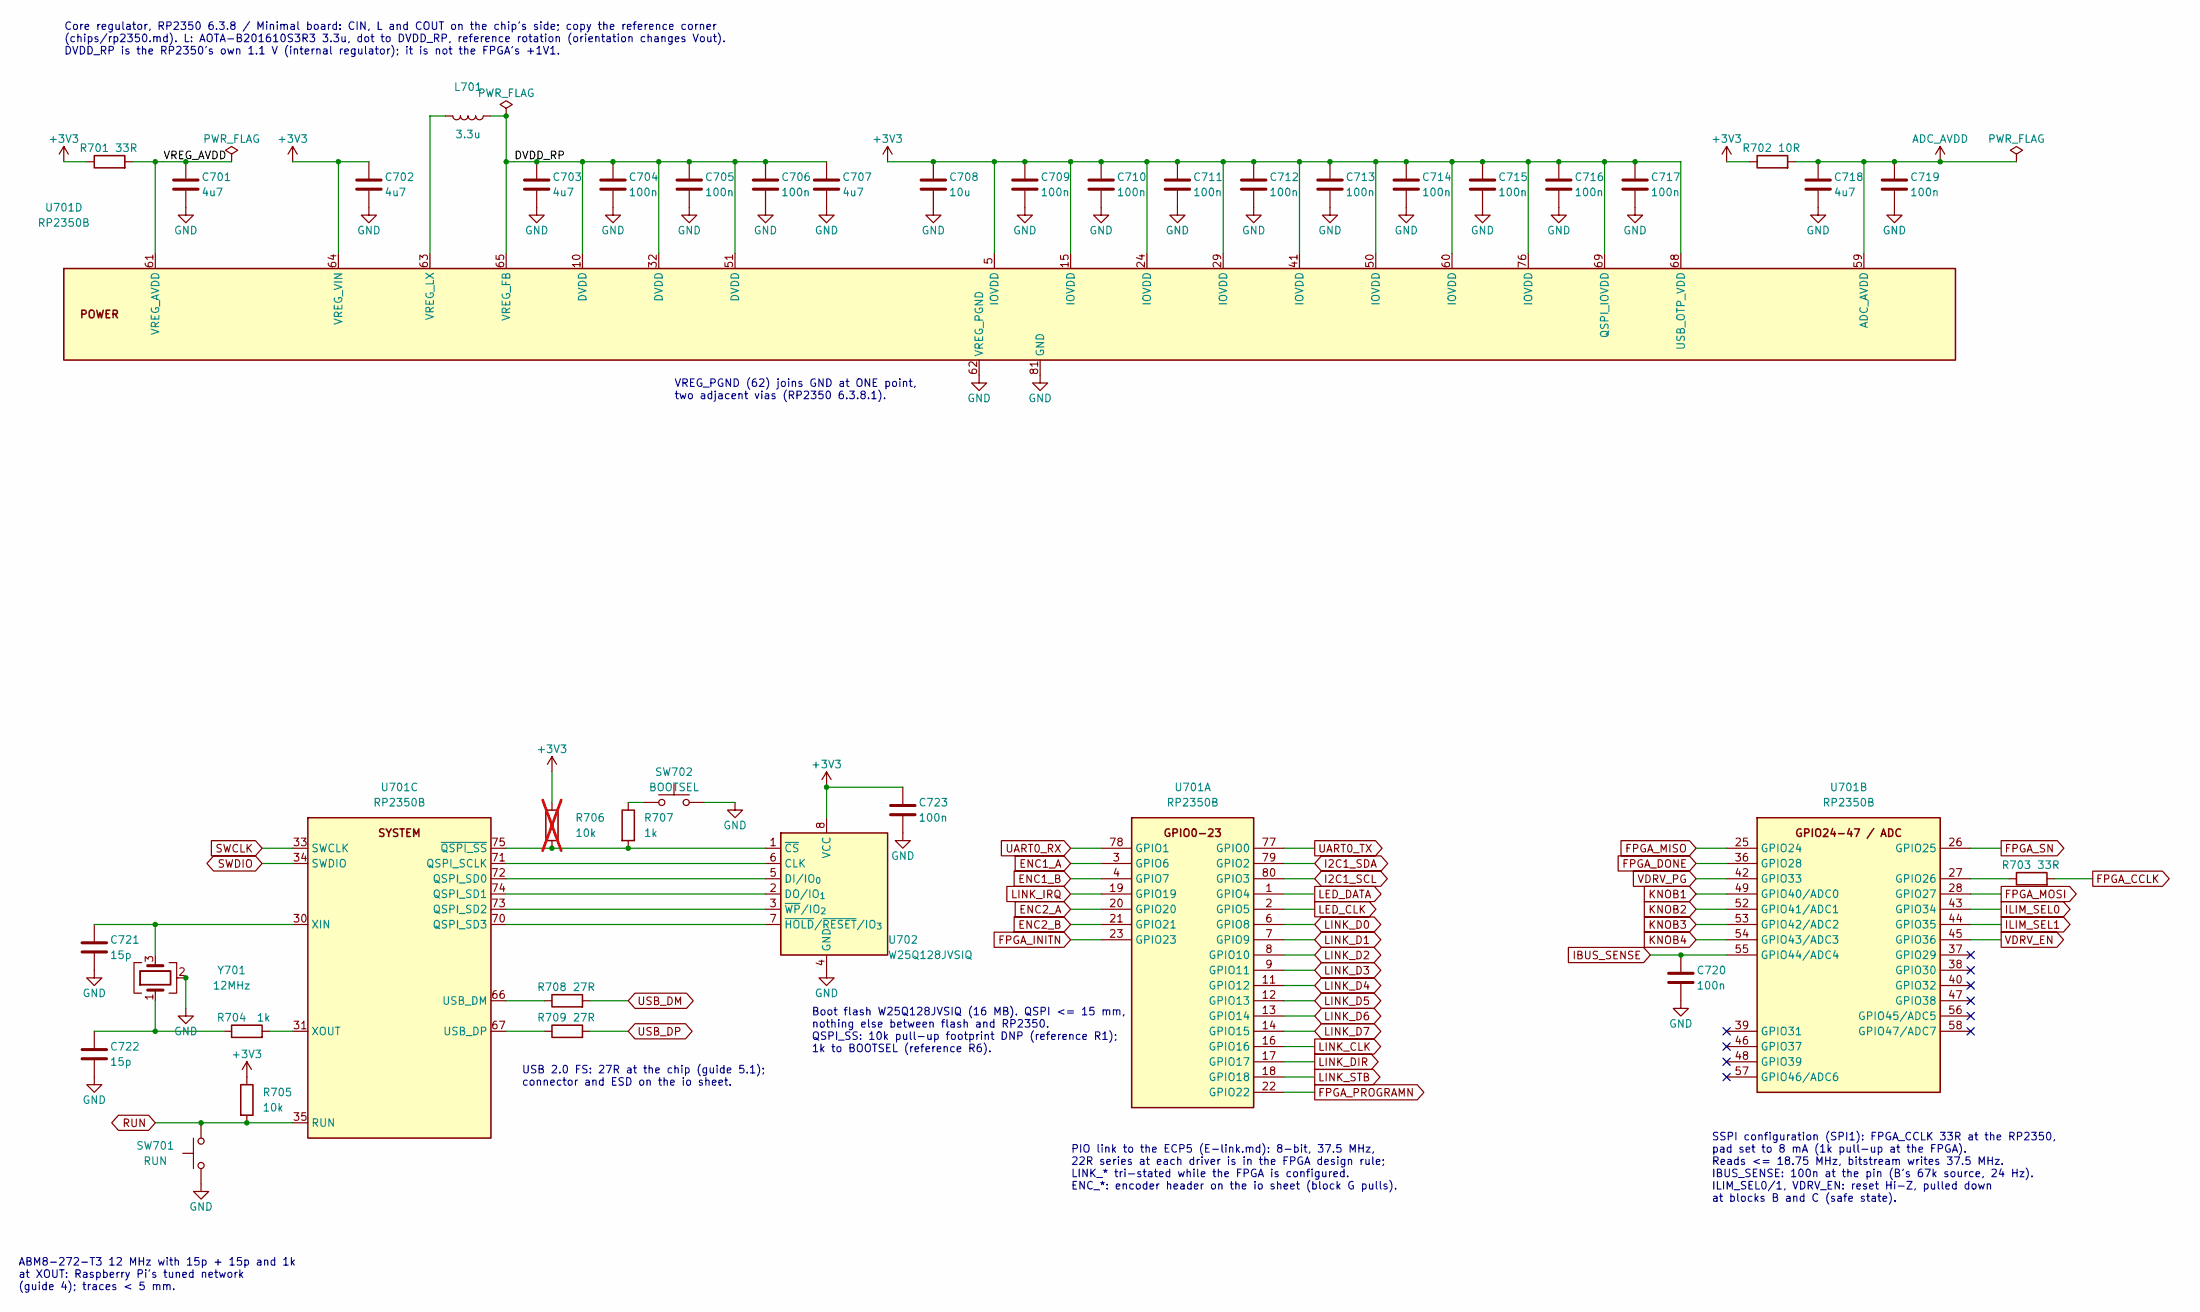
[picture p28: schematic mcu.kicad_sch, Studio Amp satellite: RP2350B, flash, USB]

Parts:
C701, C707, C718: 4u7; C_0402_1005Metric; MPN CL05A475MP5NRNC; LCSC C23733
C702, C703: 4u7; C_0402_1005Metric_RPi_SmallPads; MPN CL05A475MP5NRNC; LCSC C23733
C704, C705, C706, C709, C710, C711, C712, C713, C714, C715, C716, C717, C719, C720, C723: 100n; C_0402_1005Metric; MPN CL05B104KO5NNNC; LCSC C1525
C708: 10u; C_0603_1608Metric; MPN CL10A106KP8NNNC; LCSC C19702
C721, C722: 15p; C_0402_1005Metric; MPN 0402CG150J500NT; LCSC C1548
L701: 3.3u; L_Abracon_AOTA-B201610S3R3_pol; MPN AOTA-B201610S3R3-101-T; LCSC C42411119
R701, R703: 33R; R_0402_1005Metric; MPN 0402WGF330JTCE; LCSC C25105
R702: 10R; R_0402_1005Metric; MPN 0402WGF100JTCE; LCSC C25077
R704, R707: 1k; R_0402_1005Metric; MPN 0402WGF1001TCE; LCSC C11702
R705: 10k; R_0402_1005Metric; MPN 0402WGF1002TCE; LCSC C25744
R706: 10k; R_0402_1005Metric; MPN 0402WGF1002TCE; LCSC C25744; not fitted
R708, R709: 27R; R_0402_1005Metric; MPN 0402WGF270JTCE; LCSC C25100
SW701: RUN; SW_Push_1P1T_XKB_TS-1187A; MPN TS-1187A-B-A-B; LCSC C318884
SW702: BOOTSEL; SW_Push_1P1T_XKB_TS-1187A; MPN TS-1187A-B-A-B; LCSC C318884
U701: RP2350B; QFN-80-1EP_10x10mm_P0.4mm_EP3.4x3.4mm; MPN RP2350B; LCSC C42415655
U702: W25Q128JVSIQ; SOIC-8_5.3x5.3mm_P1.27mm; MPN W25Q128JVSIQ; LCSC C97521
Y701: 12MHz; Crystal_SMD_3225-4Pin_3.2x2.5mm; MPN ABM8-272-T3; LCSC C20625731

Connections:
ENC1_A: U701.3 (GPIO6); also elsewhere on the board
ENC1_B: U701.4 (GPIO7); also elsewhere on the board
ENC2_A: U701.20 (GPIO20); also elsewhere on the board
ENC2_B: U701.21 (GPIO21); also elsewhere on the board
FPGA_CCLK: R703.2; also elsewhere on the board
FPGA_DONE: U701.36 (GPIO28); also elsewhere on the board
FPGA_INITN: U701.23 (GPIO23); also elsewhere on the board
FPGA_MISO: U701.25 (GPIO24); also elsewhere on the board
FPGA_MOSI: U701.28 (GPIO27); also elsewhere on the board
FPGA_PROGRAMN: U701.22 (GPIO22); also elsewhere on the board
FPGA_SN: U701.26 (GPIO25); also elsewhere on the board
I2C1_SCL: U701.80 (GPIO3); also elsewhere on the board
I2C1_SDA: U701.79 (GPIO2); also elsewhere on the board
IBUS_SENSE: C720.1, U701.55 (GPIO44/ADC4); also elsewhere on the board
ILIM_SEL0: U701.43 (GPIO34); also elsewhere on the board
ILIM_SEL1: U701.44 (GPIO35); also elsewhere on the board
KNOB1: U701.49 (GPIO40/ADC0); also elsewhere on the board
KNOB2: U701.52 (GPIO41/ADC1); also elsewhere on the board
KNOB3: U701.53 (GPIO42/ADC2); also elsewhere on the board
KNOB4: U701.54 (GPIO43/ADC3); also elsewhere on the board
LED_CLK: U701.2 (GPIO5); also elsewhere on the board
LED_DATA: U701.1 (GPIO4); also elsewhere on the board
LINK_CLK: U701.16 (GPIO16); also elsewhere on the board
LINK_D0: U701.6 (GPIO8); also elsewhere on the board
LINK_D1: U701.7 (GPIO9); also elsewhere on the board
LINK_D2: U701.8 (GPIO10); also elsewhere on the board
LINK_D3: U701.9 (GPIO11); also elsewhere on the board
LINK_D4: U701.11 (GPIO12); also elsewhere on the board
LINK_D5: U701.12 (GPIO13); also elsewhere on the board
LINK_D6: U701.13 (GPIO14); also elsewhere on the board
LINK_D7: U701.14 (GPIO15); also elsewhere on the board
LINK_DIR: U701.17 (GPIO17); also elsewhere on the board
LINK_IRQ: U701.19 (GPIO19); also elsewhere on the board
LINK_STB: U701.18 (GPIO18); also elsewhere on the board
unnamed: C722.1, R704.1, Y701.1
unnamed: R707.1, SW702.1
unnamed: R703.1, U701.27 (GPIO26)
unnamed: U701.71 (QSPI_SCLK), U702.6 (CLK)
unnamed: U701.72 (QSPI_SD0), U702.5 (DI/IO_{0})
unnamed: U701.74 (QSPI_SD1), U702.2 (DO/IO_{1})
unnamed: U701.73 (QSPI_SD2), U702.3 (~WP/IO_{2})
unnamed: U701.70 (QSPI_SD3), U702.7 (~HOLD/~RESET/IO_{3})
unnamed: R708.1, U701.66 (USB_DM)
unnamed: R709.1, U701.67 (USB_DP)
unnamed: C721.1, U701.30 (XIN), Y701.3
unnamed: R704.2, U701.31 (XOUT)
unnamed: R706.2, R707.2, U701.75 (~QSPI_SS), U702.1 (~CS)
unnamed: L701.2, U701.63 (VREG_LX)
RUN: R705.2, SW701.2, U701.35 (RUN); also elsewhere on the board
SWCLK: U701.33 (SWCLK); also elsewhere on the board
SWDIO: U701.34 (SWDIO); also elsewhere on the board
UART0_RX: U701.78 (GPIO1); also elsewhere on the board
UART0_TX: U701.77 (GPIO0); also elsewhere on the board
USB_DM: R708.2; also elsewhere on the board
USB_DP: R709.2; also elsewhere on the board
VDRV_EN: U701.45 (GPIO36); also elsewhere on the board
VDRV_PG: U701.42 (GPIO33); also elsewhere on the board

Notes on the sheet:
VREG_PGND (62) joins GND at ONE point, two adjacent vias (RP2350 6.3.8.1).
Core regulator, RP2350 6.3.8 / Minimal board: CIN, L and COUT on the chip's side; copy the reference corner (chips/rp2350.md). L: AOTA-B201610S3R3 3.3u, dot to DVDD_RP, reference rotation (orientation changes Vout). DVDD_RP is the RP2350's own 1.1 V (internal regulator); it is not the FPGA's +1V1.
PIO link to the ECP5 (E-link.md): 8-bit, 37.5 MHz, 22R series at each driver is in the FPGA design rule; LINK_* tri-stated while the FPGA is configured. ENC_*: encoder header on the io sheet (block G pulls).
SSPI configuration (SPI1): FPGA_CCLK 33R at the RP2350, pad set to 8 mA (1k pull-up at the FPGA). Reads <= 18.75 MHz, bitstream writes 37.5 MHz. IBUS_SENSE: 100n at the pin (B's 67k source, 24 Hz). ILIM_SEL0/1, VDRV_EN: reset Hi-Z, pulled down at blocks B and C (safe state).
ABM8-272-T3 12 MHz with 15p + 15p and 1k at XOUT: Raspberry Pi's tuned network (guide 4); traces < 5 mm.
Boot flash W25Q128JVSIQ (16 MB). QSPI <= 15 mm, nothing else between flash and RP2350. QSPI_SS: 10k pull-up footprint DNP (reference R1); 1k to BOOTSEL (reference R6).
USB 2.0 FS: 27R at the chip (guide 5.1); connector and ESD on the io sheet.

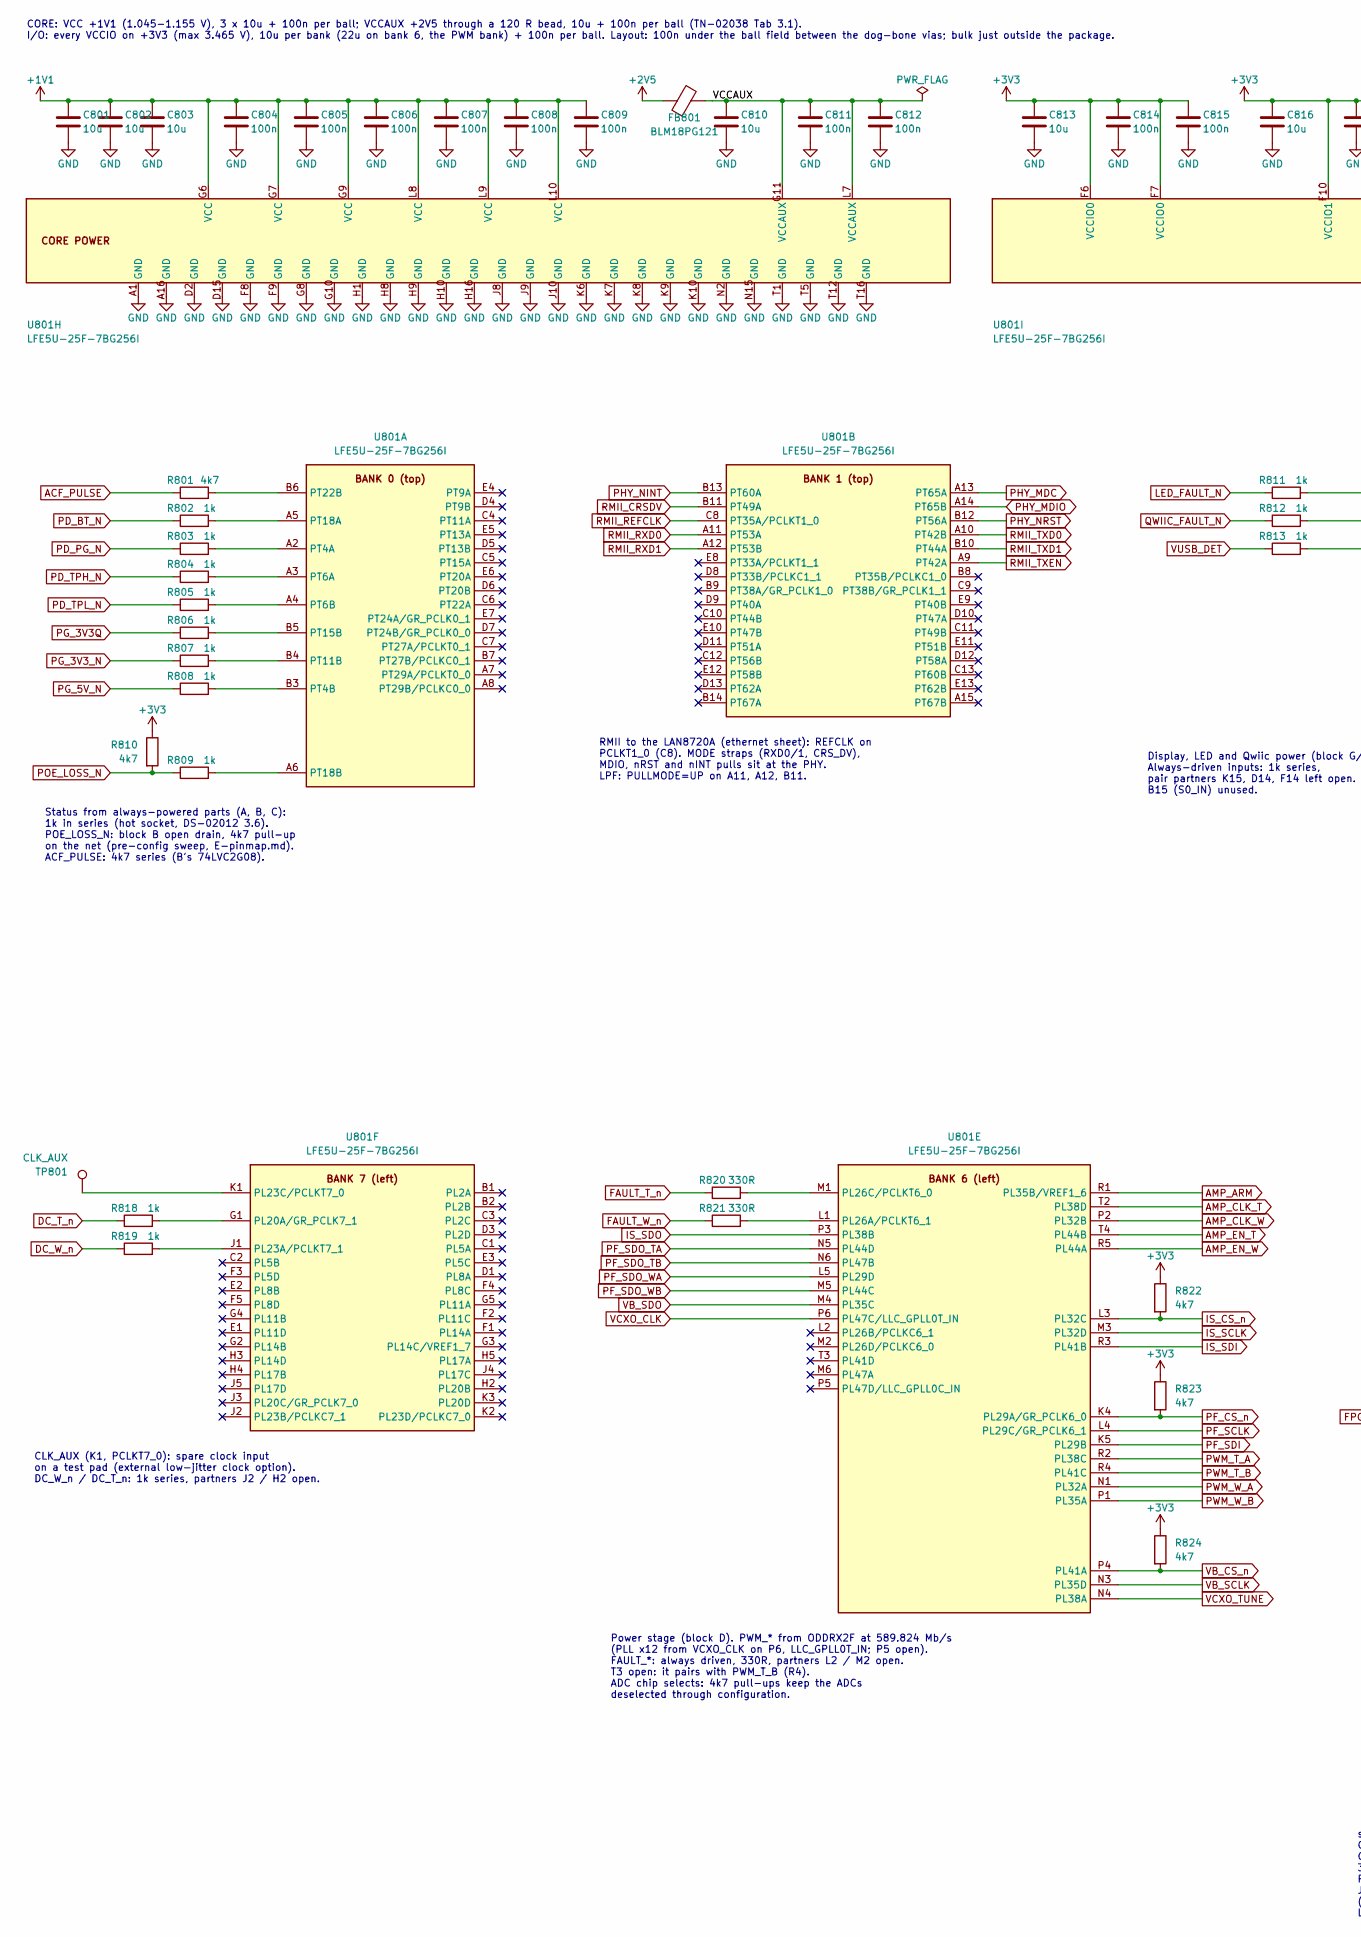
[picture p29: schematic fpga.kicad_sch, Studio Amp satellite: ECP5 FPGA and configuration, part in row 1, column 1]

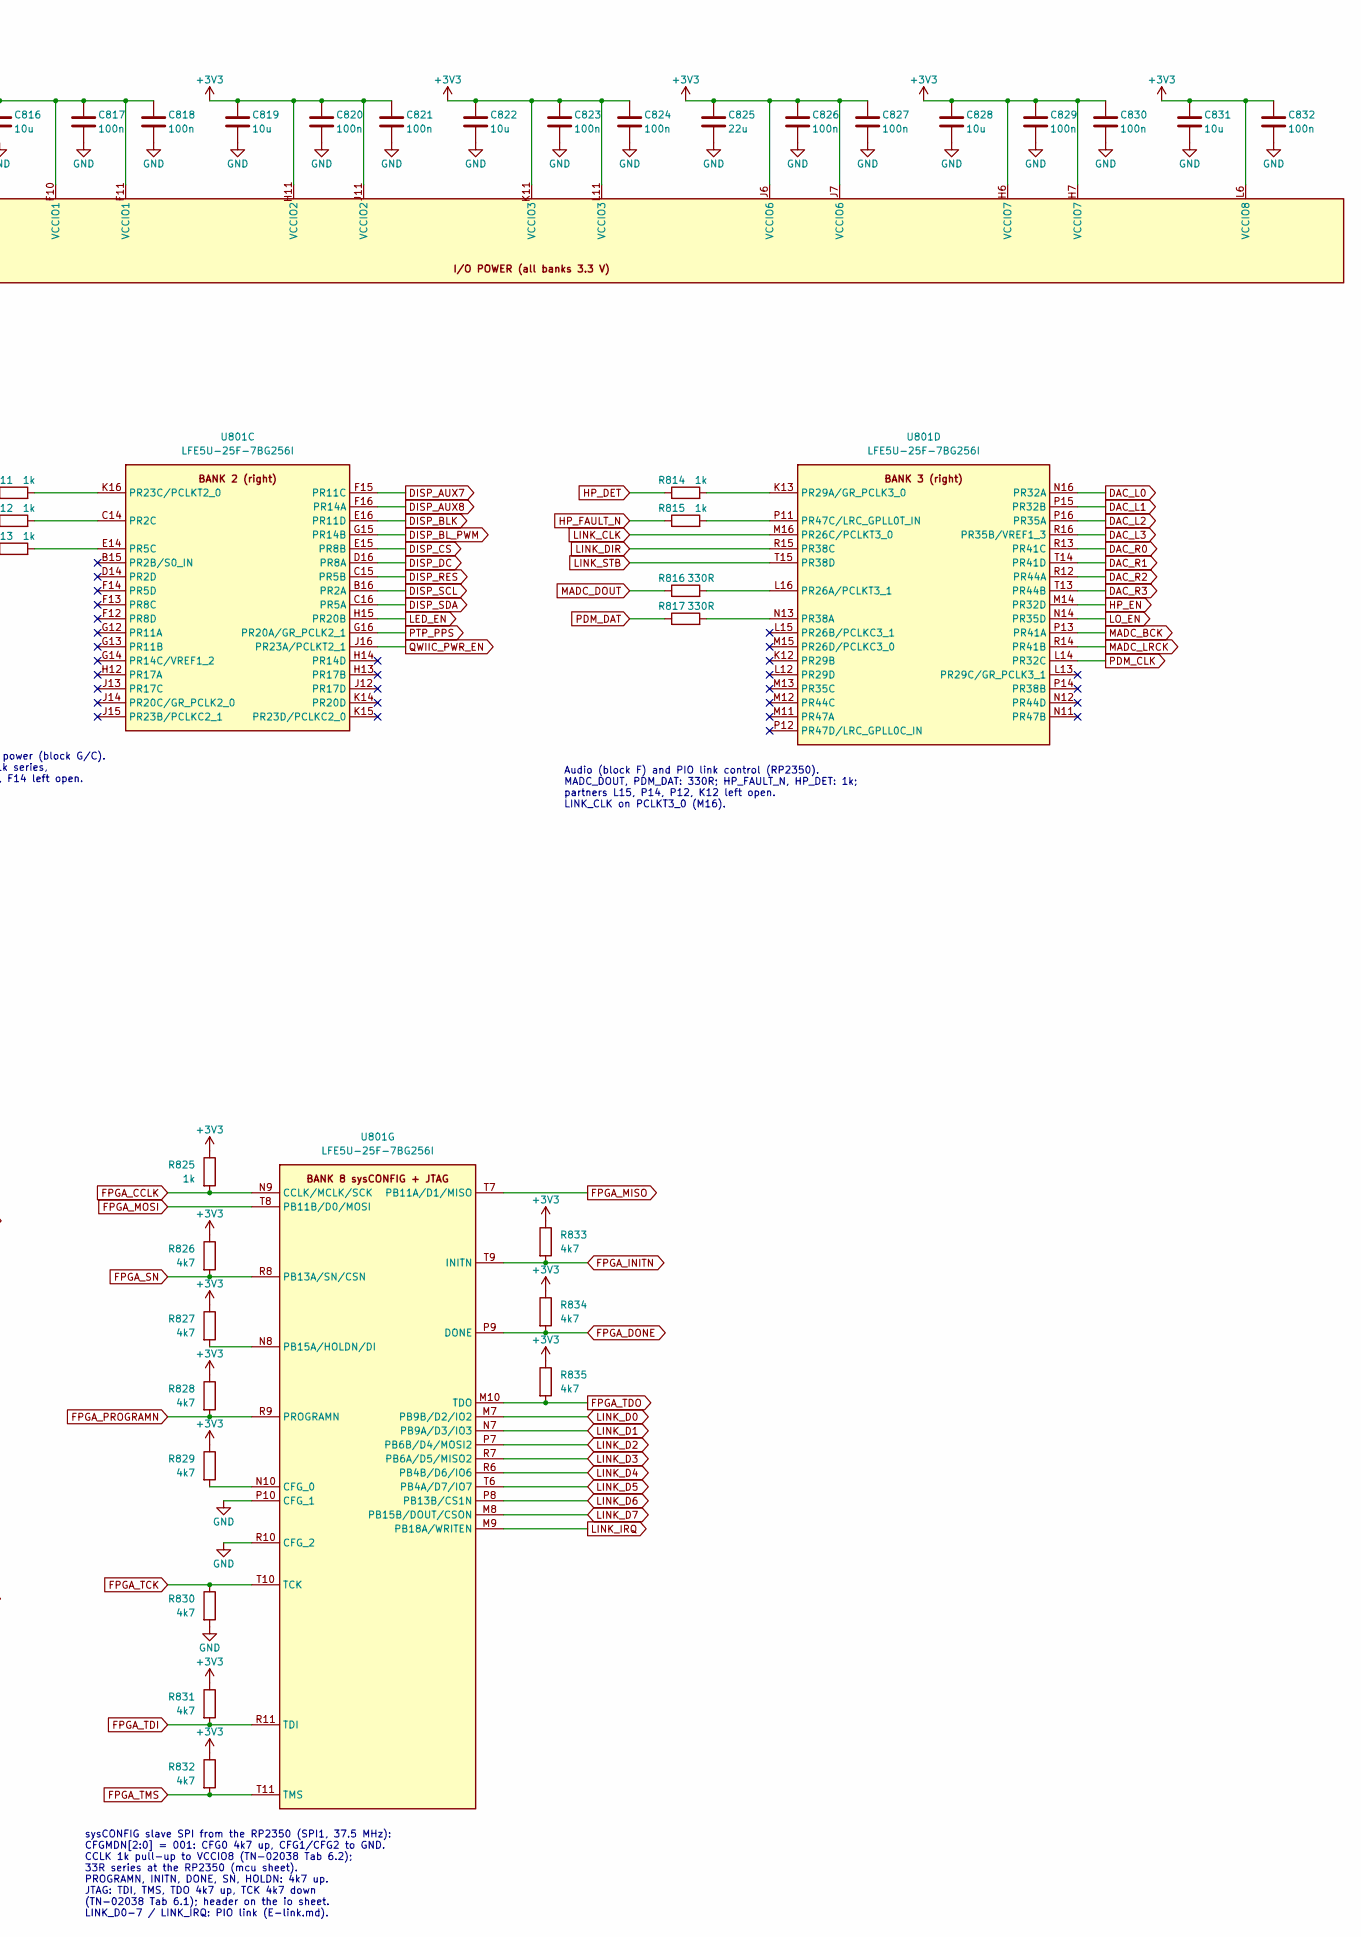
[picture p30: schematic fpga.kicad_sch, Studio Amp satellite: ECP5 FPGA and configuration, part in row 1, column 2]

Parts:
C801, C802, C803, C810, C813, C816, C819, C822, C828, C831: 10u; C_0603_1608Metric; MPN CL10A106KP8NNNC; LCSC C19702
C804, C805, C806, C807, C808, C809, C811, C812, C814, C815, C817, C818, C820, C821, C823, C824, C826, C827, C829, C830, C832: 100n; C_0402_1005Metric; MPN CL05B104KO5NNNC; LCSC C1525
C825: 22u; C_0805_2012Metric; MPN CL21A226MAQNNNE; LCSC C45783
FB801: BLM18PG121; L_0603_1608Metric; MPN BLM18PG121SN1D; LCSC C14709
R801, R810, R822, R823, R824, R826, R827, R828, R829, R830, R831, R832, R833, R834, R835: 4k7; R_0402_1005Metric; MPN 0402WGF4701TCE; LCSC C25900
R802, R803, R804, R805, R806, R807, R808, R809, R811, R812, R813, R814, R815, R818, R819, R825: 1k; R_0402_1005Metric; MPN 0402WGF1001TCE; LCSC C11702
R816, R817, R820, R821: 330R; R_0402_1005Metric; MPN 0402WGF3300TCE; LCSC C25104
TP801: CLK_AUX; TestPoint_Pad_D1.0mm
U801: LFE5U-25F-7BG256I; Lattice_caBGA-256_14x14mm_Layout16x16_P0.8mm; MPN LFE5U-25F-7BG256I; LCSC C1550762

Connections:
+2V5: FB801.1; also elsewhere on the board
/fpga/VCCAUX: C810.1, C811.1, C812.1, FB801.2, U801.G11 (VCCAUX), U801.L7 (VCCAUX)
ACF_PULSE: R801.1; also elsewhere on the board
AMP_ARM: U801.R1 (PL35B/VREF1_6); also elsewhere on the board
AMP_CLK_T: U801.T2 (PL38D); also elsewhere on the board
AMP_CLK_W: U801.P2 (PL32B); also elsewhere on the board
AMP_EN_T: U801.T4 (PL44B); also elsewhere on the board
AMP_EN_W: U801.R5 (PL44A); also elsewhere on the board
DAC_L0: U801.N16 (PR32A); also elsewhere on the board
DAC_L1: U801.P15 (PR32B); also elsewhere on the board
DAC_L2: U801.P16 (PR35A); also elsewhere on the board
DAC_L3: U801.R16 (PR35B/VREF1_3); also elsewhere on the board
DAC_R0: U801.R13 (PR41C); also elsewhere on the board
DAC_R1: U801.T14 (PR41D); also elsewhere on the board
DAC_R2: U801.R12 (PR44A); also elsewhere on the board
DAC_R3: U801.T13 (PR44B); also elsewhere on the board
DC_T_n: R818.1; also elsewhere on the board
DC_W_n: R819.1; also elsewhere on the board
DISP_AUX7: U801.F15 (PR11C); also elsewhere on the board
DISP_AUX8: U801.F16 (PR14A); also elsewhere on the board
DISP_BLK: U801.E16 (PR11D); also elsewhere on the board
DISP_BL_PWM: U801.G15 (PR14B); also elsewhere on the board
DISP_CS: U801.E15 (PR8B); also elsewhere on the board
DISP_DC: U801.D16 (PR8A); also elsewhere on the board
DISP_RES: U801.C15 (PR5B); also elsewhere on the board
DISP_SCL: U801.B16 (PR2A); also elsewhere on the board
DISP_SDA: U801.C16 (PR5A); also elsewhere on the board
FAULT_T_n: R820.1; also elsewhere on the board
FAULT_W_n: R821.1; also elsewhere on the board
FPGA_CCLK: R825.2, U801.N9 (CCLK/MCLK/SCK); also elsewhere on the board
FPGA_DONE: R834.2, U801.P9 (DONE); also elsewhere on the board
FPGA_INITN: R833.2, U801.T9 (INITN); also elsewhere on the board
FPGA_MISO: U801.T7 (PB11A/D1/MISO); also elsewhere on the board
FPGA_MOSI: U801.T8 (PB11B/D0/MOSI); also elsewhere on the board
FPGA_PROGRAMN: R828.2, U801.R9 (PROGRAMN); also elsewhere on the board
FPGA_SN: R826.2, U801.R8 (PB13A/SN/CSN); also elsewhere on the board
FPGA_TCK: R830.1, U801.T10 (TCK); also elsewhere on the board
FPGA_TDI: R831.2, U801.R11 (TDI); also elsewhere on the board
FPGA_TDO: R835.2, U801.M10 (TDO); also elsewhere on the board
FPGA_TMS: R832.2, U801.T11 (TMS); also elsewhere on the board
HP_DET: R814.1; also elsewhere on the board
HP_EN: U801.M14 (PR32D); also elsewhere on the board
HP_FAULT_N: R815.1; also elsewhere on the board
IS_CS_n: R822.2, U801.L3 (PL32C); also elsewhere on the board
IS_SCLK: U801.M3 (PL32D); also elsewhere on the board
IS_SDI: U801.R3 (PL41B); also elsewhere on the board
IS_SDO: U801.P3 (PL38B); also elsewhere on the board
LED_EN: U801.H15 (PR20B); also elsewhere on the board
LED_FAULT_N: R811.1; also elsewhere on the board
LINK_CLK: U801.M16 (PR26C/PCLKT3_0); also elsewhere on the board
LINK_D0: U801.M7 (PB9B/D2/IO2); also elsewhere on the board
LINK_D1: U801.N7 (PB9A/D3/IO3); also elsewhere on the board
LINK_D2: U801.P7 (PB6B/D4/MOSI2); also elsewhere on the board
LINK_D3: U801.R7 (PB6A/D5/MISO2); also elsewhere on the board
LINK_D4: U801.R6 (PB4B/D6/IO6); also elsewhere on the board
LINK_D5: U801.T6 (PB4A/D7/IO7); also elsewhere on the board
LINK_D6: U801.P8 (PB13B/CS1N); also elsewhere on the board
LINK_D7: U801.M8 (PB15B/DOUT/CSON); also elsewhere on the board
LINK_DIR: U801.R15 (PR38C); also elsewhere on the board
LINK_IRQ: U801.M9 (PB18A/WRITEN); also elsewhere on the board
LINK_STB: U801.T15 (PR38D); also elsewhere on the board
LO_EN: U801.N14 (PR35D); also elsewhere on the board
MADC_BCK: U801.P13 (PR41A); also elsewhere on the board
MADC_DOUT: R816.1; also elsewhere on the board
MADC_LRCK: U801.R14 (PR41B); also elsewhere on the board
unnamed: R803.2, U801.A2 (PT4A)
unnamed: R808.2, U801.B3 (PT4B)
unnamed: R804.2, U801.A3 (PT6A)
unnamed: R805.2, U801.A4 (PT6B)
unnamed: R807.2, U801.B4 (PT11B)
unnamed: R806.2, U801.B5 (PT15B)
unnamed: R802.2, U801.A5 (PT18A)
unnamed: R809.2, U801.A6 (PT18B)
unnamed: R801.2, U801.B6 (PT22B)
unnamed: R812.2, U801.C14 (PR2C)
unnamed: R813.2, U801.E14 (PR5C)
unnamed: R811.2, U801.K16 (PR23C/PCLKT2_0)
unnamed: R816.2, U801.L16 (PR26A/PCLKT3_1)
unnamed: R814.2, U801.K13 (PR29A/GR_PCLK3_0)
unnamed: R817.2, U801.N13 (PR38A)
unnamed: R815.2, U801.P11 (PR47C/LRC_GPLL0T_IN)
unnamed: R821.2, U801.L1 (PL26A/PCLKT6_1)
unnamed: R820.2, U801.M1 (PL26C/PCLKT6_0)
unnamed: R818.2, U801.G1 (PL20A/GR_PCLK7_1)
unnamed: R819.2, U801.J1 (PL23A/PCLKT7_1)
unnamed: TP801.1, U801.K1 (PL23C/PCLKT7_0)
unnamed: R829.2, U801.N10 (CFG_0)
unnamed: R827.2, U801.N8 (PB15A/HOLDN/DI)
PDM_CLK: U801.L14 (PR32C); also elsewhere on the board
PDM_DAT: R817.1; also elsewhere on the board
PD_BT_N: R802.1; also elsewhere on the board
PD_PG_N: R803.1; also elsewhere on the board
PD_TPH_N: R804.1; also elsewhere on the board
PD_TPL_N: R805.1; also elsewhere on the board
PF_CS_n: R823.2, U801.K4 (PL29A/GR_PCLK6_0); also elsewhere on the board
PF_SCLK: U801.L4 (PL29C/GR_PCLK6_1); also elsewhere on the board
PF_SDI: U801.K5 (PL29B); also elsewhere on the board
PF_SDO_TA: U801.N5 (PL44D); also elsewhere on the board
PF_SDO_TB: U801.N6 (PL47B); also elsewhere on the board
PF_SDO_WA: U801.L5 (PL29D); also elsewhere on the board
PF_SDO_WB: U801.M5 (PL44C); also elsewhere on the board
PG_3V3Q: R806.1; also elsewhere on the board
PG_3V3_N: R807.1; also elsewhere on the board
PG_5V_N: R808.1; also elsewhere on the board
PHY_MDC: U801.A13 (PT65A); also elsewhere on the board
PHY_MDIO: U801.A14 (PT65B); also elsewhere on the board
PHY_NINT: U801.B13 (PT60A); also elsewhere on the board
PHY_NRST: U801.B12 (PT56A); also elsewhere on the board
POE_LOSS_N: R809.1, R810.2; also elsewhere on the board
PTP_PPS: U801.G16 (PR20A/GR_PCLK2_1); also elsewhere on the board
PWM_T_A: U801.R2 (PL38C); also elsewhere on the board
PWM_T_B: U801.R4 (PL41C); also elsewhere on the board
PWM_W_A: U801.N1 (PL32A); also elsewhere on the board
PWM_W_B: U801.P1 (PL35A); also elsewhere on the board
QWIIC_FAULT_N: R812.1; also elsewhere on the board
QWIIC_PWR_EN: U801.J16 (PR23A/PCLKT2_1); also elsewhere on the board
RMII_CRSDV: U801.B11 (PT49A); also elsewhere on the board
RMII_REFCLK: U801.C8 (PT35A/PCLKT1_0); also elsewhere on the board
RMII_RXD0: U801.A11 (PT53A); also elsewhere on the board
RMII_RXD1: U801.A12 (PT53B); also elsewhere on the board
RMII_TXD0: U801.A10 (PT42B); also elsewhere on the board
RMII_TXD1: U801.B10 (PT44A); also elsewhere on the board
RMII_TXEN: U801.A9 (PT42A); also elsewhere on the board
VB_CS_n: R824.2, U801.P4 (PL41A); also elsewhere on the board
VB_SCLK: U801.N3 (PL35D); also elsewhere on the board
VB_SDO: U801.M4 (PL35C); also elsewhere on the board
VCXO_CLK: U801.P6 (PL47C/LLC_GPLL0T_IN); also elsewhere on the board
VCXO_TUNE: U801.N4 (PL38A); also elsewhere on the board
VUSB_DET: R813.1; also elsewhere on the board

Notes on the sheet:
CORE: VCC +1V1 (1.045-1.155 V), 3 x 10u + 100n per ball; VCCAUX +2V5 through a 120 R bead, 10u + 100n per ball (TN-02038 Tab 3.1). I/O: every VCCIO on +3V3 (max 3.465 V), 10u per bank (22u on bank 6, the PWM bank) + 100n per ball. Layout: 100n under the ball field between the dog-bone vias; bulk ju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
Status from always-powered parts (A, B, C): 1k in series (hot socket, DS-02012 3.6). POE_LOSS_N: block B open drain, 4k7 pull-up on the net (pre-config sweep, E-pinmap.md). ACF_PULSE: 4k7 series (B's 74LVC2G08).
RMII to the LAN8720A (ethernet sheet): REFCLK on PCLKT1_0 (C8). MODE straps (RXD0/1, CRS_DV), MDIO, nRST and nINT pulls sit at the PHY. LPF: PULLMODE=UP on A11, A12, B11.
Display, LED and Qwiic power (block G/C). Always-driven inputs: 1k series, pair partners K15, D14, F14 left open. B15 (S0_IN) unused.
Audio (block F) and PIO link control (RP2350). MADC_DOUT, PDM_DAT: 330R; HP_FAULT_N, HP_DET: 1k; partners L15, P14, P12, K12 left open. LINK_CLK on PCLKT3_0 (M16).
CLK_AUX (K1, PCLKT7_0): spare clock input on a test pad (external low-jitter clock option). DC_W_n / DC_T_n: 1k series, partners J2 / H2 open.
Power stage (block D). PWM_* from ODDRX2F at 589.824 Mb/s (PLL x12 from VCXO_CLK on P6, LLC_GPLL0T_IN; P5 open). FAULT_*: always driven, 330R, partners L2 / M2 open. T3 open: it pairs with PWM_T_B (R4). ADC chip selects: 4k7 pull-ups keep the ADCs deselected through configuration.
sysCONFIG slave SPI from the RP2350 (SPI1, 37.5 MHz): CFGMDN[2:0] = 001: CFG0 4k7 up, CFG1/CFG2 to GND. CCLK 1k pull-up to VCCIO8 (TN-02038 Tab 6.2); 33R series at the RP2350 (mcu sheet). PROGRAMN, INITN, DONE, SN, HOLDN: 4k7 up. JTAG: TDI, TMS, TDO 4k7 up, TCK 4k7 down (TN-02038 Tab 6.1); header o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

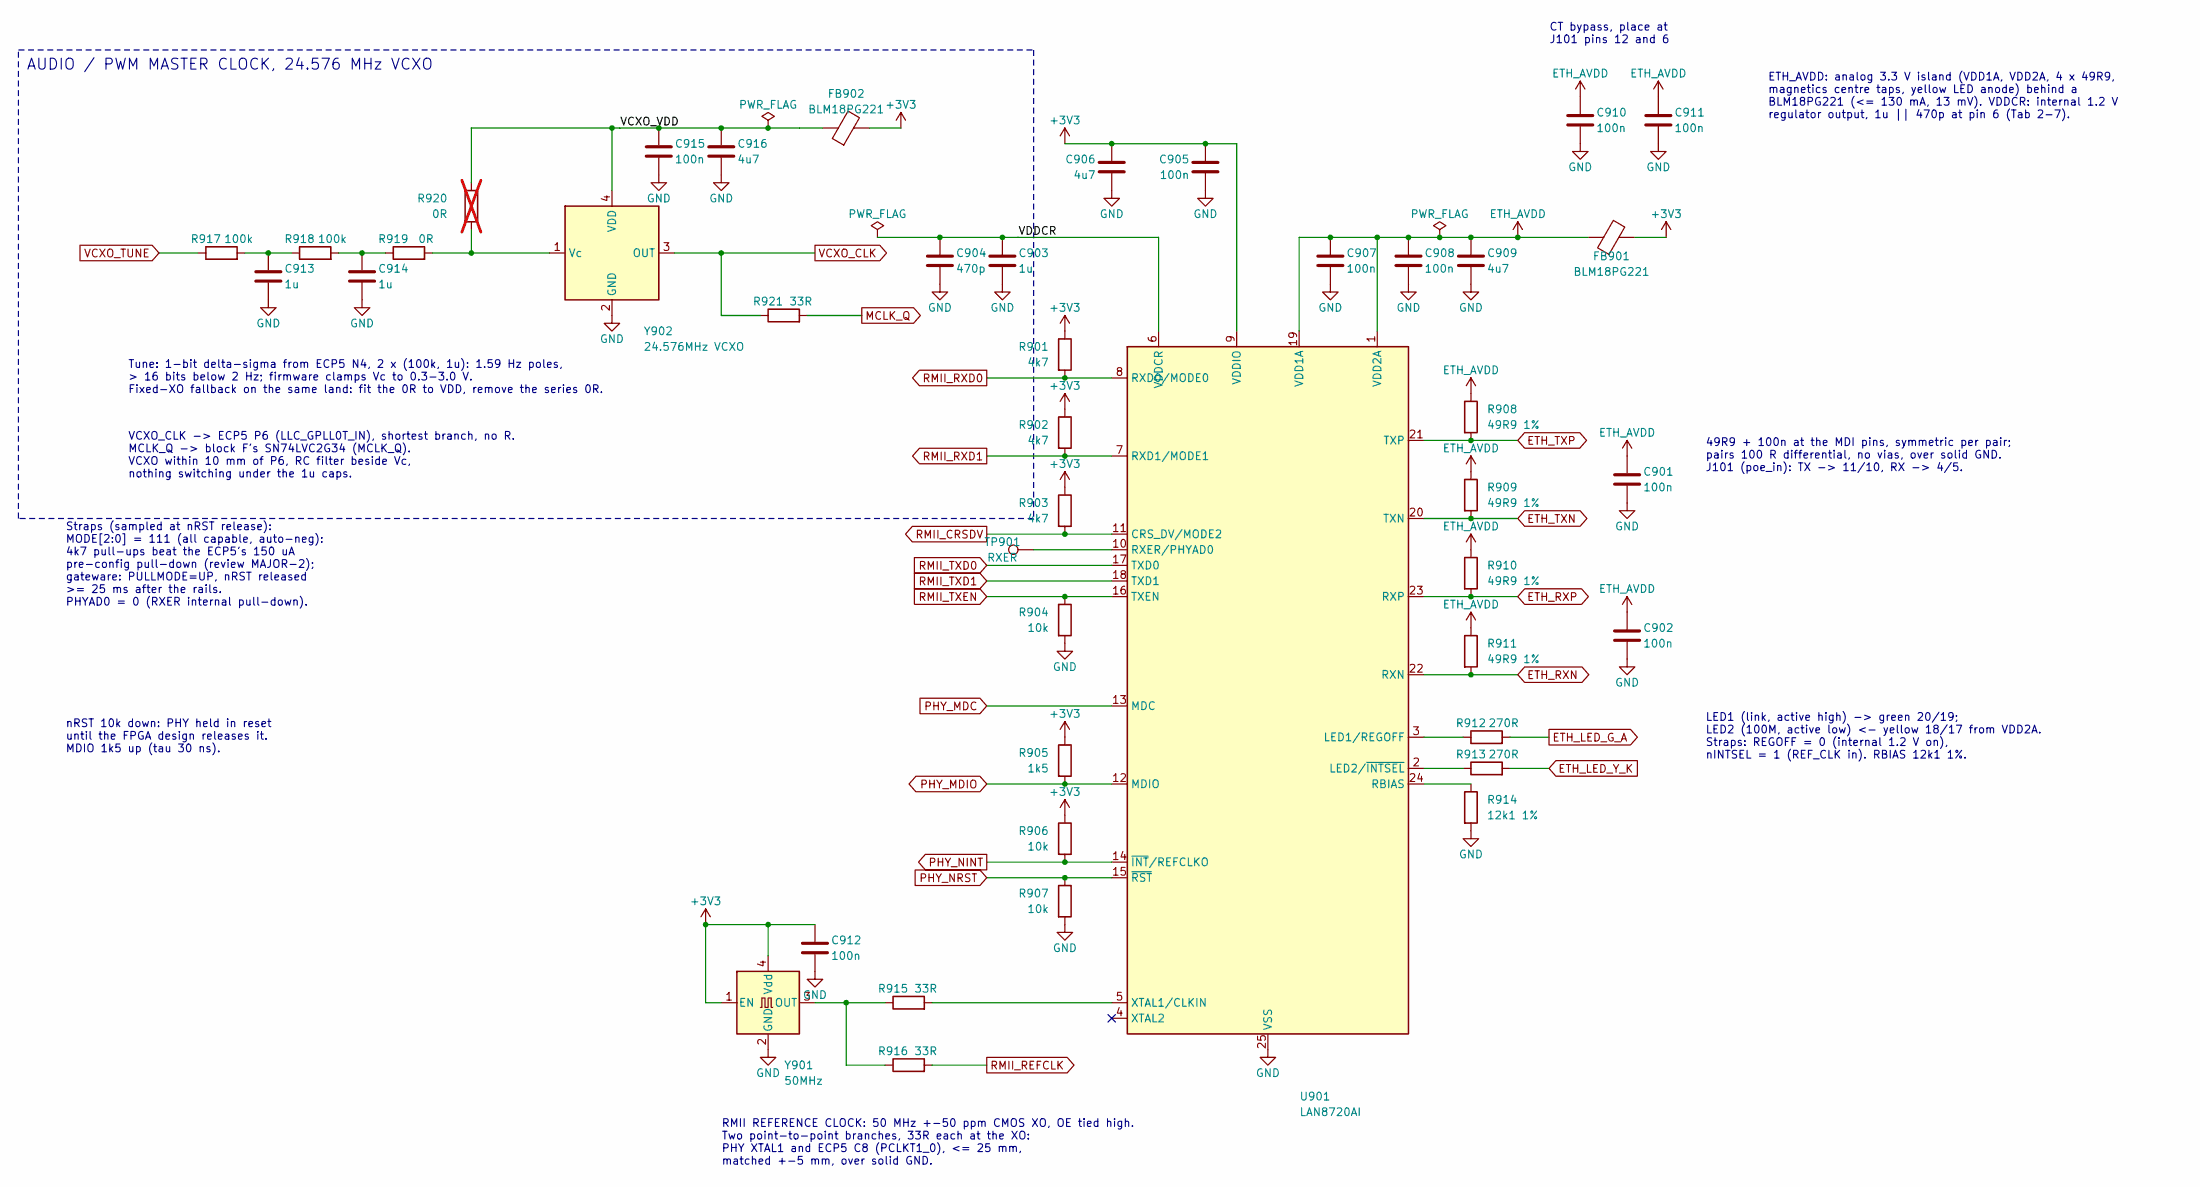
[picture p31: schematic ethernet.kicad_sch, Studio Amp satellite: Ethernet PHY and clocks]

Parts:
C901, C902, C905, C907, C908, C910, C911, C912, C915: 100n; C_0402_1005Metric; MPN CL05B104KO5NNNC; LCSC C1525
C903, C913, C914: 1u; C_0402_1005Metric; MPN CL05A105KA5NQNC; LCSC C52923
C904: 470p; C_0402_1005Metric; MPN 0402B471K500NT; LCSC C1537
C906, C909, C916: 4u7; C_0603_1608Metric; MPN CL10A475KO8NNNC; LCSC C19666
FB901, FB902: BLM18PG221; L_0603_1608Metric; MPN BLM18PG221SN1D; LCSC C80165
R901, R902, R903: 4k7; R_0402_1005Metric; MPN 0402WGF4701TCE; LCSC C25900
R904, R906, R907: 10k; R_0402_1005Metric; MPN 0402WGF1002TCE; LCSC C25744
R905: 1k5; R_0402_1005Metric; MPN 0402WGF1501TCE; LCSC C25867
R908, R909, R910, R911: 49R9 1%; R_0603_1608Metric; MPN 0603WAF499JT5E; LCSC C23185
R912, R913: 270R; R_0402_1005Metric; MPN 0402WGF2700TCE; LCSC C25099
R914: 12k1 1%; R_0402_1005Metric; MPN 0402WGF1212TCE; LCSC C25852
R915, R916, R921: 33R; R_0402_1005Metric; MPN 0402WGF330JTCE; LCSC C25105
R917, R918: 100k; R_0402_1005Metric; MPN 0402WGF1003TCE; LCSC C25741
R919: 0R; R_0402_1005Metric; MPN 0402WGF0000TCE; LCSC C17168
R920: 0R; R_0402_1005Metric; MPN 0402WGF0000TCE; LCSC C17168; not fitted
TP901: RXER; TestPoint_Pad_D1.0mm
U901: LAN8720AI; QFN-24-1EP_4x4mm_P0.5mm_EP2.5x2.5mm; MPN LAN8720AI-CP-TR; LCSC C17146
Y901: 50MHz; Oscillator_SMD_3225-4Pin_YXC_SX3V; MPN OT2EL4C4JI-111OLP-50M; LCSC C5203552
Y902: 24.576MHz VCXO; Oscillator_SMD_3225-4Pin_YXC_SX3V; MPN SX3V24.576B20100F30TNN; LCSC C5179997

Connections:
ETH_LED_G_A: R912.2; also elsewhere on the board
ETH_LED_Y_K: R913.2; also elsewhere on the board
ETH_RXN: R911.2, U901.22 (RXN); also elsewhere on the board
ETH_RXP: R910.2, U901.23 (RXP); also elsewhere on the board
ETH_TXN: R909.2, U901.20 (TXN); also elsewhere on the board
ETH_TXP: R908.2, U901.21 (TXP); also elsewhere on the board
MCLK_Q: R921.2; also elsewhere on the board
unnamed: C913.1, R917.2, R918.1
unnamed: C914.1, R918.2, R919.1
unnamed: R912.1, U901.3 (LED1/REGOFF)
unnamed: R913.1, U901.2 (LED2/~INTSEL)
unnamed: R914.1, U901.24 (RBIAS)
unnamed: TP901.1, U901.10 (RXER/PHYAD0)
unnamed: R915.2, U901.5 (XTAL1/CLKIN)
unnamed: R915.1, R916.1, Y901.3 (OUT)
unnamed: R919.2, R920.2, Y902.1 (Vc)
PHY_MDC: U901.13 (MDC); also elsewhere on the board
PHY_MDIO: R905.2, U901.12 (MDIO); also elsewhere on the board
PHY_NINT: R906.2, U901.14 (~INT/REFCLKO); also elsewhere on the board
PHY_NRST: R907.1, U901.15 (~RST); also elsewhere on the board
RMII_CRSDV: R903.2, U901.11 (CRS_DV/MODE2); also elsewhere on the board
RMII_REFCLK: R916.2; also elsewhere on the board
RMII_RXD0: R901.2, U901.8 (RXD0/MODE0); also elsewhere on the board
RMII_RXD1: R902.2, U901.7 (RXD1/MODE1); also elsewhere on the board
RMII_TXD0: U901.17 (TXD0); also elsewhere on the board
RMII_TXD1: U901.18 (TXD1); also elsewhere on the board
RMII_TXEN: R904.1, U901.16 (TXEN); also elsewhere on the board
VCXO_CLK: R921.1, Y902.3 (OUT); also elsewhere on the board
VCXO_TUNE: R917.1; also elsewhere on the board

Notes on the sheet:
Straps (sampled at nRST release): MODE[2:0] = 111 (all capable, auto-neg): 4k7 pull-ups beat the ECP5's 150 uA pre-config pull-down (review MAJOR-2); gateware: PULLMODE=UP, nRST released >= 25 ms after the rails. PHYAD0 = 0 (RXER internal pull-down).
nRST 10k down: PHY held in reset until the FPGA design releases it. MDIO 1k5 up (tau 30 ns).
49R9 + 100n at the MDI pins, symmetric per pair; pairs 100 R differential, no vias, over solid GND. J101 (poe_in): TX -> 11/10, RX -> 4/5.
LED1 (link, active high) -> green 20/19; LED2 (100M, active low) <- yellow 18/17 from VDD2A. Straps: REGOFF = 0 (internal 1.2 V on), nINTSEL = 1 (REF_CLK in). RBIAS 12k1 1%.
CT bypass, place at J101 pins 12 and 6
ETH_AVDD: analog 3.3 V island (VDD1A, VDD2A, 4 x 49R9, magnetics centre taps, yellow LED anode) behind a BLM18PG221 (<= 130 mA, 13 mV). VDDCR: internal 1.2 V regulator output, 1u || 470p at pin 6 (Tab 2-7).
RMII REFERENCE CLOCK: 50 MHz +-50 ppm CMOS XO, OE tied high. Two point-to-point branches, 33R each at the XO: PHY XTAL1 and ECP5 C8 (PCLKT1_0), <= 25 mm, matched +-5 mm, over solid GND.
Tune: 1-bit delta-sigma from ECP5 N4, 2 x (100k, 1u): 1.59 Hz poles, > 16 bits below 2 Hz; firmware clamps Vc to 0.3-3.0 V. Fixed-XO fallback on the same land: fit the 0R to VDD, remove the series 0R.
VCXO_CLK -> ECP5 P6 (LLC_GPLL0T_IN), shortest branch, no R. MCLK_Q -> block F's SN74LVC2G34 (MCLK_Q). VCXO within 10 mm of P6, RC filter beside Vc, nothing switching under the 1u caps.
AUDIO / PWM MASTER CLOCK, 24.576 MHz VCXO
