sequoia-hope/studio-amp/hw/satellite/a/satellite.kicad_pcb

## KiCad design hw/satellite/a/satellite.kicad_pcb (continued)

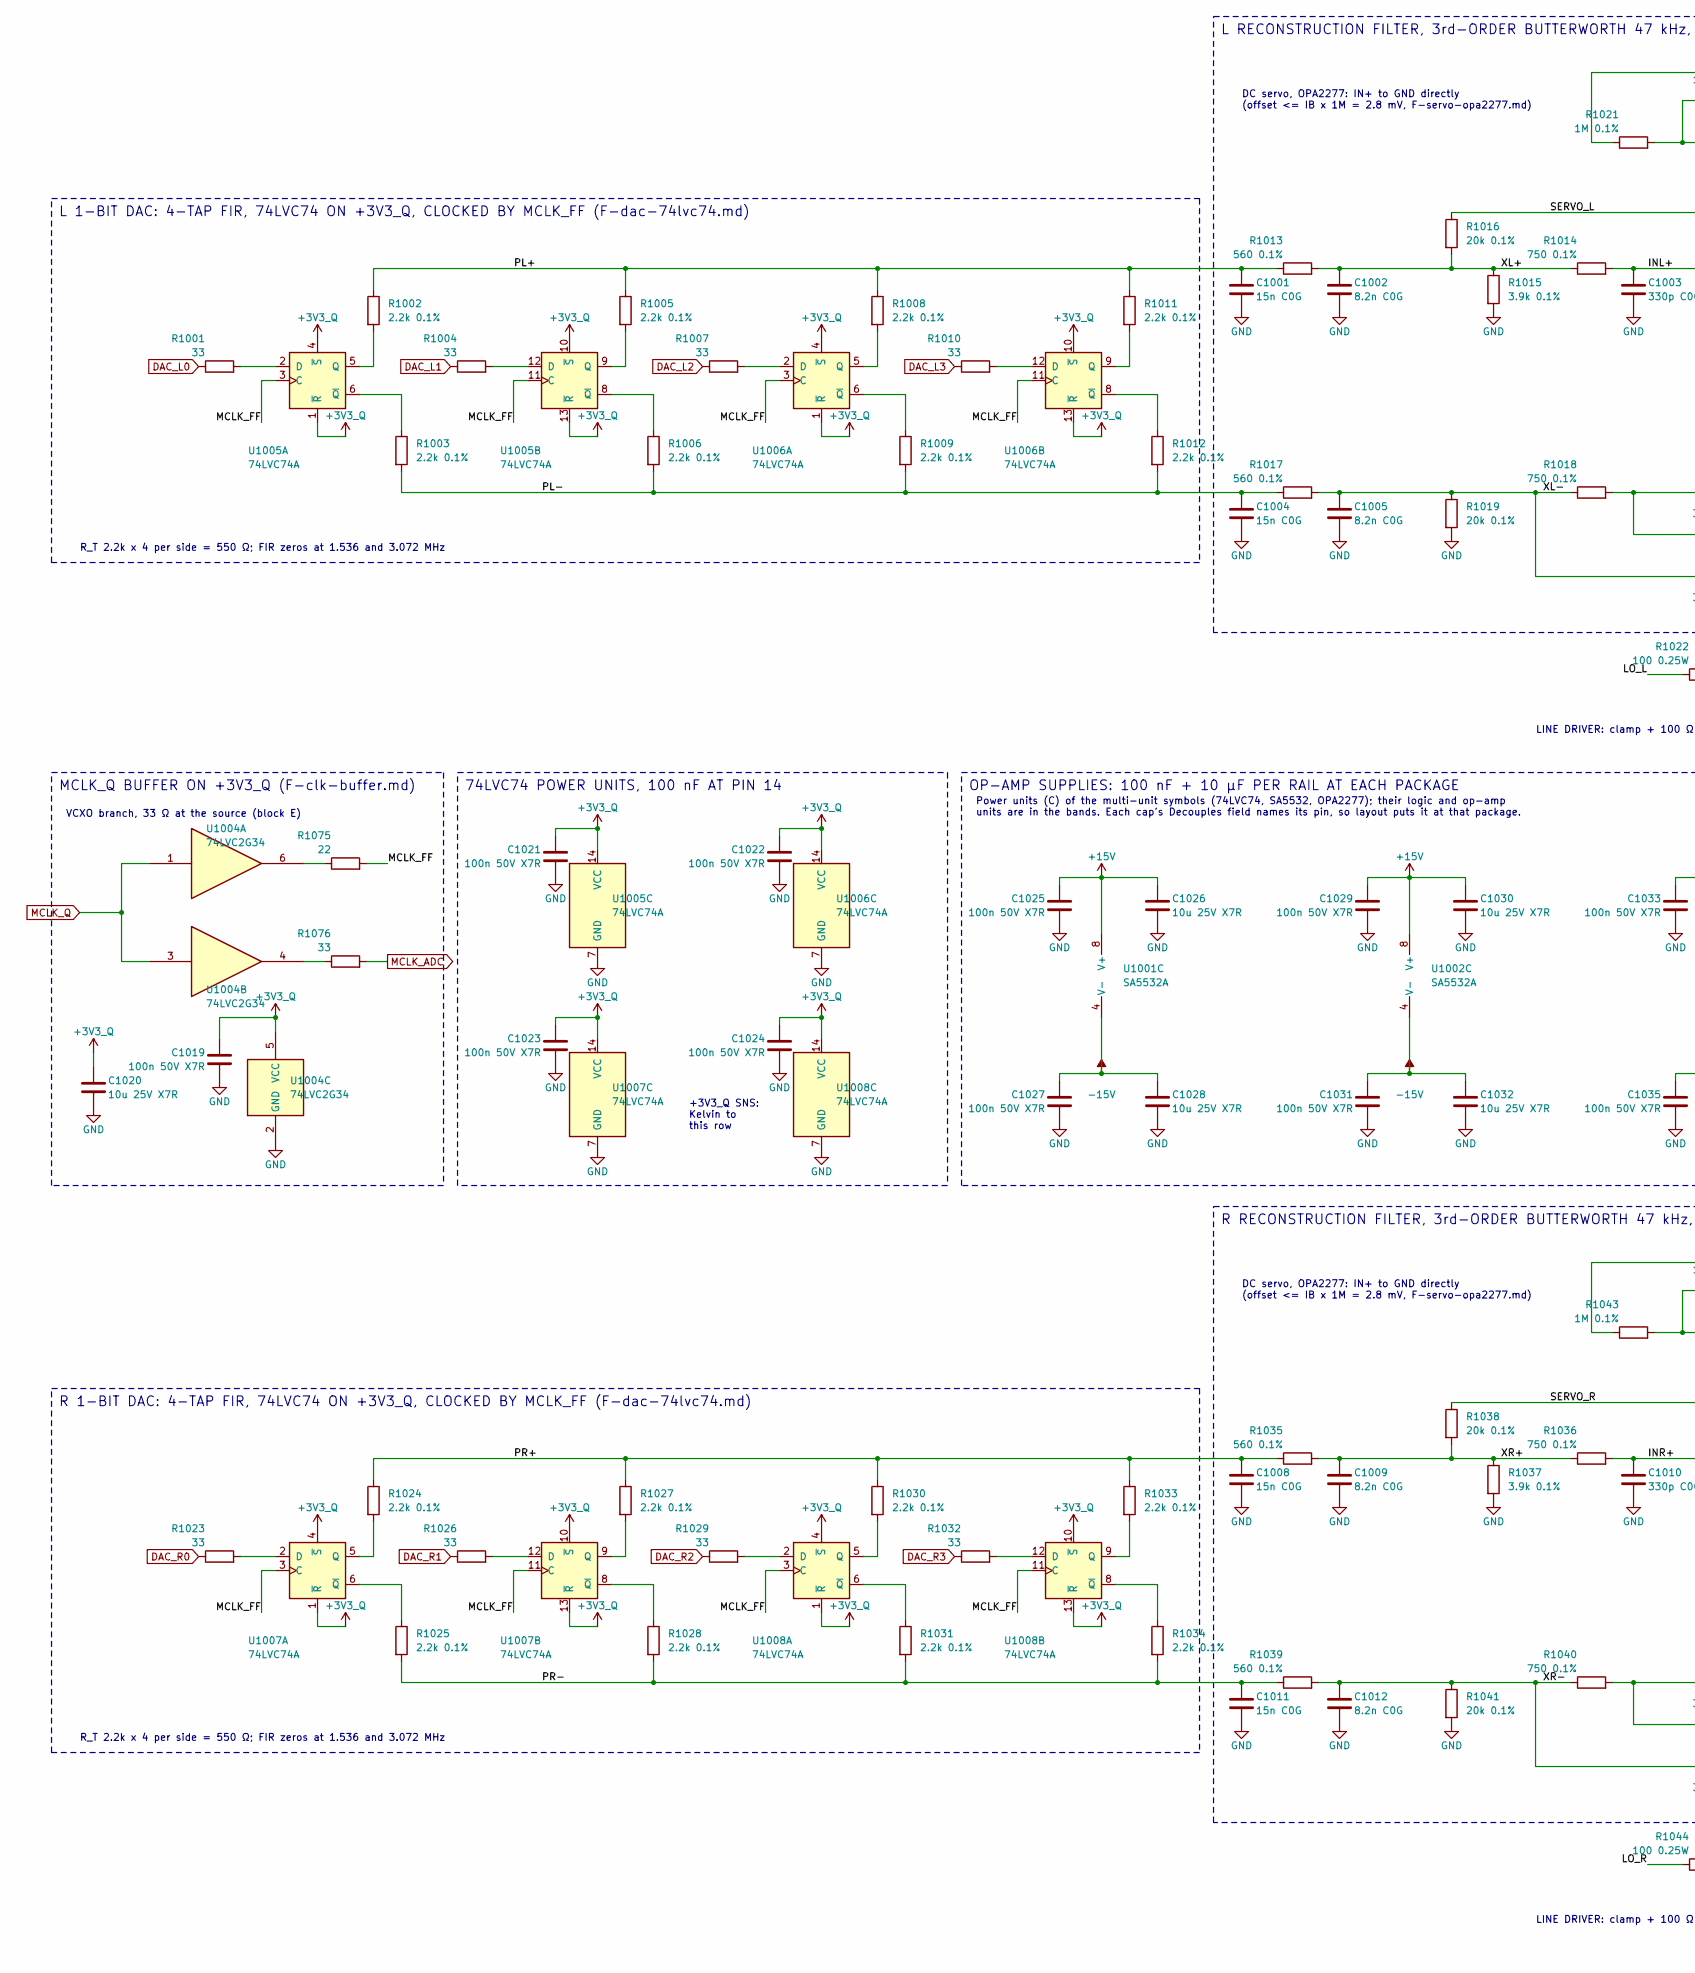
[picture p32: schematic audio_out.kicad_sch, Studio Amp satellite: 1-bit DAC, headphone and line out, part in row 1, column 1]

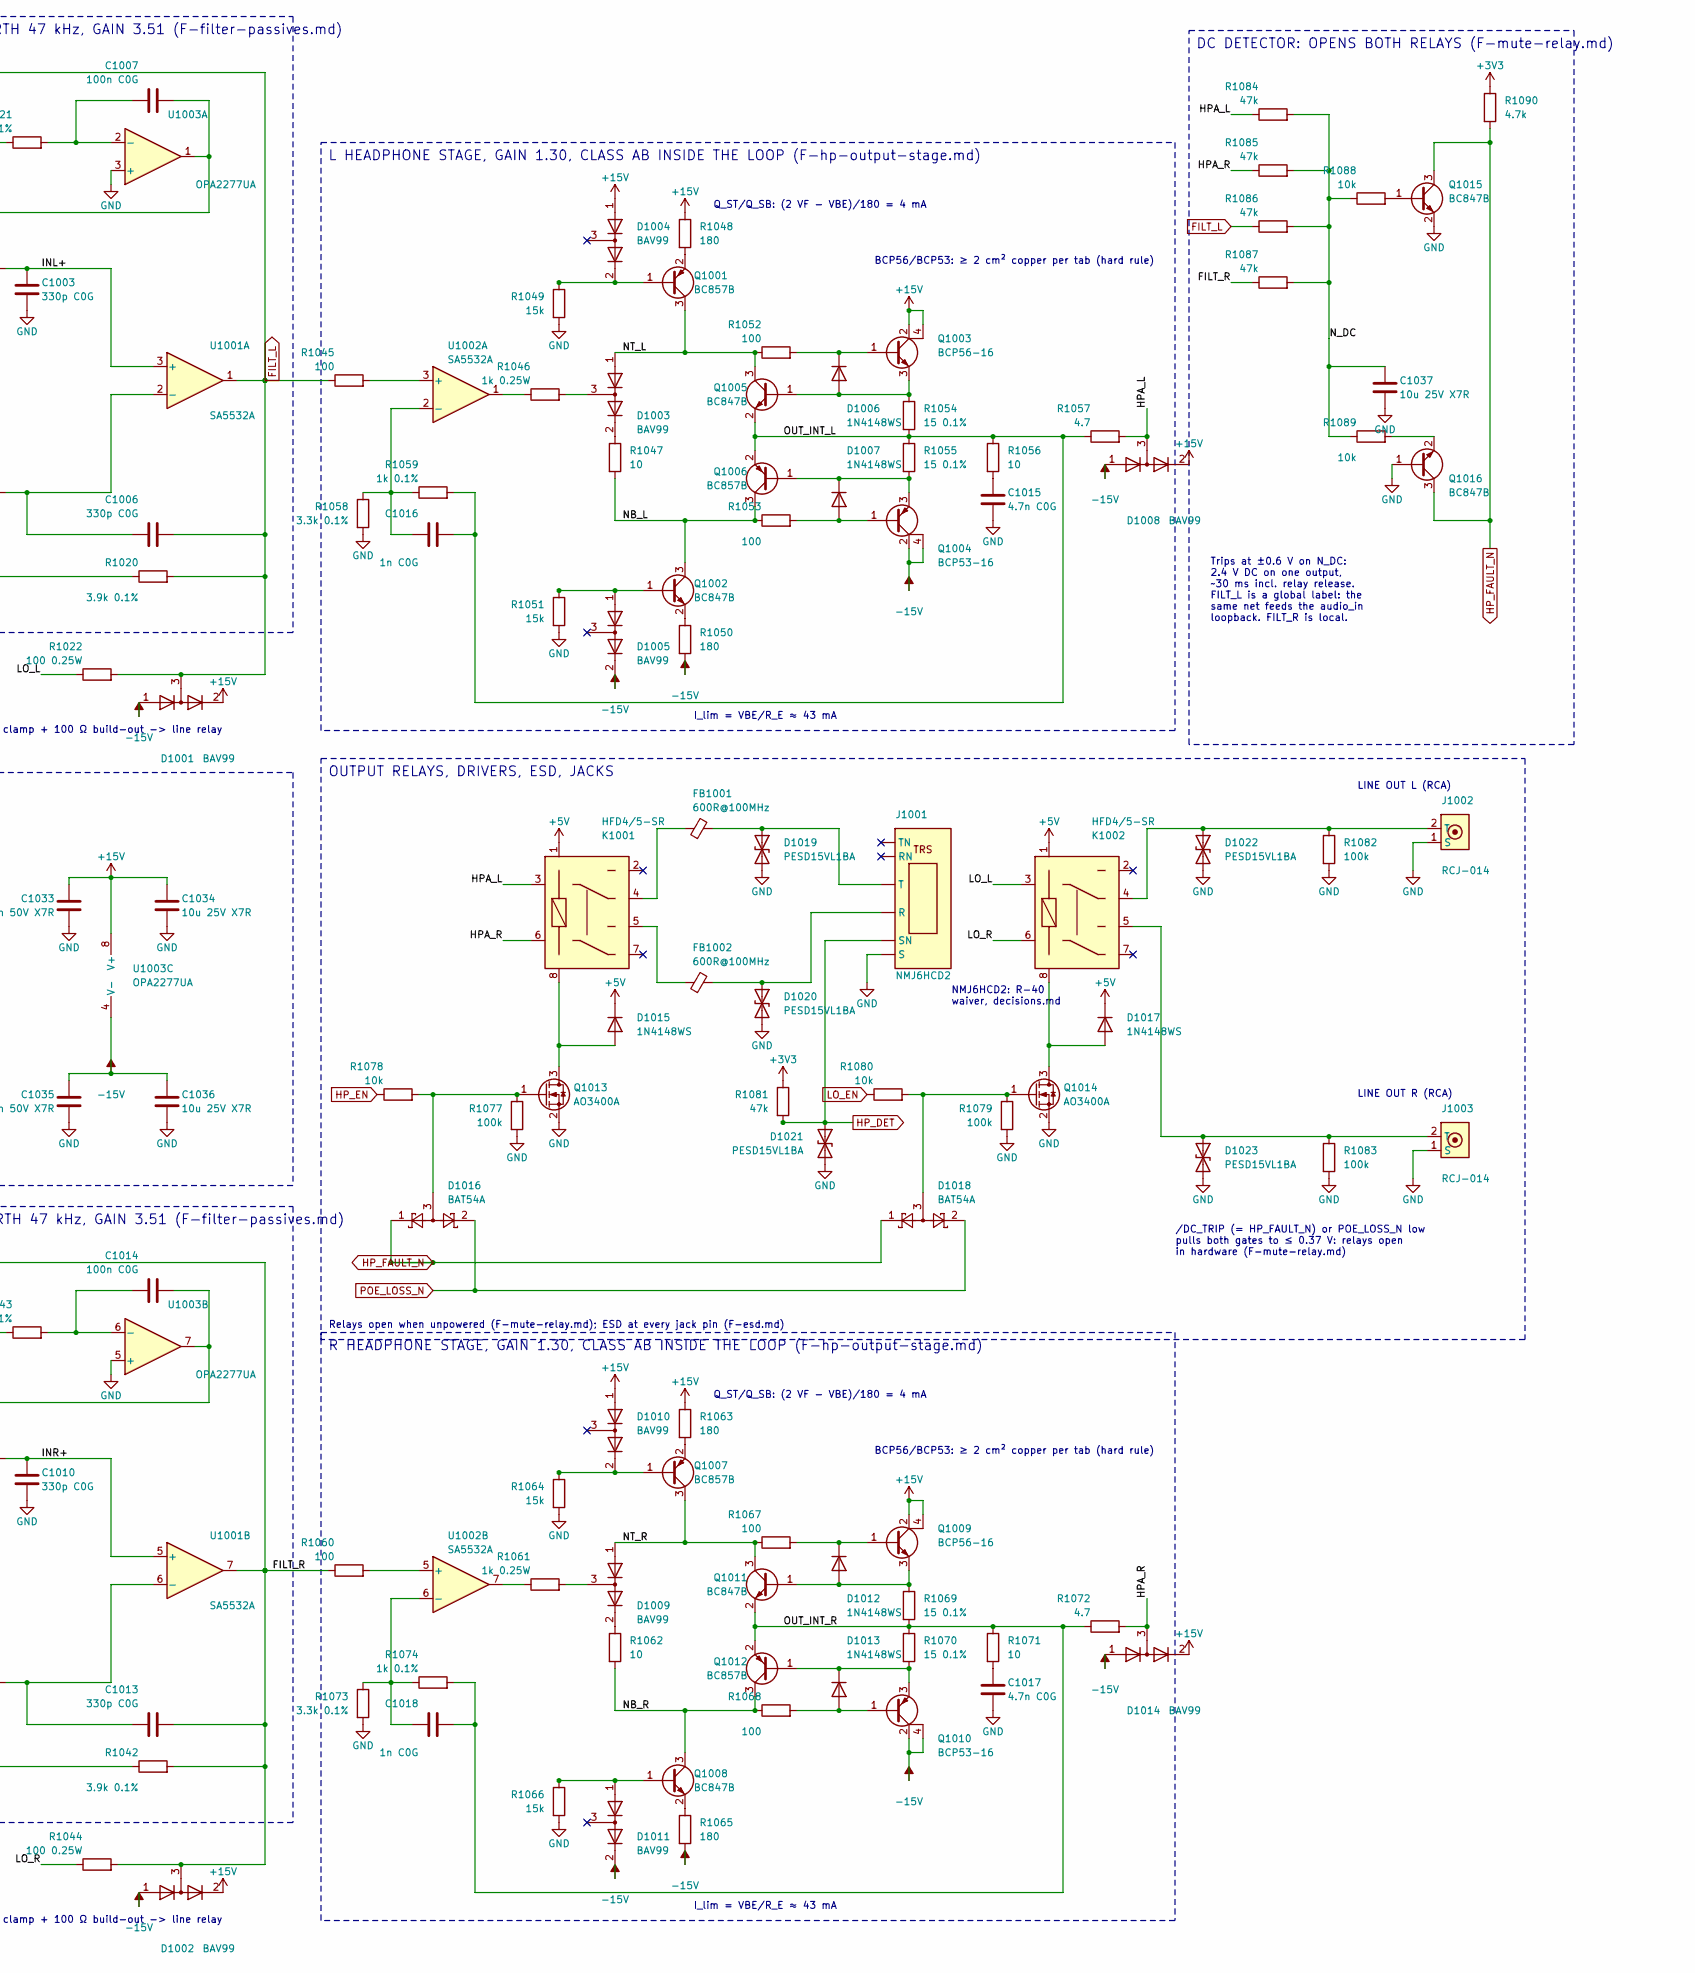
[picture p33: schematic audio_out.kicad_sch, Studio Amp satellite: 1-bit DAC, headphone and line out, part in row 1, column 2]

Parts:
C1001, C1004, C1008, C1011: 15n C0G; C_0805_2012Metric; MPN GRM2195C1H153JA01D; LCSC C97907
C1002, C1005, C1009, C1012: 8.2n C0G; C_0805_2012Metric; MPN GRM2195C1H822JA01D; LCSC C97908
C1003, C1006, C1010, C1013: 330p C0G; C_0603_1608Metric; MPN CC0603JRNPO9BN331; LCSC C62784
C1007, C1014: 100n C0G; C_1206_3216Metric; MPN GRM31C5C1H104JA01L; LCSC C97946
C1015, C1017: 4.7n C0G; C_0603_1608Metric; MPN CC0603JRNPO9BN472; LCSC C576818
C1016, C1018: 1n C0G; C_0603_1608Metric; MPN CC0603JRNPO9BN102; LCSC C106246
C1019, C1021, C1022, C1023, C1024, C1025, C1027, C1029, C1031, C1033, C1035: 100n 50V X7R; C_0603_1608Metric; MPN CC0603KRX7R9BB104; LCSC C14663
C1020, C1026, C1028, C1030, C1032, C1034, C1036, C1037: 10u 25V X7R; C_1206_3216Metric; MPN CC1206KKX7R8BB106; LCSC C70462
D1001, D1002, D1003, D1004, D1005, D1008, D1009, D1010, D1011, D1014: BAV99; SOT-23; MPN BAV99,215; LCSC C2500
D1006, D1007, D1012, D1013, D1015, D1017: 1N4148WS; D_SOD-323; MPN 1N4148WS; LCSC C2128
D1016, D1018: BAT54A; SOT-23; MPN BAT54A,215; LCSC C130910
D1019, D1020, D1021, D1022, D1023: PESD15VL1BA; D_SOD-323; MPN PESD15VL1BA,115; LCSC C85378
FB1001, FB1002: 600R@100MHz; L_0603_1608Metric; MPN BLM18AG601SN1D; LCSC C19330
J1001: NMJ6HCD2; Jack_6.35mm_Neutrik_NMJ6HCD2_Horizontal; MPN NMJ6HCD2; LCSC C368502
J1002, J1003: RCJ-014; RCA_CUI_RCJ-01_Horizontal; MPN RCJ-014; LCSC C4991844
K1001, K1002: HFD4/5-SR; Relay_DPDT_Hongfa_HFD4-S_SMD; MPN HFD4/5-SR; LCSC C64399
Q1001, Q1006, Q1007, Q1012: BC857B; SOT-23; MPN BC857B,215; LCSC C59205
Q1002, Q1005, Q1008, Q1011, Q1015, Q1016: BC847B; SOT-23; MPN BC847B,215; LCSC C57668
Q1003, Q1009: BCP56-16; SOT-223-3_TabPin2; MPN BCP56-16,115; LCSC C92221
Q1004, Q1010: BCP53-16; SOT-223-3_TabPin2; MPN BCP53-16,115; LCSC C85085
Q1013, Q1014: AO3400A; SOT-23; MPN AO3400A; LCSC C20917
R1001, R1004, R1007, R1010, R1023, R1026, R1029, R1032, R1076: 33; R_0603_1608Metric; MPN 0603WAF330JT5E; LCSC C23140
R1002, R1003, R1005, R1006, R1008, R1009, R1011, R1012, R1024, R1025, R1027, R1028, R1030, R1031, R1033, R1034: 2.2k 0.1%; R_0603_1608Metric; MPN RT0603BRD072K2L; LCSC C861295
R1013, R1017, R1035, R1039: 560 0.1%; R_0603_1608Metric; MPN RT0603BRD07560RL; LCSC C861472
R1014, R1018, R1036, R1040: 750 0.1%; R_0603_1608Metric; MPN RT0603BRD07750RL; LCSC C861551
R1015, R1020, R1037, R1042: 3.9k 0.1%; R_0603_1608Metric; MPN RT0603BRD073K9L; LCSC C728592
R1016, R1019, R1038, R1041: 20k 0.1%; R_0603_1608Metric; MPN RT0603BRD0720KL; LCSC C723637
R1021, R1043: 1M 0.1%; R_0603_1608Metric; MPN RT0603BRD071ML; LCSC C326730
R1022, R1044: 100 0.25W; R_1206_3216Metric; MPN 1206W4F1000T5E; LCSC C17901
R1045, R1052, R1053, R1060, R1067, R1068: 100; R_0603_1608Metric; MPN 0603WAF1000T5E; LCSC C22775
R1046, R1061: 1k 0.25W; R_1206_3216Metric; MPN 1206W4F1001T5E; LCSC C4410
R1047, R1056, R1062, R1071: 10; R_0603_1608Metric; MPN 0603WAF100JT5E; LCSC C22859
R1048, R1050, R1063, R1065: 180; R_0603_1608Metric; MPN 0603WAF1800T5E; LCSC C22828
R1049, R1051, R1064, R1066: 15k; R_0603_1608Metric; MPN 0603WAF1502T5E; LCSC C22809
R1054, R1055, R1069, R1070: 15 0.1%; R_0603_1608Metric; MPN RT0603BRD0715RL; LCSC C705727
R1057, R1072: 4.7; R_0805_2012Metric; MPN FRC0805J4R7 TS; LCSC C2907327
R1058, R1073: 3.3k 0.1%; R_0603_1608Metric; MPN RT0603BRD073K3L; LCSC C309653
R1059, R1074: 1k 0.1%; R_0603_1608Metric; MPN RT0603BRD071KL; LCSC C110776
R1075: 22; R_0603_1608Metric; MPN 0603WAF220JT5E; LCSC C23345
R1077, R1079, R1082, R1083: 100k; R_0603_1608Metric; MPN 0603WAF1003T5E; LCSC C25803
R1078, R1080, R1088, R1089: 10k; R_0603_1608Metric; MPN 0603WAF1002T5E; LCSC C25804
R1081, R1084, R1085, R1086, R1087: 47k; R_0603_1608Metric; MPN 0603WAF4702T5E; LCSC C25819
R1090: 4.7k; R_0603_1608Metric; MPN 0603WAF4701T5E; LCSC C23162
U1001, U1002: SA5532A; SOIC-8_3.9x4.9mm_P1.27mm; MPN SA5532ADR; LCSC C83716
U1003: OPA2277UA; SOIC-8_3.9x4.9mm_P1.27mm; MPN OPA2277UA/2K5; LCSC C24460
U1004: 74LVC2G34; SOT-23-6; MPN SN74LVC2G34DBVR; LCSC C347589
U1005, U1006, U1007, U1008: 74LVC74A; TSSOP-14_4.4x5mm_P0.65mm; MPN 74LVC74APW,118; LCSC C6100

Connections:
+3V3_Q: C1019.1, C1020.1, C1021.1, C1022.1, C1023.1, C1024.1, U1004.5 (VCC), U1005.1 (~R), U1005.4 (~S), U1005.10 (~S), U1005.13 (~R), U1005.14 (VCC), U1006.1 (~R), U1006.4 (~S), U1006.10 (~S), U1006.13 (~R), U1006.14 (VCC), U1007.1 (~R), U1007.4 (~S), U1007.10 (~S), U1007.13 (~R), U1007.14 (VCC), U1008.1 (~R), U1008.4 (~S), U1008.10 (~S), U1008.13 (~R), U1008.14 (VCC); also elsewhere on the board
+5V: D1015.1 (K), D1017.1 (K), K1001.1 (+), K1002.1 (+); also elsewhere on the board
+15V: C1025.1, C1026.1, C1029.1, C1030.1, C1033.1, C1034.1, D1001.2 (K2), D1002.2 (K2), D1004.1 (A1), D1008.2 (K2), D1010.1 (A1), D1014.2 (K2), Q1003.2 (C), Q1003.4 (C), Q1009.2 (C), Q1009.4 (C), R1048.1, R1063.1, U1001.8 (V+), U1002.8 (V+), U1003.8 (V+); also elsewhere on the board
-15V: C1027.1, C1028.1, C1031.1, C1032.1, C1035.1, C1036.1, D1001.1 (A1), D1002.1 (A1), D1005.2 (K2), D1008.1 (A1), D1011.2 (K2), D1014.1 (A1), Q1004.2 (C), Q1004.4 (C), Q1010.2 (C), Q1010.4 (C), R1050.2, R1065.2, U1001.4 (V-), U1002.4 (V-), U1003.4 (V-); also elsewhere on the board
/audio_out/FILT_R: C1013.2, D1002.3 (K1A2), R1042.2, R1043.1, R1044.2, R1060.1, R1087.1, U1001.7
/audio_out/HPA_L: D1008.3 (K1A2), K1001.3 (COM1), R1057.2, R1084.1
/audio_out/HPA_R: D1014.3 (K1A2), K1001.6 (COM2), R1072.2, R1085.1
/audio_out/INL+: C1003.1, R1014.2, U1001.3 (+)
/audio_out/INR+: C1010.1, R1036.2, U1001.5 (+)
/audio_out/LO_L: K1002.3 (COM1), R1022.1
/audio_out/LO_R: K1002.6 (COM2), R1044.1
/audio_out/MCLK_FF: R1075.2, U1005.3 (C), U1005.11 (C), U1006.3 (C), U1006.11 (C), U1007.3 (C), U1007.11 (C), U1008.3 (C), U1008.11 (C)
/audio_out/NB_L: Q1002.3 (C), Q1006.3 (C), R1047.2, R1053.1
/audio_out/NB_R: Q1008.3 (C), Q1012.3 (C), R1062.2, R1068.1
/audio_out/NT_L: D1003.1 (A1), Q1001.3 (C), Q1005.3 (C), R1052.1
/audio_out/NT_R: D1009.1 (A1), Q1007.3 (C), Q1011.3 (C), R1067.1
/audio_out/N_DC: C1037.1, R1084.2, R1085.2, R1086.2, R1087.2, R1088.1, R1089.1
/audio_out/OUT_INT_L: C1016.2, Q1005.2 (E), Q1006.2 (E), R1054.2, R1055.1, R1056.1, R1057.1, R1059.2
/audio_out/OUT_INT_R: C1018.2, Q1011.2 (E), Q1012.2 (E), R1069.2, R1070.1, R1071.1, R1072.1, R1074.2
/audio_out/PL+: C1001.1, R1002.1, R1005.1, R1008.1, R1011.1, R1013.1
/audio_out/PL-: C1004.1, R1003.2, R1006.2, R1009.2, R1012.2, R1017.1
/audio_out/PR+: C1008.1, R1024.1, R1027.1, R1030.1, R1033.1, R1035.1
/audio_out/PR-: C1011.1, R1025.2, R1028.2, R1031.2, R1034.2, R1039.1
/audio_out/SERVO_L: C1007.2, R1016.1, U1003.1
/audio_out/SERVO_R: C1014.2, R1038.1, U1003.7
/audio_out/XL+: C1002.1, R1013.2, R1014.1, R1015.1, R1016.2
/audio_out/XL-: C1005.1, R1017.2, R1018.1, R1019.1, R1020.1
/audio_out/XR+: C1009.1, R1035.2, R1036.1, R1037.1, R1038.2
/audio_out/XR-: C1012.1, R1039.2, R1040.1, R1041.1, R1042.1
DAC_L0: R1001.1; also elsewhere on the board
DAC_L1: R1004.1; also elsewhere on the board
DAC_L2: R1007.1; also elsewhere on the board
DAC_L3: R1010.1; also elsewhere on the board
DAC_R0: R1023.1; also elsewhere on the board
DAC_R1: R1026.1; also elsewhere on the board
DAC_R2: R1029.1; also elsewhere on the board
DAC_R3: R1032.1; also elsewhere on the board
FILT_L: C1006.2, D1001.3 (K1A2), R1020.2, R1021.1, R1022.2, R1045.1, R1086.1, U1001.1; also elsewhere on the board
HP_DET: D1021.1 (A1), J1001.SN, R1081.2; also elsewhere on the board
HP_EN: R1078.1; also elsewhere on the board
HP_FAULT_N: D1016.1, D1018.1, Q1015.3 (C), Q1016.3 (C), R1090.2; also elsewhere on the board
LO_EN: R1080.1; also elsewhere on the board
MCLK_ADC: R1076.2; also elsewhere on the board
MCLK_Q: U1004.1, U1004.3; also elsewhere on the board
unnamed: C1015.1, R1056.2
unnamed: C1017.1, R1071.2
unnamed: D1003.3 (K1A2), R1046.2
unnamed: D1003.2 (K2), R1047.1
unnamed: D1004.2 (K2), Q1001.1 (B), R1049.1
unnamed: D1005.1 (A1), Q1002.1 (B), R1051.1
unnamed: D1006.2 (A), Q1003.3 (E), Q1005.1 (B), R1054.1
unnamed: D1006.1 (K), Q1003.1 (B), R1052.2
unnamed: D1007.2 (A), Q1004.1 (B), R1053.2
unnamed: D1007.1 (K), Q1004.3 (E), Q1006.1 (B), R1055.2
unnamed: D1009.3 (K1A2), R1061.2
unnamed: D1009.2 (K2), R1062.1
unnamed: D1010.2 (K2), Q1007.1 (B), R1064.1
unnamed: D1011.1 (A1), Q1008.1 (B), R1066.1
unnamed: D1012.2 (A), Q1009.3 (E), Q1011.1 (B), R1069.1
unnamed: D1012.1 (K), Q1009.1 (B), R1067.2
unnamed: D1013.2 (A), Q1010.1 (B), R1068.2
unnamed: D1013.1 (K), Q1010.3 (E), Q1012.1 (B), R1070.2
unnamed: D1015.2 (A), K1001.8 (-), Q1013.3 (D)
unnamed: D1017.2 (A), K1002.8 (-), Q1014.3 (D)
unnamed: D1019.1 (A1), FB1001.2, J1001.T
unnamed: D1020.1 (A1), FB1002.2, J1001.R
unnamed: D1022.1 (A1), J1002.2 (T), K1002.4 (NO1), R1082.1
unnamed: D1023.1 (A1), J1003.2 (T), K1002.5 (NO2), R1083.1
unnamed: FB1001.1, K1001.4 (NO1)
unnamed: FB1002.1, K1001.5 (NO2)
unnamed: Q1001.2 (E), R1048.2
unnamed: Q1002.2 (E), R1050.1
unnamed: Q1007.2 (E), R1063.2
unnamed: Q1008.2 (E), R1065.1
unnamed: D1016.3, Q1013.1 (G), R1077.1, R1078.2
unnamed: D1018.3, Q1014.1 (G), R1079.1, R1080.2
unnamed: Q1015.1 (B), R1088.2
unnamed: Q1016.2 (E), R1089.2
unnamed: R1046.1, U1002.1
unnamed: R1061.1, U1002.7
unnamed: R1075.1, U1004.6
unnamed: R1076.1, U1004.4
unnamed: C1006.1, R1018.2, U1001.2 (-)
unnamed: C1013.1, R1040.2, U1001.6 (-)
unnamed: R1045.2, U1002.3 (+)
unnamed: C1016.1, R1058.1, R1059.1, U1002.2 (-)
unnamed: R1060.2, U1002.5 (+)
unnamed: C1018.1, R1073.1, R1074.1, U1002.6 (-)
unnamed: C1007.1, R1021.2, U1003.2 (-)
unnamed: C1014.1, R1043.2, U1003.6 (-)
unnamed: R1001.2, U1005.2 (D)
unnamed: R1002.2, U1005.5 (Q)
unnamed: R1003.1, U1005.6 (~Q)
unnamed: R1004.2, U1005.12 (D)
unnamed: R1005.2, U1005.9 (Q)
unnamed: R1006.1, U1005.8 (~Q)
unnamed: R1007.2, U1006.2 (D)
unnamed: R1008.2, U1006.5 (Q)
unnamed: R1009.1, U1006.6 (~Q)
unnamed: R1010.2, U1006.12 (D)
unnamed: R1011.2, U1006.9 (Q)
unnamed: R1012.1, U1006.8 (~Q)
unnamed: R1023.2, U1007.2 (D)
unnamed: R1024.2, U1007.5 (Q)
unnamed: R1025.1, U1007.6 (~Q)
unnamed: R1026.2, U1007.12 (D)
unnamed: R1027.2, U1007.9 (Q)
unnamed: R1028.1, U1007.8 (~Q)
unnamed: R1029.2, U1008.2 (D)
unnamed: R1030.2, U1008.5 (Q)
unnamed: R1031.1, U1008.6 (~Q)
unnamed: R1032.2, U1008.12 (D)
unnamed: R1033.2, U1008.9 (Q)
unnamed: R1034.1, U1008.8 (~Q)
POE_LOSS_N: D1016.2, D1018.2; also elsewhere on the board

Notes on the sheet:
L 1-BIT DAC: 4-TAP FIR, 74LVC74 ON +3V3_Q, CLOCKED BY MCLK_FF (F-dac-74lvc74.md)
R_T 2.2k x 4 per side = 550 Ω; FIR zeros at 1.536 and 3.072 MHz
L RECONSTRUCTION FILTER, 3rd-ORDER BUTTERWORTH 47 kHz, GAIN 3.51 (F-filter-passives.md)
DC servo, OPA2277: IN+ to GND directly (offset <= IB x 1M = 2.8 mV, F-servo-opa2277.md)
LINE DRIVER: clamp + 100 Ω build-out -> line relay
R 1-BIT DAC: 4-TAP FIR, 74LVC74 ON +3V3_Q, CLOCKED BY MCLK_FF (F-dac-74lvc74.md)
R RECONSTRUCTION FILTER, 3rd-ORDER BUTTERWORTH 47 kHz, GAIN 3.51 (F-filter-passives.md)
L HEADPHONE STAGE, GAIN 1.30, CLASS AB INSIDE THE LOOP (F-hp-output-stage.md)
Q_ST/Q_SB: (2 VF - VBE)/180 = 4 mA
BCP56/BCP53: ≥ 2 cm² copper per tab (hard rule)
I_lim = VBE/R_E ≈ 43 mA
R HEADPHONE STAGE, GAIN 1.30, CLASS AB INSIDE THE LOOP (F-hp-output-stage.md)
MCLK_Q BUFFER ON +3V3_Q (F-clk-buffer.md)
VCXO branch, 33 Ω at the source (block E)
74LVC74 POWER UNITS, 100 nF AT PIN 14
+3V3_Q SNS: Kelvin to this row
OP-AMP SUPPLIES: 100 nF + 10 µF PER RAIL AT EACH PACKAGE
Power units (C) of the multi-unit symbols (74LVC74, SA5532, OPA2277); their logic and op-amp units are in the bands. Each cap's Decouples field names its pin, so layout puts it at that package.
OUTPUT RELAYS, DRIVERS, ESD, JACKS
NMJ6HCD2: R-40 waiver, decisions.md
Relays open when unpowered (F-mute-relay.md); ESD at every jack pin (F-esd.md)
/DC_TRIP (= HP_FAULT_N) or POE_LOSS_N low pulls both gates to ≤ 0.37 V: relays open in hardware (F-mute-relay.md)
LINE OUT L (RCA)
LINE OUT R (RCA)
DC DETECTOR: OPENS BOTH RELAYS (F-mute-relay.md)
Trips at ±0.6 V on N_DC: 2.4 V DC on one output, ~30 ms incl. relay release. FILT_L is a global label: the same net feeds the audio_in loopback. FILT_R is local.

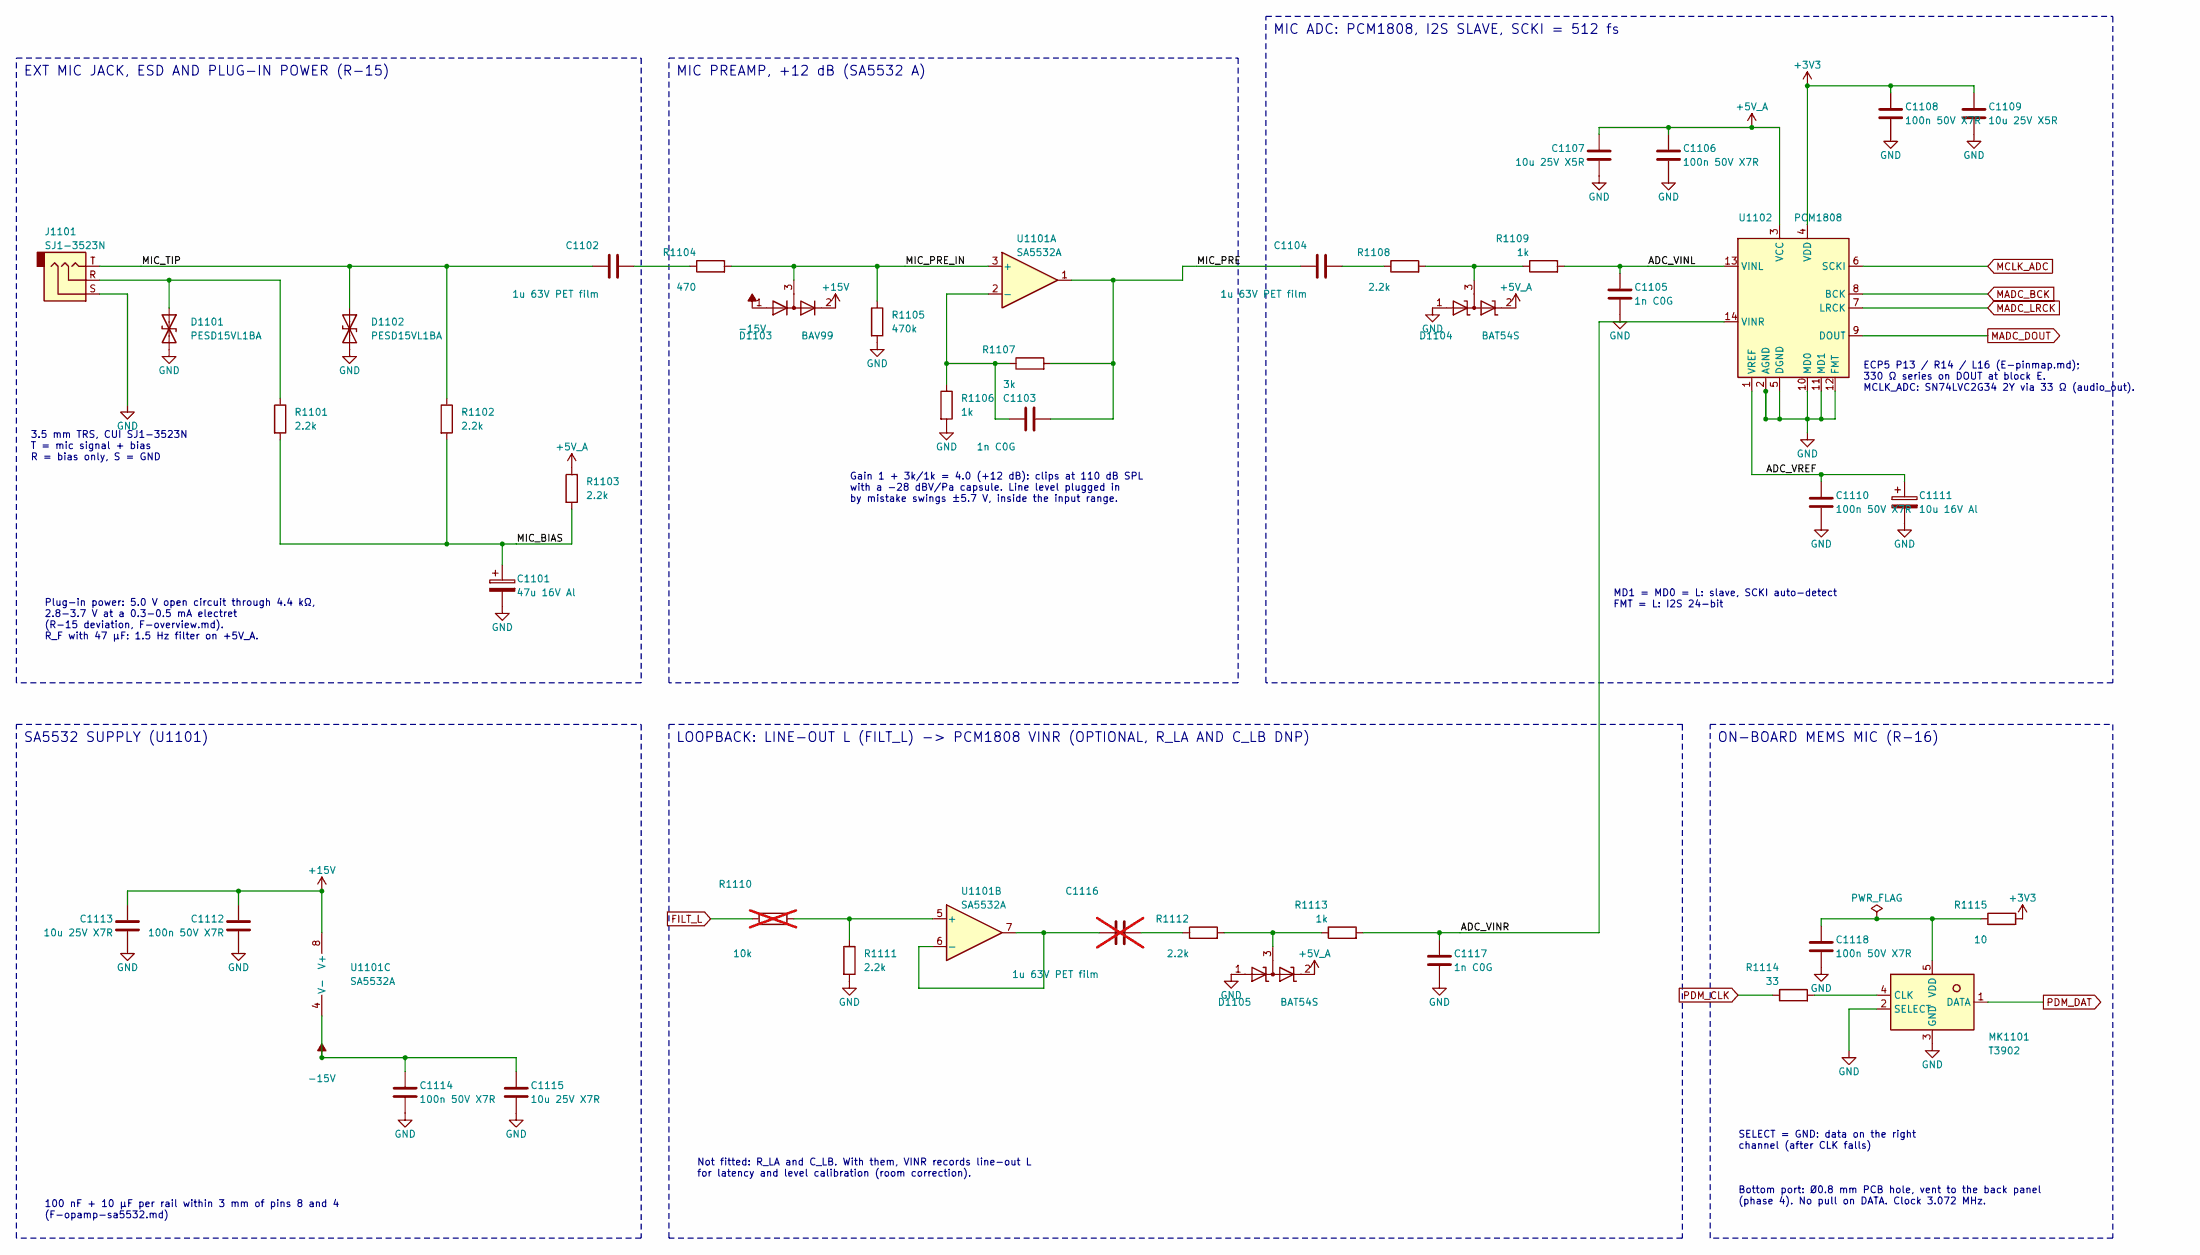
[picture p34: schematic audio_in.kicad_sch, Studio Amp satellite: Measurement mic and MEMS mic]

Parts:
C1101: 47u 16V Al; CP_Elec_5x5.4; MPN RST47UF16V034; LCSC C4747957
C1102, C1104: 1u 63V PET film; C_Rect_L7.2mm_W5.0mm_P5.00mm; MPN MKS2C041001F00JSSD; LCSC C92673
C1103, C1105, C1117: 1n C0G; C_0603_1608Metric; MPN CC0603JRNPO9BN102; LCSC C106246
C1106, C1108, C1110, C1112, C1114, C1118: 100n 50V X7R; C_0603_1608Metric; MPN CC0603KRX7R9BB104; LCSC C14663
C1107, C1109: 10u 25V X5R; C_0805_2012Metric; MPN CL21A106KAYNNNE; LCSC C15850
C1111: 10u 16V Al; CP_Elec_4x5.4; MPN RST10UF16V013; LCSC C4747968
C1113, C1115: 10u 25V X7R; C_1206_3216Metric; MPN CC1206KKX7R8BB106; LCSC C70462
C1116: 1u 63V PET film; C_Rect_L7.2mm_W5.0mm_P5.00mm; MPN MKS2C041001F00JSSD; LCSC C92673; not fitted
D1101, D1102: PESD15VL1BA; D_SOD-323; MPN PESD15VL1BA,115; LCSC C85378
D1103: BAV99; SOT-23; MPN BAV99,215; LCSC C2500
D1104, D1105: BAT54S; SOT-23; MPN BAT54S,215; LCSC C47546
J1101: SJ1-3523N; Jack_3.5mm_CUI_SJ1-3523N_Horizontal; MPN SJ1-3523N; LCSC C20182914
MK1101: T3902; TDK_T3902_LGA-5_3.5x2.65mm; MPN MMICT390200012; LCSC C3171752
R1101, R1102, R1103, R1108, R1111, R1112: 2.2k; R_0603_1608Metric; MPN 0603WAF2201T5E; LCSC C4190
R1104: 470; R_0603_1608Metric; MPN 0603WAF4700T5E; LCSC C23179
R1105: 470k; R_0603_1608Metric; MPN 0603WAF4703T5E; LCSC C23178
R1106, R1109, R1113: 1k; R_0603_1608Metric; MPN 0603WAF1001T5E; LCSC C21190
R1107: 3k; R_0603_1608Metric; MPN 0603WAF3001T5E; LCSC C4211
R1110: 10k; R_0603_1608Metric; MPN 0603WAF1002T5E; LCSC C25804; not fitted
R1114: 33; R_0603_1608Metric; MPN 0603WAF330JT5E; LCSC C23140
R1115: 10; R_0603_1608Metric; MPN 0603WAF100JT5E; LCSC C22859
U1101: SA5532A; SOIC-8_3.9x4.9mm_P1.27mm; MPN SA5532ADR; LCSC C83716
U1102: PCM1808; TSSOP-14_4.4x5mm_P0.65mm; MPN PCM1808PWR; LCSC C55513

Connections:
+5V_A: C1106.1, C1107.1, D1104.2 (K2), D1105.2 (K2), R1103.1, U1102.3 (VCC); also elsewhere on the board
+15V: C1112.1, C1113.1, D1103.2 (K2), U1101.8 (V+); also elsewhere on the board
-15V: C1114.1, C1115.1, D1103.1 (A1), U1101.4 (V-); also elsewhere on the board
/audio_in/ADC_VINL: C1105.1, R1109.2, U1102.13 (VINL)
/audio_in/ADC_VINR: C1117.1, R1113.2, U1102.14 (VINR)
/audio_in/ADC_VREF: C1110.1, C1111.1, U1102.1 (VREF)
/audio_in/MIC_BIAS: C1101.1, R1101.2, R1102.2, R1103.2
/audio_in/MIC_PRE: C1103.2, C1104.1, R1107.2, U1101.1
/audio_in/MIC_PRE_IN: D1103.3 (K1A2), R1104.2, R1105.1, U1101.3 (+)
/audio_in/MIC_TIP: C1102.1, D1102.1 (A1), J1101.T, R1102.1
FILT_L: R1110.1; also elsewhere on the board
MADC_BCK: U1102.8 (BCK); also elsewhere on the board
MADC_DOUT: U1102.9 (DOUT); also elsewhere on the board
MADC_LRCK: U1102.7 (LRCK); also elsewhere on the board
MCLK_ADC: U1102.6 (SCKI); also elsewhere on the board
unnamed: C1102.2, R1104.1
unnamed: C1104.2, R1108.1
unnamed: C1116.2, R1112.1
unnamed: D1101.1 (A1), J1101.R, R1101.1
unnamed: D1104.3 (K1A2), R1108.2, R1109.1
unnamed: D1105.3 (K1A2), R1112.2, R1113.1
unnamed: MK1101.4 (CLK), R1114.2
unnamed: C1118.1, MK1101.5 (VDD), R1115.1
unnamed: C1103.1, R1106.1, R1107.1, U1101.2 (-)
unnamed: R1110.2, R1111.1, U1101.5 (+)
unnamed: C1116.1, U1101.6 (-), U1101.7
PDM_CLK: R1114.1; also elsewhere on the board
PDM_DAT: MK1101.1 (DATA); also elsewhere on the board

Notes on the sheet:
EXT MIC JACK, ESD AND PLUG-IN POWER (R-15)
3.5 mm TRS, CUI SJ1-3523N T = mic signal + bias R = bias only, S = GND
Plug-in power: 5.0 V open circuit through 4.4 kΩ, 2.8-3.7 V at a 0.3-0.5 mA electret (R-15 deviation, F-overview.md). R_F with 47 µF: 1.5 Hz filter on +5V_A.
MIC PREAMP, +12 dB (SA5532 A)
Gain 1 + 3k/1k = 4.0 (+12 dB): clips at 110 dB SPL with a -28 dBV/Pa capsule. Line level plugged in by mistake swings ±5.7 V, inside the input range.
MIC ADC: PCM1808, I2S SLAVE, SCKI = 512 fs
MD1 = MD0 = L: slave, SCKI auto-detect FMT = L: I2S 24-bit
ECP5 P13 / R14 / L16 (E-pinmap.md); 330 Ω series on DOUT at block E. MCLK_ADC: SN74LVC2G34 2Y via 33 Ω (audio_out).
SA5532 SUPPLY (U1101)
100 nF + 10 µF per rail within 3 mm of pins 8 and 4 (F-opamp-sa5532.md)
LOOPBACK: LINE-OUT L (FILT_L) -> PCM1808 VINR (OPTIONAL, R_LA AND C_LB DNP)
Not fitted: R_LA and C_LB. With them, VINR records line-out L for latency and level calibration (room correction).
ON-BOARD MEMS MIC (R-16)
SELECT = GND: data on the right channel (after CLK falls)
Bottom port: Ø0.8 mm PCB hole, vent to the back panel (phase 4). No pull on DATA. Clock 3.072 MHz.
