sequoia-hope/studio-amp/hw/satellite/a/satellite.kicad_pcb

## KiCad design hw/satellite/a/satellite.kicad_pcb (continued)

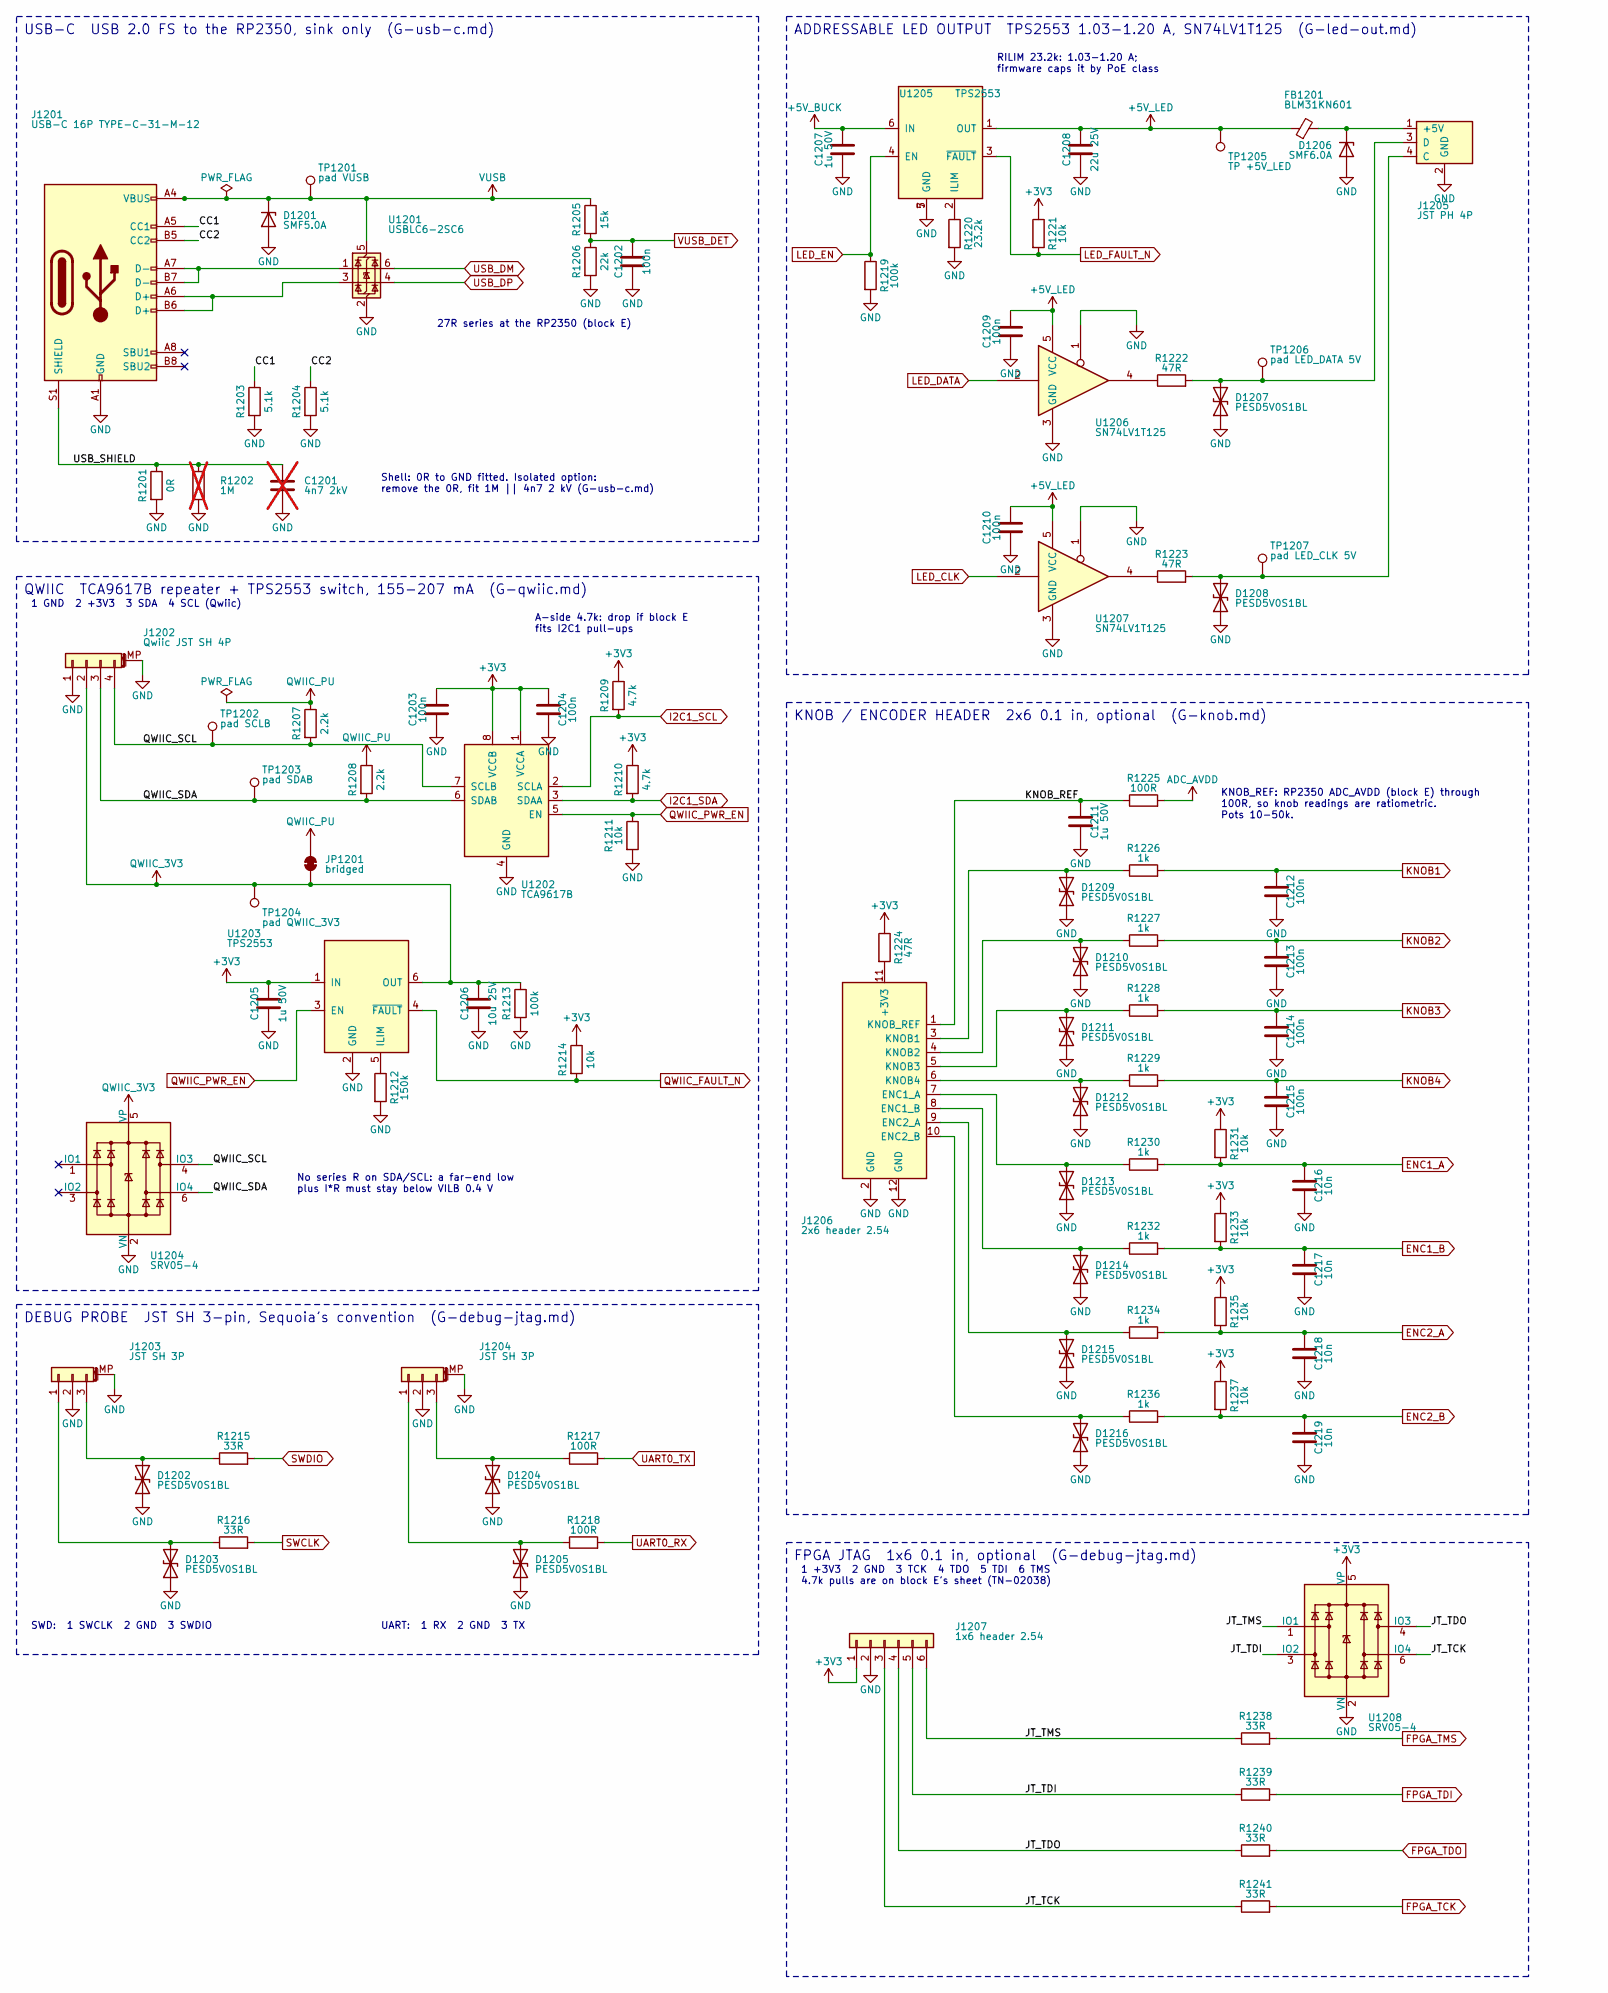
[picture p35: schematic io.kicad_sch, Studio Amp satellite: User I/O, debug and test points, part in row 1, column 1]

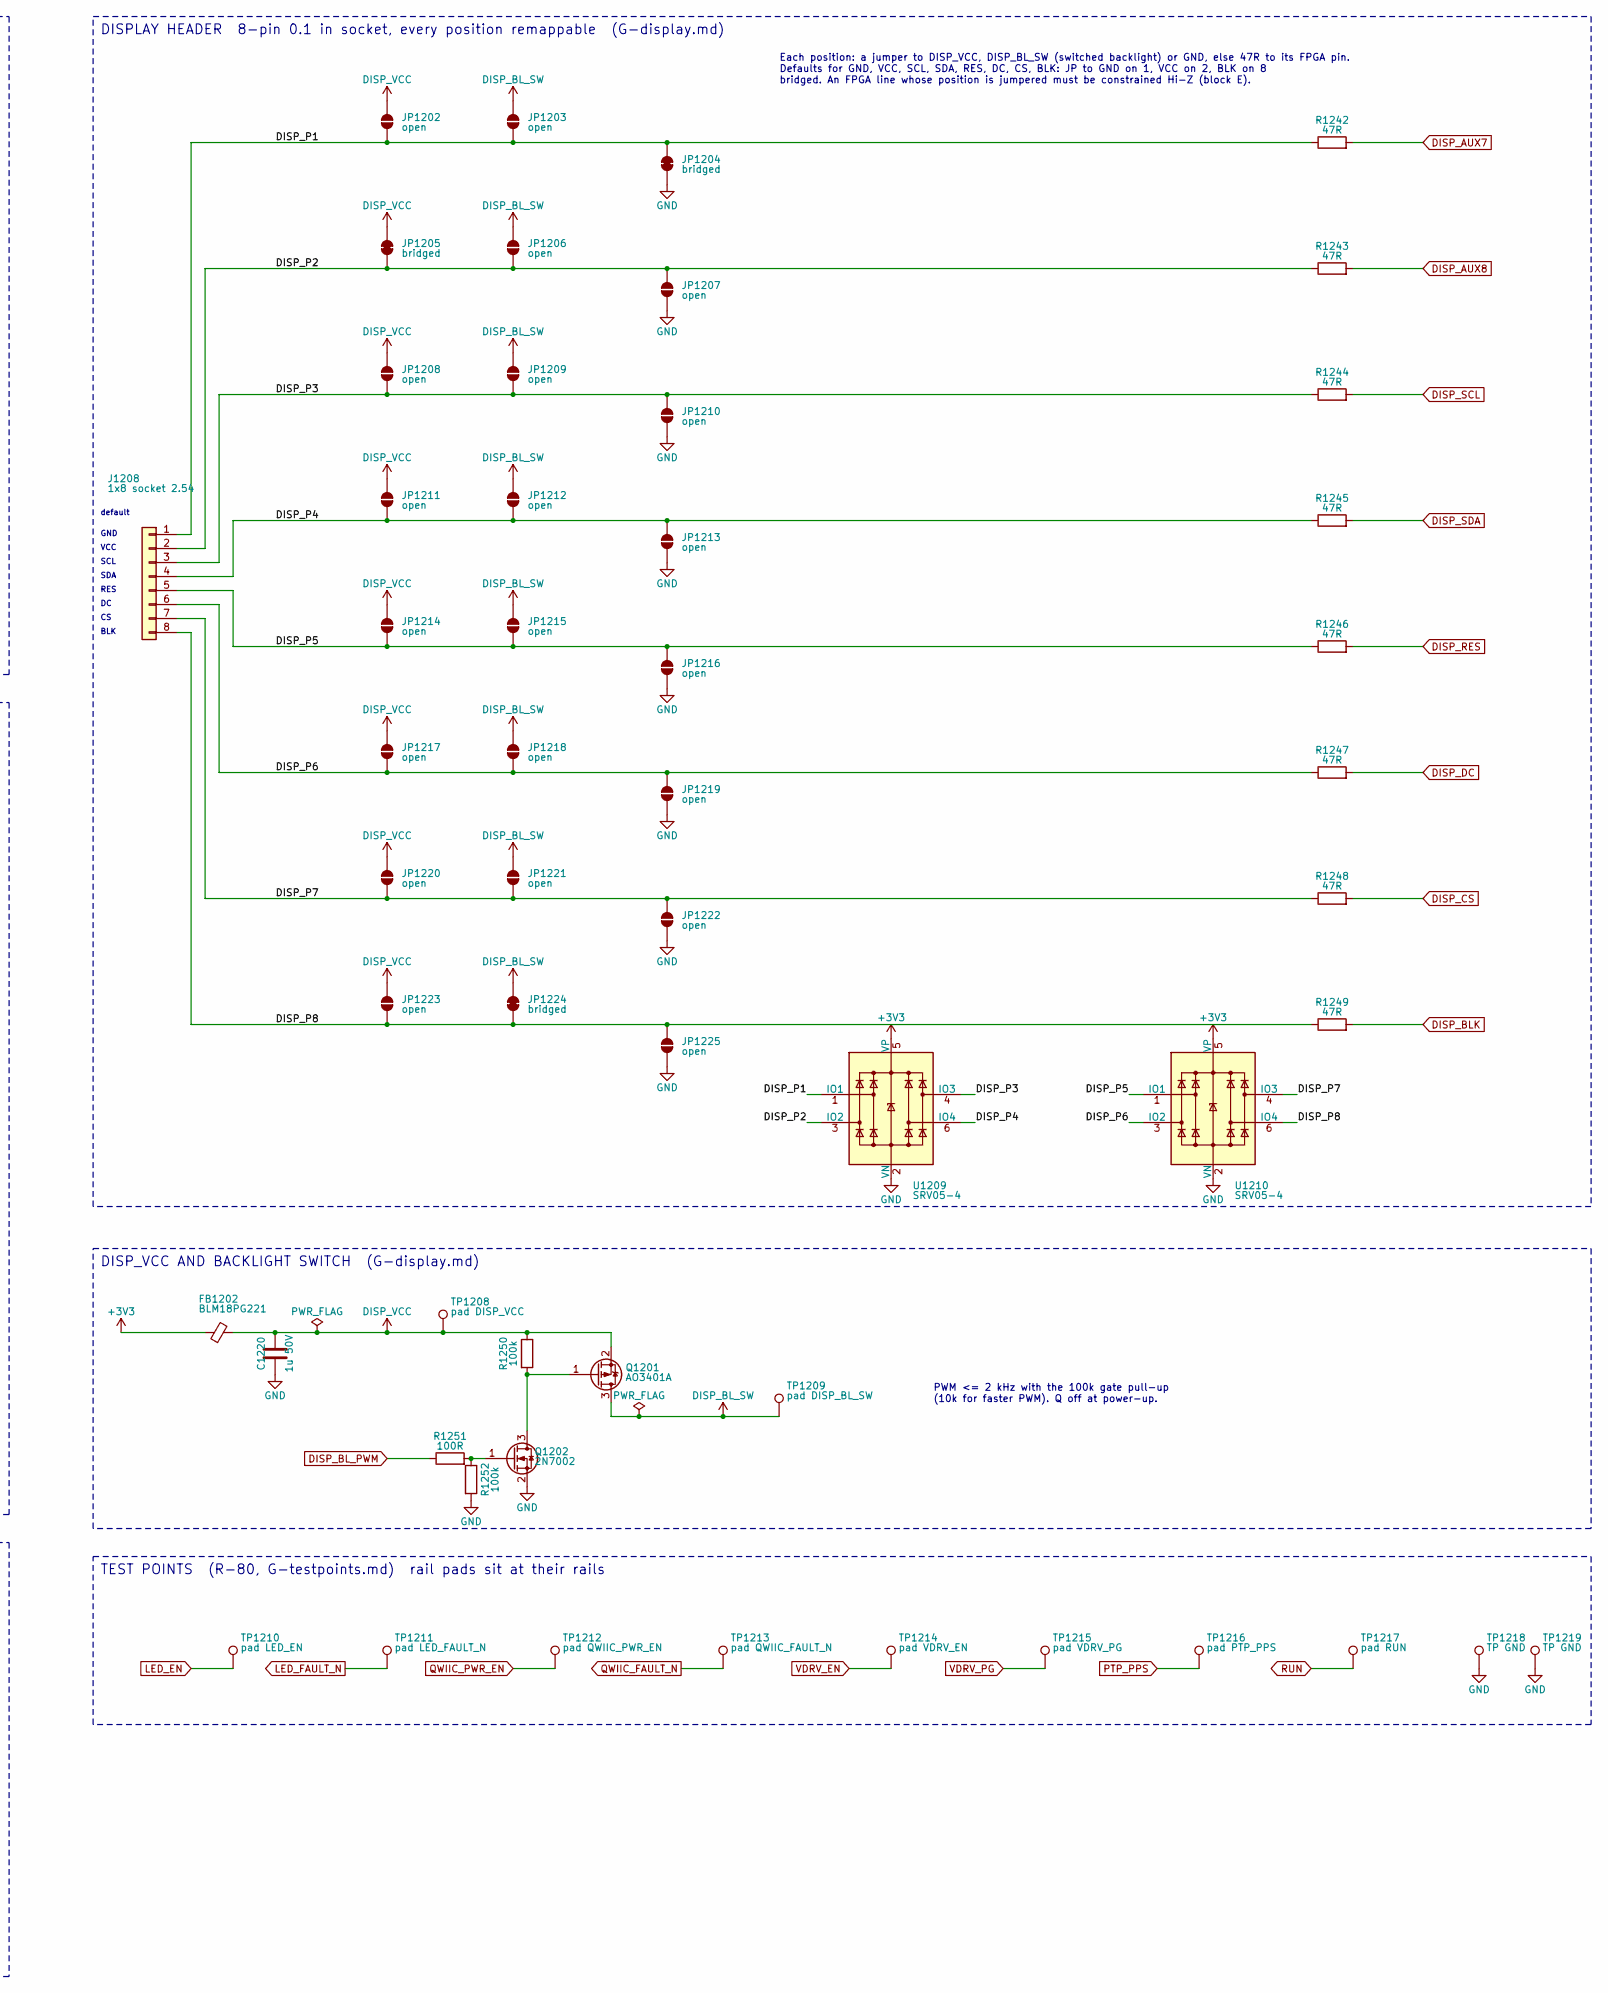
[picture p36: schematic io.kicad_sch, Studio Amp satellite: User I/O, debug and test points, part in row 1, column 2]

Parts:
C1201: 4n7 2kV; C_1206_3216Metric; MPN 1206B472K202NT; LCSC C41017; not fitted
C1202, C1203, C1204, C1209, C1210, C1212, C1213, C1214, C1215: 100n; C_0603_1608Metric; MPN CC0603KRX7R9BB104; LCSC C14663
C1205, C1207, C1211, C1220: 1u 50V; C_0603_1608Metric; MPN CL10A105KB8NNNC; LCSC C15849
C1206: 10u 25V; C_0805_2012Metric; MPN CL21A106KAYNNNE; LCSC C15850
C1208: 22u 25V; C_1206_3216Metric; MPN CL31A226KAHNNNE; LCSC C12891
C1216, C1217, C1218, C1219: 10n; C_0603_1608Metric; MPN 0603B103K500NT; LCSC C57112
D1201: SMF5.0A; D_SOD-123F; MPN SMF5.0A; LCSC C193402
D1202, D1203, D1204, D1205, D1207, D1208, D1209, D1210, D1211, D1212, D1213, D1214, D1215, D1216: PESD5V0S1BL; D_SOD-882; MPN PESD5V0S1BL,315; LCSC C84374
D1206: SMF6.0A; D_SOD-123F; MPN SMF6.0A; LCSC C123790
FB1201: BLM31KN601; L_1206_3216Metric; MPN BLM31KN601SN1L; LCSC C668306
FB1202: BLM18PG221; L_0603_1608Metric; MPN BLM18PG221SN1D; LCSC C80165
J1201: USB-C 16P TYPE-C-31-M-12; USB_C_Receptacle_HRO_TYPE-C-31-M-12; MPN TYPE-C-31-M-12; LCSC C165948
J1202: Qwiic JST SH 4P; JST_SH_SM04B-SRSS-TB_1x04-1MP_P1.00mm_Horizontal; MPN SM04B-SRSS-TB(LF)(SN); LCSC C160404
J1203, J1204: JST SH 3P; JST_SH_SM03B-SRSS-TB_1x03-1MP_P1.00mm_Horizontal; MPN 1.0-3PWT; LCSC C2763613
J1205: JST PH 4P; JST_PH_B4B-PH-K_1x04_P2.00mm_Vertical; MPN B4B-PH-K-S(LF)(SN); LCSC C131334
J1206: 2x6 header 2.54; PinHeader_2x06_P2.54mm_Vertical; MPN PZ254V-12-12P; LCSC C492423
J1207: 1x6 header 2.54; PinHeader_1x06_P2.54mm_Vertical; MPN PZ254V-11-06P; LCSC C492405
J1208: 1x8 socket 2.54; PinSocket_1x08_P2.54mm_Vertical; MPN 2.54-1*8P; LCSC C27438
JP1201, JP1204, JP1205, JP1224: bridged; SolderJumper-2_P1.3mm_Bridged_RoundedPad1.0x1.5mm
JP1202, JP1203, JP1206, JP1207, JP1208, JP1209, JP1210, JP1211, JP1212, JP1213, JP1214, JP1215, JP1216, JP1217, JP1218, JP1219, JP1220, JP1221, JP1222, JP1223, JP1225: open; SolderJumper-2_P1.3mm_Open_RoundedPad1.0x1.5mm
Q1201: AO3401A; SOT-23; MPN AO3401A; LCSC C15127
Q1202: 2N7002; SOT-23; MPN 2N7002; LCSC C8545
R1201: 0R; R_0603_1608Metric; MPN 0603WAF0000T5E; LCSC C21189
R1202: 1M; R_0603_1608Metric; MPN 0603WAF1004T5E; LCSC C22935; not fitted
R1203, R1204: 5.1k; R_0603_1608Metric; MPN 0603WAF5101T5E; LCSC C23186
R1205: 15k; R_0603_1608Metric; MPN 0603WAF1502T5E; LCSC C22809
R1206: 22k; R_0603_1608Metric; MPN 0603WAF2202T5E; LCSC C31850
R1207, R1208: 2.2k; R_0603_1608Metric; MPN 0603WAF2201T5E; LCSC C4190
R1209, R1210: 4.7k; R_0603_1608Metric; MPN 0603WAF4701T5E; LCSC C23162
R1211, R1214, R1221, R1231, R1233, R1235, R1237: 10k; R_0603_1608Metric; MPN 0603WAF1002T5E; LCSC C25804
R1212: 150k; R_0603_1608Metric; MPN 0603WAF1503T5E; LCSC C22807
R1213, R1219, R1250, R1252: 100k; R_0603_1608Metric; MPN 0603WAF1003T5E; LCSC C25803
R1215, R1216, R1238, R1239, R1240, R1241: 33R; R_0603_1608Metric; MPN 0603WAF330JT5E; LCSC C23140
R1217, R1218, R1225, R1251: 100R; R_0603_1608Metric; MPN 0603WAF1000T5E; LCSC C22775
R1220: 23.2k; R_0603_1608Metric; MPN 0603WAF2322T5E; LCSC C23346
R1222, R1223, R1224, R1242, R1243, R1244, R1245, R1246, R1247, R1248, R1249: 47R; R_0603_1608Metric; MPN 0603WAF470JT5E; LCSC C23182
R1226, R1227, R1228, R1229, R1230, R1232, R1234, R1236: 1k; R_0603_1608Metric; MPN 0603WAF1001T5E; LCSC C21190
TP1201: pad VUSB; TestPoint_Pad_D1.0mm
TP1202: pad SCLB; TestPoint_Pad_D1.0mm
TP1203: pad SDAB; TestPoint_Pad_D1.0mm
TP1204: pad QWIIC_3V3; TestPoint_Pad_D1.0mm
TP1205: TP +5V_LED; TestPoint_Keystone_5015_Micro_Mini; MPN 5015; LCSC C2906768
TP1206: pad LED_DATA 5V; TestPoint_Pad_D1.0mm
TP1207: pad LED_CLK 5V; TestPoint_Pad_D1.0mm
TP1208: pad DISP_VCC; TestPoint_Pad_D1.0mm
TP1209: pad DISP_BL_SW; TestPoint_Pad_D1.0mm
TP1210: pad LED_EN; TestPoint_Pad_D1.0mm
TP1211: pad LED_FAULT_N; TestPoint_Pad_D1.0mm
TP1212: pad QWIIC_PWR_EN; TestPoint_Pad_D1.0mm
TP1213: pad QWIIC_FAULT_N; TestPoint_Pad_D1.0mm
TP1214: pad VDRV_EN; TestPoint_Pad_D1.0mm
TP1215: pad VDRV_PG; TestPoint_Pad_D1.0mm
TP1216: pad PTP_PPS; TestPoint_Pad_D1.0mm
TP1217: pad RUN; TestPoint_Pad_D1.0mm
TP1218, TP1219: TP GND; TestPoint_Keystone_5015_Micro_Mini; MPN 5015; LCSC C2906768
U1201: USBLC6-2SC6; SOT-23-6; MPN USBLC6-2SC6; LCSC C7519
U1202: TCA9617B; VSSOP-8_3x3mm_P0.65mm; MPN TCA9617BDGKR; LCSC C527429
U1203: TPS2553; SOT-23-6; MPN TPS2553DBVR; LCSC C55266
U1204, U1208, U1209, U1210: SRV05-4; SOT-23-6; MPN SRV05-4.TCT; LCSC C13612
U1205: TPS2553; WSON-6-1EP_2x2mm_P0.65mm_EP1x1.6mm; MPN TPS2553DRVR; LCSC C138719
U1206, U1207: SN74LV1T125; SOT-23-5; MPN SN74LV1T125DBVR; LCSC C473338

Connections:
+5V_LED: C1208.1, C1209.1, C1210.1, FB1201.1, TP1205.1, U1205.1 (OUT), U1206.5 (VCC), U1207.5 (VCC)
/io/CC1: J1201.A5 (CC1), R1203.1
/io/CC2: J1201.B5 (CC2), R1204.1
/io/DISP_P1: J1208.1, JP1202.1 (A), JP1203.1 (A), JP1204.2 (B), R1242.1, U1209.1 (IO1)
/io/DISP_P2: J1208.2, JP1205.1 (A), JP1206.1 (A), JP1207.2 (B), R1243.1, U1209.3 (IO2)
/io/DISP_P3: J1208.3, JP1208.1 (A), JP1209.1 (A), JP1210.2 (B), R1244.1, U1209.4 (IO3)
/io/DISP_P4: J1208.4, JP1211.1 (A), JP1212.1 (A), JP1213.2 (B), R1245.1, U1209.6 (IO4)
/io/DISP_P5: J1208.5, JP1214.1 (A), JP1215.1 (A), JP1216.2 (B), R1246.1, U1210.1 (IO1)
/io/DISP_P6: J1208.6, JP1217.1 (A), JP1218.1 (A), JP1219.2 (B), R1247.1, U1210.3 (IO2)
/io/DISP_P7: J1208.7, JP1220.1 (A), JP1221.1 (A), JP1222.2 (B), R1248.1, U1210.4 (IO3)
/io/DISP_P8: J1208.8, JP1223.1 (A), JP1224.1 (A), JP1225.2 (B), R1249.1, U1210.6 (IO4)
/io/JT_TCK: J1207.3, R1241.1, U1208.6 (IO4)
/io/JT_TDI: J1207.5, R1239.1, U1208.3 (IO2)
/io/JT_TDO: J1207.4, R1240.1, U1208.4 (IO3)
/io/JT_TMS: J1207.6, R1238.1, U1208.1 (IO1)
/io/KNOB_REF: C1211.1, J1206.1 (KNOB_REF), R1225.1
/io/QWIIC_SCL: J1202.4, R1207.2, TP1202.1, U1202.7 (SCLB), U1204.4 (IO3)
/io/QWIIC_SDA: J1202.3, R1208.2, TP1203.1, U1202.6 (SDAB), U1204.6 (IO4)
/io/USB_SHIELD: C1201.1, J1201.S1 (SHIELD), R1201.1, R1202.1
DISP_AUX7: R1242.2; also elsewhere on the board
DISP_AUX8: R1243.2; also elsewhere on the board
DISP_BLK: R1249.2; also elsewhere on the board
DISP_BL_PWM: R1251.1; also elsewhere on the board
DISP_CS: R1248.2; also elsewhere on the board
DISP_DC: R1247.2; also elsewhere on the board
DISP_RES: R1246.2; also elsewhere on the board
DISP_SCL: R1244.2; also elsewhere on the board
DISP_SDA: R1245.2; also elsewhere on the board
ENC1_A: C1216.1, R1230.2, R1231.2; also elsewhere on the board
ENC1_B: C1217.1, R1232.2, R1233.2; also elsewhere on the board
ENC2_A: C1218.1, R1234.2, R1235.2; also elsewhere on the board
ENC2_B: C1219.1, R1236.2, R1237.2; also elsewhere on the board
FPGA_TCK: R1241.2; also elsewhere on the board
FPGA_TDI: R1239.2; also elsewhere on the board
FPGA_TDO: R1240.2; also elsewhere on the board
FPGA_TMS: R1238.2; also elsewhere on the board
I2C1_SCL: R1209.2, U1202.2 (SCLA); also elsewhere on the board
I2C1_SDA: R1210.2, U1202.3 (SDAA); also elsewhere on the board
KNOB1: C1212.1, R1226.2; also elsewhere on the board
KNOB2: C1213.1, R1227.2; also elsewhere on the board
KNOB3: C1214.1, R1228.2; also elsewhere on the board
KNOB4: C1215.1, R1229.2; also elsewhere on the board
LED_CLK: U1207.2; also elsewhere on the board
LED_DATA: U1206.2; also elsewhere on the board
LED_EN: R1219.1, TP1210.1, U1205.4 (EN); also elsewhere on the board
LED_FAULT_N: R1221.2, TP1211.1, U1205.3 (~FAULT); also elsewhere on the board
unnamed: D1202.2 (A2), J1203.3, R1215.1
unnamed: D1203.2 (A2), J1203.1, R1216.1
unnamed: D1204.2 (A2), J1204.3, R1217.1
unnamed: D1205.2 (A2), J1204.1, R1218.1
unnamed: D1206.1 (K), FB1201.2, J1205.1 (+5V)
unnamed: D1207.2 (A2), J1205.3 (D), R1222.2, TP1206.1
unnamed: D1208.2 (A2), J1205.4 (C), R1223.2, TP1207.1
unnamed: D1209.2 (A2), J1206.3 (KNOB1), R1226.1
unnamed: D1210.2 (A2), J1206.4 (KNOB2), R1227.1
unnamed: D1211.2 (A2), J1206.5 (KNOB3), R1228.1
unnamed: D1212.2 (A2), J1206.6 (KNOB4), R1229.1
unnamed: D1213.2 (A2), J1206.7 (ENC1_A), R1230.1
unnamed: D1214.2 (A2), J1206.8 (ENC1_B), R1232.1
unnamed: D1215.2 (A2), J1206.9 (ENC2_A), R1234.1
unnamed: D1216.2 (A2), J1206.10 (ENC2_B), R1236.1
unnamed: J1201.A6 (D+), J1201.B6 (D+), U1201.3 (I/O2)
unnamed: J1201.A7 (D-), J1201.B7 (D-), U1201.1 (I/O1)
unnamed: J1206.11 (+3V3), R1224.2
unnamed: Q1201.1 (G), Q1202.3 (D), R1250.2
unnamed: Q1202.1 (G), R1251.2, R1252.1
unnamed: R1222.1, U1206.4
unnamed: R1223.1, U1207.4
unnamed: R1212.1, U1203.5 (ILIM)
unnamed: R1220.1, U1205.2 (ILIM)
PTP_PPS: TP1216.1; also elsewhere on the board
QWIIC_3V3: C1206.1, J1202.2, JP1201.1 (A), R1213.1, TP1204.1, U1203.6 (OUT), U1204.5 (VP)
QWIIC_FAULT_N: R1214.2, TP1213.1, U1203.4 (~FAULT); also elsewhere on the board
QWIIC_PWR_EN: R1211.1, TP1212.1, U1202.5 (EN), U1203.3 (EN); also elsewhere on the board
RUN: TP1217.1; also elsewhere on the board
SWCLK: R1216.2; also elsewhere on the board
SWDIO: R1215.2; also elsewhere on the board
UART0_RX: R1218.2; also elsewhere on the board
UART0_TX: R1217.2; also elsewhere on the board
USB_DM: U1201.6 (I/O1); also elsewhere on the board
USB_DP: U1201.4 (I/O2); also elsewhere on the board
VDRV_EN: TP1214.1; also elsewhere on the board
VDRV_PG: TP1215.1; also elsewhere on the board
VUSB_DET: C1202.1, R1205.2, R1206.1; also elsewhere on the board

Notes on the sheet:
USB-C USB 2.0 FS to the RP2350, sink only (G-usb-c.md)
Shell: 0R to GND fitted. Isolated option: remove the 0R, fit 1M || 4n7 2 kV (G-usb-c.md)
27R series at the RP2350 (block E)
QWIIC TCA9617B repeater + TPS2553 switch, 155-207 mA (G-qwiic.md)
1 GND 2 +3V3 3 SDA 4 SCL (Qwiic)
A-side 4.7k: drop if block E fits I2C1 pull-ups
No series R on SDA/SCL: a far-end low plus I*R must stay below VILB 0.4 V
DEBUG PROBE JST SH 3-pin, Sequoia's convention (G-debug-jtag.md)
SWD: 1 SWCLK 2 GND 3 SWDIO
UART: 1 RX 2 GND 3 TX
ADDRESSABLE LED OUTPUT TPS2553 1.03-1.20 A, SN74LV1T125 (G-led-out.md)
RILIM 23.2k: 1.03-1.20 A; firmware caps it by PoE class
KNOB / ENCODER HEADER 2x6 0.1 in, optional (G-knob.md)
KNOB_REF: RP2350 ADC_AVDD (block E) through 100R, so knob readings are ratiometric. Pots 10-50k.
FPGA JTAG 1x6 0.1 in, optional (G-debug-jtag.md)
1 +3V3 2 GND 3 TCK 4 TDO 5 TDI 6 TMS 4.7k pulls are on block E's sheet (TN-02038)
DISPLAY HEADER 8-pin 0.1 in socket, every position remappable (G-display.md)
default
GND
VCC
SCL
SDA
RES
BLK
Each position: a jumper to DISP_VCC, DISP_BL_SW (switched backlight) or GND, else 47R to its FPGA pin. Defaults for GND, VCC, SCL, SDA, RES, DC, CS, BLK: JP to GND on 1, VCC on 2, BLK on 8 bridged. An FPGA line whose position is jumpered must be constrained Hi-Z (block E).
DISP_VCC AND BACKLIGHT SWITCH (G-display.md)
PWM <= 2 kHz with the 100k gate pull-up (10k for faster PWM). Q off at power-up.
TEST POINTS (R-80, G-testpoints.md) rail pads sit at their rails

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
Board: 2 copper layers, 1261 parts (0 on the bottom side), 684 nets, no tracks yet.
