sequoia-hope/studio-amp/(commit log)

2026-11-07 Boardroom board repo; phase 0 design intent signed off
    Converted the proj-registered folder into a Boardroom board repo (template,
    vendored pcb-design skill, pcbview and ultraroute pinned as in boardroom
    66be834). Added the system specification and design/intent.md for the
    satellite board, variant A: PoE PD chip, isolated active-clamp forward,
    48 V amp rail, GW1NR-9, LMG1210 + Innoscience GaN. Gate 0 reviewed
    independently and signed off.
    [nets.csv]
2026-11-07 Phase 1: block audits A-G, reconciled architecture and budget, user decisions (ECP5, IGC033, 6 layers, Würth transformer)
    [lattice-ECP5U-25-pinout.csv, sources-A.csv, sources-B.csv, sources-CG.csv, sources-D.csv, sources-E.csv, sources-F.csv, sources.csv]
2026-11-08 Phase 1: review fixes across blocks A-G; frequency plan (amp 576 kHz, converter 737.28 kHz crystal); IGB070; intent updated
    [sources-A.csv, sources-B.csv, sources-D.csv, sources-F.csv]
2026-11-08 Gate 1 passed: phase 1 part audits after four independent review passes
    [sources-B.csv, sources.csv]
2026-11-08 Phase 2 start: KiCad project skeleton, hierarchical generator helper, per-block libraries, schematic conventions
    [amp_sense.kicad_sch, amp_tweeter.kicad_sch, amp_woofer.kicad_sch, audio_in.kicad_sch, audio_out.kicad_sch, ethernet.kicad_sch, fpga.kicad_sch, io.kicad_sch]
2026-11-08 Phase 2: all 13 schematic sheets drawn by block generators; ERC 0, style check pass
    [amp_sense.kicad_sch, amp_tweeter.kicad_sch, amp_woofer.kicad_sch, audio_in.kicad_sch, audio_out.kicad_sch, bom-sch.csv, ethernet.kicad_sch, fpga.kicad_sch]
2026-11-08 Gate 2 passed: satellite schematic (13 sheets, 1261 symbols), reviewed and cross-checked
    [amp_sense.kicad_sch, amp_tweeter.kicad_sch, amp_woofer.kicad_sch, audio_in.kicad_sch, audio_out.kicad_sch, bom-sch.csv, ethernet.kicad_sch, fpga.kicad_sch]
2026-11-08 Restore Decouples on C321/C338 (drawn within 40 mm instead); re-record gate 2
    [bom-sch.csv, rails.kicad_sch, satellite.kicad_pcb, satellite.kicad_sch]
